BlueJayRacing/bjr_kicad/README.md

# bjr_kicad
jhu blue jay racing daq kicad pcb files

Note: 20xt is mainly for legacy
