BlueJayRacing/bjr_kicad/21xt/02-mainbox/bjr_kicad_aaren_copy/21xt/03-wireless_strain_gauge/wsg1.0/NewBOM.xlsx

Id | Designator | Footprint | Quantity | Designation | JLCPCB Part #
2 | R3,R7,R5,R4,R6 | R_0603_1608Metri | 5 | 47 | C23182
3 | C1 | C_0603_1608Metric | 1 | 47uF | C178330
4 | C2 | C_0603_1608Metric | 1 | 22uF | C59461
5 | C11,C7,C3,C13,C9 | C_0603_1608Metric | 5 | 0.1uF | C14663
6 | LinReg1,LinReg2,LinReg3 | SOT91P240X110-3N | 3 | AP2120N-5.0TRG1 | C460341
7 | U1 | SOP65P640X120-16N | 1 | ADS1120 | C84284
8 | C5,C6 | C_0603_1608Metric | 2 | 5uF | C1691
9 | 806k | R_0805_2012Metric | 1 | 806k | C407436
10 | DAC1 | AD5626 | 1 | AD5626BRMZ | C125832
11 | 80.6k | R_0603_1608Metric | 1 | 80.6k | C23249
12 | D8 | D_0603_1608Metric | 1 | Schottky | C153761
1 | C12,C10,C14,C8,C4 | C_0603_1608Metric | 5 | 100uF | C19702
7 | BConv1 | TPSM83100SIUR | 1 | TPSM83100SIUR | C20346010
