BlueJayRacing/bjr_kicad/21xt/06-magnetometer/Magnetometer3D/BSS138.step

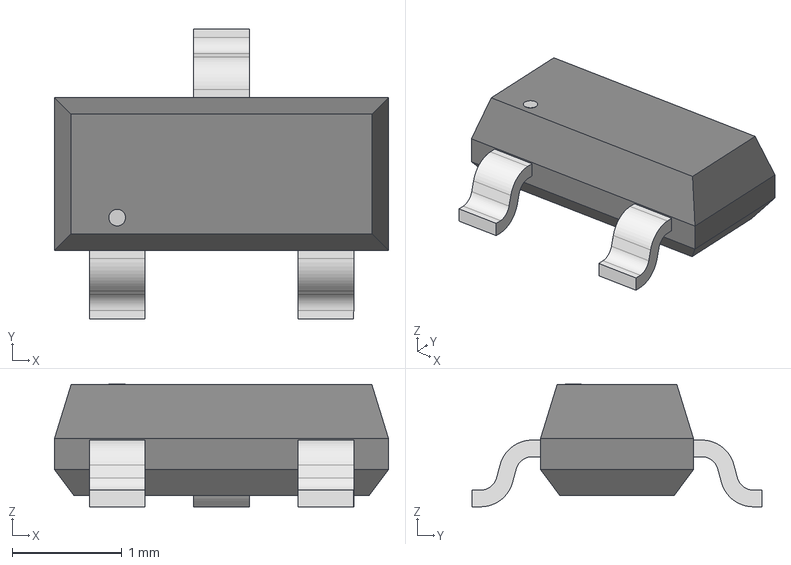
[picture p1: CAD file, 2025-03-05]
21xt/06-magnetometer/Magnetometer3D/BSS138.step
3.05 x 2.64 x 1.12 mm
