BlueJayRacing/bjr_kicad/21xt/00-3dmodels/INA180A1IDBVR.stp

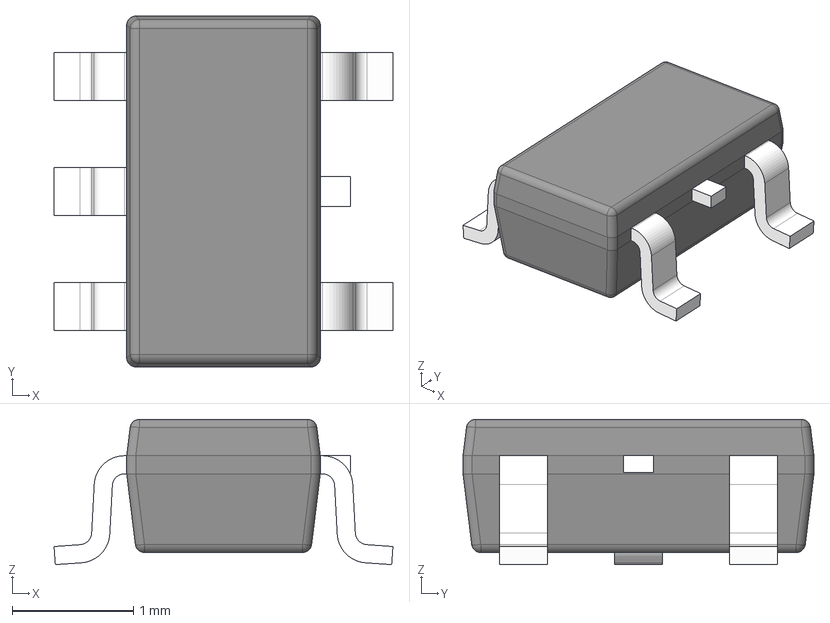
[picture p2: CAD file, 2025-03-05]
21xt/00-3dmodels/INA180A1IDBVR.stp
2.80 x 2.90 x 1.20 mm
BODY-SOT
LEAD-SOT x 5
LEAD-DUMMY
