BlueJayRacing/bjr_kicad/21xt/06-magnetometer/Magnetometer3D/LIS3MDLTR.stp

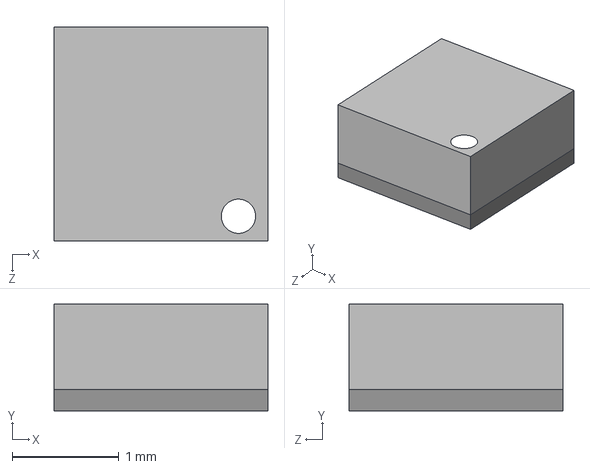
[picture p3: CAD file, 2025-03-05]
21xt/06-magnetometer/Magnetometer3D/LIS3MDLTR.stp
2.00 x 1.00 x 2.00 mm
