BlueJayRacing/bjr_kicad/21xt/00-3dmodels/LTC2959IDDB#TRMPBF.stp

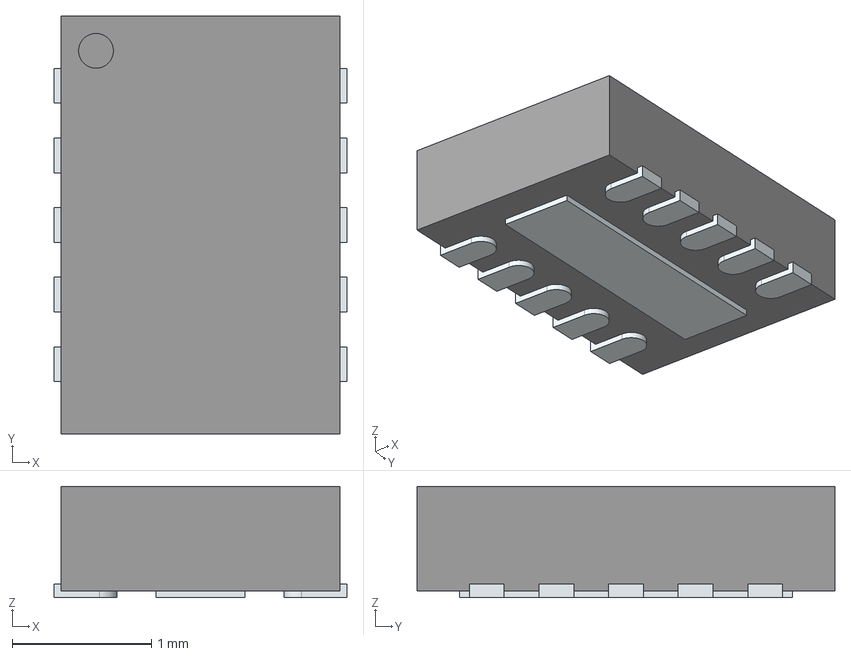
[picture p4: CAD file, 2025-03-05]
21xt/00-3dmodels/LTC2959IDDB#TRMPBF.stp
2.10 x 3.00 x 0.8 mm
ThermalPin
PinsArrayLR
