BlueJayRacing/bjr_kicad/21xt/06-magnetometer/Magnetometer3D/1KSMBSeries_LTF.step

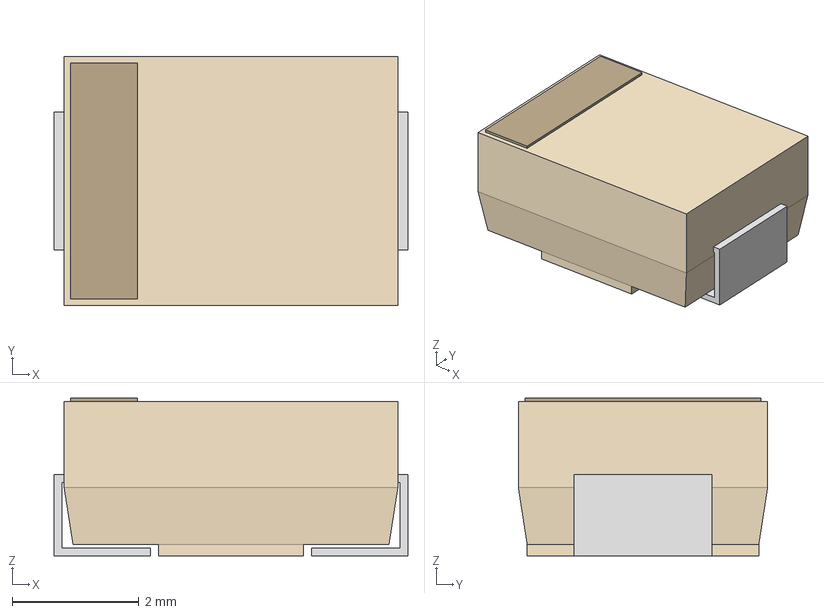
[picture p5: CAD file, 2025-03-05]
21xt/06-magnetometer/Magnetometer3D/1KSMBSeries_LTF.step
5.59 x 3.94 x 2.49 mm
