BlueJayRacing/bjr_kicad/21xt/00-3dmodels/SMBJ33CA.stp

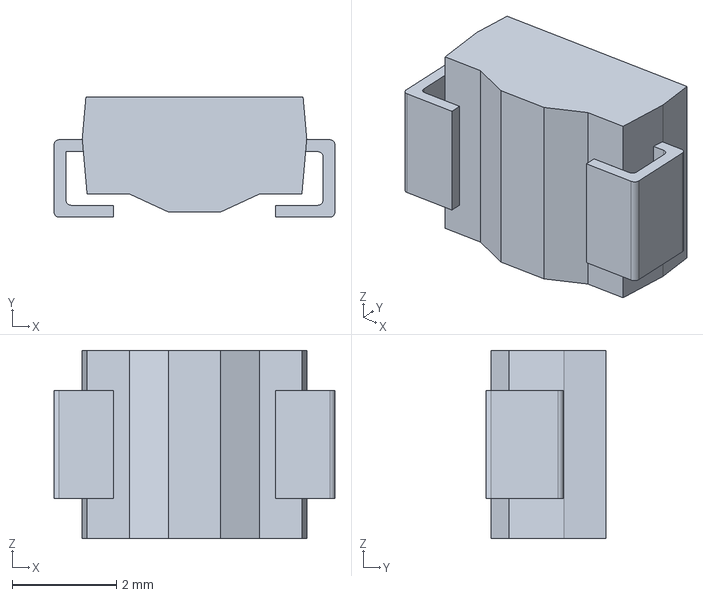
[picture p6: CAD file, 2025-03-05]
21xt/00-3dmodels/SMBJ33CA.stp
5.40 x 2.31 x 3.62 mm
