BlueJayRacing/bjr_kicad/21xt/06-magnetometer/Magnetometer3D/LM3940IMPX-3.3_NOPB.step

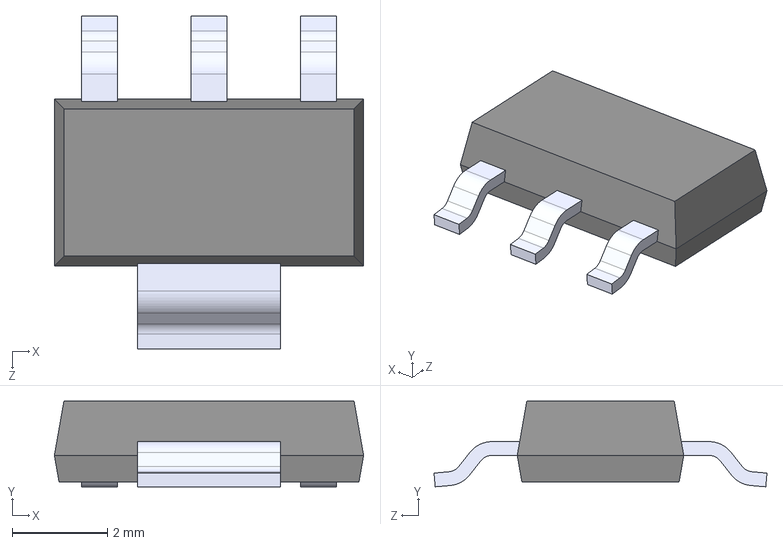
[picture p7: CAD file, 2025-03-05]
21xt/06-magnetometer/Magnetometer3D/LM3940IMPX-3.3_NOPB.step
6.50 x 1.80 x 7.00 mm
