BlueJayRacing/bjr_kicad/21xt/00-3dmodels/NRVB10100MFST1G.stp

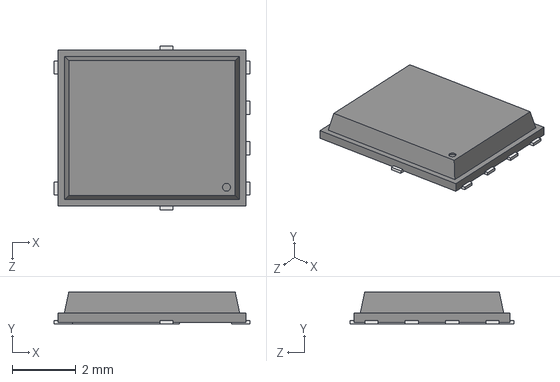
[picture p8: CAD file, 2025-03-05]
21xt/00-3dmodels/NRVB10100MFST1G.stp
6.15 x 1 x 5.15 mm
