BlueJayRacing/bjr_kicad/21xt/00-3dmodels/NVMFWS2D1N08XT1G.stp

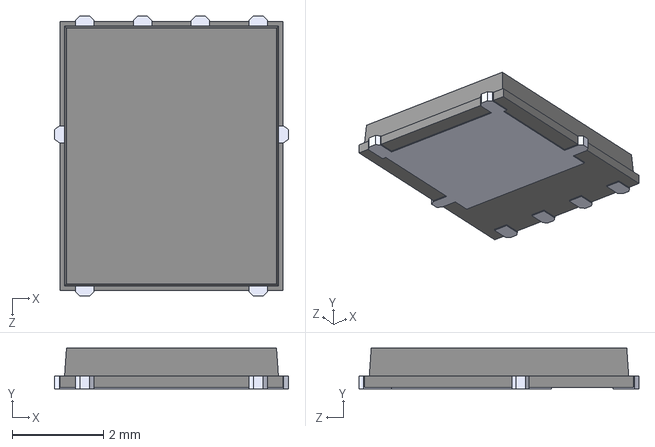
[picture p9: CAD file, 2025-03-05]
21xt/00-3dmodels/NVMFWS2D1N08XT1G.stp
5.15 x 0.9 x 6.15 mm
