BlueJayRacing/bjr_kicad/21xt/00-3dmodels/2103M-003-CKN10790CT-ND_Push_Button.STEP

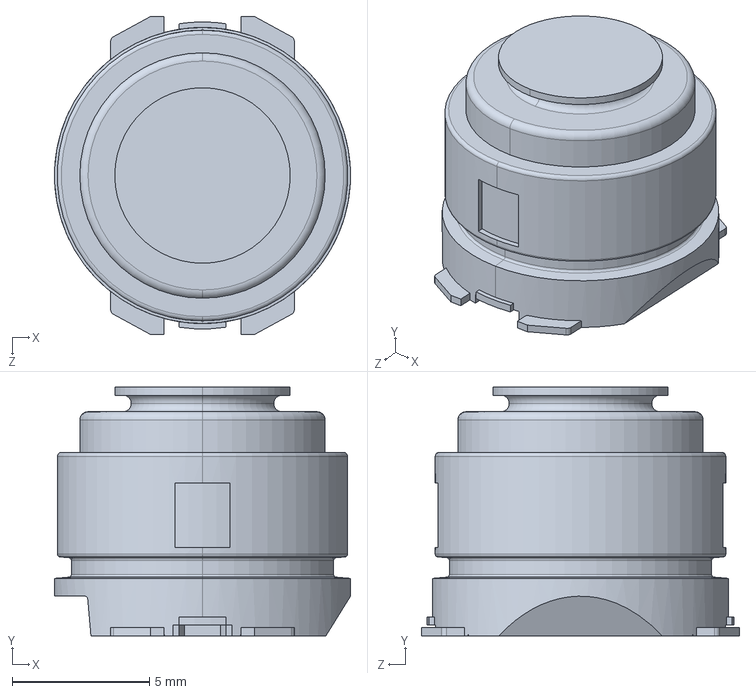
[picture p10: CAD file, 2025-03-05]
21xt/00-3dmodels/2103M-003-CKN10790CT-ND_Push_Button.STEP
10.8 x 9.08 x 11.6 mm
