BlueJayRacing/bjr_kicad/21xt/00-3dmodels/m8 pp bulkhead 09_4912_081_04.stp

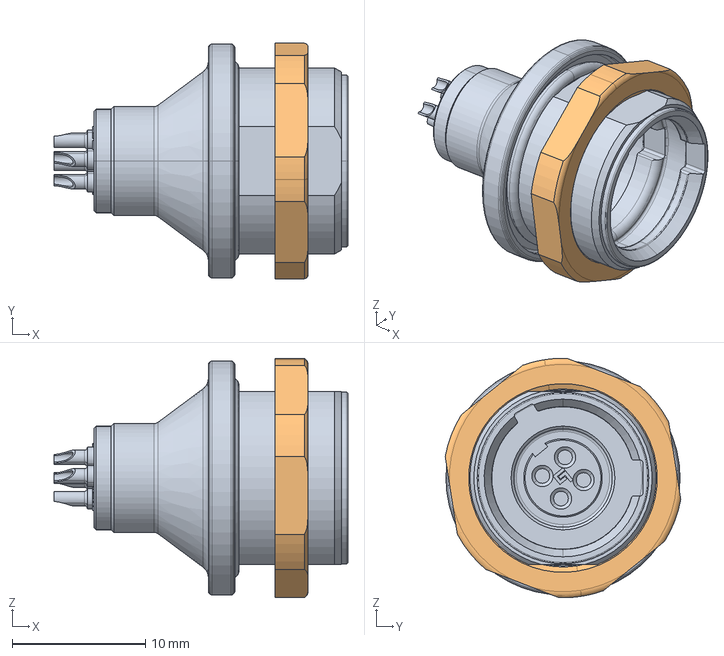
[picture p11: CAD file, 2025-03-05]
21xt/00-3dmodels/m8 pp bulkhead 09_4912_081_04.stp
22.1 x 17.7 x 18.0 mm
