BlueJayRacing/bjr_kicad/21xt/00-3dmodels/m8 pp wire 99-4909-00-04-001_01.stp

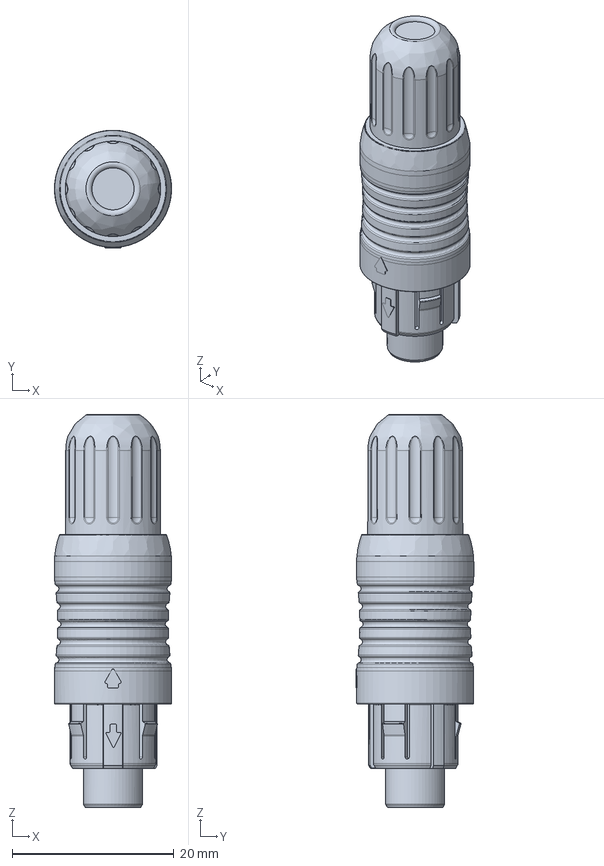
[picture p12: CAD file, 2025-03-05]
21xt/00-3dmodels/m8 pp wire 99-4909-00-04-001_01.stp
14.5 x 14.5 x 48.6 mm
