BlueJayRacing/bjr_kicad/21xt/00-3dmodels/led_strip.STEP

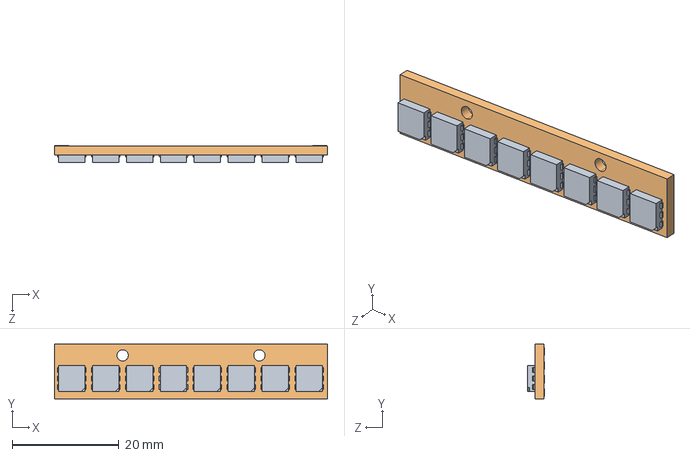
[picture p13: CAD file, 2025-03-05]
21xt/00-3dmodels/led_strip.STEP
51.1 x 10.2 x 3.27 mm
