BlueJayRacing/bjr_kicad/21xt/00-3dmodels/AD5689RBCPZ-RL7.stp

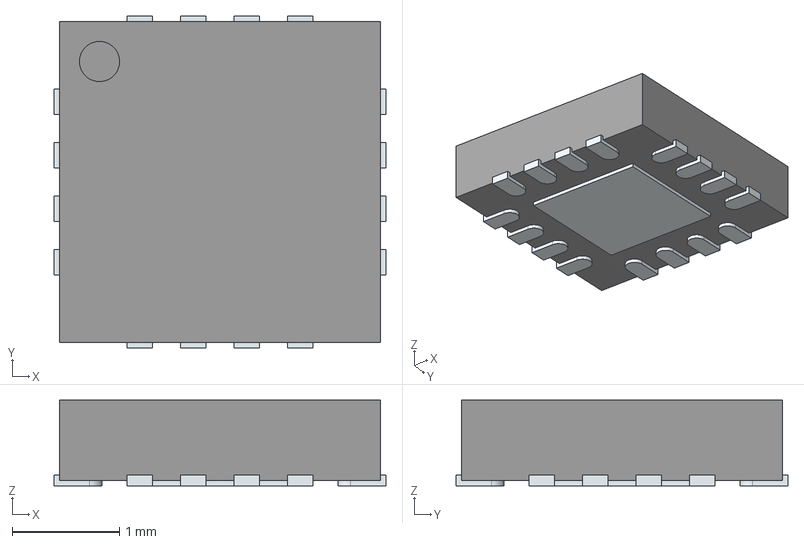
[picture p14: CAD file, 2025-03-05]
21xt/00-3dmodels/AD5689RBCPZ-RL7.stp
3.10 x 3.10 x 0.8 mm
ThermalPin
PinsArrayLR
PinsArrayTB
