BlueJayRacing/bjr_kicad/21xt/00-3dmodels/AP2120N-5.0TRG1.stp

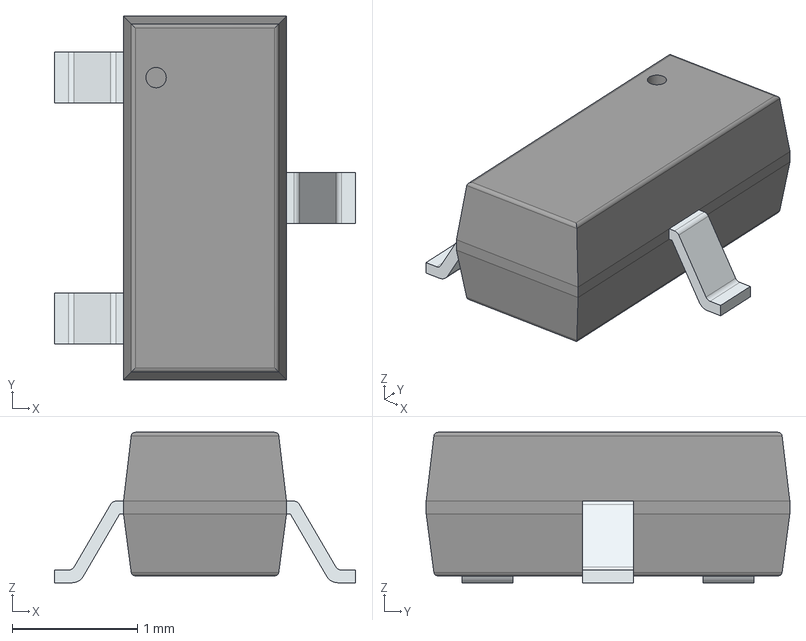
[picture p15: CAD file, 2025-01-16]
21xt/00-3dmodels/AP2120N-5.0TRG1.stp
2.40 x 2.90 x 1.20 mm
PinsArrayL
FilletPinR
