BlueJayRacing/bjr_kicad/21xt/00-3dmodels/AD8237ARMZ.stp

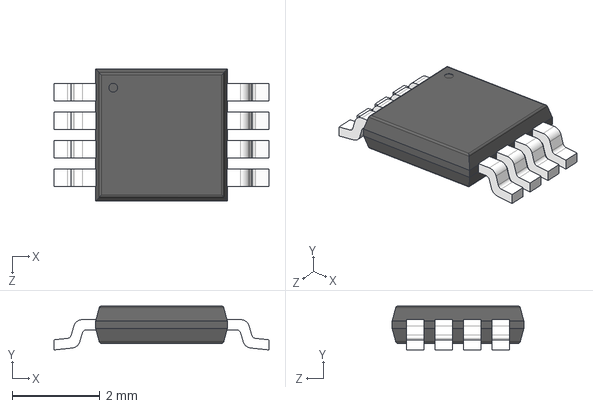
[picture p16: CAD file, 2025-01-16]
21xt/00-3dmodels/AD8237ARMZ.stp
4.90 x 1.00 x 3.00 mm
