BlueJayRacing/bjr_kicad/21xt/00-3dmodels/0906-0-15-20-76-14-11-0.step

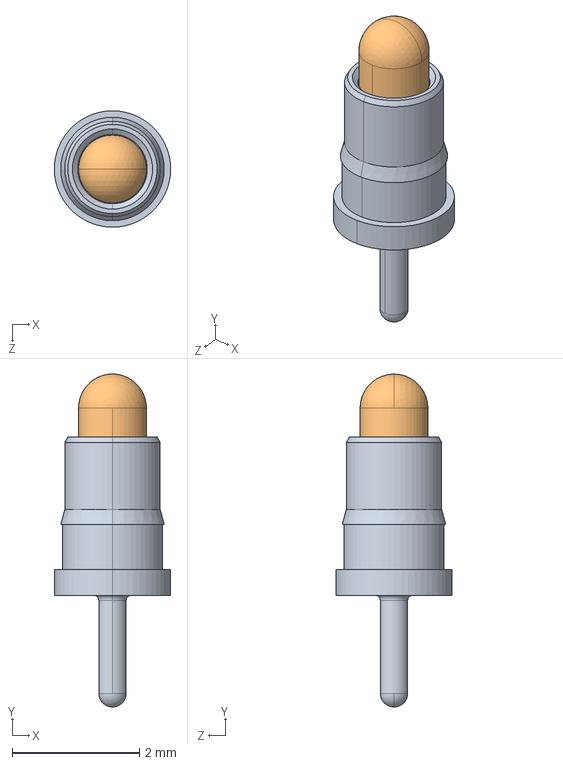
[picture p17: CAD file, 2025-01-16]
21xt/00-3dmodels/0906-0-15-20-76-14-11-0.step
1.83 x 5.23 x 1.83 mm
