BlueJayRacing/bjr_kicad/21xt/00-3dmodels/SOT23-3.stp

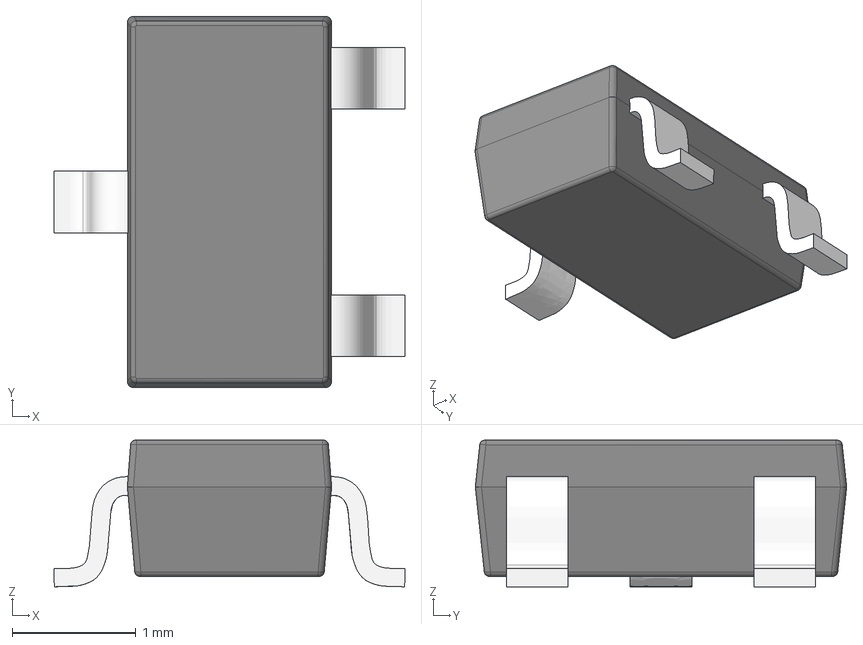
[picture p18: CAD file, 2025-01-15]
21xt/00-3dmodels/SOT23-3.stp
2.84 x 3.00 x 1.18 mm
