BlueJayRacing/bjr_kicad/21xt/00-3dmodels/MDT275M02001.stp

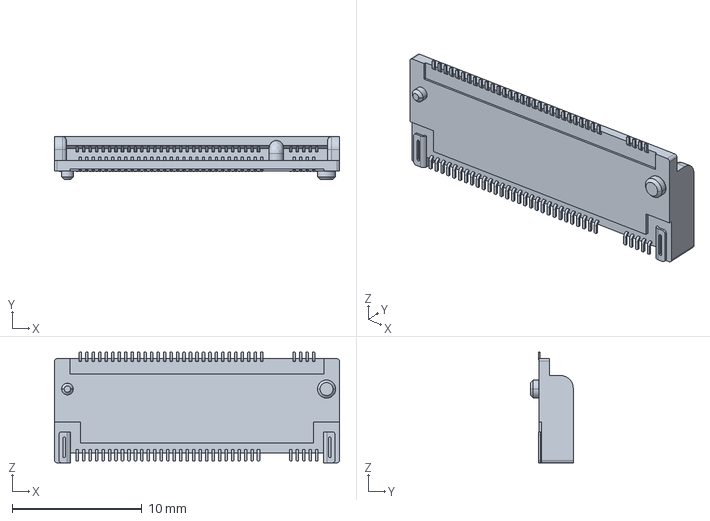
[picture p19: CAD file, 2025-01-15]
21xt/00-3dmodels/MDT275M02001.stp
22.0 x 3.30 x 8.55 mm
