BlueJayRacing/bjr_kicad/21xt/00-3dmodels/AD7175-2BRUZ.stp

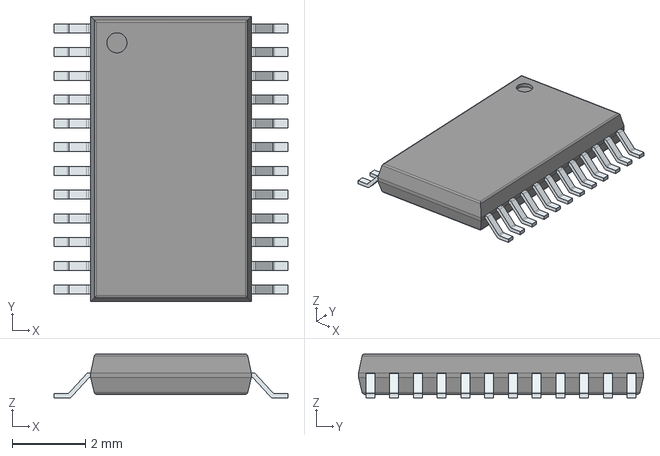
[picture p20: CAD file, 2025-01-15]
21xt/00-3dmodels/AD7175-2BRUZ.stp
6.40 x 7.80 x 1.20 mm
PinsArrayLR
