BlueJayRacing/bjr_kicad/21xt/00-3dmodels/XB9X-DMUS-011.stp

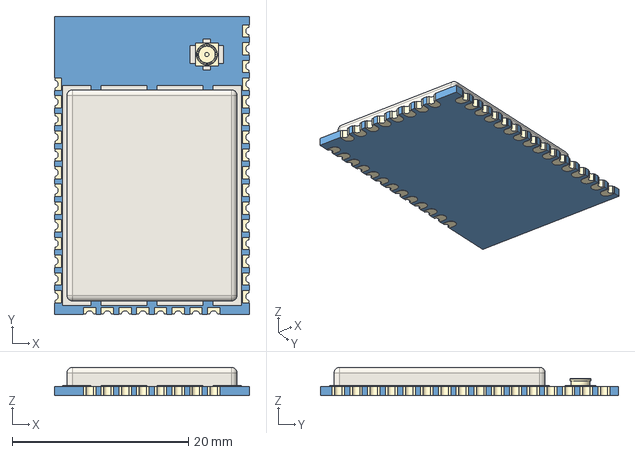
[picture p21: CAD file, 2025-01-15]
21xt/00-3dmodels/XB9X-DMUS-011.stp
22.1 x 33.8 x 3.21 mm
