BlueJayRacing/bjr_kicad/21xt/00-3dmodels/ZF5S-16-01-T-WT.step

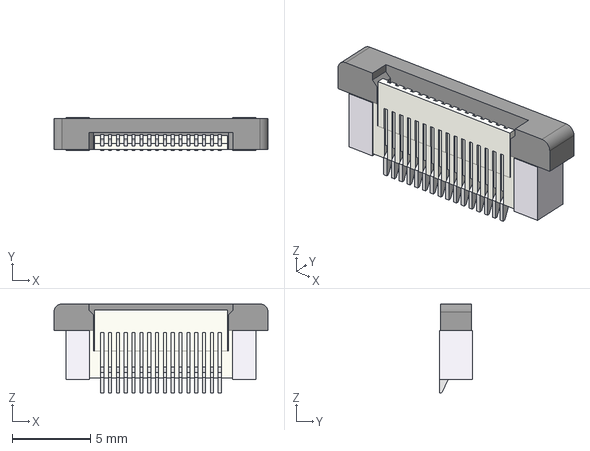
[picture p22: CAD file, 2025-01-15]
21xt/00-3dmodels/ZF5S-16-01-T-WT.step
13.7 x 2.10 x 5.67 mm
ZF5S-16-01-WT_socket
C-297-16-01_pins
