BlueJayRacing/bjr_kicad/21xt/00-3dmodels/B2PS-VH.stp

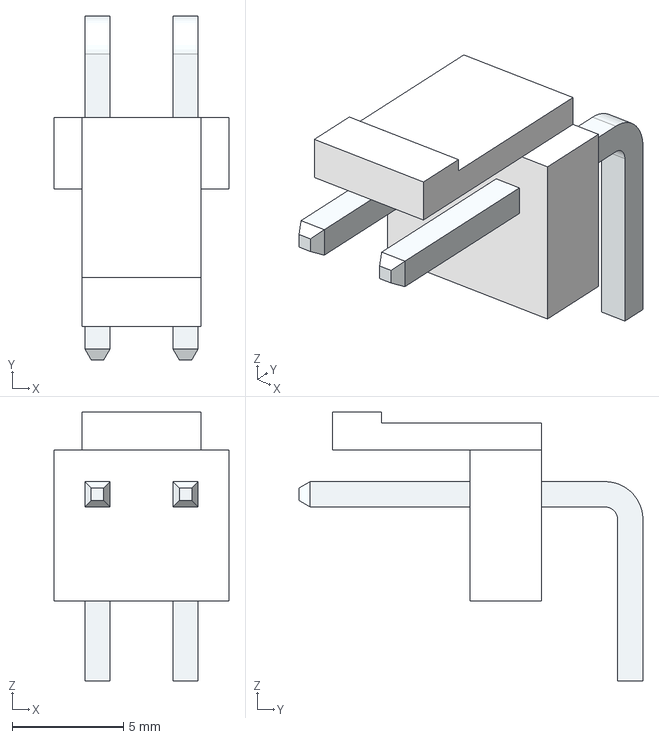
[picture p23: CAD file, 2025-01-15]
21xt/00-3dmodels/B2PS-VH.stp
7.86 x 15.5 x 12.1 mm
