BlueJayRacing/bjr_kicad/21xt/00-3dmodels/R2D-0509.stp

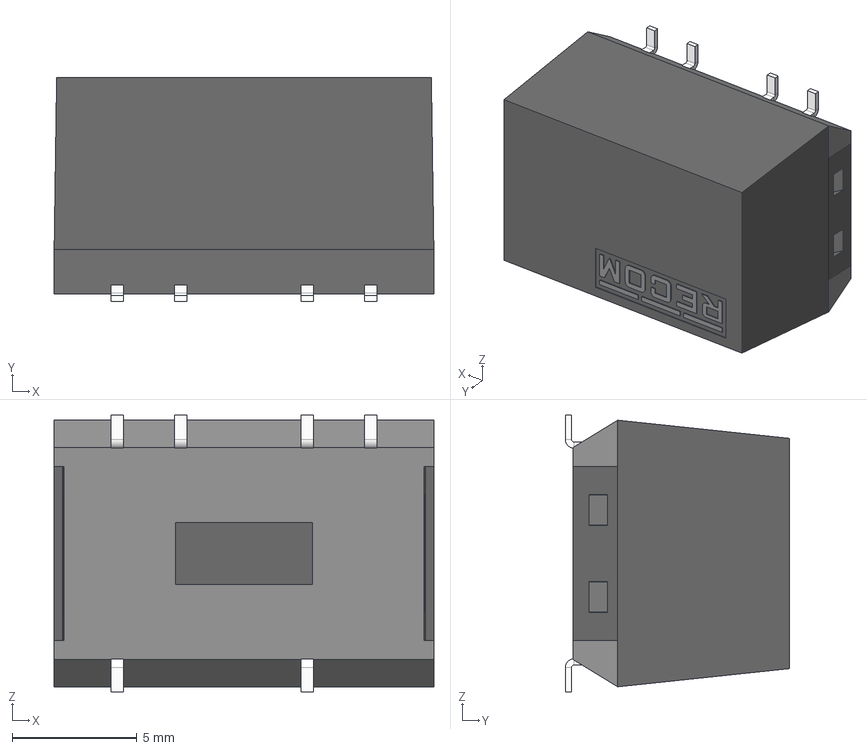
[picture p24: CAD file, 2025-01-15]
21xt/00-3dmodels/R2D-0509.stp
15.2 x 9.00 x 11.1 mm
