BlueJayRacing/bjr_kicad/21xt/00-3dmodels/W25N04KVZEIR.stp

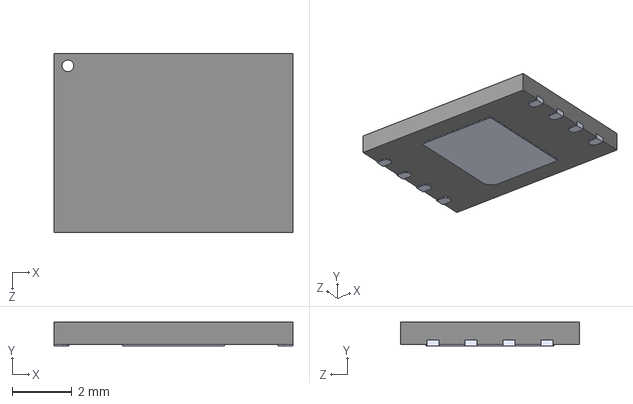
[picture p25: CAD file, 2025-01-07]
21xt/00-3dmodels/W25N04KVZEIR.stp
8.00 x 0.8 x 6.00 mm
