BlueJayRacing/bjr_kicad/21xt/00-3dmodels/TAJD106M035RNJ.stp

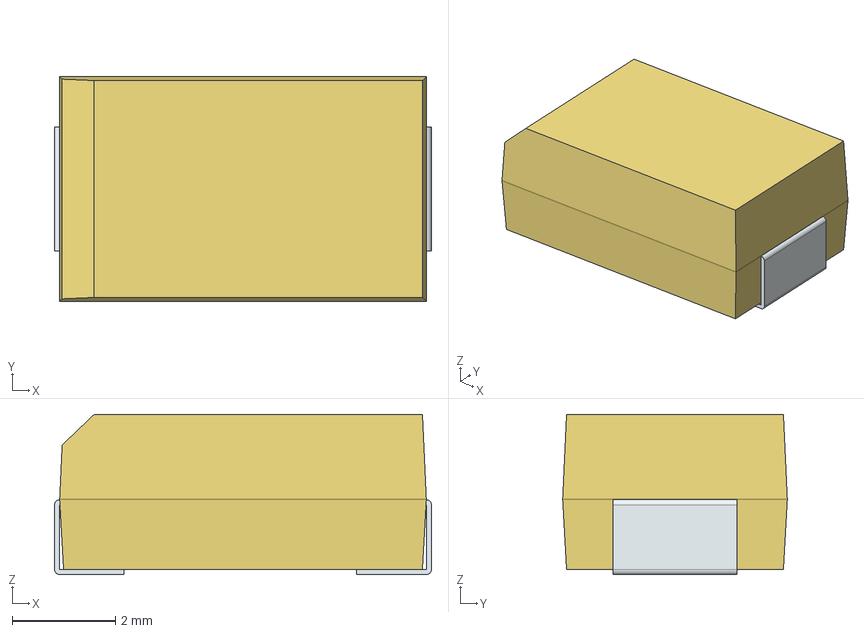
[picture p26: CAD file, 2025-01-07]
21xt/00-3dmodels/TAJD106M035RNJ.stp
7.30 x 4.35 x 3.10 mm
FilletPin1
FilletPin2
