BlueJayRacing/bjr_kicad/21xt/00-3dmodels/INA821IDRGR.stp

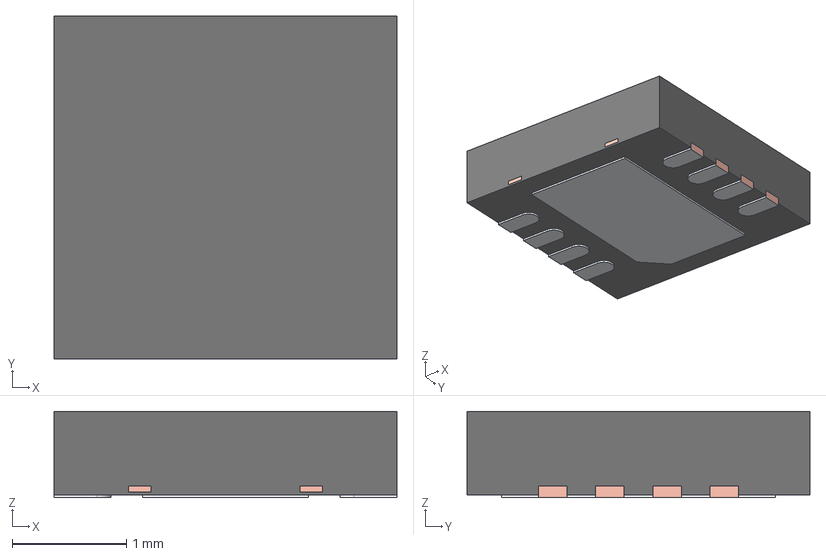
[picture p27: CAD file, 2025-01-07]
21xt/00-3dmodels/INA821IDRGR.stp
3.00 x 3.00 x 0.755 mm
BODY-SON
FRAME-DRG0008B
