BlueJayRacing/bjr_kicad/21xt/00-3dmodels/SJ-3541AS-SMT-TR-67.stp

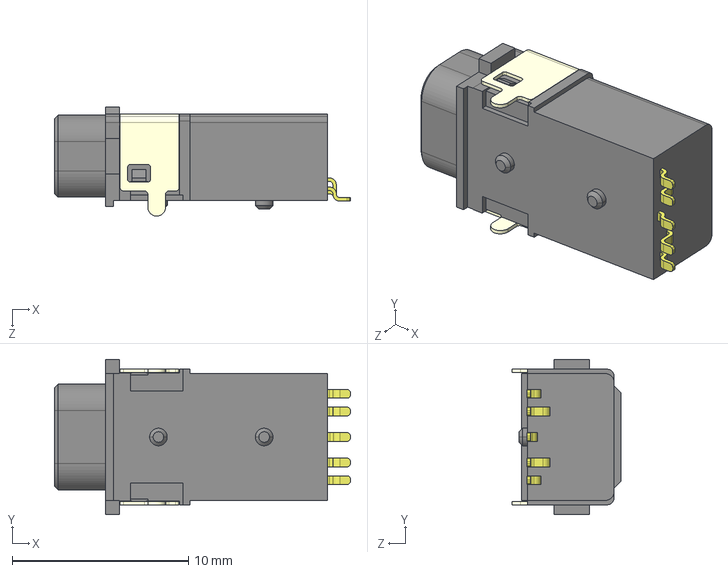
[picture p28: CAD file, 2025-01-07]
21xt/00-3dmodels/SJ-3541AS-SMT-TR-67.stp
16.8 x 8.80 x 6.20 mm
