BlueJayRacing/bjr_kicad/21xt/00-3dmodels/ADS1120IRVAR.stp

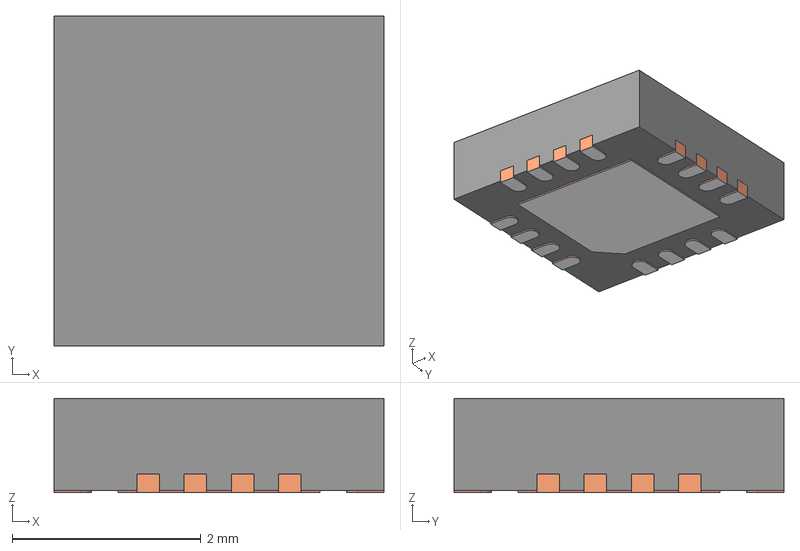
[picture p29: CAD file, 2025-01-07]
21xt/00-3dmodels/ADS1120IRVAR.stp
3.50 x 3.50 x 1.00 mm
BODY-QFN
FRAME-RVA0016A
PIN1-ID
