BlueJayRacing/bjr_kicad/21xt/00-3dmodels/DTF13-4P-G003.stp

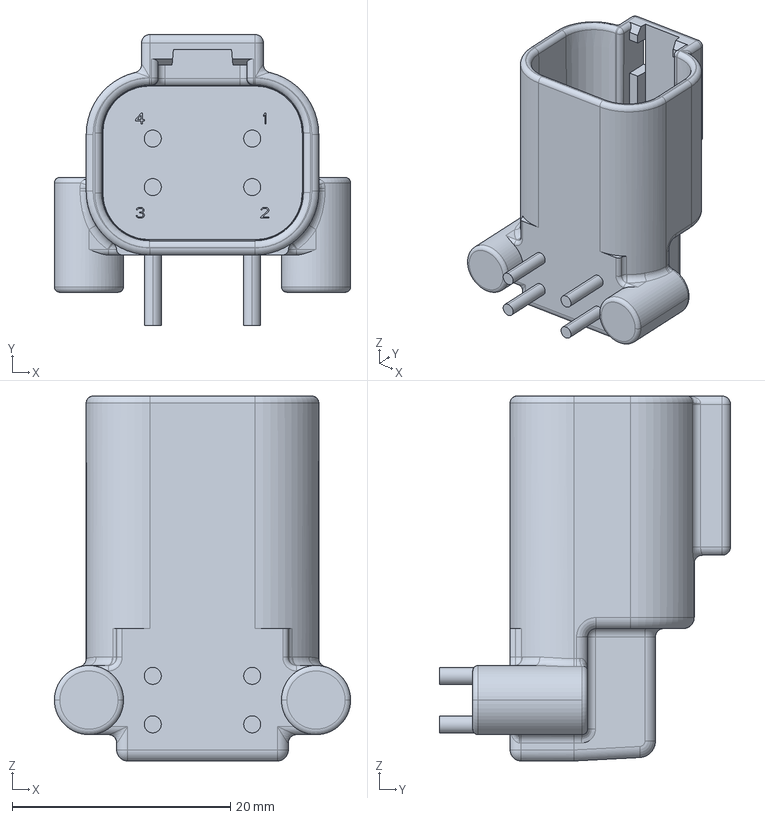
[picture p30: CAD file, 2025-01-07]
21xt/00-3dmodels/DTF13-4P-G003.stp
27.2 x 26.7 x 33.5 mm
