BlueJayRacing/bjr_kicad/21xt/00-3dmodels/MSOP8.STEP

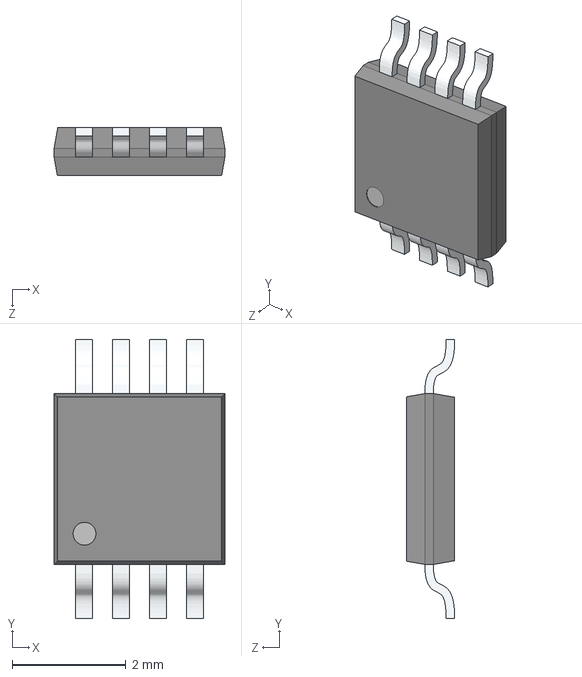
[picture p31: CAD file, 2025-01-07]
21xt/00-3dmodels/MSOP8.STEP
3.00 x 4.90 x 0.85 mm
