BlueJayRacing/bjr_kicad/21xt/00-3dmodels/MCP1502T-50E_CHY.stp

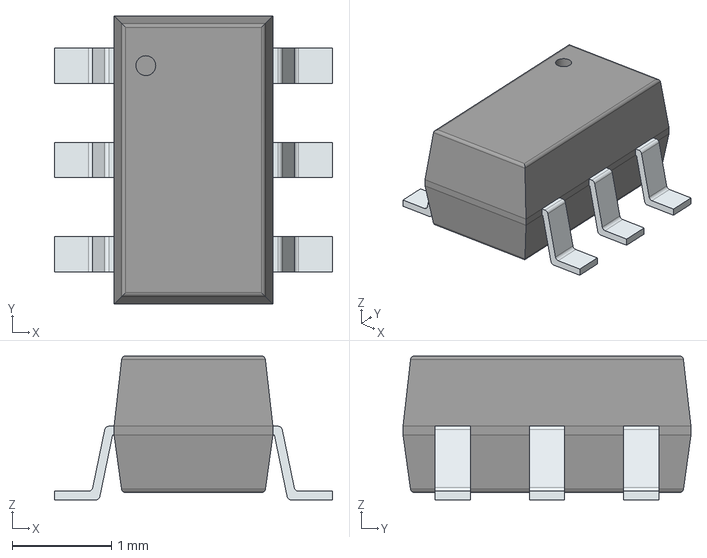
[picture p32: CAD file, 2025-01-07]
21xt/00-3dmodels/MCP1502T-50E_CHY.stp
2.80 x 2.90 x 1.45 mm
PinsArrayLR
