BlueJayRacing/bjr_kicad/21xt/00-3dmodels/R-78B3.3-1.5.stp

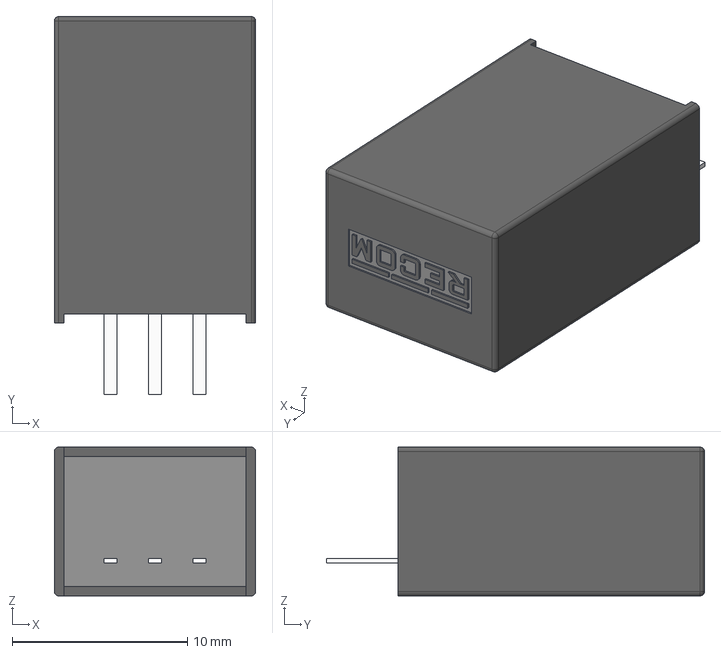
[picture p33: CAD file, 2025-01-07]
21xt/00-3dmodels/R-78B3.3-1.5.stp
11.5 x 21.6 x 8.50 mm
