BlueJayRacing/bjr_kicad/21xt/00-3dmodels/TPSM83100SIUR.stp

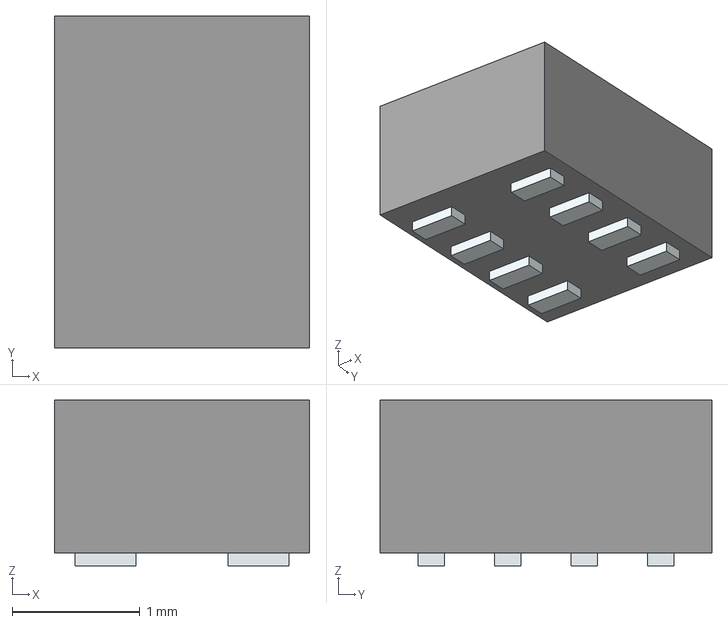
[picture p34: CAD file, 2025-01-07]
21xt/00-3dmodels/TPSM83100SIUR.stp
2.00 x 2.60 x 1.30 mm
Pins
