BlueJayRacing/bjr_kicad/21xt/00-3dmodels/mezzanine.stp

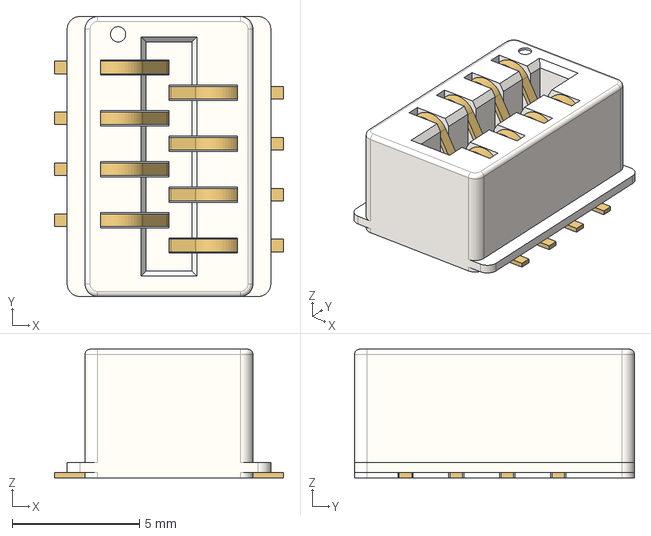
[picture p35: CAD file, 2025-01-04]
21xt/00-3dmodels/mezzanine.stp
9.00 x 11.0 x 5.05 mm
housing
pins
