BlueJayRacing/bjr_kicad/21xt/00-3dmodels/INA827AIDGK.stp

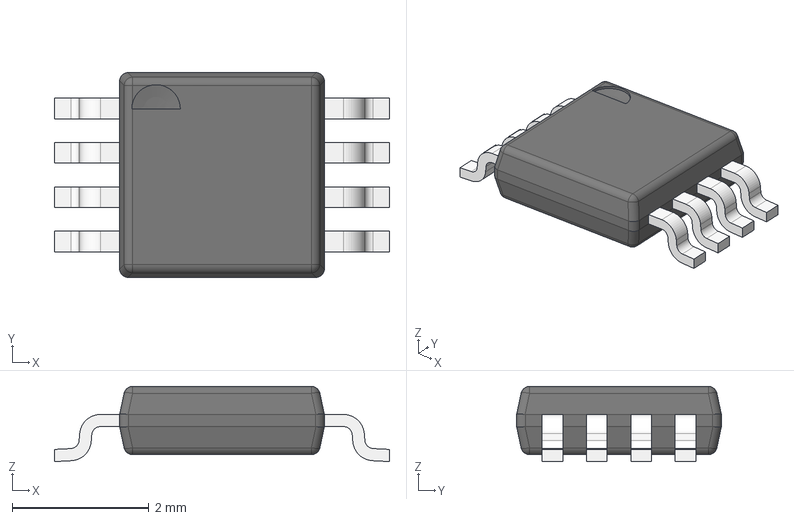
[picture p36: CAD file, 2025-01-04]
21xt/00-3dmodels/INA827AIDGK.stp
4.90 x 3.00 x 1.10 mm
BODY_MUA08A
LEAD_MUA08A x 8
