BlueJayRacing/bjr_kicad/21xt/00-3dmodels/TXB0108PWR.stp

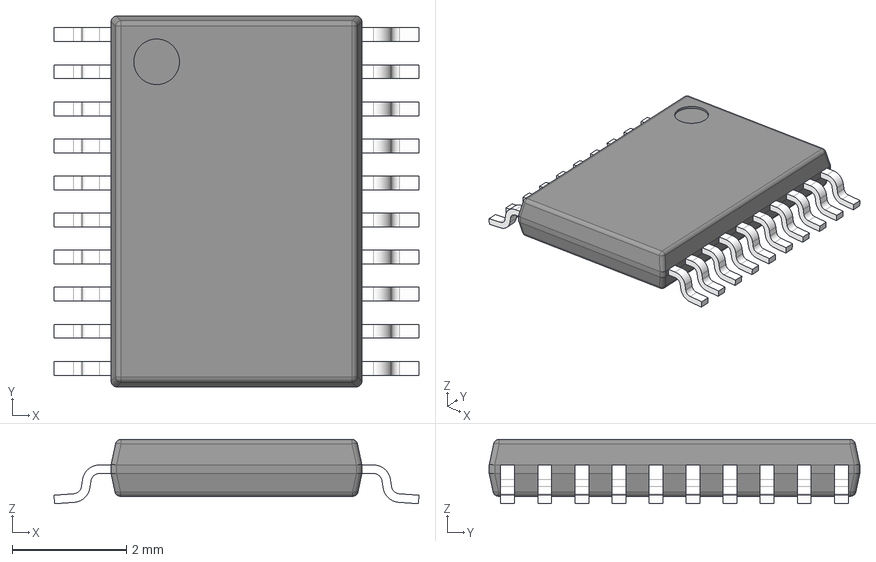
[picture p37: CAD file, 2025-01-04]
21xt/00-3dmodels/TXB0108PWR.stp
6.40 x 6.50 x 1.13 mm
BODY-TSSOP
LEAD-TSSOP x 20
PIN1
