BlueJayRacing/bjr_kicad/21xt/00-3dmodels/AD7175-8BCPZ-RL7.stp

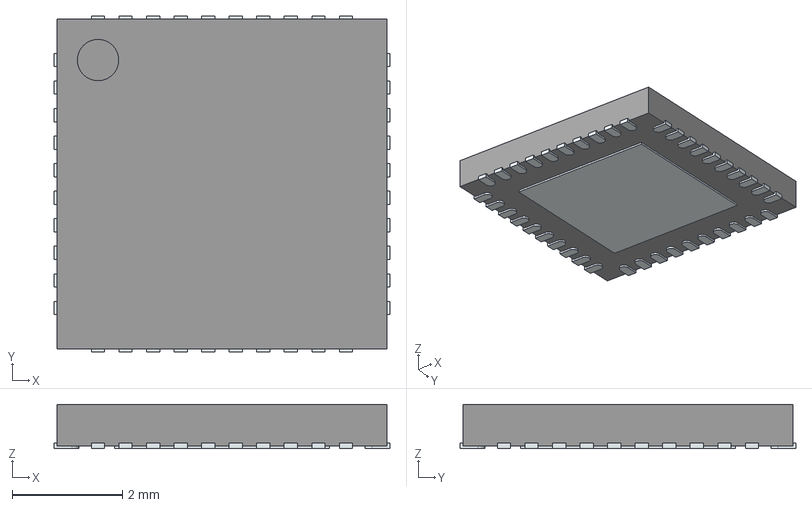
[picture p38: CAD file, 2025-01-04]
21xt/00-3dmodels/AD7175-8BCPZ-RL7.stp
6.10 x 6.10 x 0.8 mm
ThermalPin
PinsArrayLR
PinsArrayTB
