BlueJayRacing/bjr_kicad/21xt/00-3dmodels/781-M44-113R141.STEP

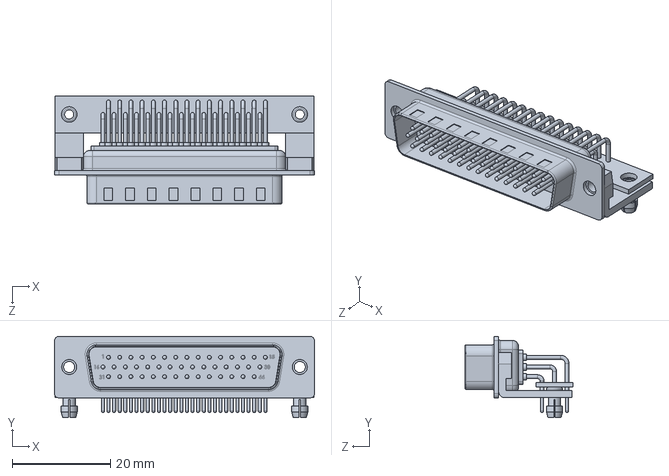
[picture p39: CAD file, 2025-01-04]
21xt/00-3dmodels/781-M44-113R141.STEP
53.0 x 16.6 x 22.1 mm
