BlueJayRacing/bjr_kicad/21xt/00-3dmodels/DB37 Male Right Angle Connector.step

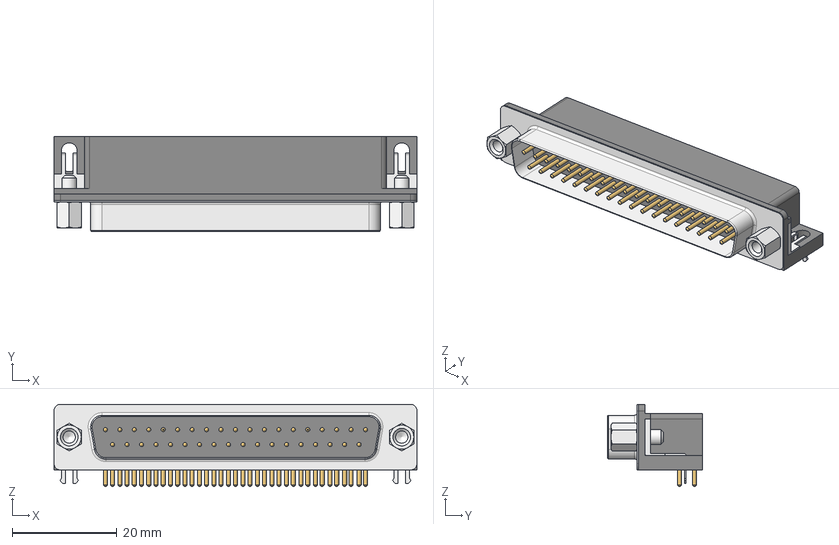
[picture p40: CAD file, 2025-01-04]
21xt/00-3dmodels/DB37 Male Right Angle Connector.step
69.3 x 18.2 x 15.8 mm
Body002 (Mirror #1)
Body003 (Mirror #2)
