BlueJayRacing/bjr_kicad/21xt/00-3dmodels/REF3450IDBVR.stp

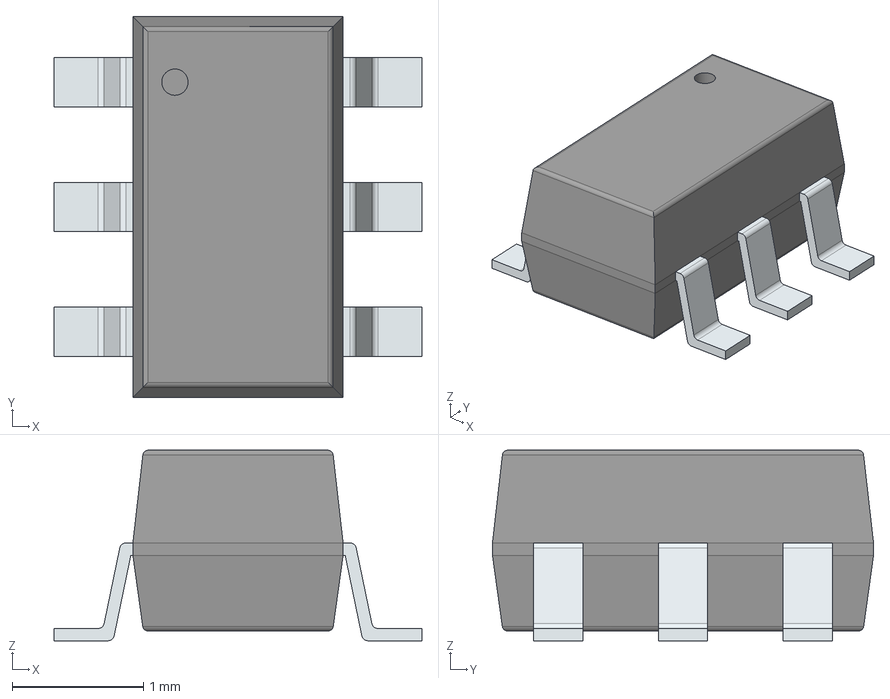
[picture p41: CAD file, 2025-01-04]
21xt/00-3dmodels/REF3450IDBVR.stp
2.80 x 2.90 x 1.45 mm
PinsArrayLR
