BlueJayRacing/bjr_kicad/21xt/00-3dmodels/2894.stp

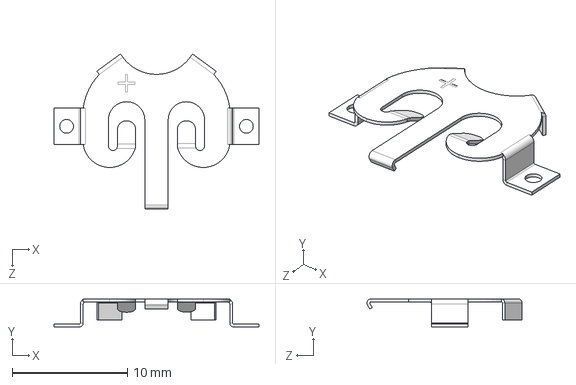
[picture p42: CAD file, 2025-01-04]
21xt/00-3dmodels/2894.stp
17.8 x 2.42 x 13.5 mm
