BlueJayRacing/bjr_kicad/21xt/00-3dmodels/LSM115JE3_TR13.stp

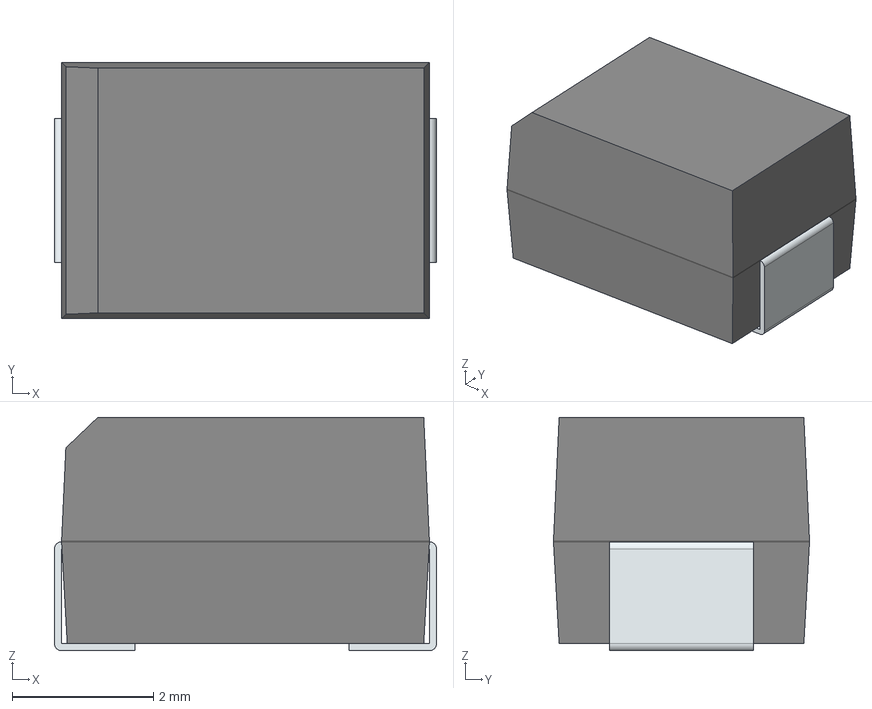
[picture p43: CAD file, 2025-01-04]
21xt/00-3dmodels/LSM115JE3_TR13.stp
5.40 x 3.62 x 3.30 mm
FilletPin1
FilletPin2
