BlueJayRacing/bjr_kicad/21xt/00-3dmodels/LT6658AHMSE-2.5_PBF.step

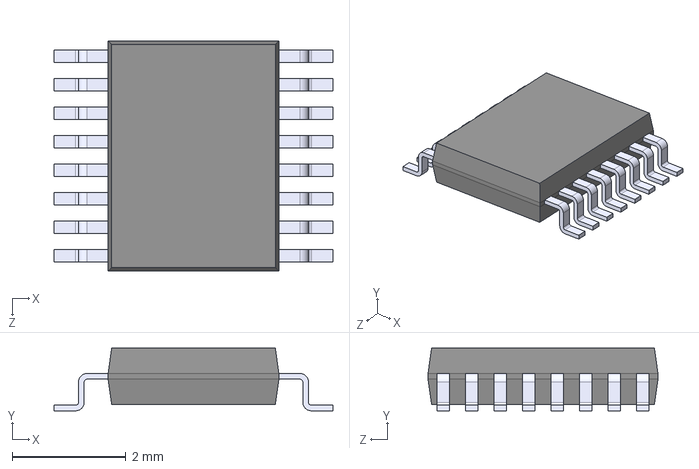
[picture p44: CAD file, 2025-01-04]
21xt/00-3dmodels/LT6658AHMSE-2.5_PBF.step
4.90 x 1.10 x 4.04 mm
