BlueJayRacing/bjr_kicad/21xt/00-3dmodels/INA821IDGKT.stp

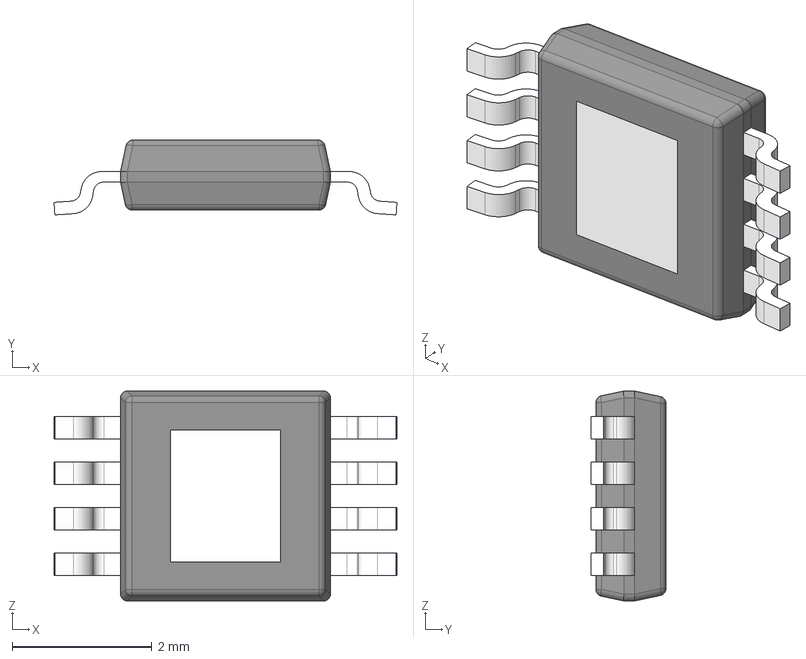
[picture p45: CAD file, 2025-01-04]
21xt/00-3dmodels/INA821IDGKT.stp
4.90 x 1.07 x 3.00 mm
BODY-HVSSOP
LEAD-HVSSOP x 8
PIN1_HVSSOP
DAP_HVSSOP
