BlueJayRacing/bjr_kicad/21xt/00-3dmodels/LM358DT.stp

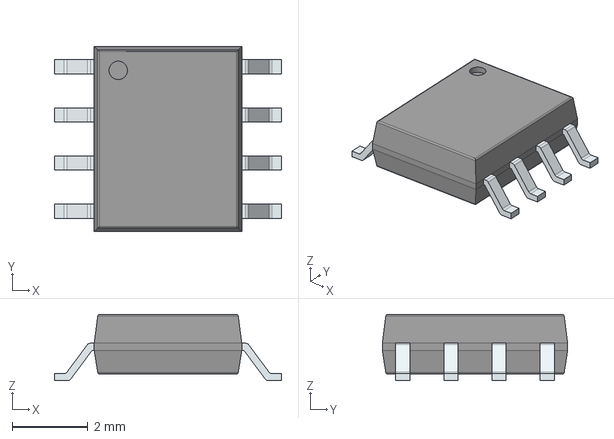
[picture p46: CAD file, 2025-01-04]
21xt/00-3dmodels/LM358DT.stp
6.00 x 4.90 x 1.75 mm
PinsArrayLR
