BlueJayRacing/bjr_kicad/21xt/00-3dmodels/LM324DR.stp

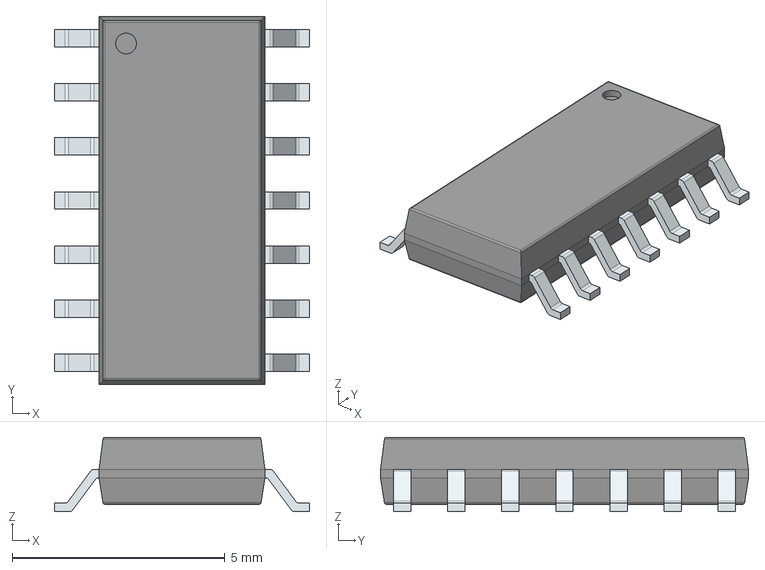
[picture p47: CAD file, 2025-01-04]
21xt/00-3dmodels/LM324DR.stp
6.00 x 8.65 x 1.75 mm
PinsArrayLR
