BlueJayRacing/bjr_kicad/21xt/00-3dmodels/TPS2113ADRBR.stp

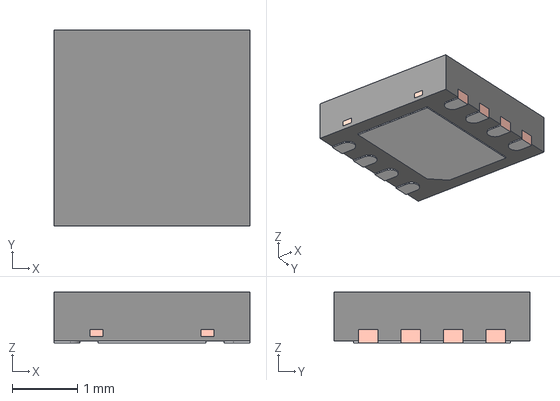
[picture p48: CAD file, 2025-01-04]
21xt/00-3dmodels/TPS2113ADRBR.stp
3.00 x 3.00 x 0.775 mm
BODY-SON
FRAME-DRB0008B
