BlueJayRacing/bjr_kicad/21xt/00-3dmodels/REF5050IDR.stp

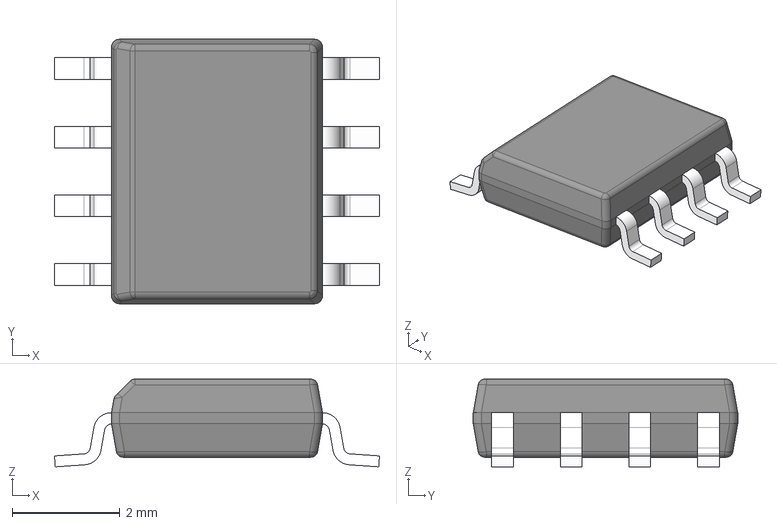
[picture p49: CAD file, 2025-01-04]
21xt/00-3dmodels/REF5050IDR.stp
6.02 x 4.90 x 1.63 mm
BODY-SO
LEAD-D0008A x 8
