BlueJayRacing/bjr_kicad/21xt/00-3dmodels/TRS_2-1211.stp

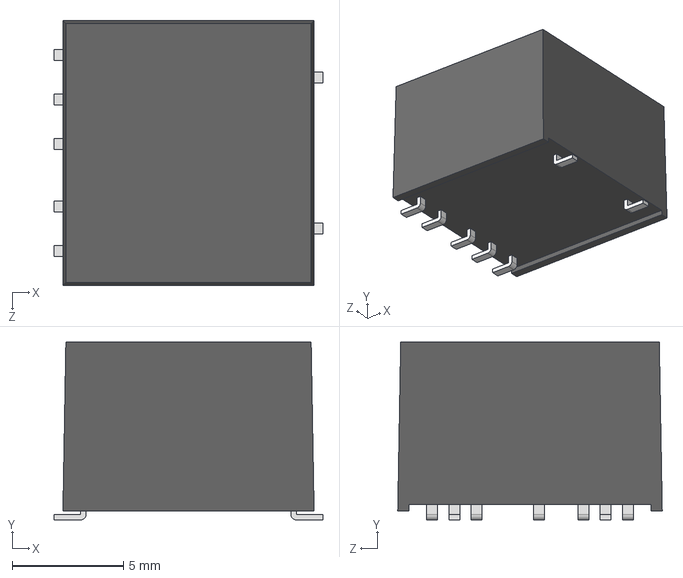
[picture p50: CAD file, 2025-01-04]
21xt/00-3dmodels/TRS_2-1211.stp
12.1 x 8.00 x 11.9 mm
