BlueJayRacing/bjr_kicad/21xt/00-3dmodels/AD5689RARUZ-RL7.stp

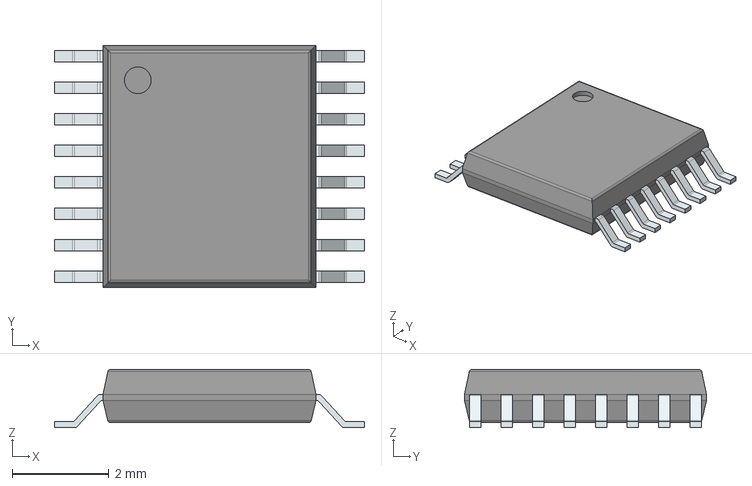
[picture p51: CAD file, 2025-01-04]
21xt/00-3dmodels/AD5689RARUZ-RL7.stp
6.40 x 5.00 x 1.20 mm
PinsArrayLR
