BlueJayRacing/bjr_kicad/21xt/00-3dmodels/mezzanine 10.stp

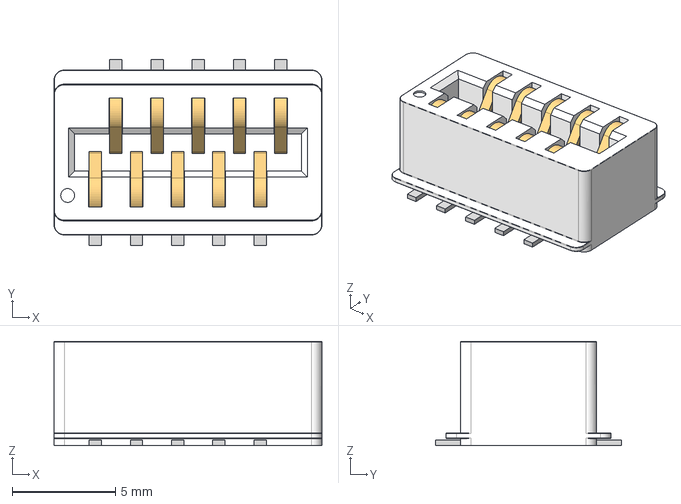
[picture p52: CAD file, 2025-01-04]
21xt/00-3dmodels/mezzanine 10.stp
13.0 x 9.00 x 5.05 mm
