BlueJayRacing/bjr_kicad/(list of files, cad)

Other CAD files:
21xt/00-3dmodels/REF3425IDBVR.stp
21xt/00-3dmodels/2171800001.stp
21xt/00-3dmodels/749013011.stp
21xt/00-3dmodels/90816-0004.stp
21xt/00-3dmodels/90816-0010.stp
21xt/00-3dmodels/90816-0012.stp
21xt/00-3dmodels/LM74700QDBVRQ1.stp
21xt/00-3dmodels/T4041017041-000.stp
21xt/00-3dmodels/TLV76150DCYR.stp
21xt/00-3dmodels/TPS22915BYFPR.step
21xt/00-3dmodels/ZF5S-16-01-T-WT.stp
