BlueJayRacing/bjr_kicad/21xt/03-wireless_strain_gauge/wsg3.0/wsg3.0.kicad_pcb

## KiCad design 21xt/03-wireless_strain_gauge/wsg3.0/wsg3.0.kicad_pcb (2025-03-05)

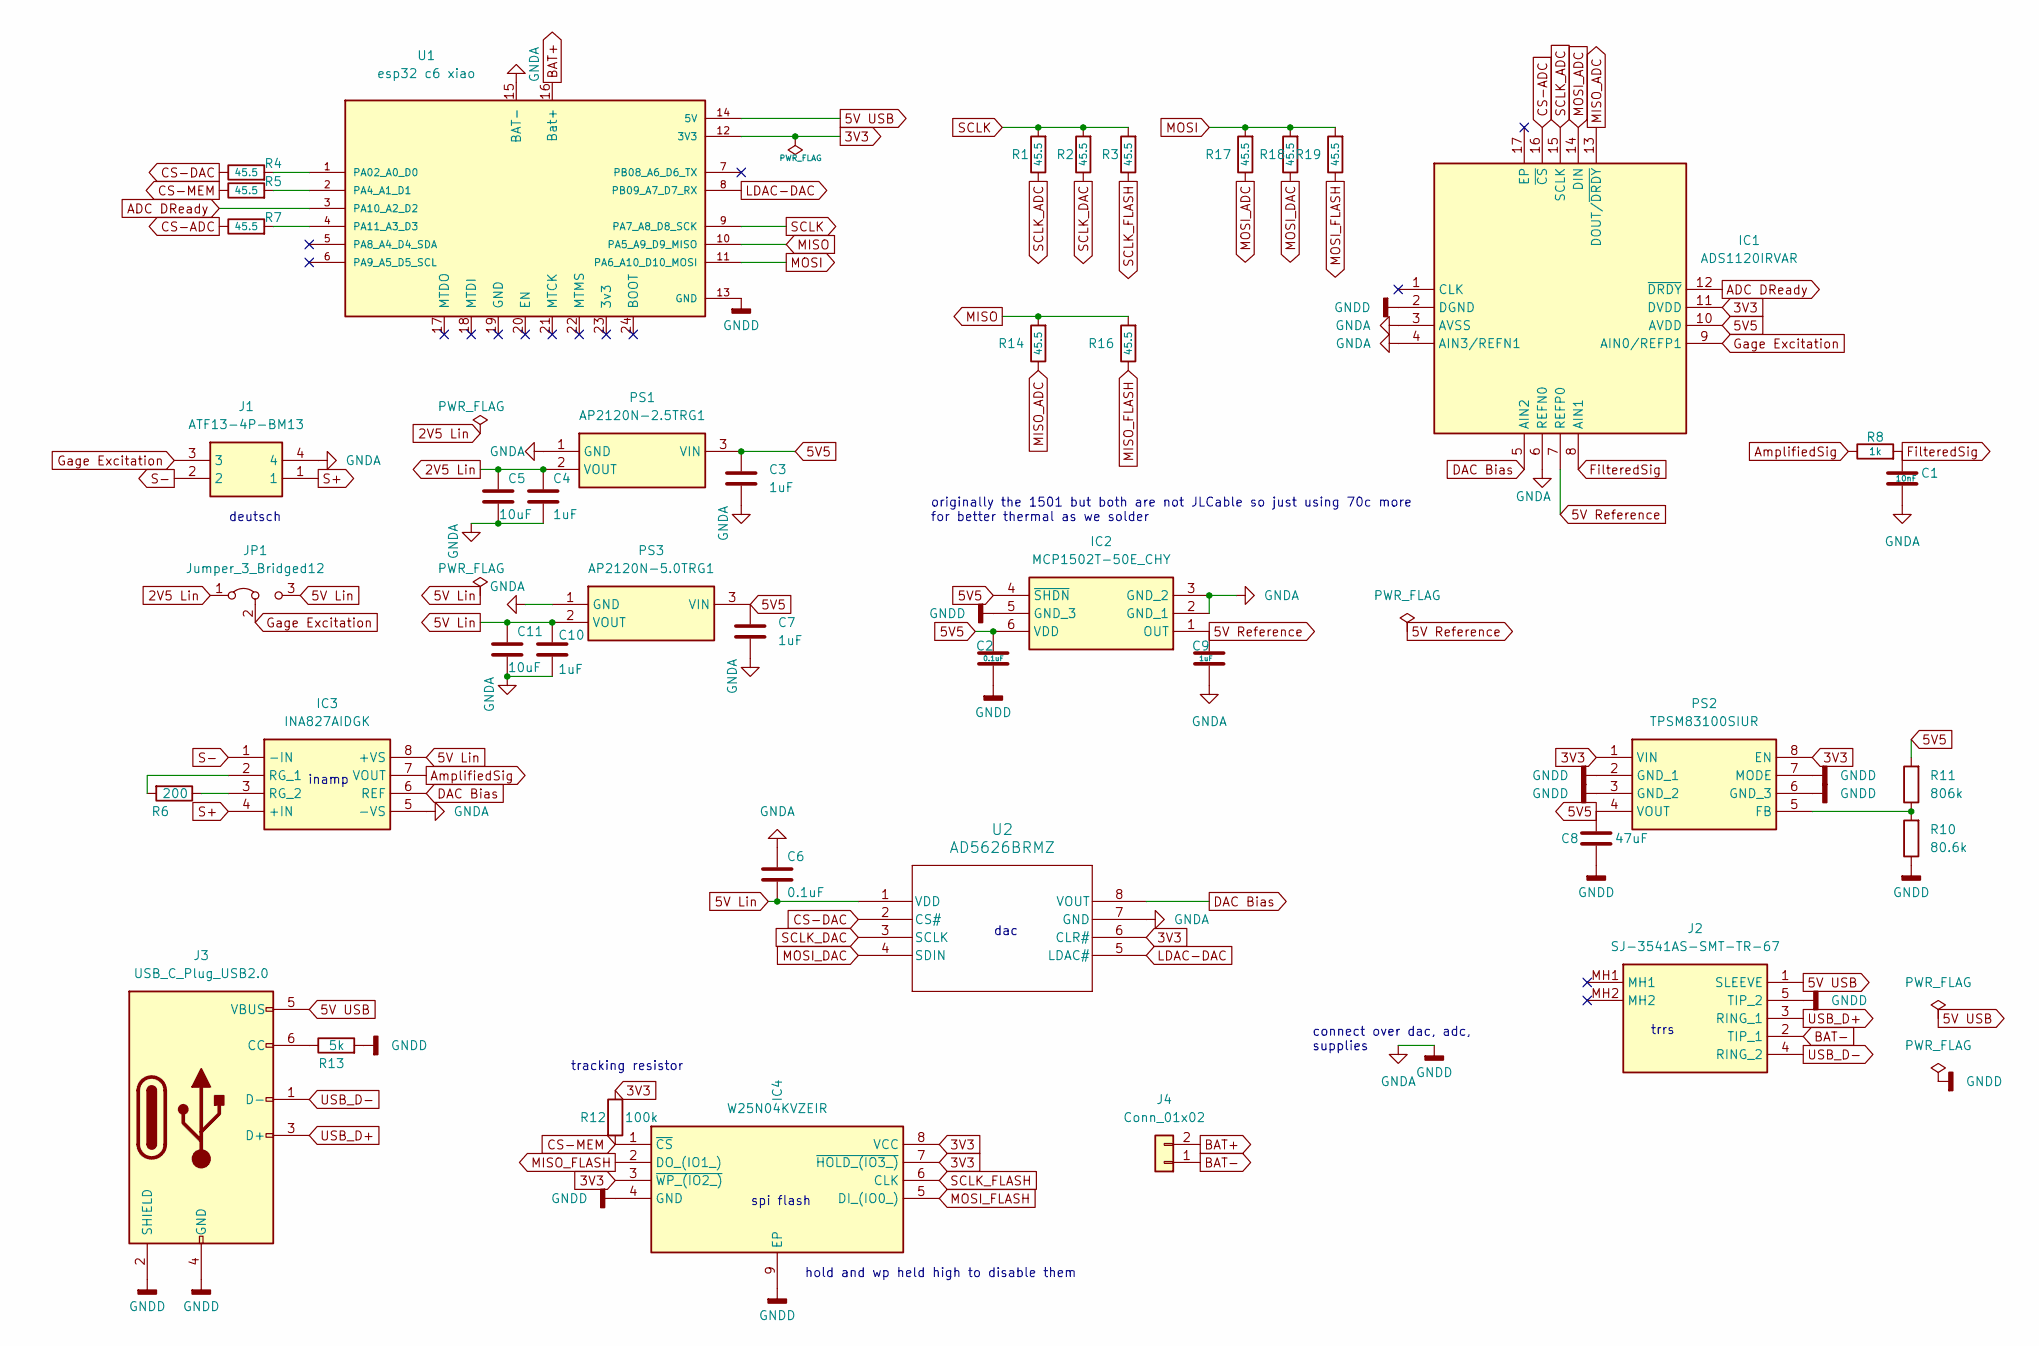
[picture p53: schematic wsg3.0.kicad_sch]

Parts:
C1: 10nF; C_0402_1005Metric
C2, C6: 0.1uF; C_0402_1005Metric
C3, C4, C7, C9, C10: 1uF; C_0402_1005Metric
C5, C11: 10uF; C_0402_1005Metric
C8: 47uF; C_0805_2012Metric
IC1: ADS1120IRVAR; QFN50P350X350X100-17N-D; Mouser Part Number 595-ADS1120IRVAR
IC2: MCP1502T-50E_CHY; SOT95P280X145-6N; Mouser Part Number 579-MCP1501T-50E/CHY
IC3: INA827AIDGK; Mouser Part Number 595-INA827AIDGK
IC4: W25N04KVZEIR; SON127P800X600X80-9N-D; Mouser Part Number 454-W25N04KVZEIR
J1: ATF13-4P-BM13; DTF134PG003; Mouser Part Number 571-DTF13-4P-G003
J2: SJ-3541AS-SMT-TR-67; SJ3541ASSMTTR67; Manufacturer_Part_Number SJ-3541AS-SMT-TR-67
J3: USB_C_Plug_USB2.0; USB_C_PLACE
J4: Conn_01x02; JST_PH_S2B-PH-K_1x02_P2.00mm_Horizontal
JP1: Jumper_3_Bridged12; SolderJumper-3_P2.0mm_Open_TrianglePad1.0x1.5mm
PS1: AP2120N-2.5TRG1; Mouser Part Number 621-AP2120N-5.0TRG1
PS2: TPSM83100SIUR; Mouser Part Number 595-TPSM83100SIUR
PS3: AP2120N-5.0TRG1; Mouser Part Number 621-AP2120N-5.0TRG1
R1, R2, R3, R4, R5, R7, R14, R16, R17, R18, R19: 45.5; R_0402_1005Metric
R6: 200; R_0402_1005Metric
R8: 1k; R_0402_1005Metric
R10: 80.6k; R_0402_1005Metric
R11: 806k; R_0402_1005Metric
R12: 100k; R_0402_1005Metric
R13: 5k; R_0402_1005Metric
U1: esp32 c6 xiao; esp32 c6 smt; PARTREV N/A
U2: AD5626BRMZ; AD5626

Connections:
2V5 Lin: C4.1, C5.1, JP1.1 (A), PS1.2 (VOUT)
3V3: IC1.11 (DVDD), IC4.3 (~WP_(IO2_)), IC4.7 (~HOLD_(IO3_)), IC4.8 (VCC), PS2.1 (VIN), PS2.8 (EN), R12.1, U1.12 (3V3), U2.6 (CLR#)
5V5: C2.1, C3.1, C7.1, C8.1, IC1.10 (AVDD), IC2.4 (~SHDN), IC2.6 (VDD), PS1.3 (VIN), PS2.4 (VOUT), PS3.3 (VIN), R11.2
5V Lin: C6.2, C10.1, C11.1, IC3.8 (+VS), JP1.3 (B), PS3.2 (VOUT), U2.1 (VDD)
5V Reference: C9.1, IC1.7 (REFP0), IC2.1 (OUT)
5V USB: J2.1 (SLEEVE), J3.5 (VBUS), U1.14 (5V)
ADC DReady: IC1.12 (~DRDY), U1.3 (PA10_A2_D2)
AmplifiedSig: IC3.7 (VOUT), R8.1
BAT+: J4.2, U1.16 (Bat+)
BAT-: J2.2 (TIP_1), J4.1
CS-ADC: IC1.16 (~CS), R7.1
CS-DAC: R4.1, U2.2 (CS#)
CS-MEM: IC4.1 (~CS), R5.1, R12.2
DAC Bias: IC1.5 (AIN2), IC3.6 (REF), U2.8 (VOUT)
FilteredSig: C1.1, IC1.8 (AIN1), R8.2
GNDA: C1.2, C2.2, C3.2, C4.2, C5.2, C6.1, C7.2, C8.2, C9.2, C10.2, C11.2, IC1.2 (DGND), IC1.3 (AVSS), IC1.4 (AIN3/REFN1), IC1.6 (REFN0), IC2.2 (GND_1), IC2.3 (GND_2), IC2.5 (GND_3), IC3.5 (-VS), IC4.4 (GND), IC4.9 (EP), J1.4, J2.5 (TIP_2), J3.2 (SHIELD), J3.4 (GND), PS1.1 (GND), PS2.2 (GND_1), PS2.3 (GND_2), PS2.6 (GND_3), PS2.7 (MODE), PS3.1 (GND), R10.1, R13.2, U1.13 (GND), U1.15 (BAT-), U2.7 (GND)
Gage Excitation: IC1.9 (AIN0/REFP1), J1.3, JP1.2 (C)
LDAC-DAC: U1.8 (PB09_A7_D7_RX), U2.5 (LDAC#)
MISO: R14.2, R16.2, U1.10 (PA5_A9_D9_MISO)
MISO_ADC: IC1.13 (DOUT/~DRDY), R14.1
MISO_FLASH: IC4.2 (DO_(IO1_)), R16.1
MOSI: R17.2, R18.2, R19.2, U1.11 (PA6_A10_D10_MOSI)
MOSI_ADC: IC1.14 (DIN), R17.1
MOSI_DAC: R18.1, U2.4 (SDIN)
MOSI_FLASH: IC4.5 (DI_(IO0_)), R19.1
unnamed: IC3.2 (RG_1), R6.2
unnamed: IC3.3 (RG_2), R6.1
unnamed: J3.6 (CC), R13.1
unnamed: PS2.5 (FB), R10.2, R11.1
unnamed: R4.2, U1.1 (PA02_A0_D0)
unnamed: R5.2, U1.2 (PA4_A1_D1)
unnamed: R7.2, U1.4 (PA11_A3_D3)
S+: IC3.4 (+IN), J1.1
S-: IC3.1 (-IN), J1.2
SCLK: R1.2, R2.2, R3.2, U1.9 (PA7_A8_D8_SCK)
SCLK_ADC: IC1.15 (SCLK), R1.1
SCLK_DAC: R2.1, U2.3 (SCLK)
SCLK_FLASH: IC4.6 (CLK), R3.1
USB_D+: J2.3 (RING_1), J3.3 (D+)
USB_D-: J2.4 (RING_2), J3.1 (D-)

Notes on the sheet:
deutsch
connect over dac, adc, supplies
originally the 1501 but both are not JLCable so just using 70c more for better thermal as we solder
trrs
spi flash
hold and wp held high to disable them
dac
inamp
tracking resistor

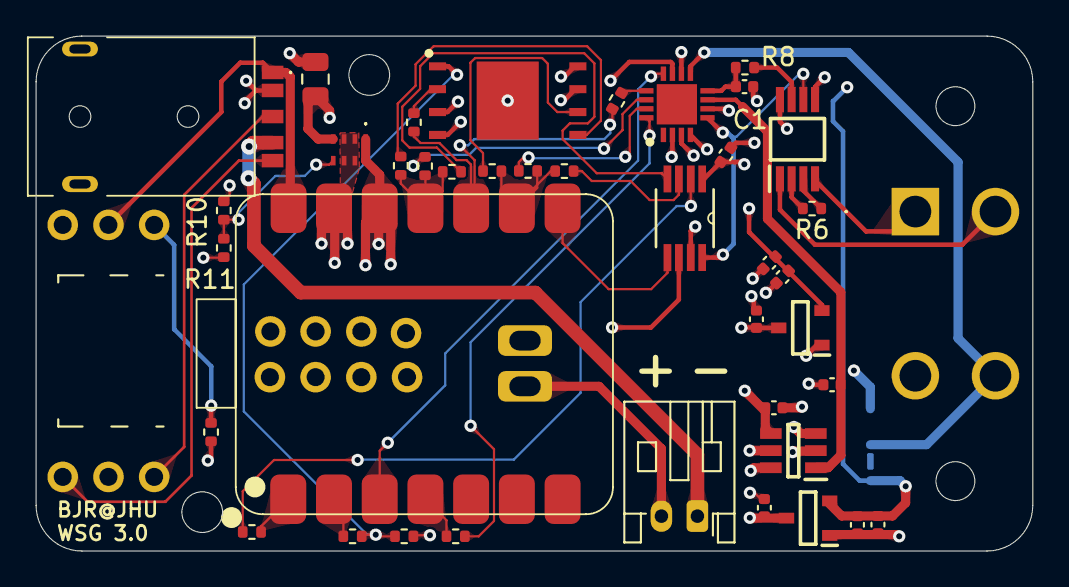
[picture p54: board wsg3.0.kicad_pcb from above]

Board: 4 copper layers, 55.4 x 28.6 mm, 42 parts (1 on the bottom side), 40 nets.
