BlueJayRacing/bjr_kicad/21xt/Power_distribution_board/power_distribution_board.kicad_pcb

## KiCad design 21xt/Power_distribution_board/power_distribution_board.kicad_pcb (2025-03-05)

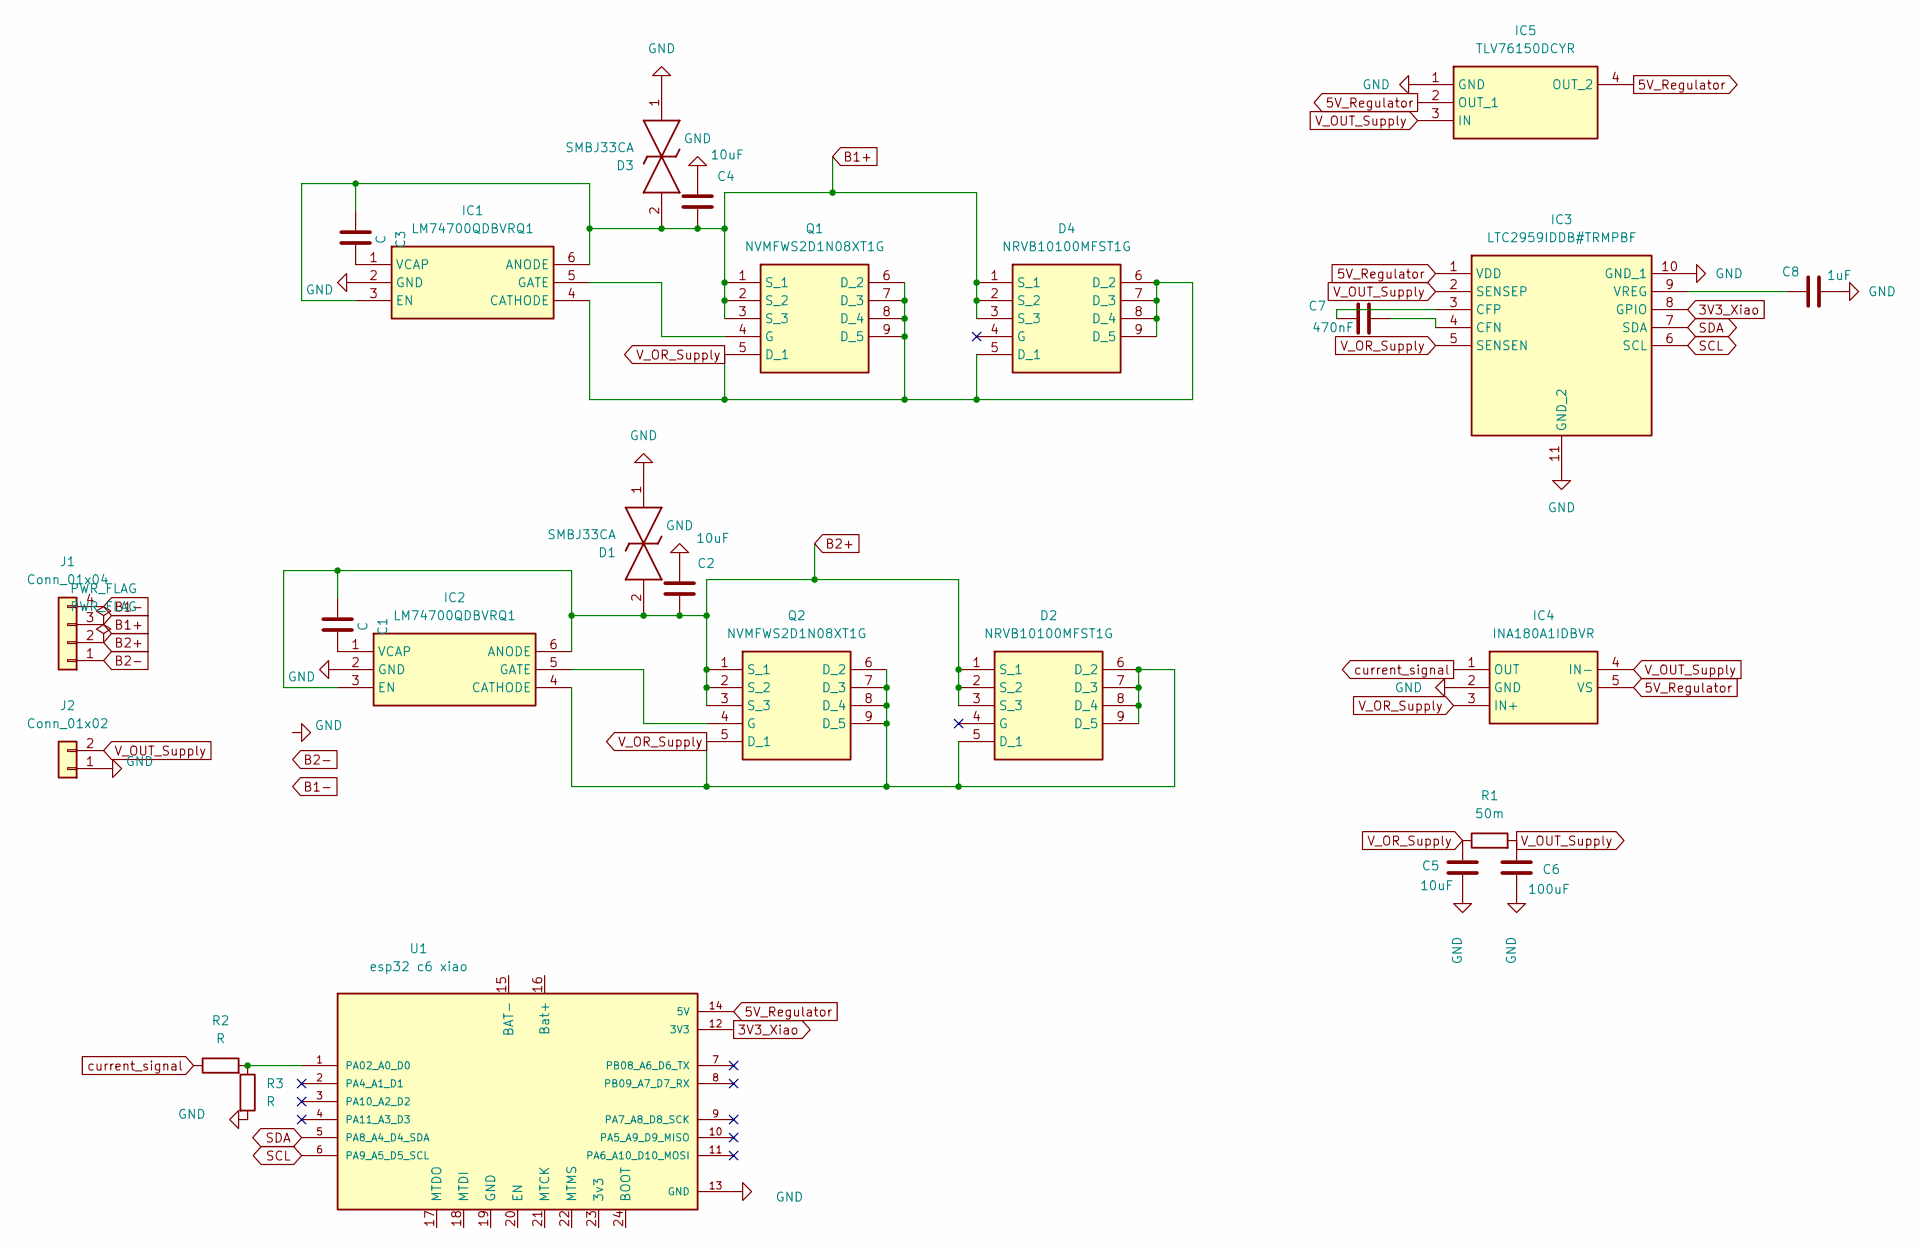
[picture p55: schematic power_distribution_board.kicad_sch]

Parts:
C1, C3: C; C_0402_1005Metric
C2, C4, C5: 10uF; C_0402_1005Metric
C6: 100uF; C_0603_1608Metric
C7: 470nF; C_0402_1005Metric
C8: 1uF; C_0402_1005Metric
D1, D3: SMBJ33CA; Mouser Part Number 652-SMBJ33CA
D2, D4: NRVB10100MFST1G; NRVTS10100EMFST1G; Mouser Part Number 863-NRVB10100MFST1G
IC1, IC2: LM74700QDBVRQ1; Mouser Part Number 595-LM74700QDBVRQ1
IC3: LTC2959IDDB#TRMPBF; Mouser Part Number 584-LTC2959IDDBTRMPB
IC4: INA180A1IDBVR; Mouser Part Number 595-INA180A1IDBVR
IC5: TLV76150DCYR; Mouser Part Number 595-TLV76150DCYR
J1: Conn_01x04; FanPinHeader_1x04_P2.54mm_Vertical
J2: Conn_01x02; PinHeader_1x02_P2.54mm_Vertical
Q1, Q2: NVMFWS2D1N08XT1G; NTMFWS1D5N08XT1G; Mouser Part Number 863-NVMFWS2D1N08XT1G
R1: 50m; R_0805_2012Metric
R2, R3: R; R_0402_1005Metric
U1: esp32 c6 xiao; esp32 c6 smt; PARTREV N/A

Connections:
3V3_Xiao: IC3.8 (GPIO), U1.12 (3V3)
5V_Regulator: IC3.1 (VDD), IC4.5 (VS), IC5.2 (OUT_1), IC5.4 (OUT_2), U1.14 (5V)
B1+: C3.1, C4.2, D3.2, D4.1 (S_1), D4.2 (S_2), D4.3 (S_3), IC1.3 (EN), IC1.6 (ANODE), J1.3, Q1.1 (S_1), Q1.2 (S_2), Q1.3 (S_3)
B1-: J1.4
B2+: C1.1, C2.2, D1.2, D2.1 (S_1), D2.2 (S_2), D2.3 (S_3), IC2.3 (EN), IC2.6 (ANODE), J1.2, Q2.1 (S_1), Q2.2 (S_2), Q2.3 (S_3)
B2-: J1.1
GND: C2.1, C4.1, C5.2, C6.2, C8.2, D1.1, D3.1, IC1.2 (GND), IC2.2 (GND), IC3.10 (GND_1), IC3.11 (GND_2), IC4.2 (GND), IC5.1 (GND), J2.1, R3.2, U1.13 (GND)
unnamed: IC1.5 (GATE), Q1.4 (G)
unnamed: C3.2, IC1.1 (VCAP)
unnamed: IC2.5 (GATE), Q2.4 (G)
unnamed: C1.2, IC2.1 (VCAP)
unnamed: C7.2, IC3.4 (CFN)
unnamed: C7.1, IC3.3 (CFP)
unnamed: C8.1, IC3.9 (VREG)
unnamed: R2.2, R3.1, U1.1 (PA02_A0_D0)
SCL: IC3.6 (SCL), U1.6 (PA9_A5_D5_SCL)
SDA: IC3.7 (SDA), U1.5 (PA8_A4_D4_SDA)
V_OR_Supply: C5.1, D2.5 (D_1), D2.6 (D_2), D2.7 (D_3), D2.8 (D_4), D2.9 (D_5), D4.5 (D_1), D4.6 (D_2), D4.7 (D_3), D4.8 (D_4), D4.9 (D_5), IC1.4 (CATHODE), IC2.4 (CATHODE), IC3.5 (SENSEN), IC4.3 (IN+), Q1.5 (D_1), Q1.6 (D_2), Q1.7 (D_3), Q1.8 (D_4), Q1.9 (D_5), Q2.5 (D_1), Q2.6 (D_2), Q2.7 (D_3), Q2.8 (D_4), Q2.9 (D_5), R1.1
V_OUT_Supply: C6.1, IC3.2 (SENSEP), IC4.4 (IN-), IC5.3 (IN), J2.2, R1.2
current_signal: IC4.1 (OUT), R2.1

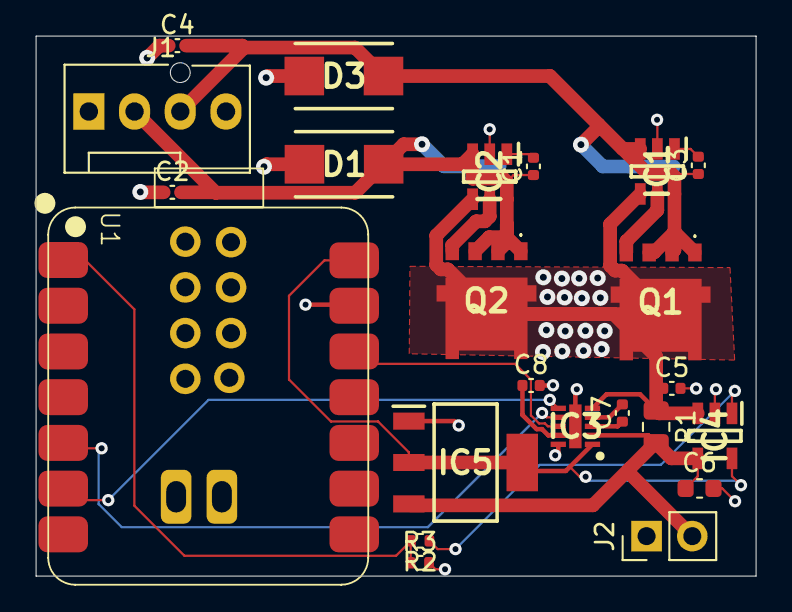
[picture p56: board power_distribution_board.kicad_pcb from above]

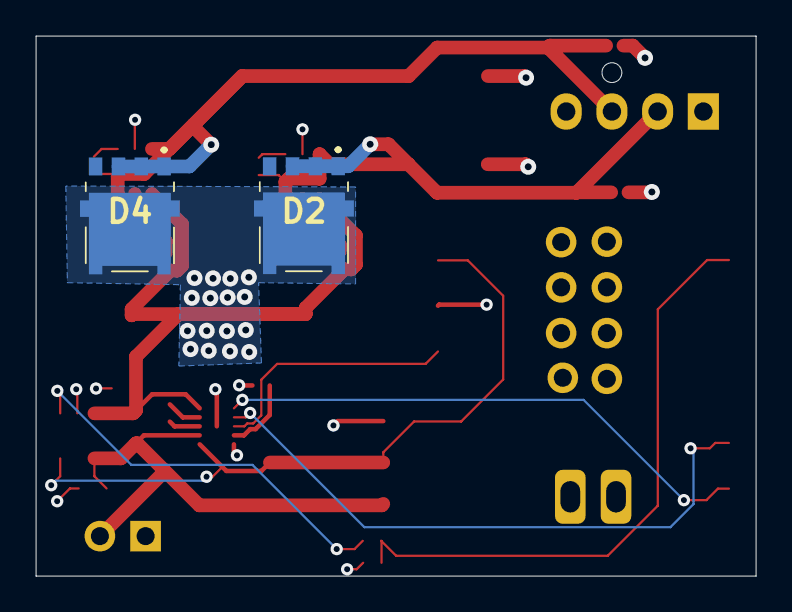
[picture p57: board power_distribution_board.kicad_pcb from below]

Board: 4 copper layers, 40.0 x 30.0 mm, 25 parts (2 on the bottom side), 18 nets.
