BlueJayRacing/bjr_kicad/21xt/06-magnetometer/Magnetometer.kicad_pcb

## KiCad design 21xt/06-magnetometer/Magnetometer.kicad_pcb (2025-03-05)

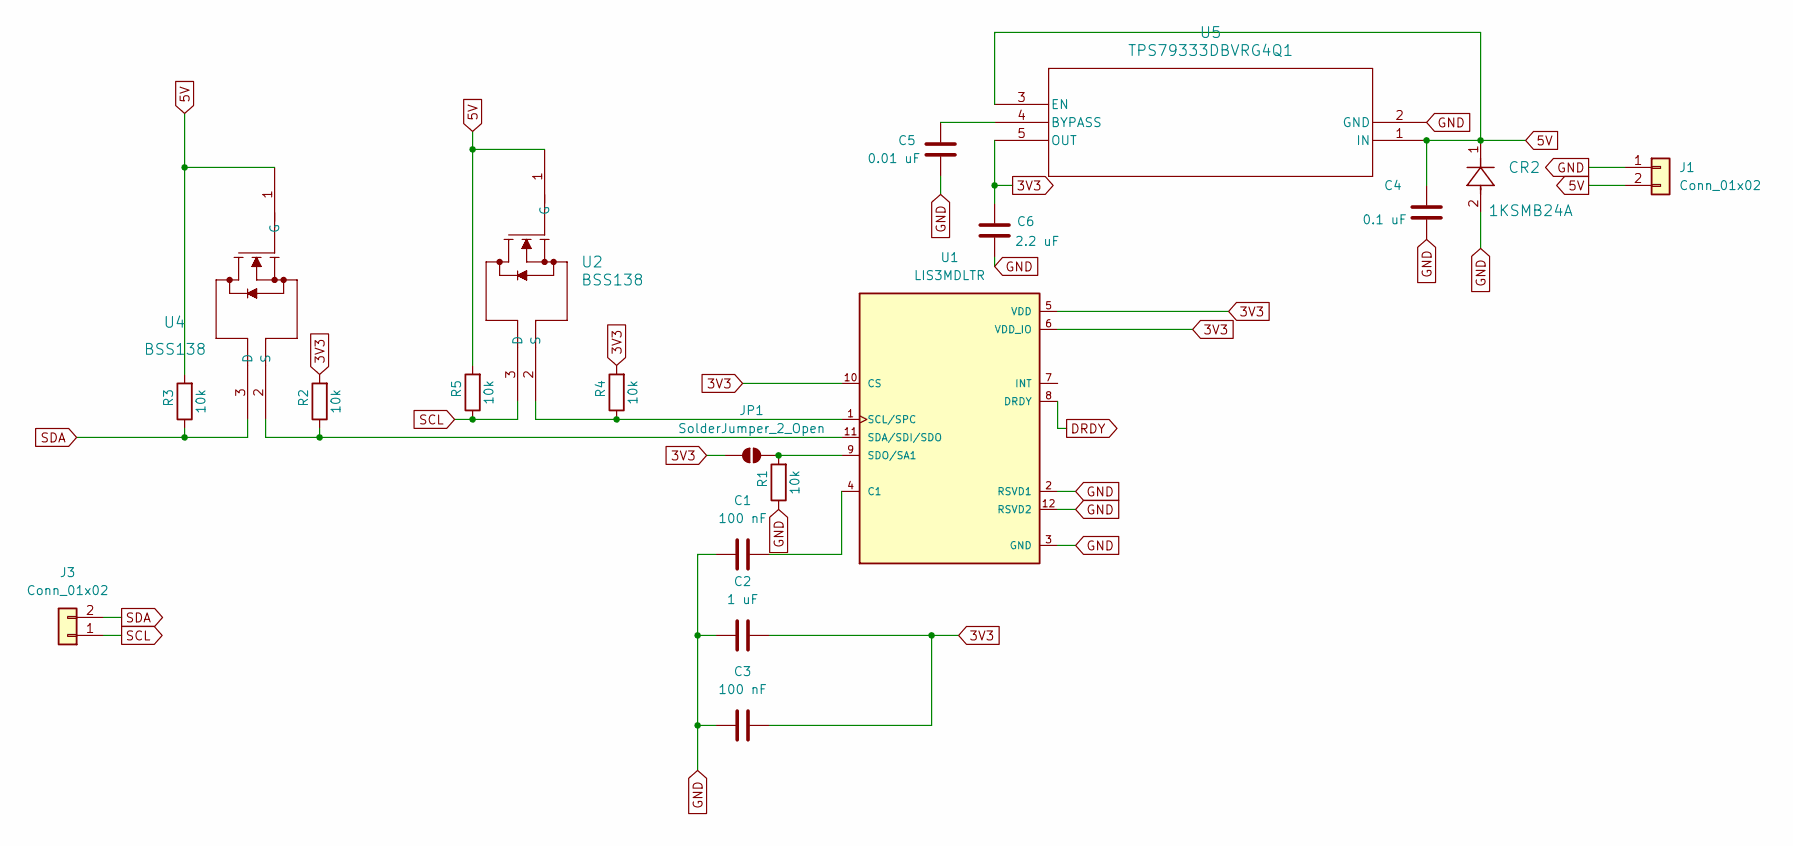
[picture p58: schematic Magnetometer.kicad_sch]

Parts:
C1, C3: 100 nF; C_0402_1005Metric
C2: 1 uF; C_0402_1005Metric
C4: 0.1 uF; C_0402_1005Metric
C5: 0.01 uF; C_0402_1005Metric
C6: 2.2 uF; C_0402_1005Metric
CR2: 1KSMB24A; 1KSMBSeries_LTF
J1, J3: Conn_01x02; Connector
JP1: SolderJumper_2_Open; SolderJumper
R1, R2, R3, R4, R5: 10k; R_0402_1005Metric
U1: LIS3MDLTR; PARTREV 6
U2, U4: BSS138
U5: TPS79333DBVRG4Q1; DBV5_TEX

Connections:
3V3: C2.2, C3.2, C6.1, JP1.1 (A), R2.2, R4.2, U1.5 (VDD), U1.6 (VDD_IO), U1.10 (CS), U5.5 (OUT)
5V: C4.1, CR2.1, J1.2, R3.2, R5.2, U2.1 (G), U4.1 (G), U5.1 (IN), U5.3 (EN)
DRDY: U1.8 (DRDY)
GND: C1.1, C2.1, C3.1, C4.2, C5.2, C6.2, CR2.2, J1.1, R1.1, U1.2 (RSVD1), U1.3 (GND), U1.12 (RSVD2), U5.2 (GND)
unnamed: JP1.2 (B), R1.2, U1.9 (SDO/SA1)
unnamed: C1.2, U1.4 (C1)
unnamed: R4.1, U1.1 (SCL/SPC), U2.2 (S)
unnamed: R2.1, U1.11 (SDA/SDI/SDO), U4.2 (S)
unnamed: C5.1, U5.4 (BYPASS)
SCL: J3.1, R5.1, U2.3 (D)
SDA: J3.2, R3.1, U4.3 (D)

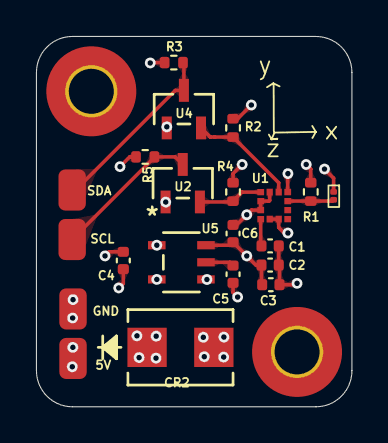
[picture p59: board Magnetometer.kicad_pcb from above]

Board: 4 copper layers, 17.5 x 20.6 mm, 19 parts (0 on the bottom side), 10 nets.
