BlueJayRacing/bjr_kicad/21xt/06-magnetometer/MagnetometerLayout.kicad_pcb

## KiCad design 21xt/06-magnetometer/MagnetometerLayout.kicad_pcb (2025-03-05)

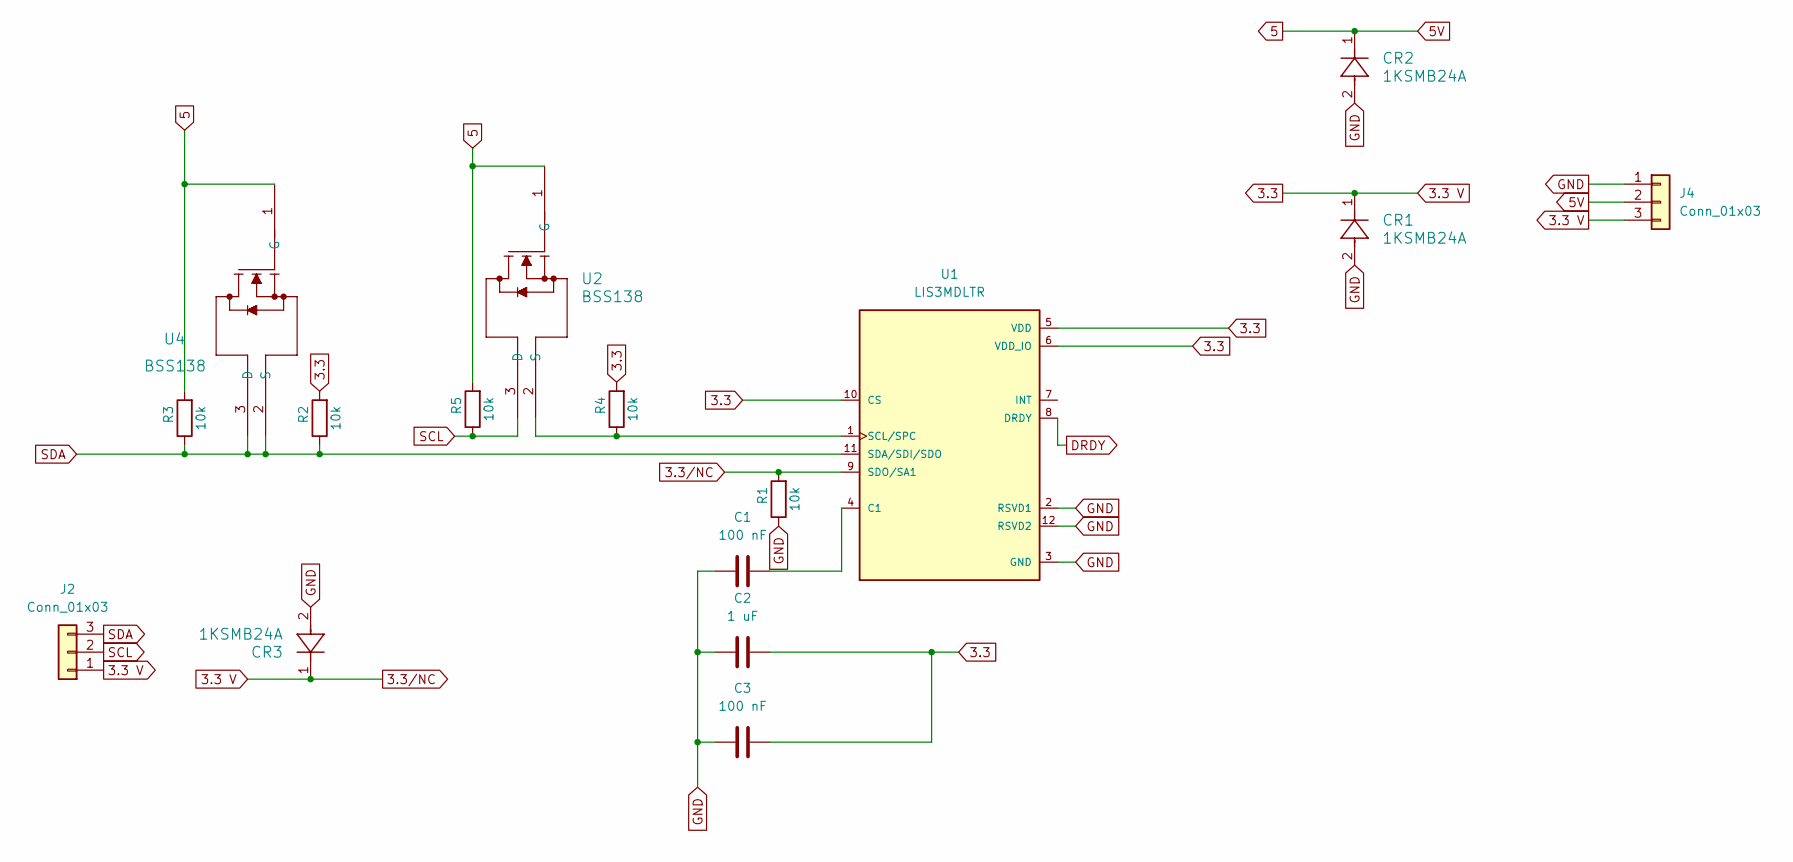
[picture p60: schematic MagnetometerLayout.kicad_sch]

Parts:
C1, C3: 100 nF; CP_Elec_3x5.3
C2: 1 uF; CP_Elec_3x5.3
CR1, CR2, CR3: 1KSMB24A
J2, J4: Conn_01x03; JST_EH_B3B-EH-A_1x03_P2.50mm_Vertical
R1, R2, R3, R4, R5: 10k; R_0201_0603Metric_Pad0.64x0.40mm_HandSolder
U1: LIS3MDLTR; XDCR_LIS3MDLTR; PARTREV 6
U2, U4: BSS138

Connections:
3.3: C2.2, C3.2, CR1.1, CR3.1, J2.1, J4.3, R1.2, R2.2, R4.2, U1.5 (VDD), U1.6 (VDD_IO), U1.9 (SDO/SA1), U1.10 (CS)
5: CR2.1, J4.2, R3.2, R5.2, U2.1 (G), U4.1 (G)
DRDY: U1.8 (DRDY)
GND: C1.1, C2.1, C3.1, CR1.2, CR2.2, CR3.2, J4.1, R1.1, U1.2 (RSVD1), U1.3 (GND), U1.12 (RSVD2)
unnamed: C1.2, U1.4 (C1)
unnamed: R4.1, U1.1 (SCL/SPC), U2.2 (S)
SCL: J2.2, R5.1, U2.3 (D)
SDA: J2.3, R2.1, R3.1, U1.11 (SDA/SDI/SDO), U4.2 (S), U4.3 (D)

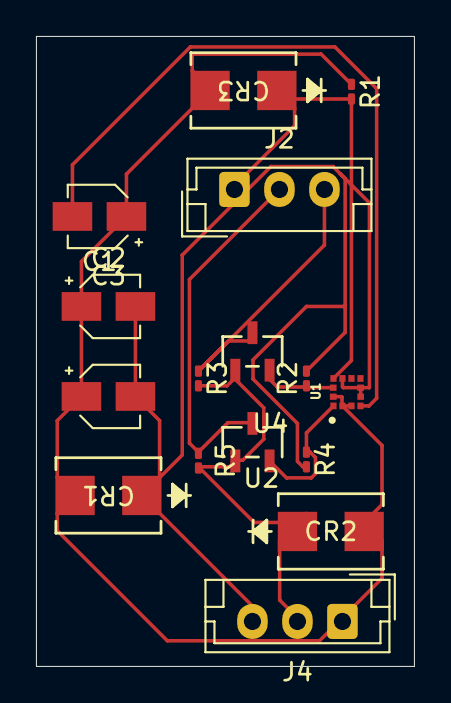
[picture p61: board MagnetometerLayout.kicad_pcb from above]

Board: 2 copper layers, 21.0 x 35.0 mm, 16 parts (0 on the bottom side), 7 nets.
