BlueJayRacing/bjr_kicad/21xt/steering_wheel/steering_wheel.kicad_pcb

## KiCad design 21xt/steering_wheel/steering_wheel.kicad_pcb (2025-03-05)

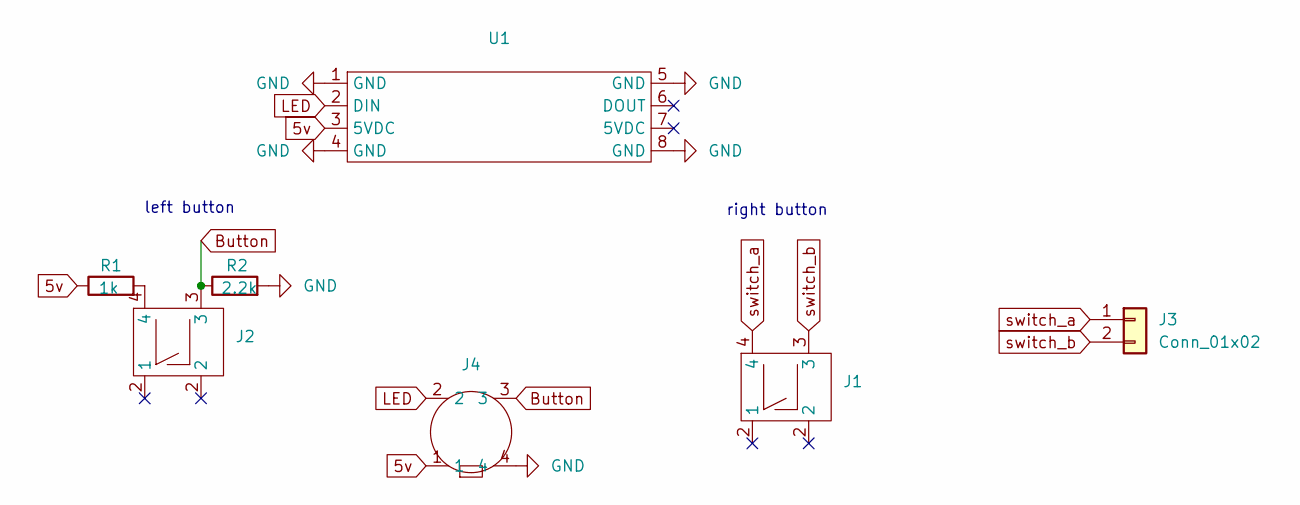
[picture p62: schematic steering_wheel.kicad_sch]

Parts:
J1, J2: K12SD S 1.5 6N O LFTX
J3: Conn_01x02; SolderWire-0.1sqmm_1x02_P3.6mm_D0.4mm_OD1mm
J4: m8 pp bulkhead 09 4912 081 04
R1: 1k; R_0402_1005Metric
R2: 2.2k; R_0402_1005Metric
U1: led_strip

Connections:
5v: J4.1, R1.1, U1.3 (5VDC)
Button: J2.3, J4.3, R2.1
GND: J4.4, R2.2, U1.1 (GND), U1.4 (GND), U1.5 (GND), U1.8 (GND)
LED: J4.2, U1.2 (DIN)
unnamed: J2.4, R1.2
switch_a: J1.4, J3.1
switch_b: J1.3, J3.2

Notes on the sheet:
right button
left button

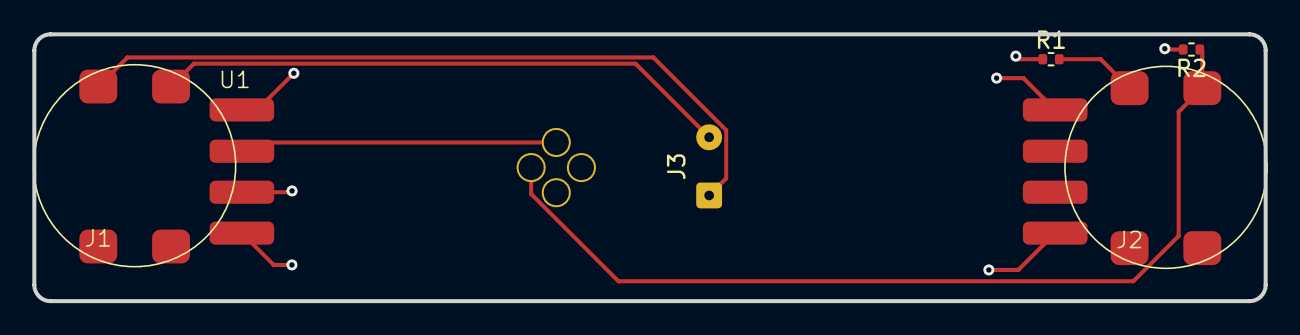
[picture p63: board steering_wheel.kicad_pcb from above]

Board: 4 copper layers, 76.2 x 16.5 mm, 7 parts (1 on the bottom side), 7 nets.
