BlueJayRacing/bjr_kicad/21xt/in-shaft-wsg/in-shaft-wsg-mommy/in-shaft-wsg-mommy.kicad_pcb

## KiCad design 21xt/in-shaft-wsg/in-shaft-wsg-mommy/in-shaft-wsg-mommy.kicad_pcb (2025-03-05)

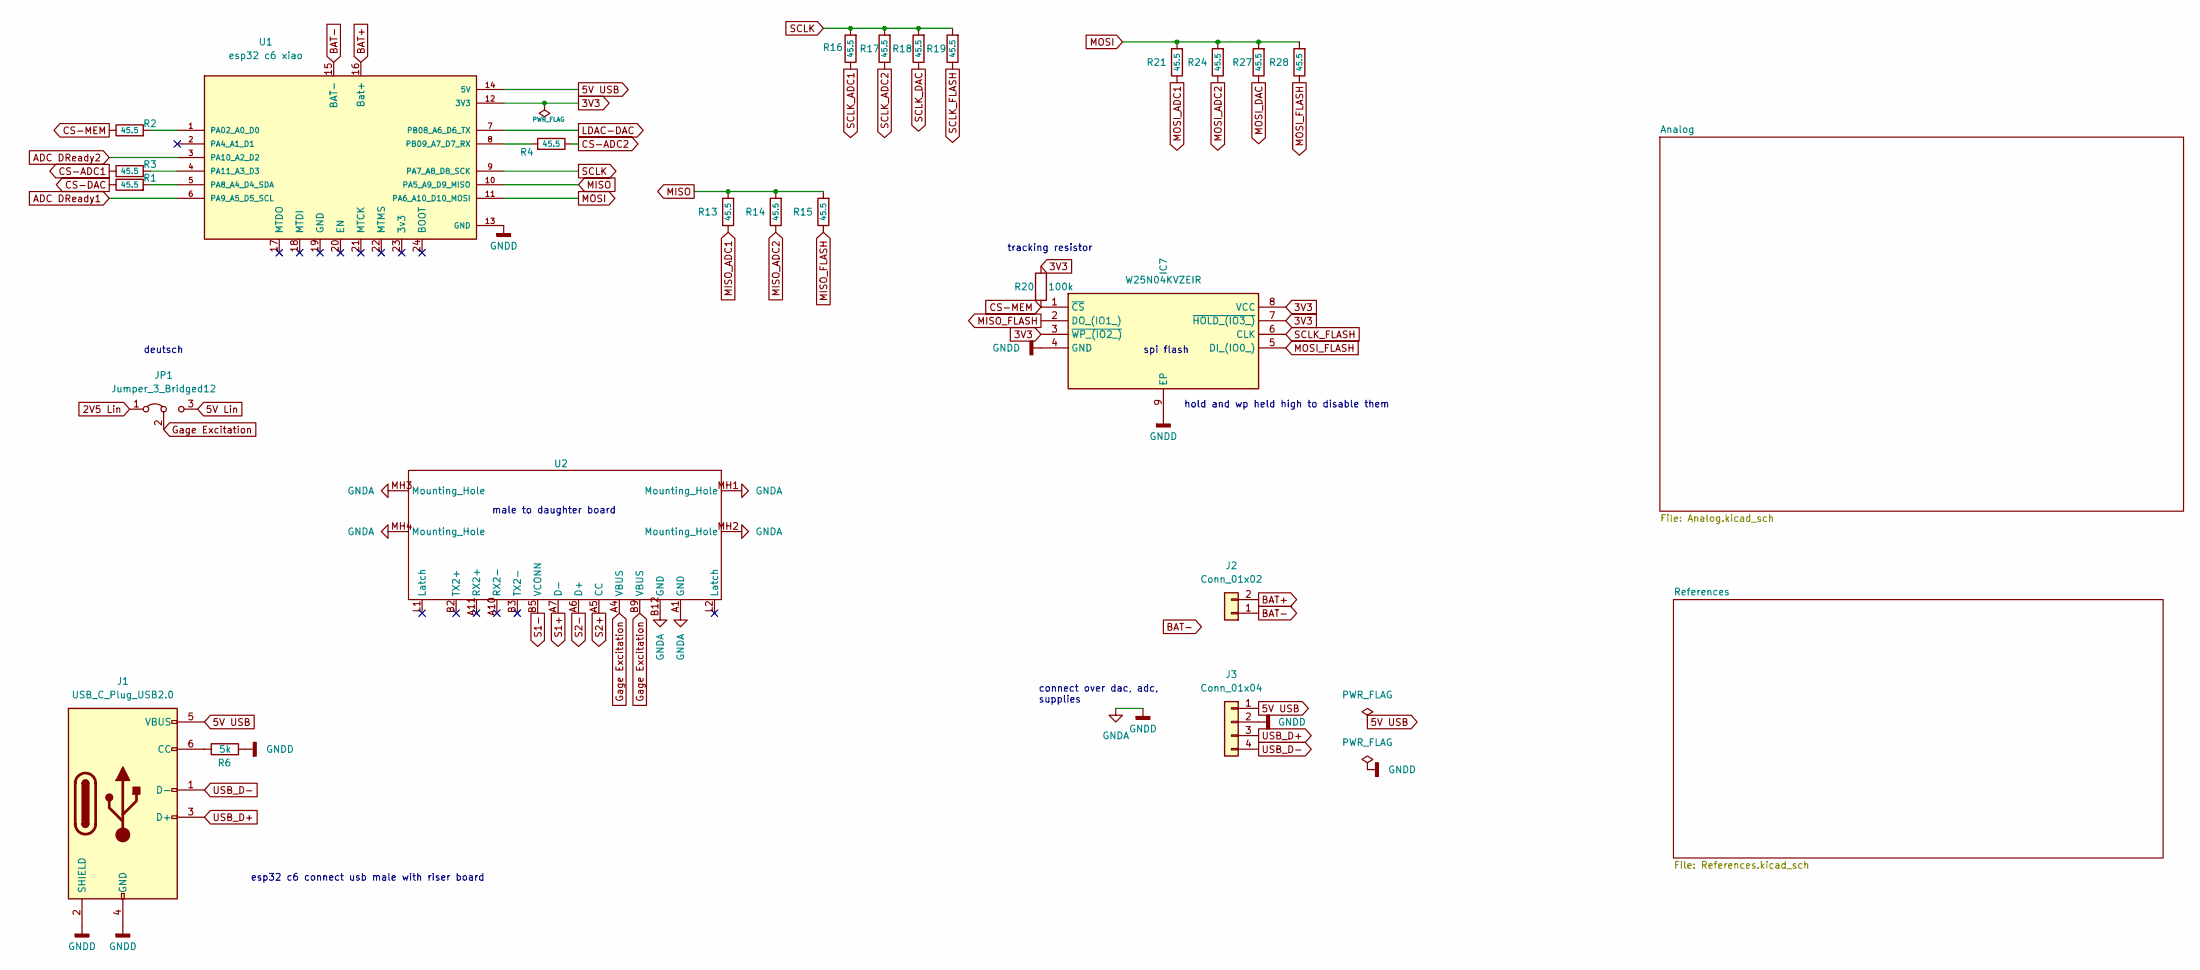
[picture p64: schematic in-shaft-wsg-mommy.kicad_sch]

Parts:
IC7: W25N04KVZEIR; SON127P800X600X80-9N-D; Mouser Part Number 454-W25N04KVZEIR
J1: USB_C_Plug_USB2.0; USB_C_PLACE
J2: Conn_01x02; JST_PH_S2B-PH-K_1x02_P2.00mm_Horizontal
J3: Conn_01x04; PinHeader_1x04_P2.00mm_Vertical
JP1: Jumper_3_Bridged12; SolderJumper-3_P2.0mm_Open_TrianglePad1.0x1.5mm
R1, R2, R3, R4, R13, R14, R15, R16, R17, R18, R19, R21, R24, R27, R28: 45.5; R_0402_1005Metric
R6: 5k; R_0402_1005Metric
R20: 100k; R_0402_1005Metric
U1: esp32 c6 xiao; esp32 c6 smt; PARTREV N/A
U2: USB_C_MOUNT

Connections:
2V5 Lin: JP1.1 (A); also elsewhere on the board
3V3: IC7.3 (~WP_(IO2_)), IC7.7 (~HOLD_(IO3_)), IC7.8 (VCC), R20.1, U1.12 (3V3); also elsewhere on the board
5V Lin: JP1.3 (B); also elsewhere on the board
5V USB: J1.5 (VBUS), J3.1, U1.14 (5V)
ADC DReady1: U1.6 (PA9_A5_D5_SCL); also elsewhere on the board
ADC DReady2: U1.3 (PA10_A2_D2); also elsewhere on the board
BAT+: J2.2, U1.16 (Bat+)
BAT-: J2.1, U1.15 (BAT-)
CS-ADC1: R3.1; also elsewhere on the board
CS-ADC2: R4.1; also elsewhere on the board
CS-DAC: R1.1; also elsewhere on the board
CS-MEM: IC7.1 (~CS), R2.1, R20.2
GNDA: IC7.4 (GND), IC7.9 (EP), J1.2 (SHIELD), J1.4 (GND), J3.2, R6.2, U1.13 (GND), U2.A1 (GND), U2.B12 (GND), U2.MH1 (Mounting_Hole), U2.MH2 (Mounting_Hole), U2.MH3 (Mounting_Hole), U2.MH4 (Mounting_Hole); also elsewhere on the board
Gage Excitation: JP1.2 (C), U2.A4 (VBUS), U2.B9 (VBUS); also elsewhere on the board
LDAC-DAC: U1.7 (PB08_A6_D6_TX); also elsewhere on the board
MISO: R13.2, R14.2, R15.2, U1.10 (PA5_A9_D9_MISO)
MISO_ADC1: R13.1; also elsewhere on the board
MISO_ADC2: R14.1; also elsewhere on the board
MISO_FLASH: IC7.2 (DO_(IO1_)), R15.1
MOSI: R21.2, R24.2, R27.2, R28.2, U1.11 (PA6_A10_D10_MOSI)
MOSI_ADC1: R21.1; also elsewhere on the board
MOSI_ADC2: R24.1; also elsewhere on the board
MOSI_DAC: R27.1; also elsewhere on the board
MOSI_FLASH: IC7.5 (DI_(IO0_)), R28.1
unnamed: J1.6 (CC), R6.1
unnamed: R2.2, U1.1 (PA02_A0_D0)
unnamed: R1.2, U1.5 (PA8_A4_D4_SDA)
unnamed: R3.2, U1.4 (PA11_A3_D3)
unnamed: R4.2, U1.8 (PB09_A7_D7_RX)
S1+: U2.A7 (D-); also elsewhere on the board
S1-: U2.B5 (VCONN); also elsewhere on the board
S2+: U2.A5 (CC); also elsewhere on the board
S2-: U2.A6 (D+); also elsewhere on the board
SCLK: R16.2, R17.2, R18.2, R19.2, U1.9 (PA7_A8_D8_SCK)
SCLK_ADC1: R16.1; also elsewhere on the board
SCLK_ADC2: R17.1; also elsewhere on the board
SCLK_DAC: R18.1; also elsewhere on the board
SCLK_FLASH: IC7.6 (CLK), R19.1
USB_D+: J1.3 (D+), J3.3
USB_D-: J1.1 (D-), J3.4

Notes on the sheet:
connect over dac, adc, supplies
esp32 c6 connect usb male with riser board
spi flash
male to daughter board
deutsch
hold and wp held high to disable them
tracking resistor
