BlueJayRacing/bjr_kicad/21xt/in-shaft-wsg/in-shaft-wsg-mommy/in-shaft-wsg-mommy.kicad_pcb

## KiCad design 21xt/in-shaft-wsg/in-shaft-wsg-mommy/in-shaft-wsg-mommy.kicad_pcb (continued)

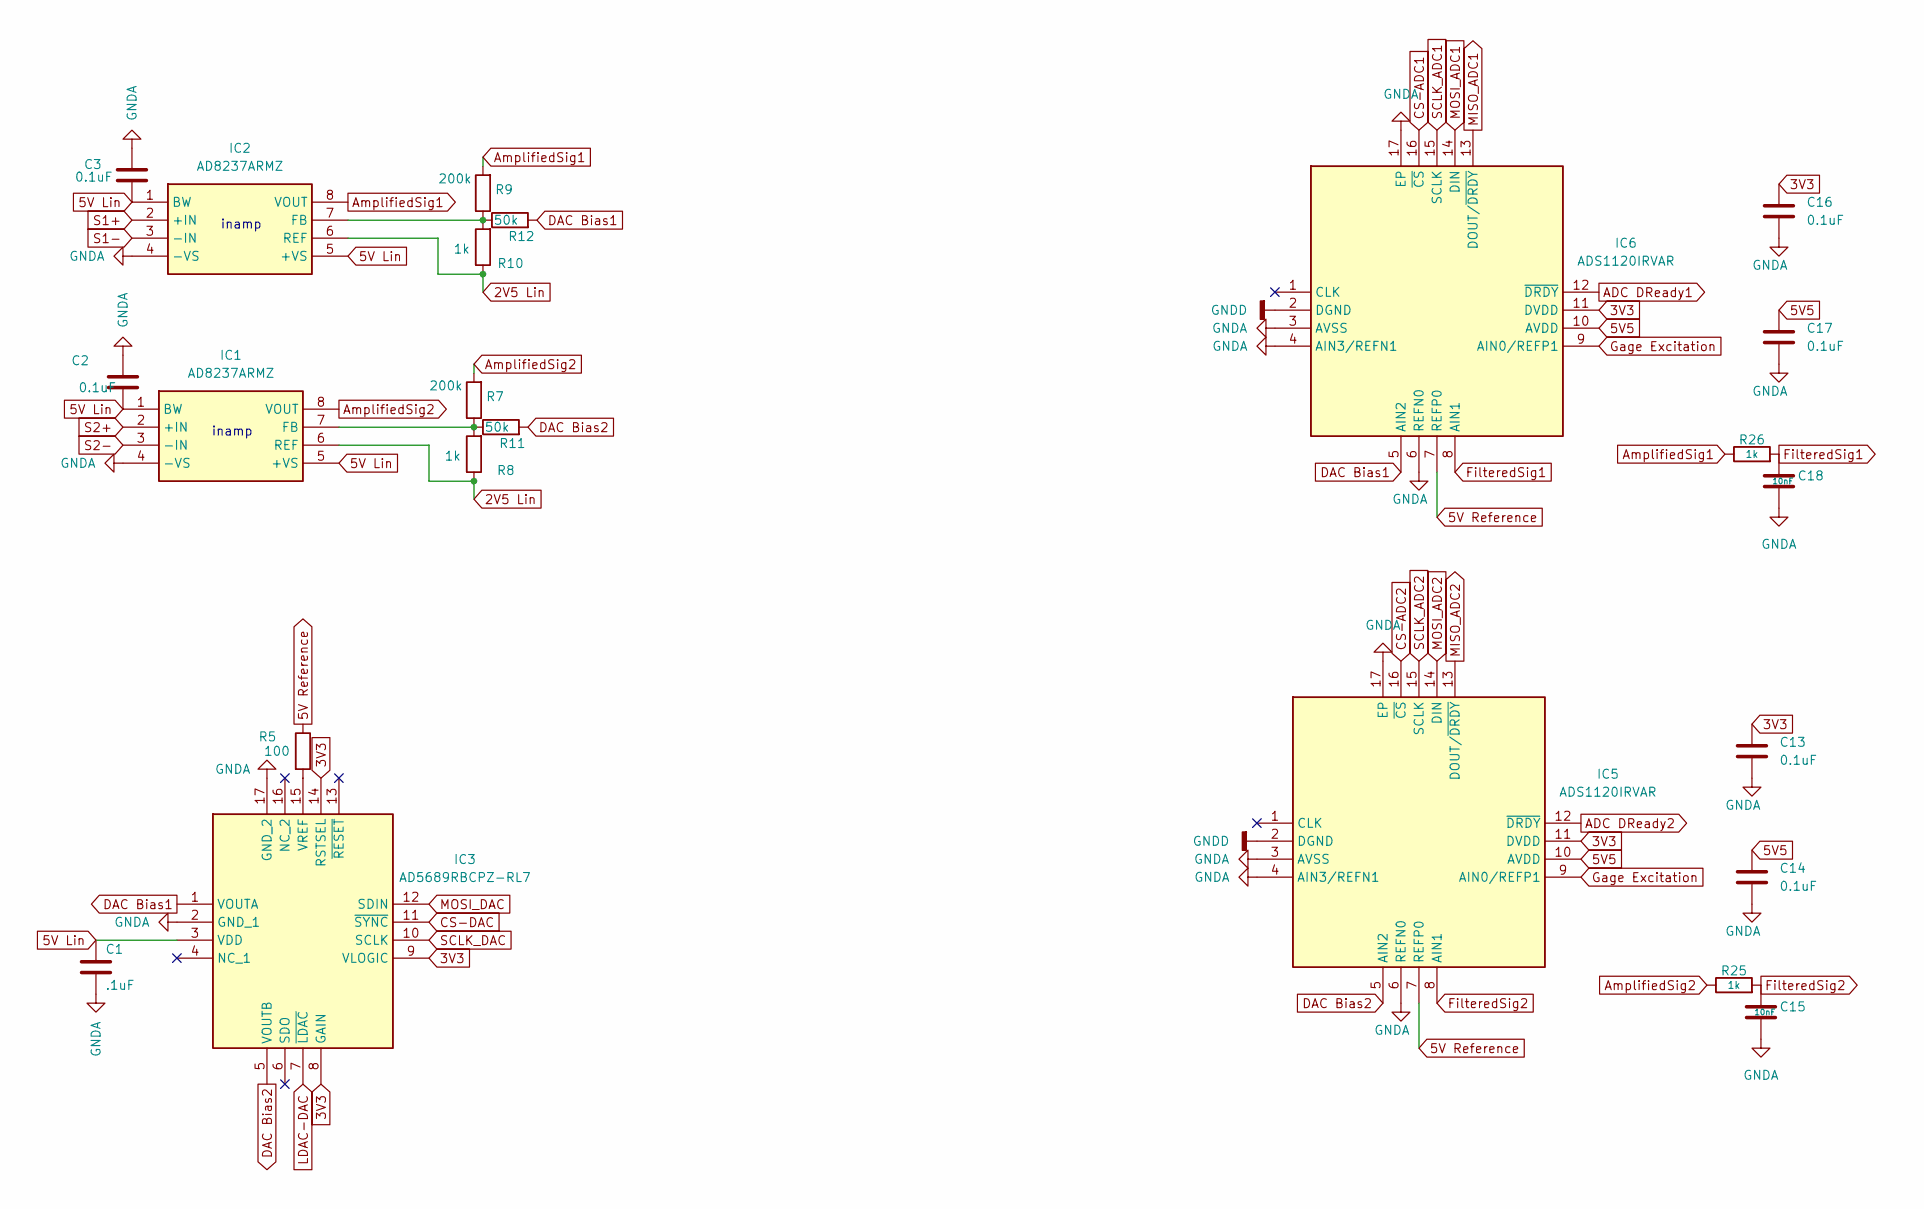
[picture p65: schematic Analog.kicad_sch]

Parts:
C1: .1uF; C_0402_1005Metric
C2, C3, C13, C14, C16, C17: 0.1uF; C_0402_1005Metric
C15, C18: 10nF; C_0402_1005Metric
IC1, IC2: AD8237ARMZ; Mouser Part Number 584-AD8237ARMZ
IC3: AD5689RBCPZ-RL7; Mouser Part Number 584-AD5689RBCPZ-R7
IC5, IC6: ADS1120IRVAR; QFN50P350X350X100-17N-D; Mouser Part Number 595-ADS1120IRVAR
R5: 100; R_0402_1005Metric
R7, R9: 200k; R_0402_1005Metric
R8, R10, R25, R26: 1k; R_0402_1005Metric
R11, R12: 50k; R_0402_1005Metric

Connections:
2V5 Lin: IC1.6 (REF), IC2.6 (REF), R8.1, R10.1; also elsewhere on the board
3V3: C13.1, C16.1, IC3.8 (GAIN), IC3.9 (VLOGIC), IC3.14 (RSTSEL), IC5.11 (DVDD), IC6.11 (DVDD); also elsewhere on the board
5V5: C14.1, C17.1, IC5.10 (AVDD), IC6.10 (AVDD); also elsewhere on the board
5V Lin: C1.1, C2.2, C3.2, IC1.1 (BW), IC1.5 (+VS), IC2.1 (BW), IC2.5 (+VS), IC3.3 (VDD); also elsewhere on the board
5V Reference: IC5.7 (REFP0), IC6.7 (REFP0), R5.1; also elsewhere on the board
ADC DReady1: IC6.12 (~DRDY); also elsewhere on the board
ADC DReady2: IC5.12 (~DRDY); also elsewhere on the board
AmplifiedSig1: IC2.8 (VOUT), R9.2, R26.1
AmplifiedSig2: IC1.8 (VOUT), R7.2, R25.1
CS-ADC1: IC6.16 (~CS); also elsewhere on the board
CS-ADC2: IC5.16 (~CS); also elsewhere on the board
CS-DAC: IC3.11 (~SYNC); also elsewhere on the board
DAC Bias1: IC3.1 (VOUTA), IC6.5 (AIN2), R12.2
DAC Bias2: IC3.5 (VOUTB), IC5.5 (AIN2), R11.2
FilteredSig1: C18.1, IC6.8 (AIN1), R26.2
FilteredSig2: C15.1, IC5.8 (AIN1), R25.2
GNDA: C1.2, C2.1, C3.1, C13.2, C14.2, C15.2, C16.2, C17.2, C18.2, IC1.4 (-VS), IC2.4 (-VS), IC3.2 (GND_1), IC3.17 (GND_2), IC5.2 (DGND), IC5.3 (AVSS), IC5.4 (AIN3/REFN1), IC5.6 (REFN0), IC5.17 (EP), IC6.2 (DGND), IC6.3 (AVSS), IC6.4 (AIN3/REFN1), IC6.6 (REFN0), IC6.17 (EP); also elsewhere on the board
Gage Excitation: IC5.9 (AIN0/REFP1), IC6.9 (AIN0/REFP1); also elsewhere on the board
LDAC-DAC: IC3.7 (~LDAC); also elsewhere on the board
MISO_ADC1: IC6.13 (DOUT/~DRDY); also elsewhere on the board
MISO_ADC2: IC5.13 (DOUT/~DRDY); also elsewhere on the board
MOSI_ADC1: IC6.14 (DIN); also elsewhere on the board
MOSI_ADC2: IC5.14 (DIN); also elsewhere on the board
MOSI_DAC: IC3.12 (SDIN); also elsewhere on the board
unnamed: IC1.7 (FB), R7.1, R8.2, R11.1
unnamed: IC2.7 (FB), R9.1, R10.2, R12.1
unnamed: IC3.15 (VREF), R5.2
S1+: IC2.2 (+IN); also elsewhere on the board
S1-: IC2.3 (-IN); also elsewhere on the board
S2+: IC1.2 (+IN); also elsewhere on the board
S2-: IC1.3 (-IN); also elsewhere on the board
SCLK_ADC1: IC6.15 (SCLK); also elsewhere on the board
SCLK_ADC2: IC5.15 (SCLK); also elsewhere on the board
SCLK_DAC: IC3.10 (SCLK); also elsewhere on the board

Notes on the sheet:
inamp

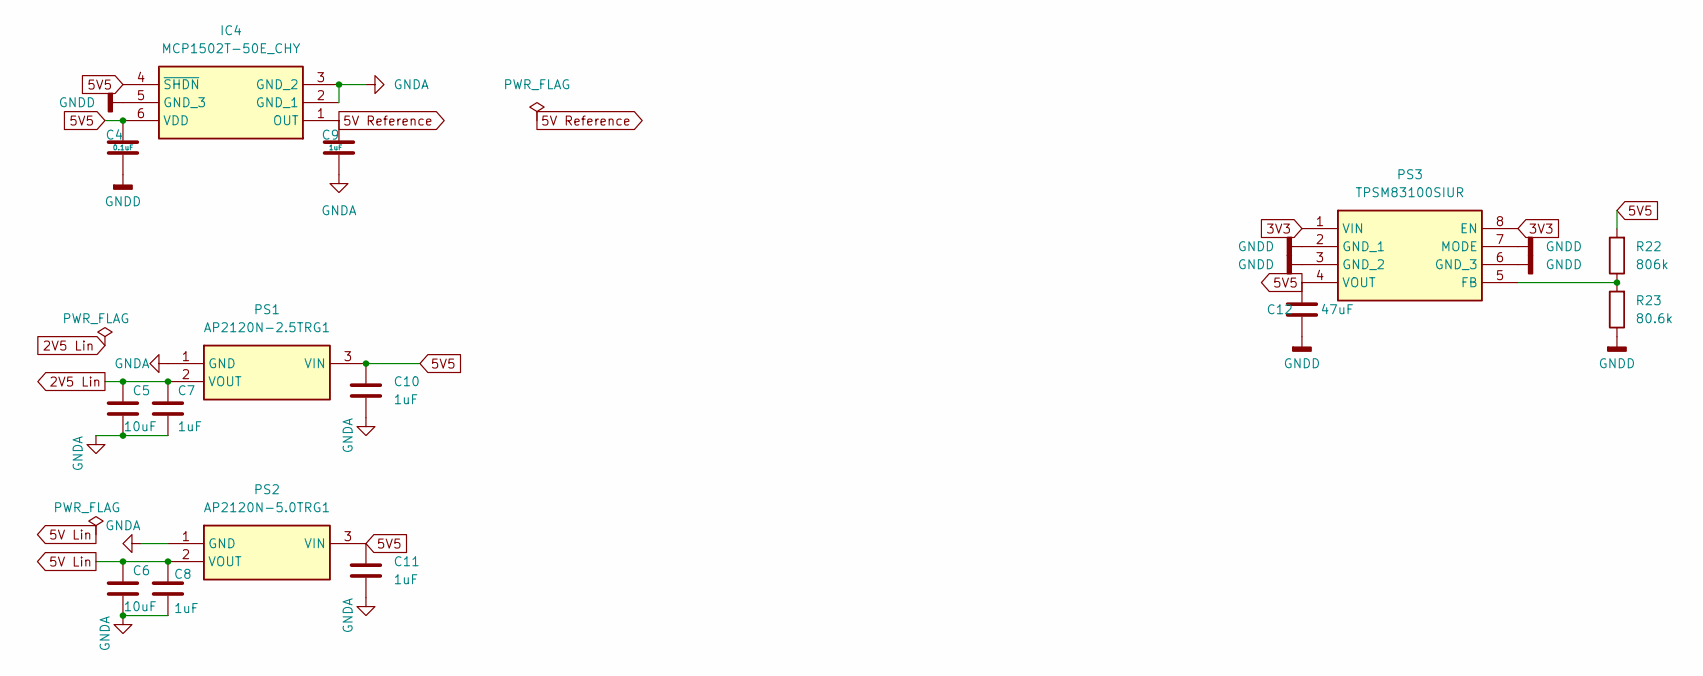
[picture p66: schematic References.kicad_sch]

Parts:
C4: 0.1uF; C_0402_1005Metric
C5, C6: 10uF; C_0402_1005Metric
C7, C8, C9, C10, C11: 1uF; C_0402_1005Metric
C12: 47uF; C_0805_2012Metric
IC4: MCP1502T-50E_CHY; SOT95P280X145-6N; Mouser Part Number 579-MCP1501T-50E/CHY
PS1: AP2120N-2.5TRG1; Mouser Part Number 621-AP2120N-5.0TRG1
PS2: AP2120N-5.0TRG1; Mouser Part Number 621-AP2120N-5.0TRG1
PS3: TPSM83100SIUR; Mouser Part Number 595-TPSM83100SIUR
R22: 806k; R_0402_1005Metric
R23: 80.6k; R_0402_1005Metric

Connections:
2V5 Lin: C5.1, C7.1, PS1.2 (VOUT); also elsewhere on the board
3V3: PS3.1 (VIN), PS3.8 (EN); also elsewhere on the board
5V5: C4.1, C10.1, C11.1, C12.1, IC4.4 (~SHDN), IC4.6 (VDD), PS1.3 (VIN), PS2.3 (VIN), PS3.4 (VOUT), R22.2; also elsewhere on the board
5V Lin: C6.1, C8.1, PS2.2 (VOUT); also elsewhere on the board
5V Reference: C9.1, IC4.1 (OUT); also elsewhere on the board
GNDA: C4.2, C5.2, C6.2, C7.2, C8.2, C9.2, C10.2, C11.2, C12.2, IC4.2 (GND_1), IC4.3 (GND_2), IC4.5 (GND_3), PS1.1 (GND), PS2.1 (GND), PS3.2 (GND_1), PS3.3 (GND_2), PS3.6 (GND_3), PS3.7 (MODE), R23.1; also elsewhere on the board
unnamed: PS3.5 (FB), R22.1, R23.2

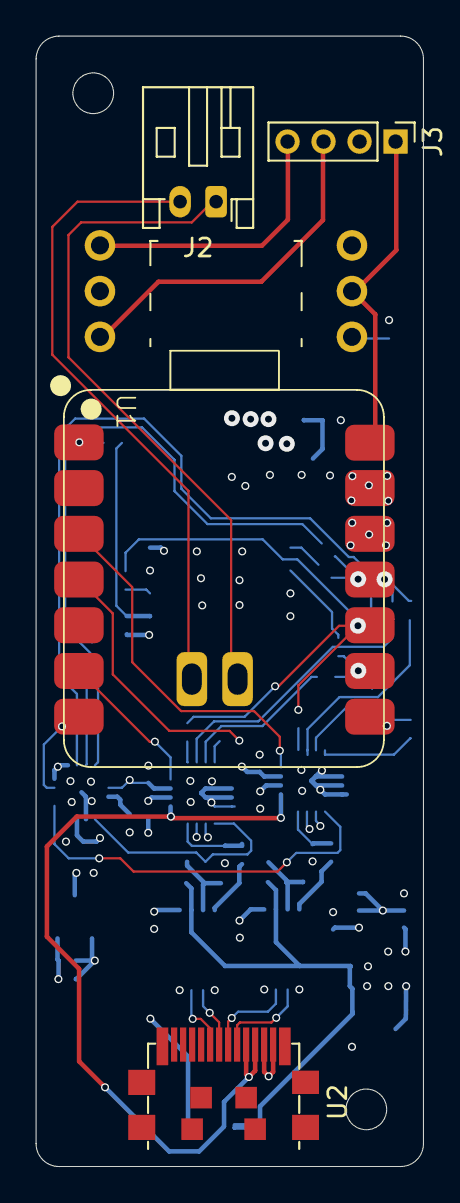
[picture p67: board in-shaft-wsg-mommy.kicad_pcb from above]

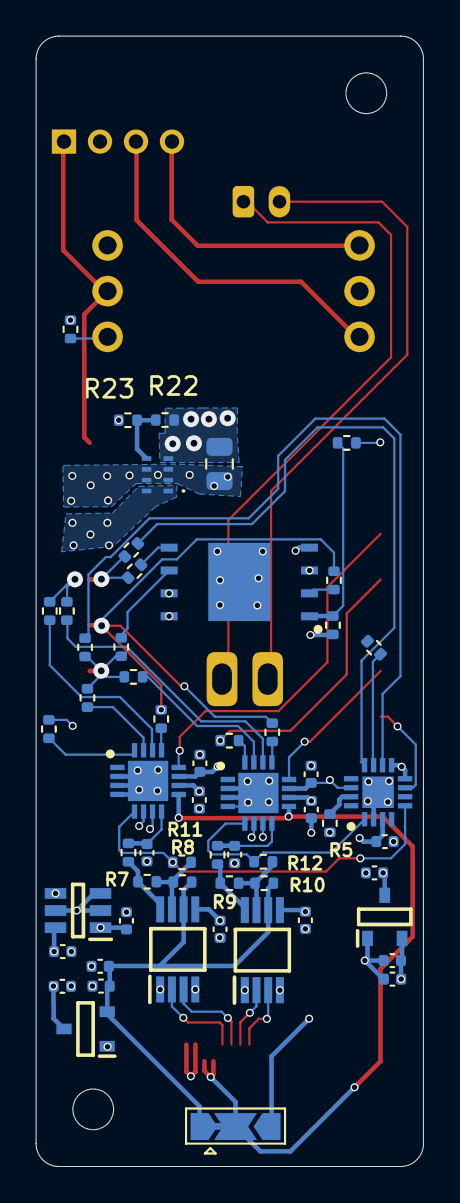
[picture p68: board in-shaft-wsg-mommy.kicad_pcb from below]

Board: 4 copper layers, 21.5 x 62.8 mm, 62 parts (57 on the bottom side), 52 nets.
