BlueJayRacing/bjr_kicad/21xt/in-shaft-wsg/in-shaft-wsg-daughter/in-shaft-wsg-daughter.kicad_pcb

## KiCad design 21xt/in-shaft-wsg/in-shaft-wsg-daughter/in-shaft-wsg-daughter.kicad_pcb (2025-03-05)

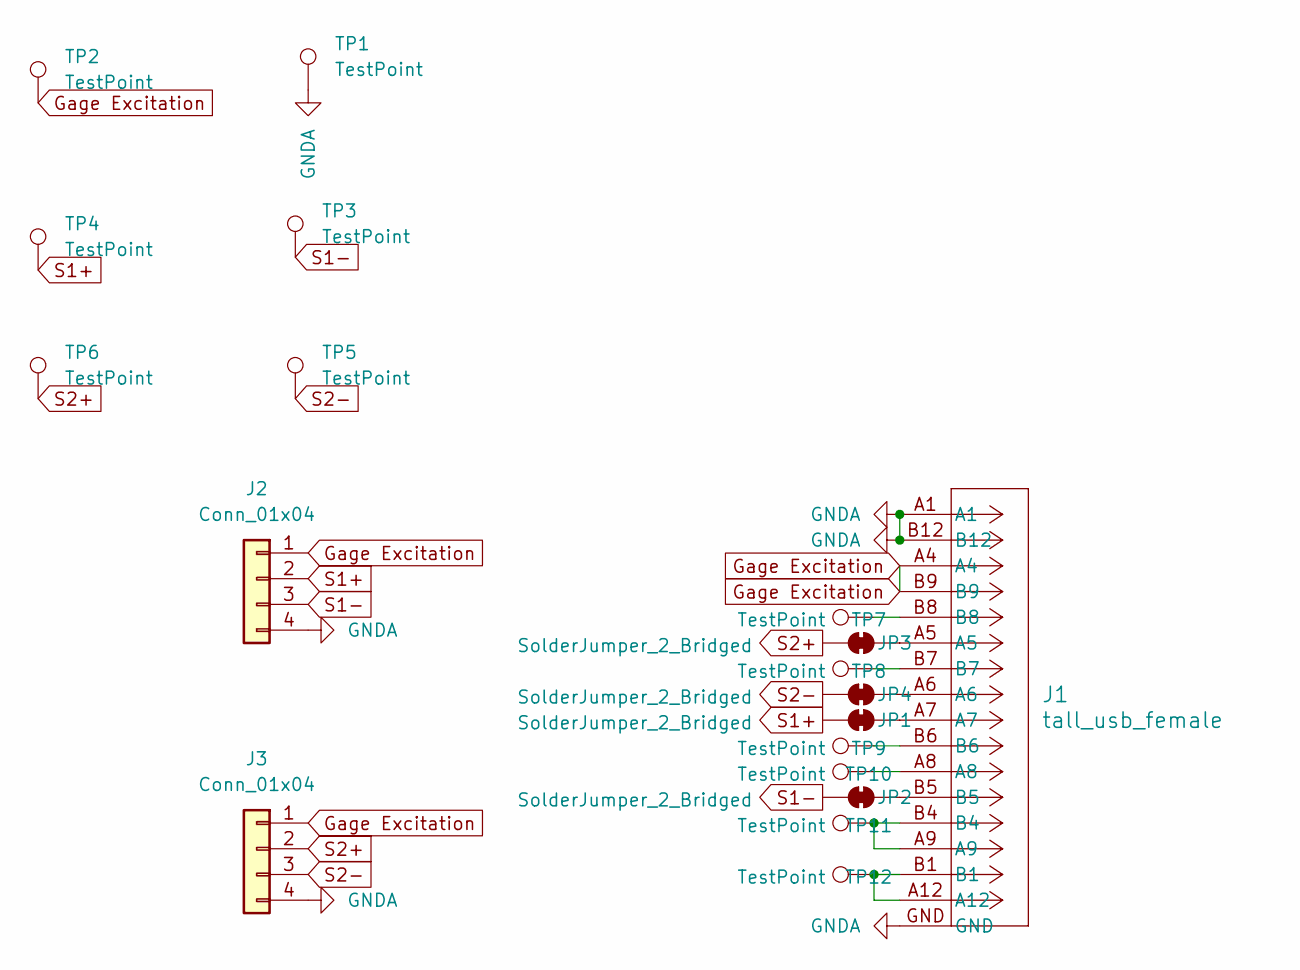
[picture p69: schematic in-shaft-wsg-daughter.kicad_sch]

Parts:
J1: tall_usb_female; tall usb female
J2, J3: Conn_01x04; SolderWire-0.1sqmm_1x04_P3.6mm_D0.4mm_OD1mm
JP1, JP2, JP3, JP4: SolderJumper_2_Bridged; SolderJumper-2_P1.3mm_Bridged_RoundedPad1.0x1.5mm
TP1, TP2, TP3, TP4, TP5, TP6, TP7, TP8, TP9, TP10, TP11, TP12: TestPoint; TestPoint_Pad_1.0x1.0mm

Connections:
GNDA: J1.A1, J1.B12, J1.GND, J2.4, J3.4, TP1.1
Gage Excitation: J1.A4, J1.B9, J2.1, J3.1, TP2.1
unnamed: J1.A8, TP10.1
unnamed: J1.A9, J1.B4, TP11.1
unnamed: J1.A12, J1.B1, TP12.1
unnamed: J1.B6, TP9.1
unnamed: J1.B7, TP8.1
unnamed: J1.B8, TP7.1
unnamed: J1.A7, JP1.1 (A)
unnamed: J1.B5, JP2.1 (A)
unnamed: J1.A5, JP3.1 (A)
unnamed: J1.A6, JP4.1 (A)
S1+: J2.2, JP1.2 (B), TP4.1
S1-: J2.3, JP2.2 (B), TP3.1
S2+: J3.2, JP3.2 (B), TP6.1
S2-: J3.3, JP4.2 (B), TP5.1

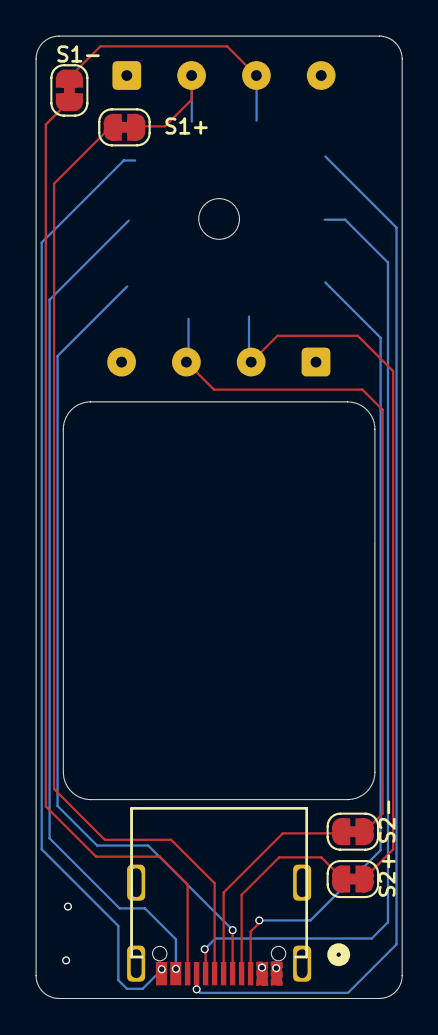
[picture p70: board in-shaft-wsg-daughter.kicad_pcb from above]

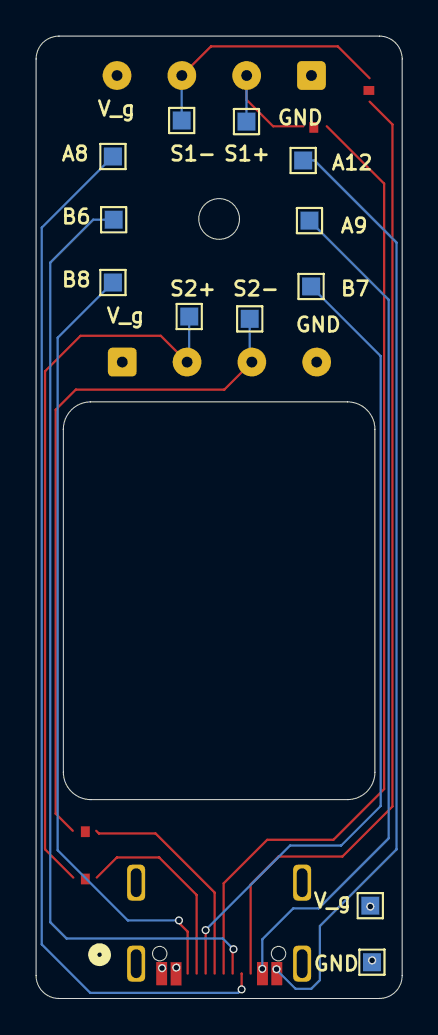
[picture p71: board in-shaft-wsg-daughter.kicad_pcb from below]

Board: 4 copper layers, 20.3 x 53.5 mm, 19 parts (12 on the bottom side), 16 nets.
