BlueJayRacing/bjr_kicad/21xt/serial_bulkhead/serial_bulkhead.kicad_pcb

## KiCad design 21xt/serial_bulkhead/serial_bulkhead.kicad_pcb (2025-01-16)

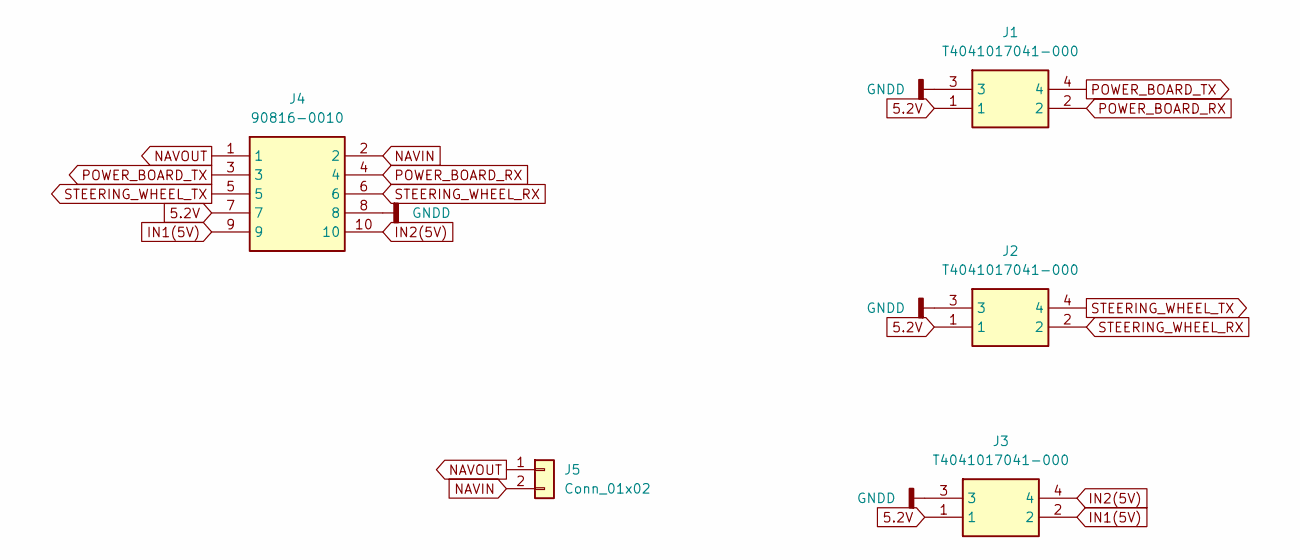
[picture p72: schematic serial_bulkhead.kicad_sch]

Parts:
J1, J2, J3: T4041017041-000; T4041017041000; Mouser Part Number 571-T4041017041-000
J4: 90816-0010; 908160010; Mouser Part Number 538-90816-0010
J5: Conn_01x02; JST_XH_B2B-XH-AM_1x02_P2.50mm_Vertical

Connections:
5.2V: J1.1, J2.1, J3.1, J4.7
GNDD: J1.3, J2.3, J3.3, J4.8
IN1(5V): J3.2, J4.9
IN2(5V): J3.4, J4.10
NAVIN: J4.2, J5.2
NAVOUT: J4.1, J5.1
POWER_BOARD_RX: J1.2, J4.4
POWER_BOARD_TX: J1.4, J4.3
STEERING_WHEEL_RX: J2.2, J4.6
STEERING_WHEEL_TX: J2.4, J4.5

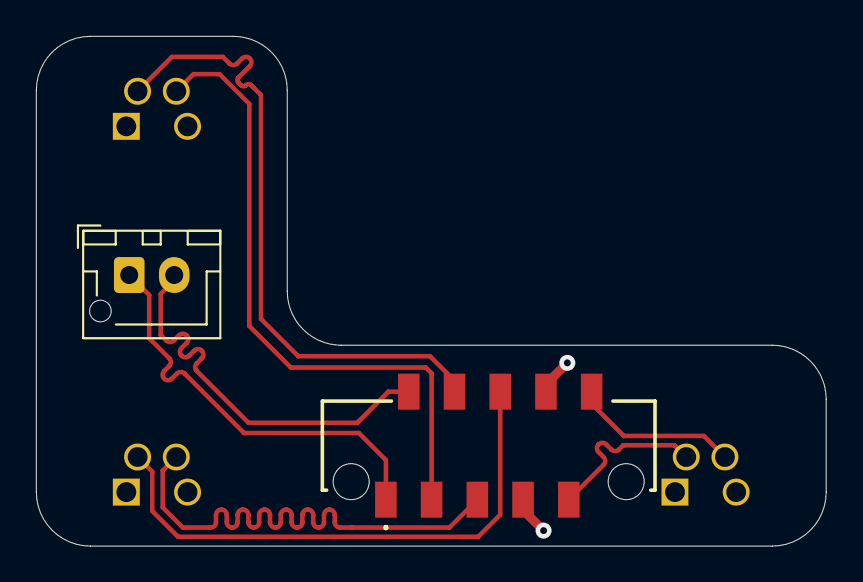
[picture p73: board serial_bulkhead.kicad_pcb from above]

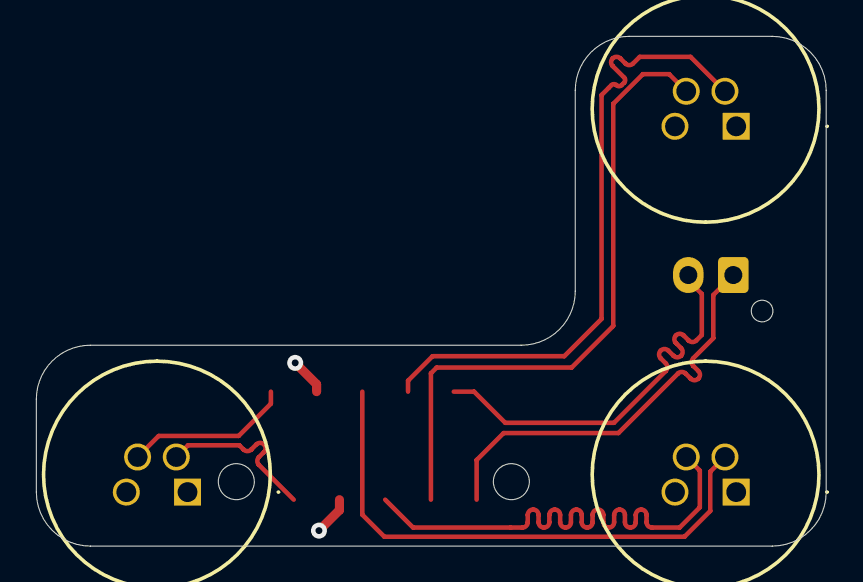
[picture p74: board serial_bulkhead.kicad_pcb from below]

Board: 4 copper layers, 43.9 x 28.3 mm, 5 parts (3 on the bottom side), 10 nets.
