BlueJayRacing/bjr_kicad/21xt/02-mainbox/mainbox2.1/mainbox2.1.kicad_pcb

## KiCad design 21xt/02-mainbox/mainbox2.1/mainbox2.1.kicad_pcb (2025-01-16)

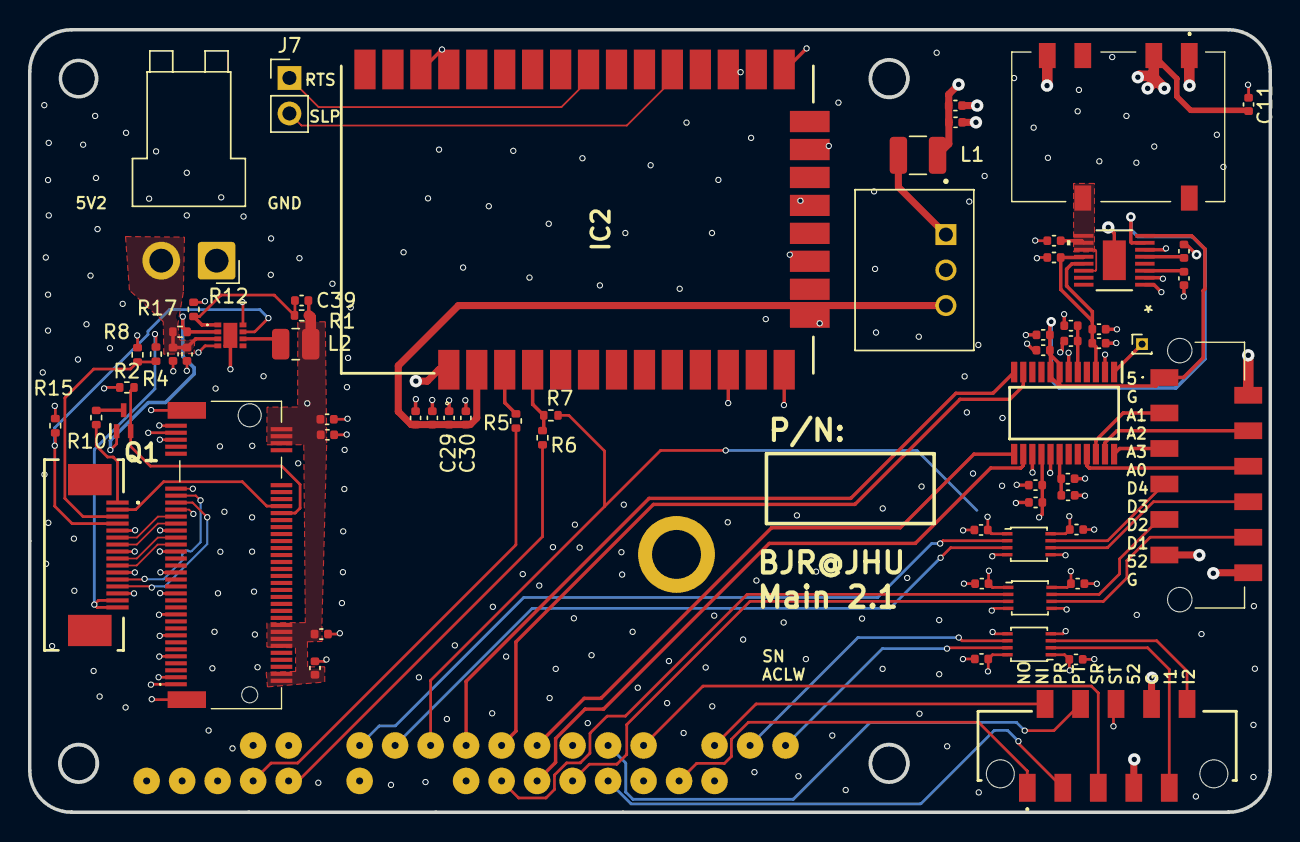
[picture p75: board mainbox2.1.kicad_pcb from above]

Board: 4 copper layers, 88.8 x 56.0 mm, 70 parts (1 on the bottom side), 62 nets.

Parts:
C1, C3, C5, C7, C10, C11, C14, C15, C16, C20, C21, C23, C27, C44, C45, C46: 0.1uF; C_0402_1005Metric
C2, C4, C8, C24: 1uF; C_0402_1005Metric
C6, C9, C25, C28, C36, C37, C40, C41, C42, C43: 10uF; C_0402_1005Metric
C26: 4.7uF; C_0402_1005Metric
C29: 47pF; C_0402_1005Metric
C30: 8.2pF; C_0402_1005Metric
C39: 15pF; C_0402_1005Metric
H1, H2, H3, H4: MountingHole; MountingHole_2.5mm
IC1, IC7, IC8: SN74LVC2T45DCTTG4; VSSOP-8_2.4x2.1mm_P0.5mm
IC2: XBP9X-DMUS-011; RLS397
IC6: AP3441LSHE-7B; AP3441LSHE7B
J1: Conn_01x10; 908160010
J3: Conn_01x16; ZF5S1601TWT
J4: Conn_01x01_Pin; PinHeader_1x01_P1.00mm_Vertical
J5: MDT275M02001
J6: Conn_01x02; JST_VH_B2PS-VH_1x02_P3.96mm_Horizontal
J7: Conn_01x02; PinHeader_1x02_P2.54mm_Vertical
J8: Conn_01x12; 908160012
J10: Conn_02x20_Odd_Even; PinHeader_2x20_P2.54mm_Vertical
L1: 3.9uH; L_1210_3225Metric
L2: 2.2uH; L_1008_2520Metric
PS1: R-78B3.3-1.5L; CONV_R-78B3.3-1.5
PS2: R2D12-0509; R2D120509
Q1: DMG1012T-7; SOT50P160X90-3N
R1, R17: 10k; R_0402_1005Metric
R2: 2.2k; R_0402_1005Metric
R4: 3k6; R_0402_1005Metric
R5, R6: 68; R_0402_1005Metric
R7, R15: 100k; R_0402_1005Metric
R8: 6k8; R_0402_1005Metric
R10: 33; R_0402_1005Metric
R12: 45k; R_0402_1005Metric
U1: AD7175-2BRUZ; SOP65P640X120-24N
U4: LT6658AHMSE-5-PBF; LT6658AHMSE-2.5-PBF
U$1: M.2-B+M-KEY

Connections:
3V3: C5.1, C6.1, C14.2, C16.2, C44.2, IC1.8 (VCCB), IC7.1 (VCCA), IC8.1 (VCCA), J10.17, R7.2, U1.16 (IOVDD)
3V3_PG: IC6.2 (PG), Q1.1 (G), R17.2
3V3_XBEE: C27.2, C28.2, C29.2, C30.2, IC2.2 (VCC), PS1.3 (+VOUT)
5.2V: C11.2, C15.2, C25.1, C26.1, C36.1, C37.1, C45.2, C46.2, IC1.1 (VCCA), IC6.3 (VIN), IC7.8 (VCCB), IC8.8 (VCCB), J1.7, J6.2, J8.11, J10.2, J10.4, L1.1, PS2.2 (+VIN), R17.1
5V PCIE: J3.15, J3.16, R4.1
5VADC/SENSOR: C7.2, C8.2, J8.1, U1.7 (AVDD1), U1.8 (AVDD2), U4.7 (VOUT2_S), U4.8 (VOUT2_F)
5VRef: C9.2, C10.2, C24.2, U1.3 (REF+), U4.12 (VOUT1_F), U4.13 (VOUT1_S)
9V: C23.1, PS2.7 (+VOUT), U4.9 (*OD), U4.10 (VIN2), U4.11 (VIN1), U4.14 (VIN)
ADC_SPI_DIN: J10.19, U1.12 (DIN)
ADC_SPI_DOUT: J10.21, U1.11 (DOUT/*RDY)
AIN0: J8.6, U1.21 (AIN0)
AIN1: J8.3, U1.22 (AIN1)
AIN2: J8.4, U1.23 (AIN2)
AIN3: J8.5, U1.24 (AIN3)
AIN4: J4.1, U1.1 (AIN4)
DIGITAL_INPUT_1: IC8.6 (B2), J8.10
DIGITAL_INPUT_2: IC8.7 (B1), J8.9
DIGITAL_INPUT_3: IC7.6 (B2), J8.8
DIGITAL_INPUT_4: IC7.7 (B1), J8.7
DIGITAL_OUTPUT_1: IC8.3 (A2), J10.26
DIGITAL_OUTPUT_2: IC8.2 (A1), J10.22
DIGITAL_OUTPUT_3: IC7.3 (A2), J10.15
DIGITAL_OUTPUT_4: IC7.2 (A1), J10.13
DINXBee: IC2.4 (DIN/DIO14/~CONFIG), R6.1, R7.1
DOUTXBee: IC2.3 (DIO13/DOUT), R5.2
GNDA: C1.2, C2.2, C3.1, C4.1, C5.2, C6.2, C7.1, C8.1, C9.1, C10.1, C11.1, C14.1, C15.1, C16.1, C20.1, C21.1, C23.2, C24.1, C25.2, C26.2, C27.1, C28.1, C29.1, C30.1, C36.2, C37.2, C40.2, C41.2, C42.2, C43.2, C44.1, C45.1, C46.1, IC1.4 (GND), IC1.5 (DIR), IC2.1 (GND_1), IC2.11 (GND_2), IC2.13 (GND_3), IC2.22 (GND_4), IC2.35 (GND_5), IC6.4 (PGND), IC6.8 (SGND), IC6.9 (EP), IC7.4 (GND), IC7.5 (DIR), IC8.4 (GND), IC8.5 (DIR), J1.8, J3.5, J3.8, J3.11, J3.14, J5.1, J5.3, J5.9, J5.15, J5.21, J5.27, J5.33, J5.39, J5.45, J5.51, J5.57, J5.71, J5.73, J5.75, J5.MP1, J5.MP2, J6.1, J8.2, J8.12, J10.6, J10.9, J10.14, J10.20, J10.25, J10.30, J10.34, PS1.2 (GND), PS2.1 (-VIN), PS2.5 (-VOUT), R2.1, R8.2, R12.1, R15.2, U1.2 (REF-), U1.6 (AVSS), U1.15 (*SYNC/*ERROR), U1.17 (DGND), U4.1 (GND), U4.2 (GND), U4.6 (GND), U4.EPAD
IN1(3.3V): IC1.7 (B1), J10.37
IN1(5V): IC1.2 (A1), J1.9
IN2(3.3V): IC1.6 (B2), J10.35
IN2(5V): IC1.3 (A2), J1.10
NAVIN: J1.2, J10.33
NAVOUT: J1.1, J10.32
unnamed: IC2.29 (DIO6/~RTS), J7.1
unnamed: IC2.26 (DIO9/ON/~SLEEP), J7.2
unnamed: C39.2, IC6.1 (FB), R1.2, R12.2
unnamed: IC6.6 (LX), L2.1
unnamed: J3.1, R10.1
unnamed: J10.8, R5.1
unnamed: J10.10, R6.2
unnamed: L1.2, PS1.1 (+VIN)
unnamed: C1.1, C2.1, U1.5 (REGCAPA)
unnamed: C3.2, C4.2, U1.18 (REGCAPD)
unnamed: C20.2, U4.3 (BYPASS)
unnamed: C21.2, U4.5 (NR)
PCIE0 RX+: J3.9, J5.43
PCIE0 RX-: J3.10, J5.41
PCIE0 TX+: J3.6, J5.49
PCIE0 TX-: J3.7, J5.47
PCIE CLK+: J3.12, J5.55
PCIE CLK-: J3.13, J5.53
PCIE_CLKREQ_N: J3.2, J5.52
PCIE_DET_WAKE: J3.3, R4.2, R8.1
PCIE_PWR_EN: IC6.7 (EN), J3.4, R15.1
PCIE_RST_B: Q1.3 (D), R10.2
PCIE_RST_B_SW: J5.50, Q1.2 (S), R2.2
POWER_BOARD_PORT_RXD: J1.3, J10.28
POWER_BOARD_PORT_TXD: J1.4, J10.27
RPi_SPI_CS: J10.24, U1.14 (*CS)
SCLK: J10.23, U1.13 (SCLK)
STEERING_WHEEL_PORT_RXD: J1.5, J10.29
STEERING_WHEEL_PORT_TXD: J1.6, J10.7
VCC3V3: C39.1, C40.1, C41.1, C42.1, C43.1, J5.2, J5.4, J5.12, J5.14, J5.16, J5.18, J5.70, J5.72, J5.74, L2.2, R1.1
