BlueJayRacing/bjr_kicad/21xt/01-accessory/accessory_v2/accessory_v2.kicad_pcb

## KiCad design 21xt/01-accessory/accessory_v2/accessory_v2.kicad_pcb (2025-01-14, an earlier design)

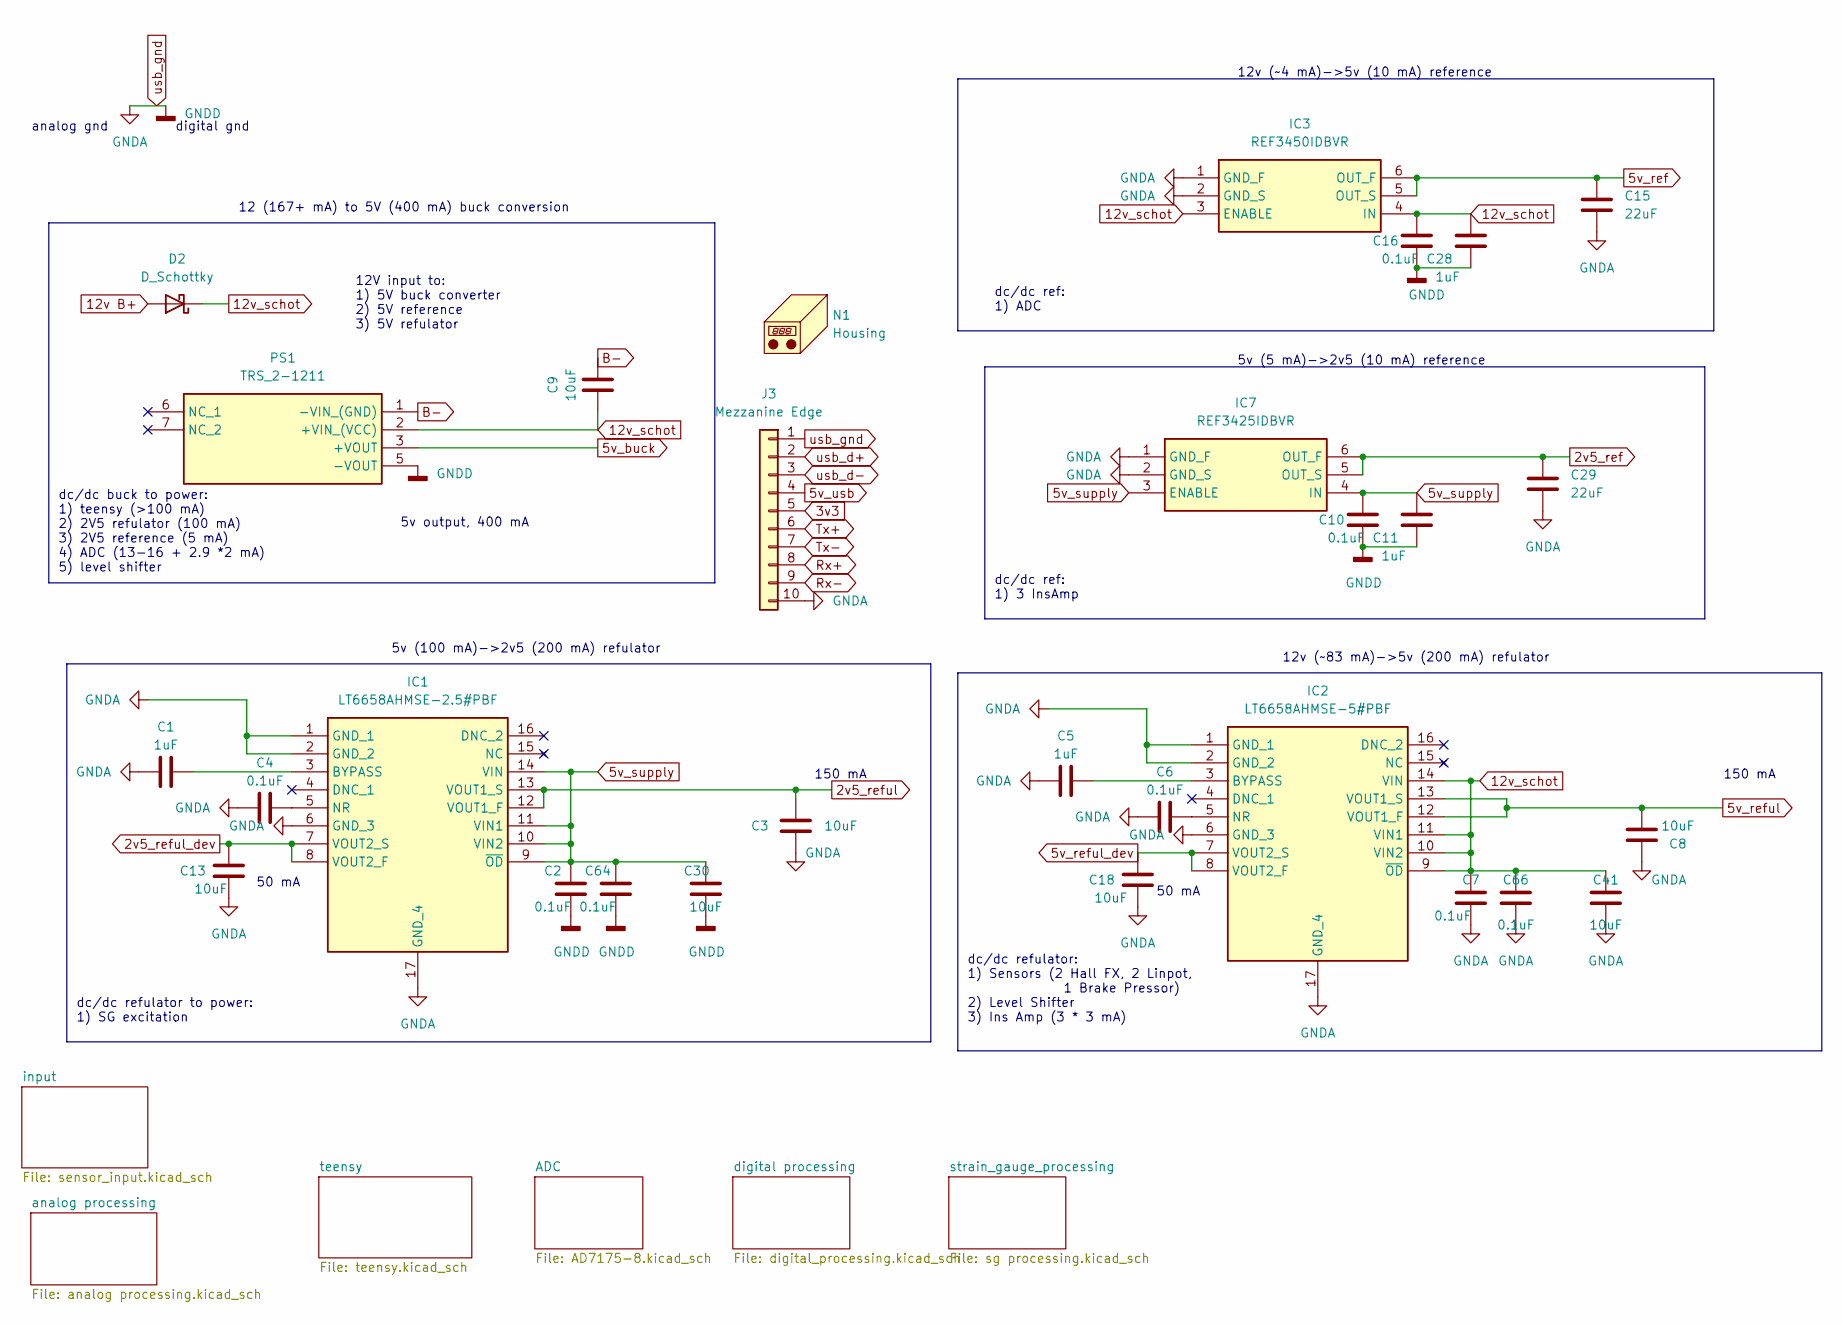
[picture p76: schematic accessory_v2.kicad_sch]

Parts:
C1, C5, C11, C28: 1uF; C_0402_1005Metric
C2, C4, C6, C7, C10, C16, C64, C66: 0.1uF; C_0402_1005Metric
C3, C8, C9, C13, C18, C30, C41: 10uF; C_0603_1608Metric
C15, C29: 22uF; C_0603_1608Metric
D2: D_Schottky; D_1206_3216Metric
IC1: LT6658AHMSE-2.5#PBF; SOP50P490X110-17N; Mouser Part Number 584-LT6658AHMSE5PBF
IC2: LT6658AHMSE-5#PBF; SOP50P490X110-17N; Mouser Part Number 584-LT6658AHMSE5PBF
IC3: REF3450IDBVR; Mouser Part Number 595-REF3450IDBVR
IC7: REF3425IDBVR; Mouser Part Number 595-REF3425IDBVR
J3: Mezzanine Edge; Double Sided Mezzanine Card Edge_Edge Side
N1: Housing
PS1: TRS_2-1211; CONV_TRS_2-2419; Mouser Part Number 495-TRS2-1211

Connections:
2v5_ref: C29.1, IC7.5 (OUT_S), IC7.6 (OUT_F); also elsewhere on the board
2v5_reful: C3.2, IC1.12 (VOUT1_F), IC1.13 (VOUT1_S); also elsewhere on the board
2v5_reful_dev: C13.2, IC1.7 (VOUT2_S), IC1.8 (VOUT2_F)
3v3: J3.5; also elsewhere on the board
5v_buck: PS1.3 (+VOUT); also elsewhere on the board
5v_ref: C15.1, IC3.5 (OUT_S), IC3.6 (OUT_F); also elsewhere on the board
5v_reful: C8.2, IC2.12 (VOUT1_F), IC2.13 (VOUT1_S); also elsewhere on the board
5v_reful_dev: C18.2, IC2.7 (VOUT2_S), IC2.8 (VOUT2_F); also elsewhere on the board
5v_supply: C2.2, C10.1, C11.1, C30.2, C64.2, IC1.9 (~OD), IC1.10 (VIN2), IC1.11 (VIN1), IC1.14 (VIN), IC7.3 (ENABLE), IC7.4 (IN); also elsewhere on the board
5v_usb: J3.4; also elsewhere on the board
12v B+: D2.2 (A); also elsewhere on the board
12v_schot: C7.2, C9.1, C16.1, C28.1, C41.2, C66.2, D2.1 (K), IC2.9 (~OD), IC2.10 (VIN2), IC2.11 (VIN1), IC2.14 (VIN), IC3.3 (ENABLE), IC3.4 (IN), PS1.2 (+VIN_(VCC))
B-: C9.2, PS1.1 (-VIN_(GND)); also elsewhere on the board
unnamed: C1.2, IC1.3 (BYPASS)
unnamed: C4.2, IC1.5 (NR)
unnamed: C5.2, IC2.3 (BYPASS)
unnamed: C6.2, IC2.5 (NR)
Rx+: J3.8; also elsewhere on the board
Rx-: J3.9; also elsewhere on the board
Tx+: J3.6; also elsewhere on the board
Tx-: J3.7; also elsewhere on the board
usb_d+: J3.2; also elsewhere on the board
usb_d-: J3.3; also elsewhere on the board
usb_gnd: C1.1, C2.1, C3.1, C4.1, C5.1, C6.1, C7.1, C8.1, C10.2, C11.2, C13.1, C15.2, C16.2, C18.1, C28.2, C29.2, C30.1, C41.1, C64.1, C66.1, IC1.1 (GND_1), IC1.2 (GND_2), IC1.6 (GND_3), IC1.17 (GND_4), IC2.1 (GND_1), IC2.2 (GND_2), IC2.6 (GND_3), IC2.17 (GND_4), IC3.1 (GND_F), IC3.2 (GND_S), IC7.1 (GND_F), IC7.2 (GND_S), J3.1, J3.10, PS1.5 (-VOUT); also elsewhere on the board

Notes on the sheet:
dc/dc refulator to power: 1) SG excitation
dc/dc ref: 1) 3 InsAmp
150 mA
50 mA
5v (5 mA)->2v5 (10 mA) reference
analog gnd
dc/dc ref: 1) ADC
12 (167+ mA) to 5V (400 mA) buck conversion
12V input to: 1) 5V buck converter 2) 5V reference 3) 5V refulator
5v (100 mA)->2v5 (200 mA) refulator
12v (~83 mA)->5v (200 mA) refulator
digital gnd
dc/dc refulator: 1) Sensors (2 Hall FX, 2 Linpot, 1 Brake Pressor) 2) Level Shifter 3) Ins Amp (3 * 3 mA)
dc/dc buck to power: 1) teensy (>100 mA) 2) 2V5 refulator (100 mA) 3) 2V5 reference (5 mA) 4) ADC (13-16 + 2.9 *2 mA) 5) level shifter
5v output, 400 mA
150 mA
12v (~4 mA)->5v (10 mA) reference
