BlueJayRacing/bjr_kicad/21xt/01-accessory/accessory_v2/accessory_v2.kicad_pcb

## KiCad design 21xt/01-accessory/accessory_v2/accessory_v2.kicad_pcb (continued)

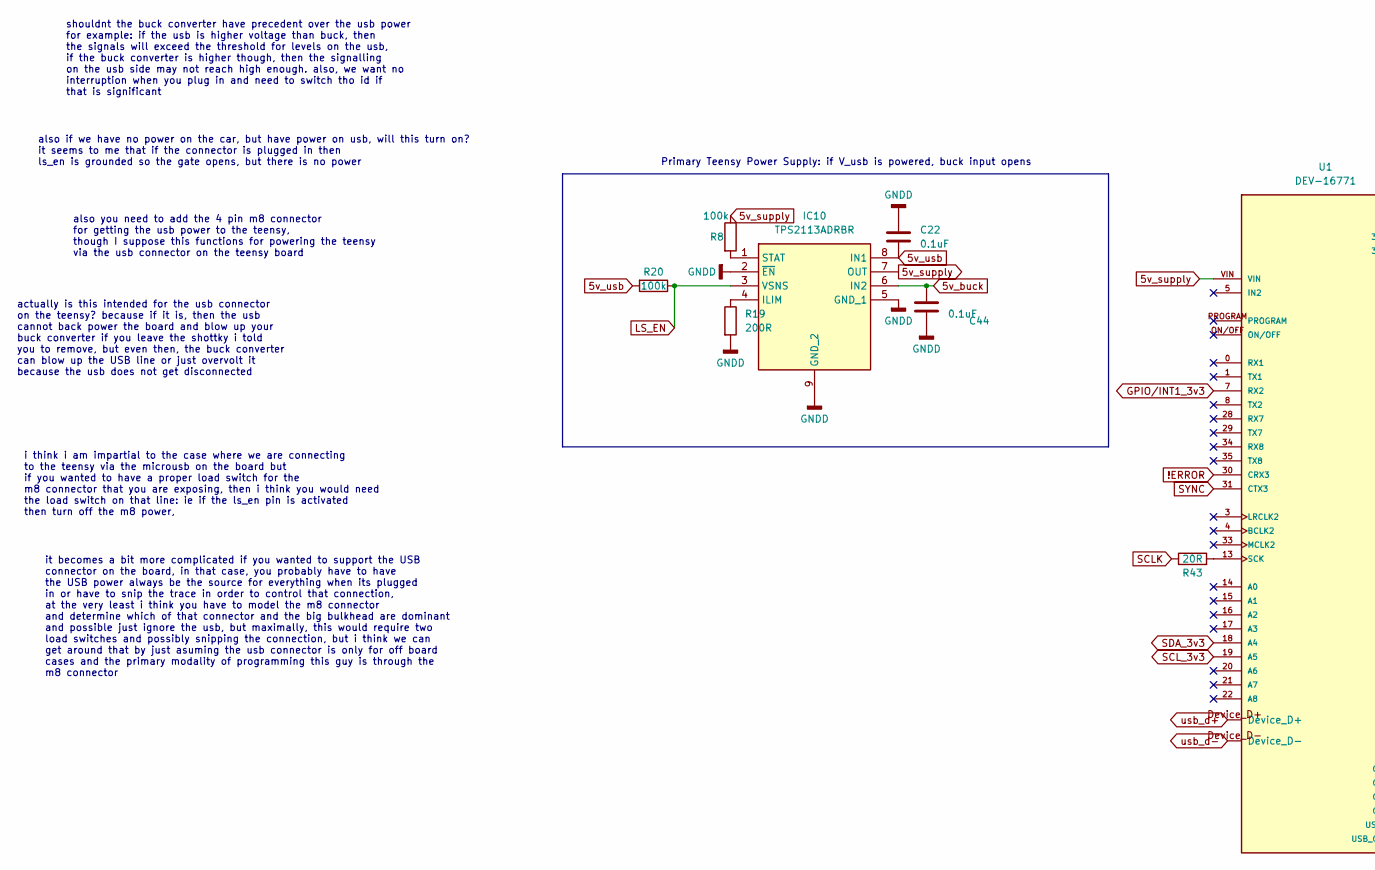
[picture p77: schematic teensy.kicad_sch, part in row 1, column 1]

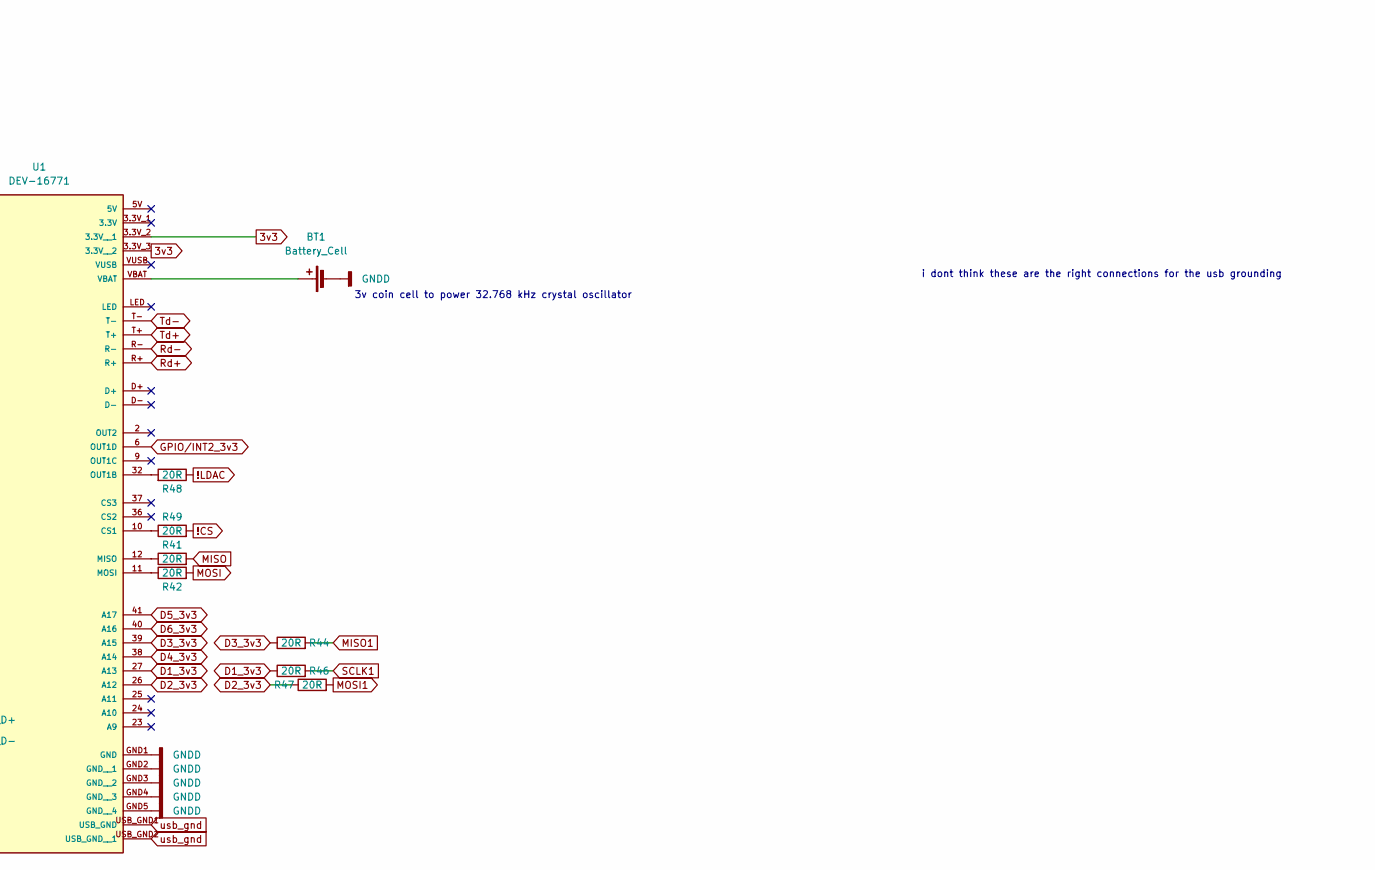
[picture p78: schematic teensy.kicad_sch, part in row 1, column 2]

Parts:
BT1: Battery_Cell; 1220 holder
C22, C44: 0.1uF; C_0402_1005Metric
IC10: TPS2113ADRBR; Mouser Part Number 595-TPS2113ADRBR
R8, R20: 100k; R_0402_1005Metric
R19: 200R; R_0402_1005Metric
R41, R42, R43, R44, R46, R47, R48, R49: 20R; R_0402_1005Metric
U1: DEV-16771; MODULE_DEV-16771; PARTREV 4.1

Connections:
3v3: U1.3.3V_2 (3.3V__1), U1.3.3V_3 (3.3V__2); also elsewhere on the board
5v_buck: C44.1, IC10.6 (IN2); also elsewhere on the board
5v_supply: IC10.7 (OUT), R8.1, U1.VIN; also elsewhere on the board
5v_usb: C22.2, IC10.8 (IN1), R20.2; also elsewhere on the board
!CS: R49.2; also elsewhere on the board
!ERROR: U1.30 (CRX3); also elsewhere on the board
!LDAC: R48.1; also elsewhere on the board
D1_3v3: R46.1, U1.27 (A13); also elsewhere on the board
D2_3v3: R47.1, U1.26 (A12); also elsewhere on the board
D3_3v3: R44.1, U1.39 (A15); also elsewhere on the board
D4_3v3: U1.38 (A14); also elsewhere on the board
D5_3v3: U1.41 (A17); also elsewhere on the board
D6_3v3: U1.40 (A16); also elsewhere on the board
GPIO/INT1_3v3: U1.7 (RX2); also elsewhere on the board
GPIO/INT2_3v3: U1.6 (OUT1D); also elsewhere on the board
LS_EN: IC10.3 (VSNS), R20.1; also elsewhere on the board
MISO: R41.2; also elsewhere on the board
MISO1: R44.2; also elsewhere on the board
MOSI: R42.2; also elsewhere on the board
MOSI1: R47.2; also elsewhere on the board
unnamed: BT1.1 (+), U1.VBAT
unnamed: IC10.4 (ILIM), R19.1
unnamed: IC10.1 (STAT), R8.2
unnamed: R49.1, U1.10 (CS1)
unnamed: R41.1, U1.12 (MISO)
unnamed: R42.1, U1.11 (MOSI)
unnamed: R48.2, U1.32 (OUT1B)
unnamed: R43.2, U1.13 (SCK)
Rd+: U1.R+; also elsewhere on the board
Rd-: U1.R-; also elsewhere on the board
SCLK: R43.1; also elsewhere on the board
SCLK1: R46.2; also elsewhere on the board
SCL_3v3: U1.19 (A5); also elsewhere on the board
SDA_3v3: U1.18 (A4); also elsewhere on the board
SYNC: U1.31 (CTX3); also elsewhere on the board
Td+: U1.T+; also elsewhere on the board
Td-: U1.T-; also elsewhere on the board
usb_d+: U1.Device_D+; also elsewhere on the board
usb_d-: U1.Device_D-; also elsewhere on the board
usb_gnd: BT1.2 (-), C22.1, C44.2, IC10.2 (~EN), IC10.5 (GND_1), IC10.9 (GND_2), R19.2, U1.GND1 (GND), U1.GND2 (GND__1), U1.GND3 (GND__2), U1.GND4 (GND__3), U1.GND5 (GND__4), U1.USB_GND1 (USB_GND), U1.USB_GND2 (USB_GND__1); also elsewhere on the board

Notes on the sheet:
Primary Teensy Power Supply: if V_usb is powered, buck input opens
3v coin cell to power 32.768 kHz crystal oscillator
it becomes a bit more complicated if you wanted to support the USB connector on the board, in that case, you probably have to have the USB power always be the source for everything when its plugged in or have to snip the trace in order to control that connection, at the very least i think you have 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
shouldnt the buck converter have precedent over the usb power for example: if the usb is higher voltage than buck, then the signals will exceed the threshold for levels on the usb, if the buck converter is higher though, then the signalling on the usb side may not reach high enough. also, we want n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
actually is this intended for the usb connector on the teensy? because if it is, then the usb cannot back power the board and blow up your buck converter if you leave the shottky i told you to remove, but even then, the buck converter can blow up the USB line or just overvolt it because the usb doe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
also you need to add the 4 pin m8 connector for getting the usb power to the teensy, though I suppose this functions for powering the teensy via the usb connector on the teensy board
i think i am impartial to the case where we are connecting to the teensy via the microusb on the board but if you wanted to have a proper load switch for the m8 connector that you are exposing, then i think you would need the load switch on that line: ie if the ls_en pin is activated then turn off 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
i dont think these are the right connections for the usb grounding
also if we have no power on the car, but have power on usb, will this turn on? it seems to me that if the connector is plugged in then ls_en is grounded so the gate opens, but there is no power

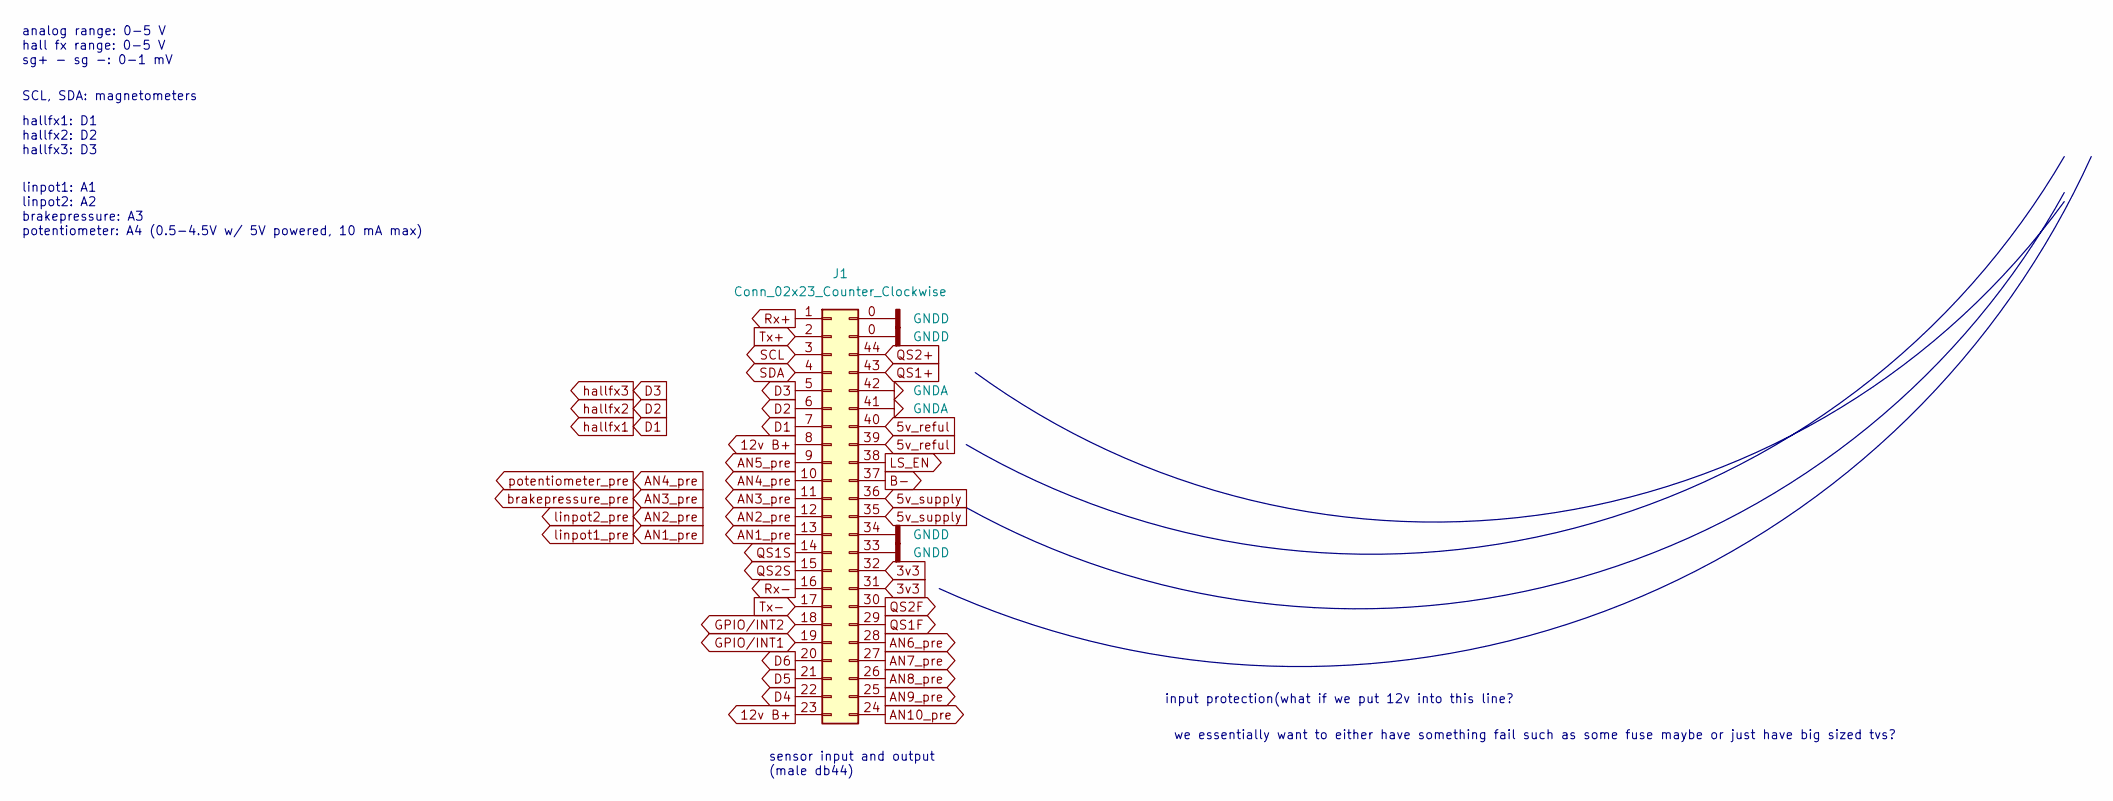
[picture p79: schematic sensor_input.kicad_sch]

Parts:
J1: Conn_02x23_Counter_Clockwise; aaren_mouser_db44_screws

Connections:
2v5_reful: J1.43, J1.44; also elsewhere on the board
3v3: J1.31, J1.32; also elsewhere on the board
5v_reful: J1.39, J1.40; also elsewhere on the board
5v_supply: J1.35, J1.36; also elsewhere on the board
12v B+: J1.8, J1.23; also elsewhere on the board
AN1_pre: J1.13; also elsewhere on the board
AN2_pre: J1.12; also elsewhere on the board
AN3_pre: J1.11; also elsewhere on the board
AN4_pre: J1.10; also elsewhere on the board
AN5_pre: J1.9; also elsewhere on the board
AN6_pre: J1.28; also elsewhere on the board
AN7_pre: J1.27; also elsewhere on the board
AN8_pre: J1.26; also elsewhere on the board
AN9_pre: J1.25; also elsewhere on the board
AN10_pre: J1.24; also elsewhere on the board
B-: J1.37; also elsewhere on the board
D1: J1.7; also elsewhere on the board
D2: J1.6; also elsewhere on the board
D3: J1.5; also elsewhere on the board
D4: J1.22; also elsewhere on the board
D5: J1.21; also elsewhere on the board
D6: J1.20; also elsewhere on the board
GPIO/INT1: J1.19; also elsewhere on the board
GPIO/INT2: J1.18; also elsewhere on the board
LS_EN: J1.38; also elsewhere on the board
QS1F: J1.29; also elsewhere on the board
QS1S: J1.14; also elsewhere on the board
QS2F: J1.30; also elsewhere on the board
QS2S: J1.15; also elsewhere on the board
Rx+: J1.1; also elsewhere on the board
Rx-: J1.16; also elsewhere on the board
SCL: J1.3; also elsewhere on the board
SDA: J1.4; also elsewhere on the board
Tx+: J1.2; also elsewhere on the board
Tx-: J1.17; also elsewhere on the board
usb_gnd: J1.0 (Pin_45), J1.33, J1.34, J1.41, J1.42; also elsewhere on the board

Notes on the sheet:
SCL, SDA: magnetometers
sensor input and output (male db44)
analog range: 0-5 V hall fx range: 0-5 V sg+ - sg -: 0-1 mV
linpot1: A1 linpot2: A2 brakepressure: A3 potentiometer: A4 (0.5-4.5V w/ 5V powered, 10 mA max)
we essentially want to either have something fail such as some fuse maybe or just have big sized tvs?
hallfx1: D1 hallfx2: D2 hallfx3: D3
input protection(what if we put 12v into this line?

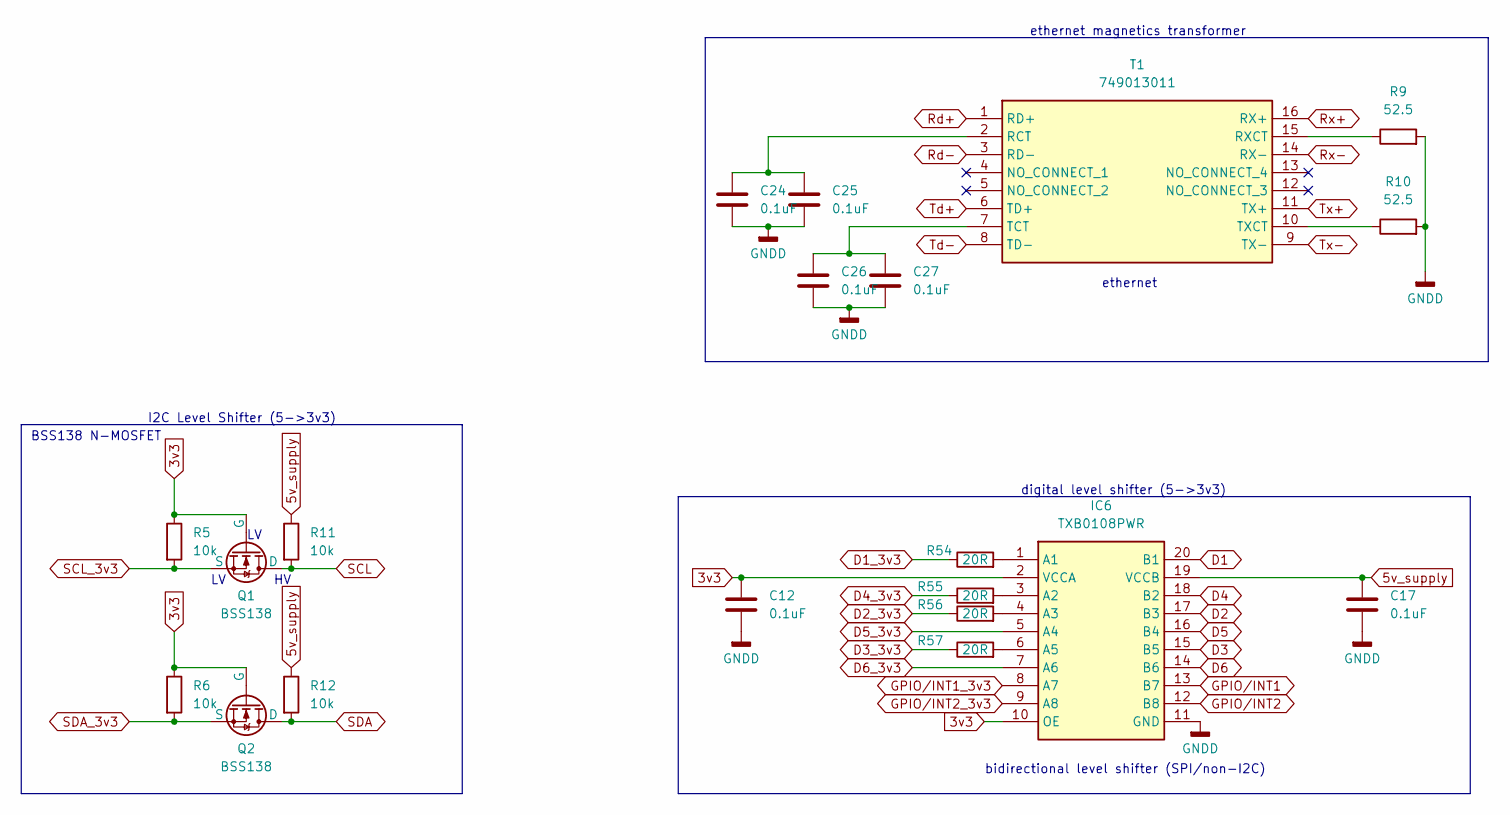
[picture p80: schematic digital_processing.kicad_sch]

Parts:
C12, C17, C24, C25, C26, C27: 0.1uF; C_0402_1005Metric
IC6: TXB0108PWR; SOP65P640X120-20N; Mouser Part Number 595-TXB0108PWR
Q1, Q2: BSS138; SOT-23-3
R5, R6, R11, R12: 10k; R_0402_1005Metric
R9, R10: 52.5; R_0402_1005Metric
R54, R55, R56, R57: 20R; R_0402_1005Metric
T1: 749013011; Mouser Part Number 710-749013011

Connections:
3v3: C12.1, IC6.2 (VCCA), IC6.10 (OE), Q1.2 (G), Q2.2 (G), R5.1, R6.1; also elsewhere on the board
5v_supply: C17.1, IC6.19 (VCCB), R11.1, R12.1; also elsewhere on the board
D1: IC6.20 (B1); also elsewhere on the board
D1_3v3: R54.1; also elsewhere on the board
D2: IC6.17 (B3); also elsewhere on the board
D2_3v3: R56.1; also elsewhere on the board
D3: IC6.15 (B5); also elsewhere on the board
D3_3v3: R57.1; also elsewhere on the board
D4: IC6.18 (B2); also elsewhere on the board
D4_3v3: R55.1; also elsewhere on the board
D5: IC6.16 (B4); also elsewhere on the board
D5_3v3: IC6.5 (A4); also elsewhere on the board
D6: IC6.14 (B6); also elsewhere on the board
D6_3v3: IC6.7 (A6); also elsewhere on the board
GPIO/INT1: IC6.13 (B7); also elsewhere on the board
GPIO/INT1_3v3: IC6.8 (A7); also elsewhere on the board
GPIO/INT2: IC6.12 (B8); also elsewhere on the board
GPIO/INT2_3v3: IC6.9 (A8); also elsewhere on the board
unnamed: IC6.1 (A1), R54.2
unnamed: IC6.3 (A2), R55.2
unnamed: IC6.4 (A3), R56.2
unnamed: IC6.6 (A5), R57.2
unnamed: C24.1, C25.1, T1.2 (RCT)
unnamed: R9.1, T1.15 (RXCT)
unnamed: C26.1, C27.1, T1.7 (TCT)
unnamed: R10.1, T1.10 (TXCT)
Rd+: T1.1 (RD+); also elsewhere on the board
Rd-: T1.3 (RD-); also elsewhere on the board
Rx+: T1.16 (RX+); also elsewhere on the board
Rx-: T1.14 (RX-); also elsewhere on the board
SCL: Q1.1 (D), R11.2; also elsewhere on the board
SCL_3v3: Q1.3 (S), R5.2; also elsewhere on the board
SDA: Q2.1 (D), R12.2; also elsewhere on the board
SDA_3v3: Q2.3 (S), R6.2; also elsewhere on the board
Td+: T1.6 (TD+); also elsewhere on the board
Td-: T1.8 (TD-); also elsewhere on the board
Tx+: T1.11 (TX+); also elsewhere on the board
Tx-: T1.9 (TX-); also elsewhere on the board
usb_gnd: C12.2, C17.2, C24.2, C25.2, C26.2, C27.2, IC6.11 (GND), R9.2, R10.2; also elsewhere on the board

Notes on the sheet:
I2C Level Shifter (5->3v3)
ethernet magnetics transformer
digital level shifter (5->3v3)
bidirectional level shifter (SPI/non-I2C)
BSS138 N-MOSFET
ethernet

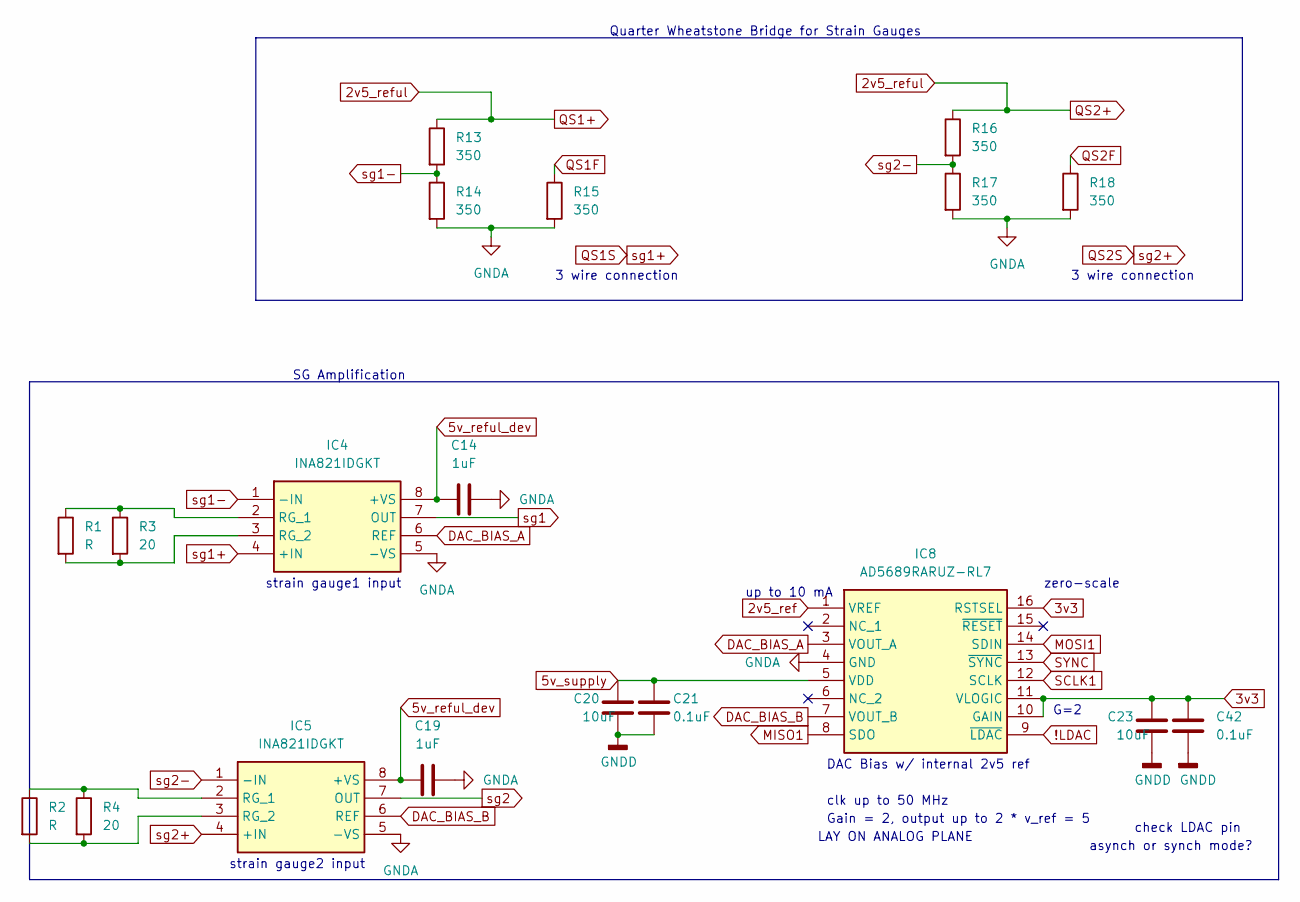
[picture p81: schematic sg processing.kicad_sch]

Parts:
C14, C19: 1uF; C_0402_1005Metric
C20, C23: 10uF; C_0603_1608Metric
C21, C42: 0.1uF; C_0402_1005Metric
IC4, IC5: INA821IDGKT; SOP65P490X110-8N; Mouser Part Number 595-INA821IDGKT
IC8: AD5689RARUZ-RL7; SOP65P640X120-16N; Mouser Part Number 584-AD5689RARUZ-R7
R1, R2: R; R_0402_1005Metric
R3, R4: 20; R_0402_1005Metric
R13, R14, R15, R16, R17, R18: 350; R_0402_1005Metric

Connections:
2v5_ref: IC8.1 (VREF); also elsewhere on the board
2v5_reful: R13.1, R16.1; also elsewhere on the board
3v3: C23.1, C42.1, IC8.10 (GAIN), IC8.11 (VLOGIC), IC8.16 (RSTSEL); also elsewhere on the board
5v_reful_dev: C14.1, C19.1, IC4.8 (+VS), IC5.8 (+VS); also elsewhere on the board
5v_supply: C20.1, C21.1, IC8.5 (VDD); also elsewhere on the board
!LDAC: IC8.9 (~LDAC); also elsewhere on the board
DAC_BIAS_A: IC4.6 (REF), IC8.3 (VOUT_A)
DAC_BIAS_B: IC5.6 (REF), IC8.7 (VOUT_B)
MISO1: IC8.8 (SDO); also elsewhere on the board
MOSI1: IC8.14 (SDIN); also elsewhere on the board
unnamed: IC4.2 (RG_1), R1.1, R3.1
unnamed: IC4.3 (RG_2), R1.2, R3.2
unnamed: IC5.2 (RG_1), R2.1, R4.1
unnamed: IC5.3 (RG_2), R2.2, R4.2
QS1F: R15.1; also elsewhere on the board
QS1S: IC4.4 (+IN); also elsewhere on the board
QS2F: R18.1; also elsewhere on the board
QS2S: IC5.4 (+IN); also elsewhere on the board
SCLK1: IC8.12 (SCLK); also elsewhere on the board
SYNC: IC8.13 (~SYNC); also elsewhere on the board
sg1: IC4.7 (OUT); also elsewhere on the board
sg1-: IC4.1 (-IN), R13.2, R14.1
sg2: IC5.7 (OUT); also elsewhere on the board
sg2-: IC5.1 (-IN), R16.2, R17.1
usb_gnd: C14.2, C19.2, C20.2, C21.2, C23.2, C42.2, IC4.5 (-VS), IC5.5 (-VS), IC8.4 (GND), R14.2, R15.2, R17.2, R18.2; also elsewhere on the board

Notes on the sheet:
clk up to 50 MHz
check LDAC pin
LAY ON ANALOG PLANE
Gain = 2, output up to 2 * v_ref = 5
SG Amplification
strain gauge2 input
zero-scale
asynch or synch mode?
3 wire connection
up to 10 mA
Quarter Wheatstone Bridge for Strain Gauges
DAC Bias w/ internal 2v5 ref
G=2
strain gauge1 input

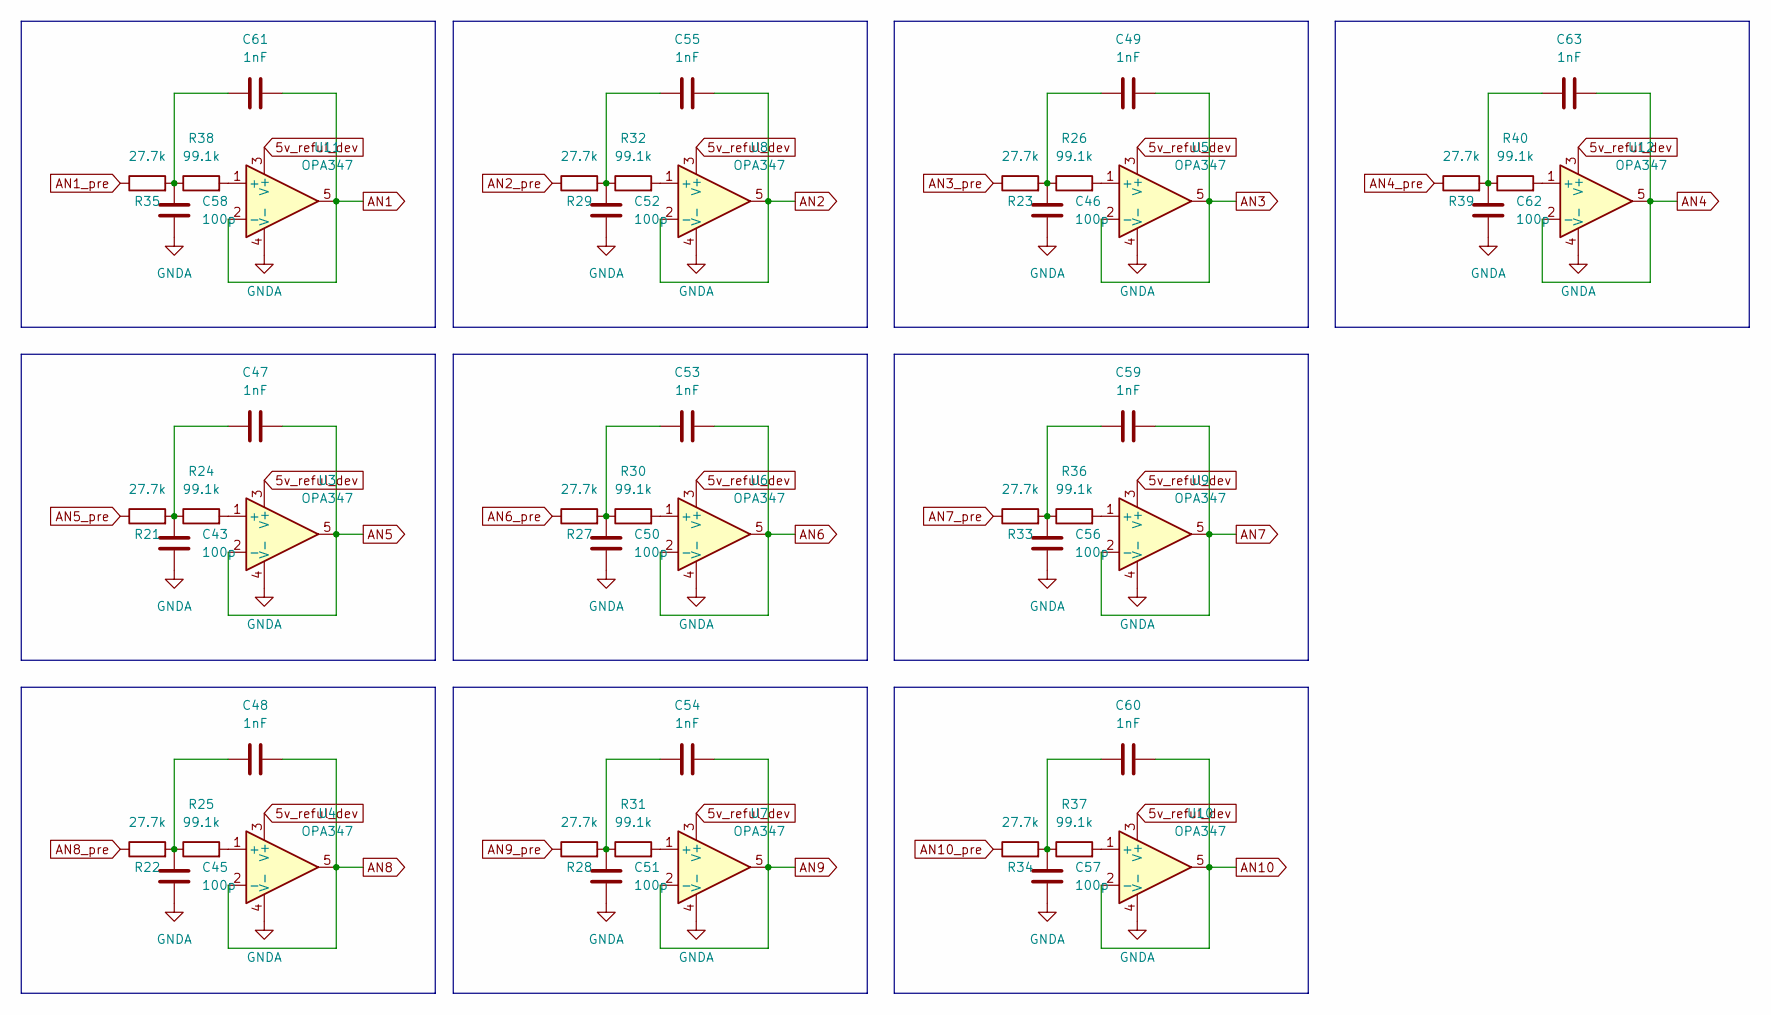
[picture p82: schematic analog processing.kicad_sch]

Parts:
C43, C45, C46, C50, C51, C52, C56, C57, C58, C62: 100p; C_0402_1005Metric
C47, C48, C49, C53, C54, C55, C59, C60, C61, C63: 1nF; C_0402_1005Metric
R21, R22, R23, R27, R28, R29, R33, R34, R35, R39: 27.7k; R_0402_1005Metric
R24, R25, R26, R30, R31, R32, R36, R37, R38, R40: 99.1k; R_0402_1005Metric
U3, U4, U5, U6, U7, U8, U9, U10, U11, U12: OPA347; SOT-23-5

Connections:
5v_reful_dev: U3.3 (V+), U4.3 (V+), U5.3 (V+), U6.3 (V+), U7.3 (V+), U8.3 (V+), U9.3 (V+), U10.3 (V+), U11.3 (V+), U12.3 (V+); also elsewhere on the board
AN1: C61.2, U11.2 (-), U11.5; also elsewhere on the board
AN1_pre: R35.1; also elsewhere on the board
AN2: C55.2, U8.2 (-), U8.5; also elsewhere on the board
AN2_pre: R29.1; also elsewhere on the board
AN3: C49.2, U5.2 (-), U5.5; also elsewhere on the board
AN3_pre: R23.1; also elsewhere on the board
AN4: C63.2, U12.2 (-), U12.5; also elsewhere on the board
AN4_pre: R39.1; also elsewhere on the board
AN5: C47.2, U3.2 (-), U3.5; also elsewhere on the board
AN5_pre: R21.1; also elsewhere on the board
AN6: C53.2, U6.2 (-), U6.5; also elsewhere on the board
AN6_pre: R27.1; also elsewhere on the board
AN7: C59.2, U9.2 (-), U9.5; also elsewhere on the board
AN7_pre: R33.1; also elsewhere on the board
AN8: C48.2, U4.2 (-), U4.5; also elsewhere on the board
AN8_pre: R22.1; also elsewhere on the board
AN9: C54.2, U7.2 (-), U7.5; also elsewhere on the board
AN9_pre: R28.1; also elsewhere on the board
AN10: C60.2, U10.2 (-), U10.5; also elsewhere on the board
AN10_pre: R34.1; also elsewhere on the board
unnamed: C43.1, C47.1, R21.2, R24.1
unnamed: C45.1, C48.1, R22.2, R25.1
unnamed: C46.1, C49.1, R23.2, R26.1
unnamed: C50.1, C53.1, R27.2, R30.1
unnamed: C51.1, C54.1, R28.2, R31.1
unnamed: C52.1, C55.1, R29.2, R32.1
unnamed: C56.1, C59.1, R33.2, R36.1
unnamed: C57.1, C60.1, R34.2, R37.1
unnamed: C58.1, C61.1, R35.2, R38.1
unnamed: C62.1, C63.1, R39.2, R40.1
unnamed: R24.2, U3.1 (+)
unnamed: R25.2, U4.1 (+)
unnamed: R26.2, U5.1 (+)
unnamed: R30.2, U6.1 (+)
unnamed: R31.2, U7.1 (+)
unnamed: R32.2, U8.1 (+)
unnamed: R36.2, U9.1 (+)
unnamed: R37.2, U10.1 (+)
unnamed: R38.2, U11.1 (+)
unnamed: R40.2, U12.1 (+)
usb_gnd: C43.2, C45.2, C46.2, C50.2, C51.2, C52.2, C56.2, C57.2, C58.2, C62.2, U3.4 (V-), U4.4 (V-), U5.4 (V-), U6.4 (V-), U7.4 (V-), U8.4 (V-), U9.4 (V-), U10.4 (V-), U11.4 (V-), U12.4 (V-); also elsewhere on the board

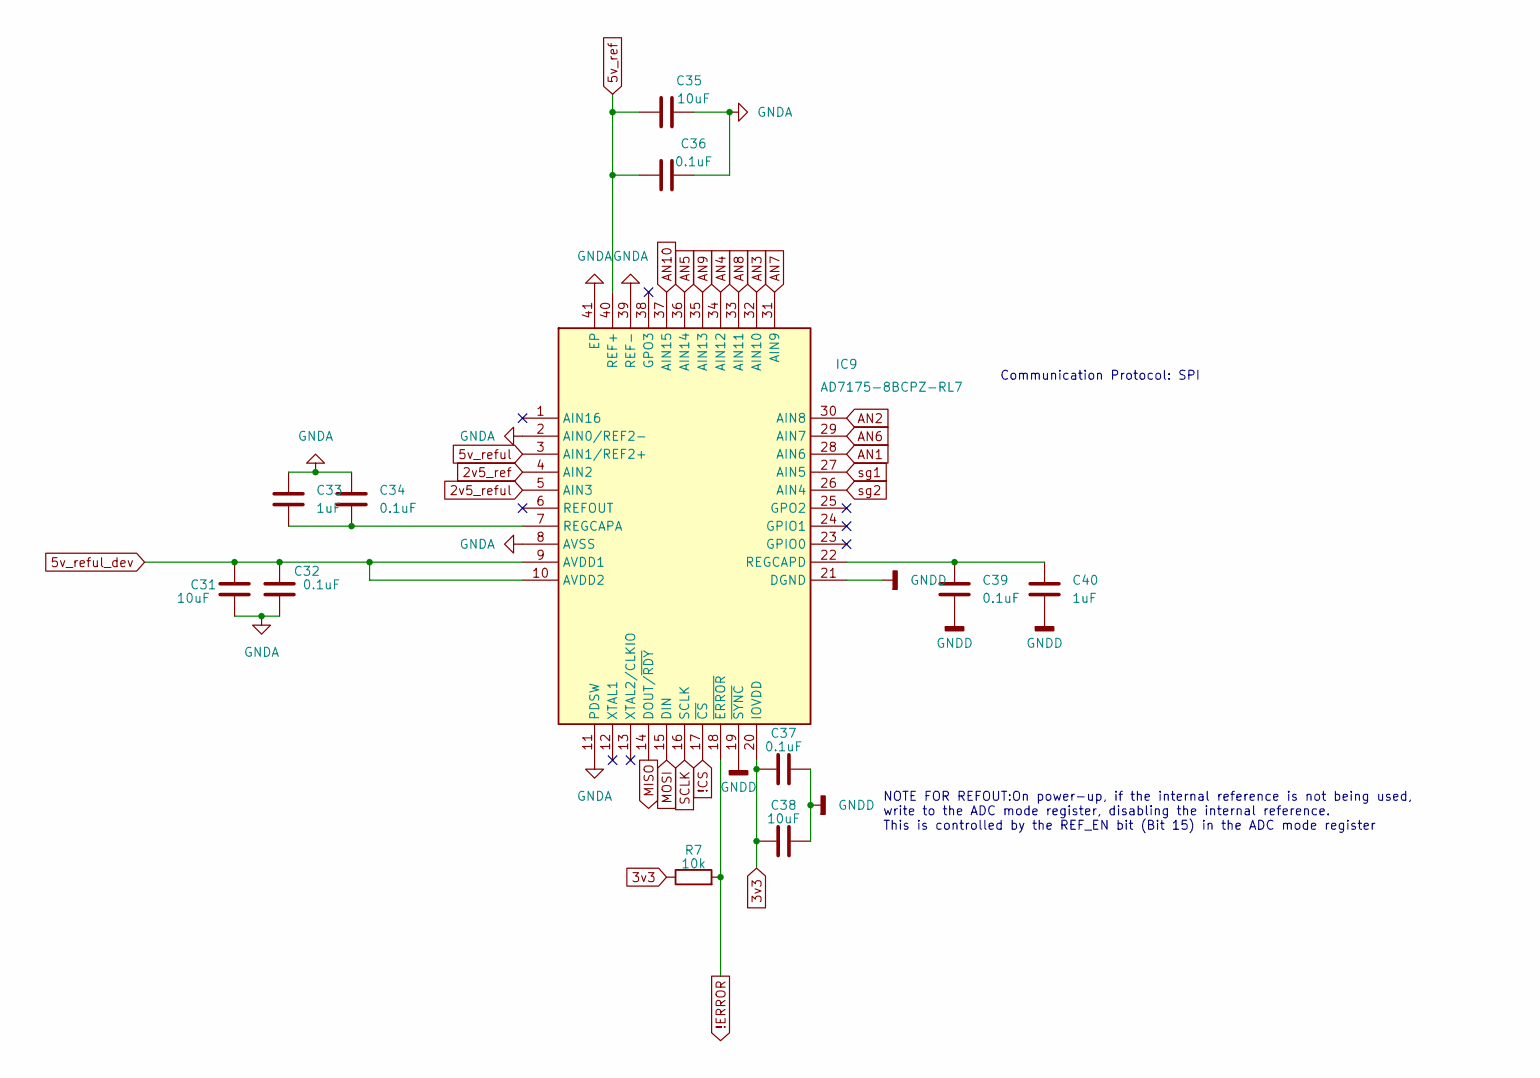
[picture p83: schematic AD7175-8.kicad_sch]

Parts:
C31, C35, C38: 10uF; C_0603_1608Metric
C32, C34, C36, C37, C39: 0.1uF; C_0402_1005Metric
C33, C40: 1uF; C_0402_1005Metric
IC9: AD7175-8BCPZ-RL7; Mouser Part Number 584-AD7175-8BCPZ-RL7
R7: 10k; R_0402_1005Metric

Connections:
2v5_ref: IC9.4 (AIN2); also elsewhere on the board
2v5_reful: IC9.5 (AIN3); also elsewhere on the board
3v3: C37.1, C38.1, IC9.20 (IOVDD), R7.1; also elsewhere on the board
5v_ref: C35.1, C36.1, IC9.40 (REF+); also elsewhere on the board
5v_reful: IC9.3 (AIN1/REF2+); also elsewhere on the board
5v_reful_dev: C31.1, C32.1, IC9.9 (AVDD1), IC9.10 (AVDD2); also elsewhere on the board
!CS: IC9.17 (~CS); also elsewhere on the board
!ERROR: IC9.18 (~ERROR), R7.2; also elsewhere on the board
AN1: IC9.28 (AIN6); also elsewhere on the board
AN2: IC9.30 (AIN8); also elsewhere on the board
AN3: IC9.32 (AIN10); also elsewhere on the board
AN4: IC9.34 (AIN12); also elsewhere on the board
AN5: IC9.36 (AIN14); also elsewhere on the board
AN6: IC9.29 (AIN7); also elsewhere on the board
AN7: IC9.31 (AIN9); also elsewhere on the board
AN8: IC9.33 (AIN11); also elsewhere on the board
AN9: IC9.35 (AIN13); also elsewhere on the board
AN10: IC9.37 (AIN15); also elsewhere on the board
MISO: IC9.14 (DOUT/~RDY); also elsewhere on the board
MOSI: IC9.15 (DIN); also elsewhere on the board
unnamed: C33.2, C34.2, IC9.7 (REGCAPA)
unnamed: C39.1, C40.1, IC9.22 (REGCAPD)
SCLK: IC9.16 (SCLK); also elsewhere on the board
sg1: IC9.27 (AIN5); also elsewhere on the board
sg2: IC9.26 (AIN4); also elsewhere on the board
usb_gnd: C31.2, C32.2, C33.1, C34.1, C35.2, C36.2, C37.2, C38.2, C39.2, C40.2, IC9.2 (AIN0/REF2-), IC9.8 (AVSS), IC9.11 (PDSW), IC9.19 (~SYNC), IC9.21 (DGND), IC9.39 (REF-), IC9.41 (EP); also elsewhere on the board

Notes on the sheet:
NOTE FOR REFOUT:On power-up, if the internal reference is not being used, write to the ADC mode register, disabling the internal reference. This is controlled by the REF_EN bit (Bit 15) in the ADC mode register
Communication Protocol: SPI

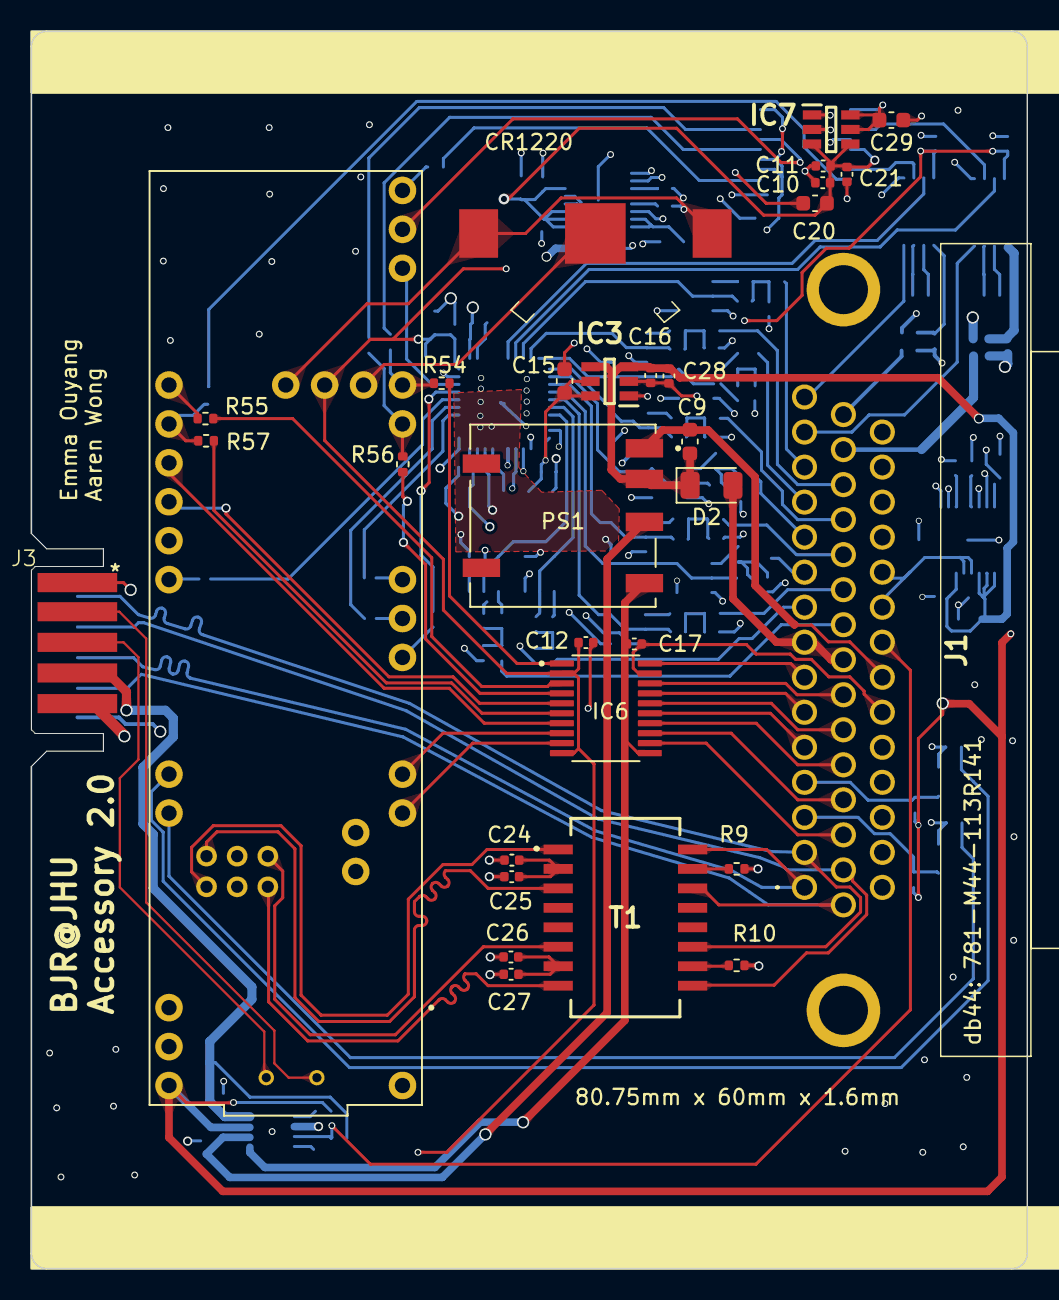
[picture p84: board accessory_v2.kicad_pcb from above]

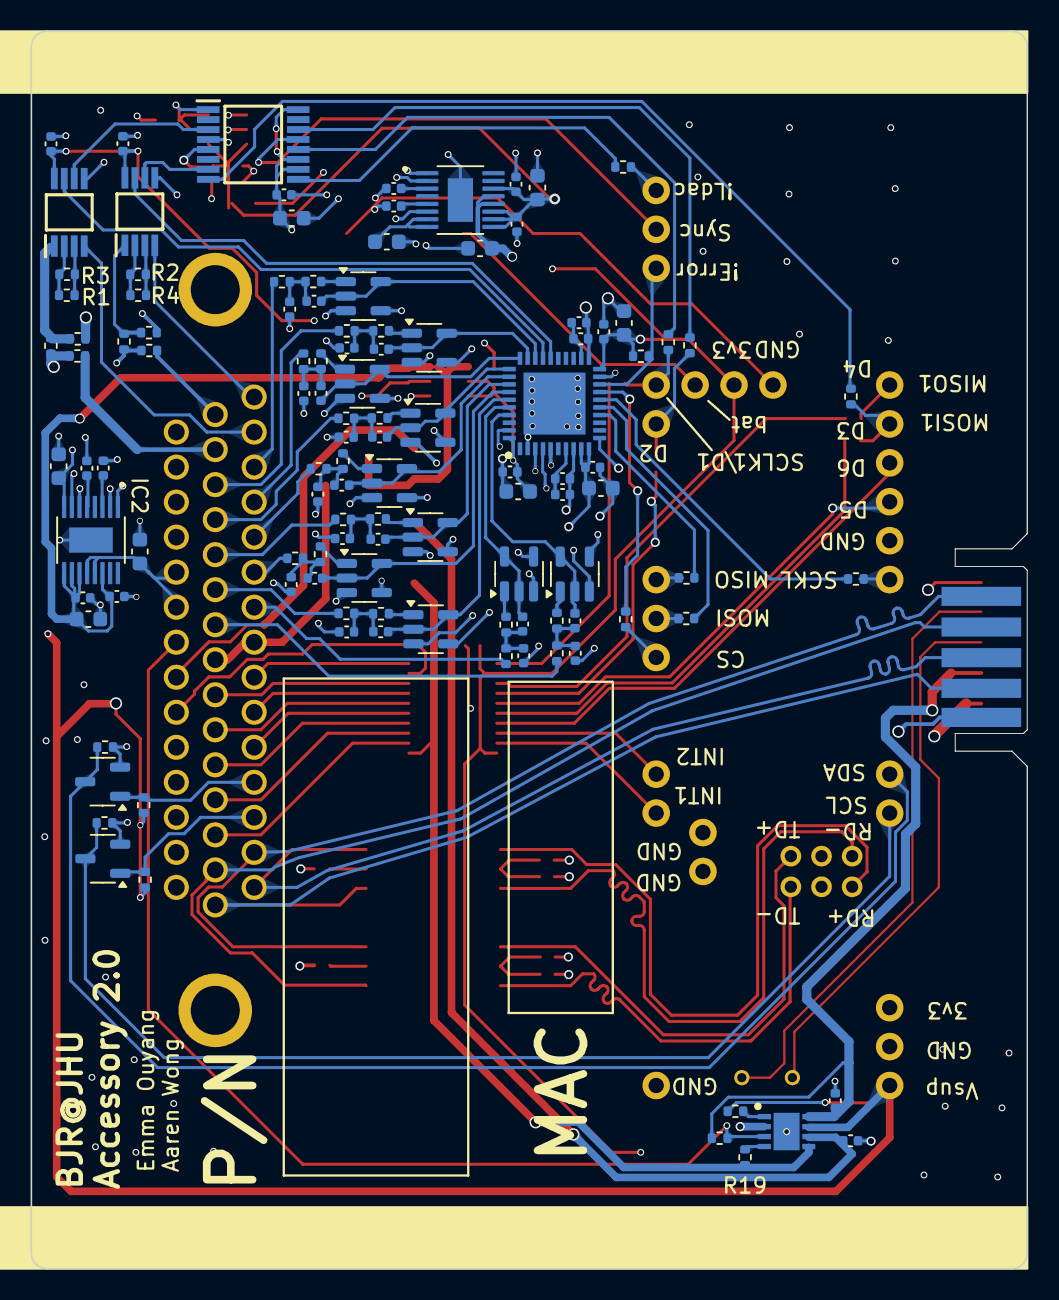
[picture p85: board accessory_v2.kicad_pcb from below]

Board: 4 copper layers, 65.0 x 80.8 mm, 146 parts (115 on the bottom side), 131 nets.
