BlueJayRacing/bjr_kicad/21xt/big_hbridge/big_hbridge.kicad_pcb

## KiCad design 21xt/big_hbridge/big_hbridge.kicad_pcb (2025-01-08)

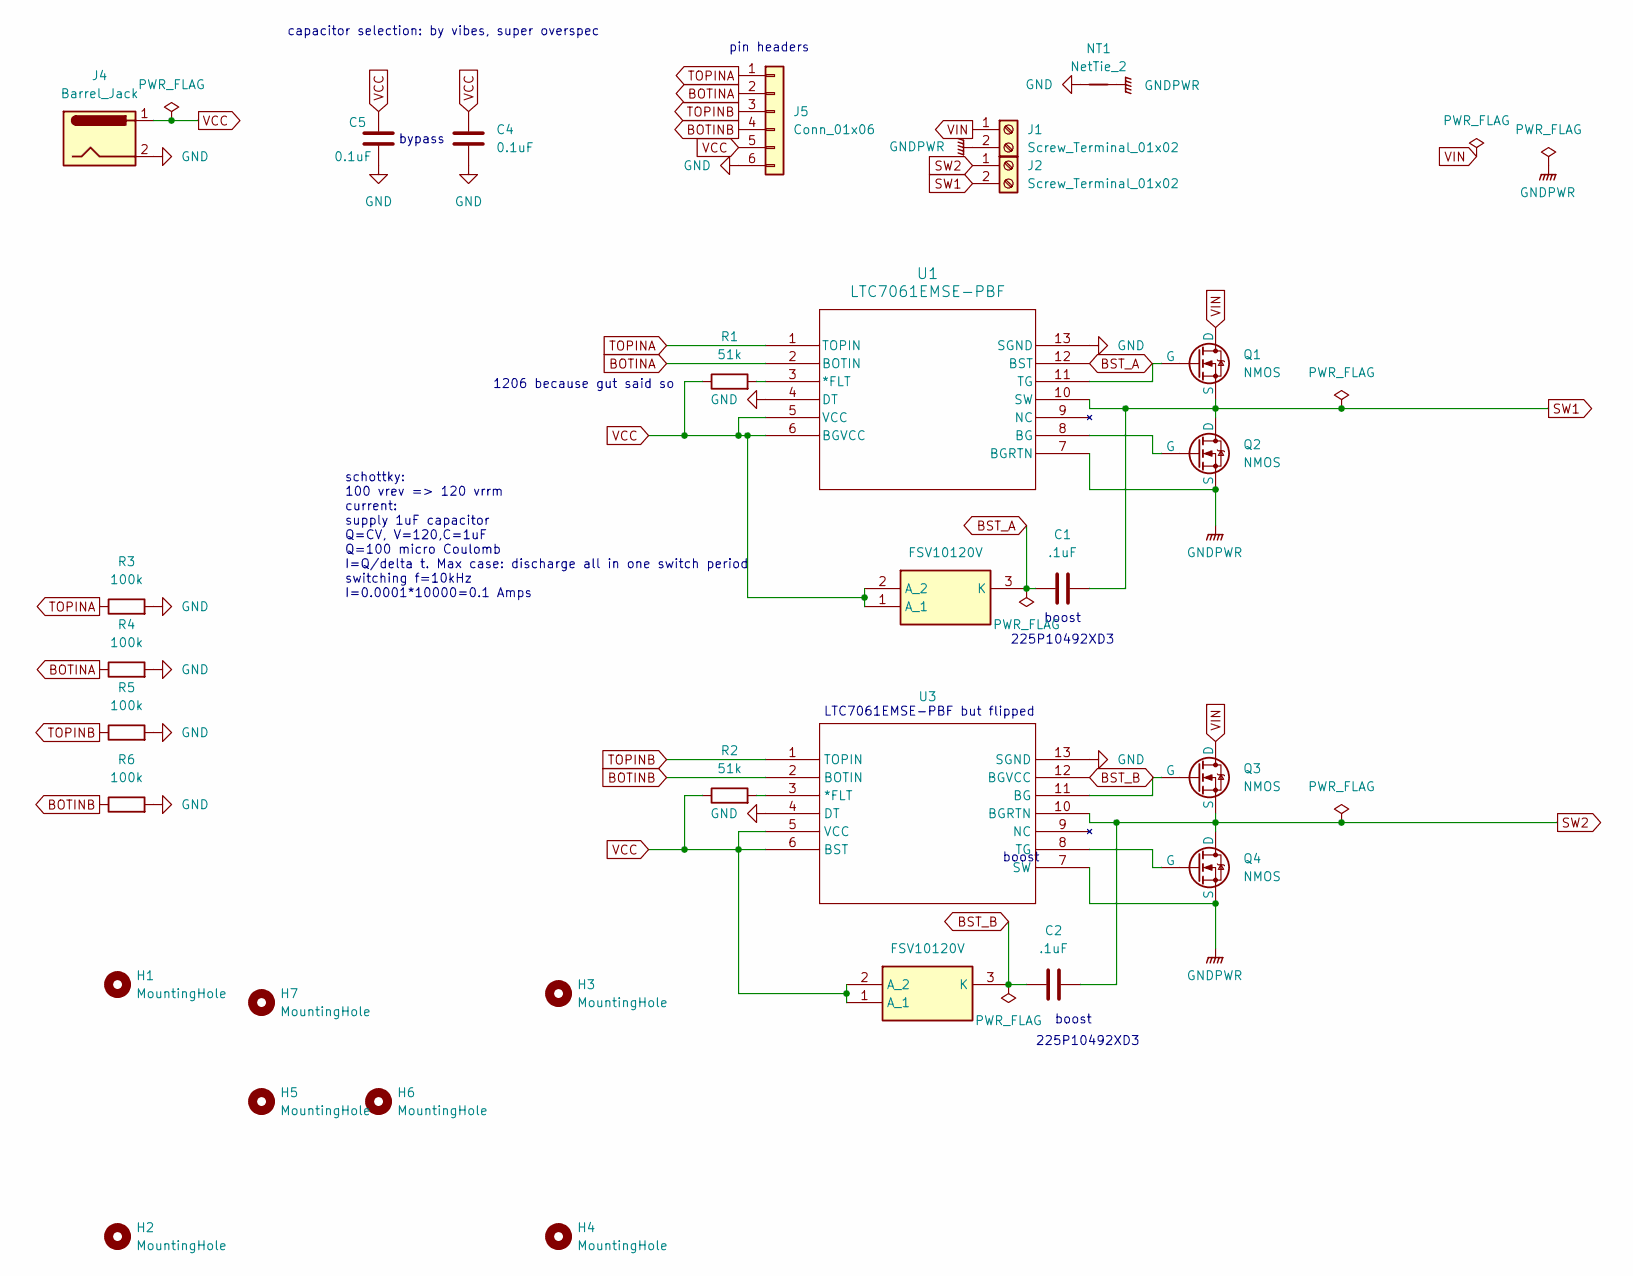
[picture p86: schematic big_hbridge.kicad_sch]

Parts:
C1, C2: .1uF; C_Disc_D7.5mm_W5.0mm_P10.00mm
C4, C5: 0.1uF; C_1206_3216Metric
D1, D3: FSV10120V; Mouser Part Number 512-FSV10120V
H1, H2, H3, H4, H5, H6, H7: MountingHole; MountingHole_3mm_Pad
J1, J2: Screw_Terminal_01x02; CONN_4DB-P108-02_TEC
J4: Barrel_Jack; BarrelJack_Horizontal
J5: Conn_01x06; PinHeader_1x06_P2.54mm_Vertical
NT1: NetTie_2; NetTie-2_THT_Pad1.0mm
Q1, Q2, Q3, Q4: NMOS; TO254P1524X483-3N
R1, R2: 51k; R_1206_3216Metric
R3, R4, R5: 100k; R_0402_1005Metric
R6: 100k; LED_0402_1005Metric
U1: LTC7061EMSE-PBF; MSOP12_MSE_ADI-M
U3: MSOP12_MSE_ADI-M

Connections:
BOTINA: J5.2, R4.1, U1.2 (BOTIN)
BOTINB: J5.4, R6.1, U3.2 (BOTIN)
BST_A: C1.1, D3.3 (K), U1.12 (BST)
BST_B: C2.1, D1.3 (K), U3.12 (BGVCC)
GND: C4.1, C5.1, J4.2, J5.6, NT1.1, R3.2, R4.2, R5.2, R6.2, U1.4 (DT), U1.13 (SGND), U3.4 (DT), U3.13 (SGND)
GNDPWR: J1.2, NT1.2, Q2.3 (S), Q4.3 (S), U1.7 (BGRTN), U3.7 (SW)
unnamed: Q1.2 (G), U1.11 (TG)
unnamed: Q2.2 (G), U1.8 (BG)
unnamed: Q3.2 (G), U3.11 (BG)
unnamed: Q4.2 (G), U3.8 (TG)
unnamed: R1.2, U1.3 (*FLT)
unnamed: R2.2, U3.3 (*FLT)
SW1: C1.2, J2.2, Q1.3 (S), Q2.1 (D), U1.10 (SW)
SW2: C2.2, J2.1, Q3.3 (S), Q4.1 (D), U3.10 (BGRTN)
TOPINA: J5.1, R3.1, U1.1 (TOPIN)
TOPINB: J5.3, R5.1, U3.1 (TOPIN)
VCC: C4.2, C5.2, D1.1 (A_1), D1.2 (A_2), D3.1 (A_1), D3.2 (A_2), J4.1, J5.5, R1.1, R2.1, U1.5 (VCC), U1.6 (BGVCC), U3.5 (VCC), U3.6 (BST)
VIN: J1.1, Q1.1 (D), Q3.1 (D)

Notes on the sheet:
schottky: 100 vrev => 120 vrrm current: supply 1uF capacitor Q=CV, V=120,C=1uF Q=100 micro Coulomb I=Q/delta t. Max case: discharge all in one switch period switching f=10kHz I=0.0001*10000=0.1 Amps
225P10492XD3
boost
1206 because gut said so
pin headers
LTC7061EMSE-PBF but flipped
bypass
capacitor selection: by vibes, super overspec

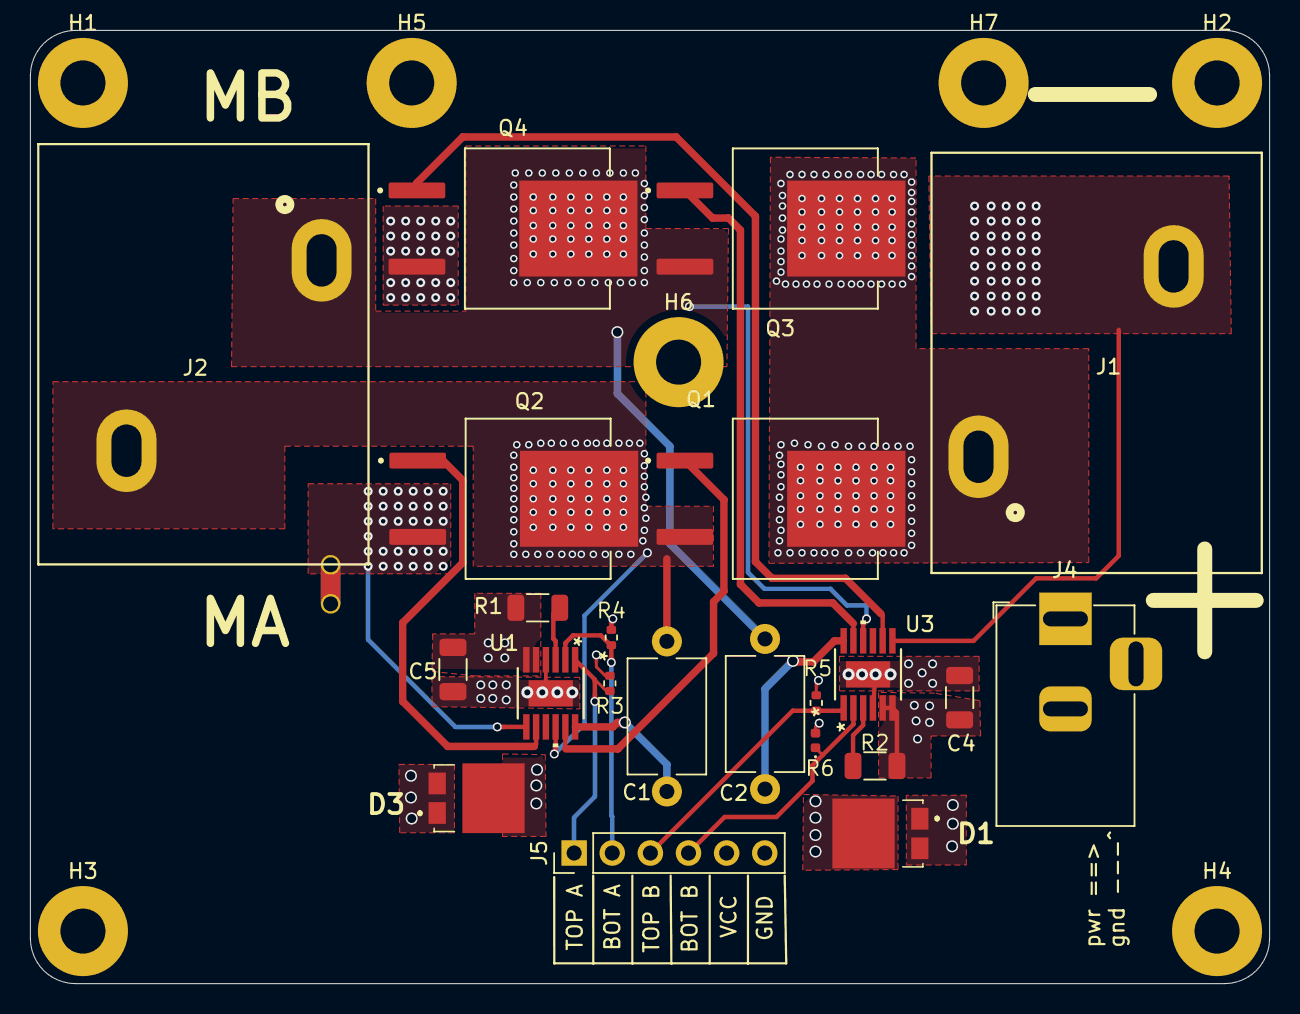
[picture p87: board big_hbridge.kicad_pcb from above]

Board: 4 copper layers, 82.5 x 63.5 mm, 30 parts (0 on the bottom side), 18 nets.
