BlueJayRacing/bjr_kicad/21xt/main_bulkhead/main_bulkhead.kicad_pcb

## KiCad design 21xt/main_bulkhead/main_bulkhead.kicad_pcb (2025-01-08)

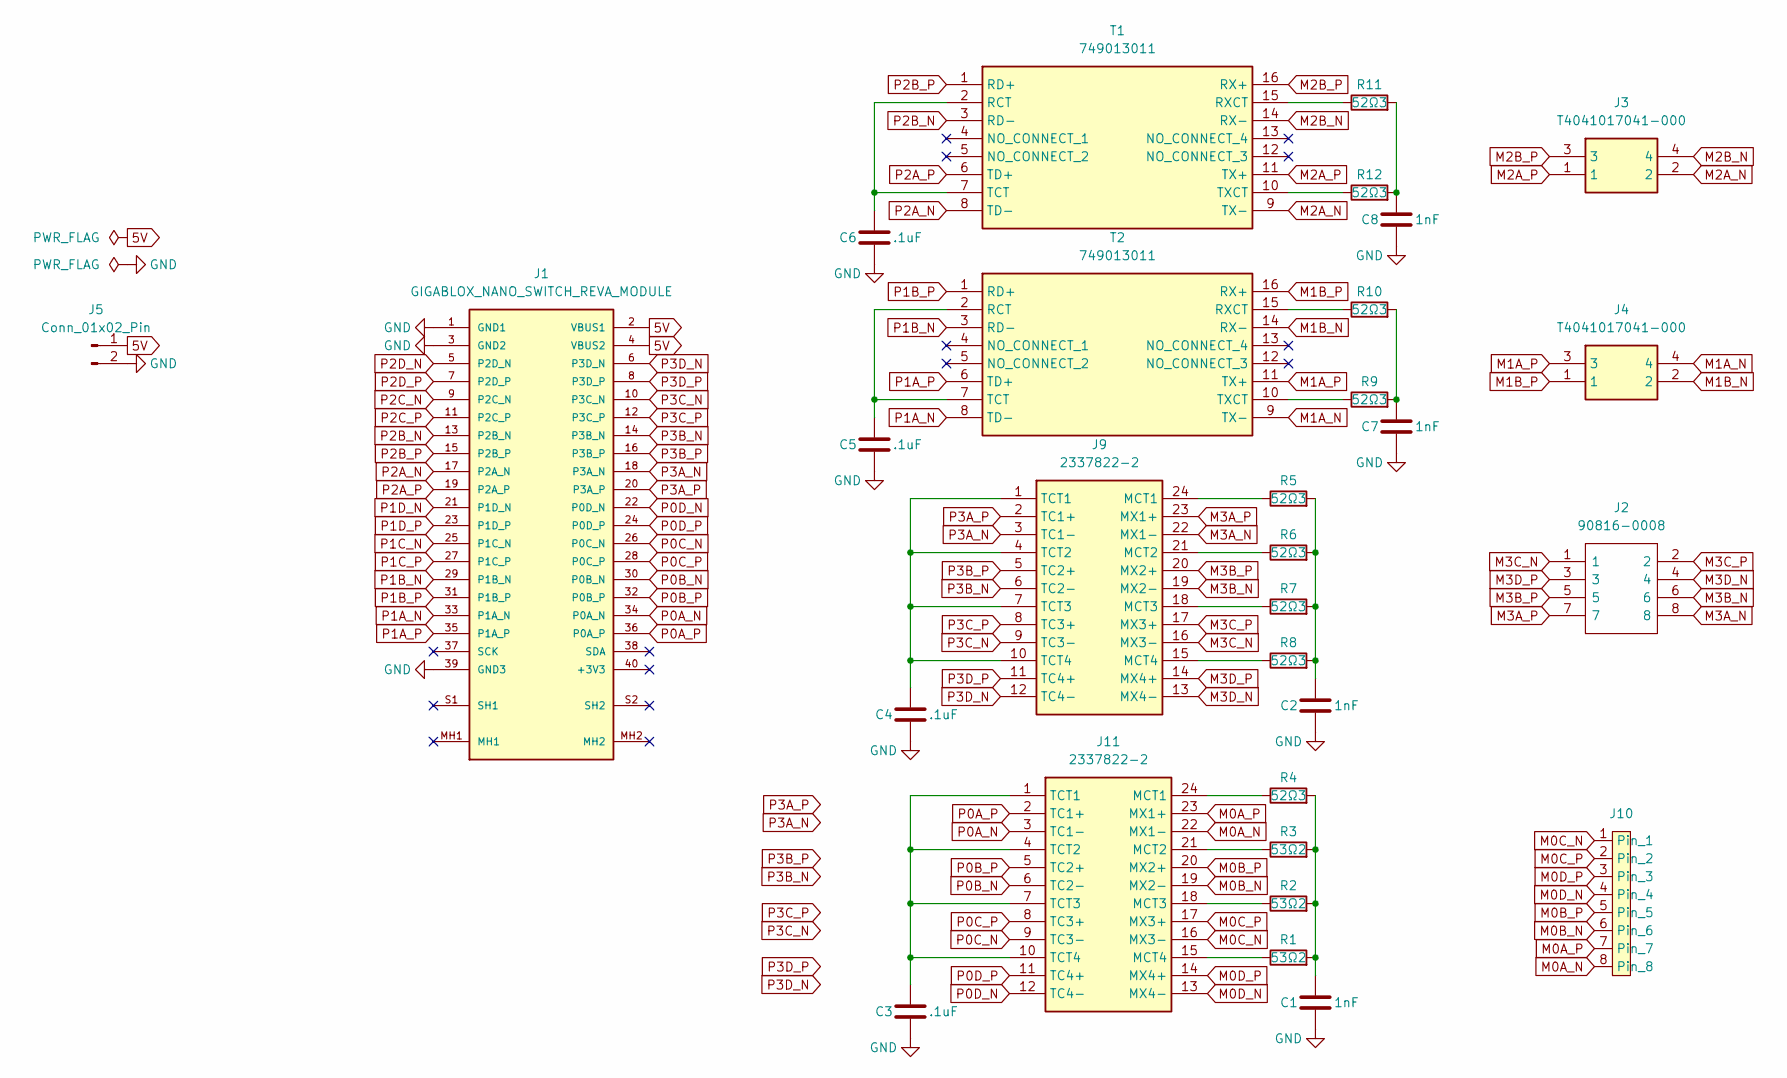
[picture p88: schematic main_bulkhead.kicad_sch]

Parts:
C1, C2, C7, C8: 1nF; C_1206_3216Metric
C3, C4, C5, C6: .1uF; C_0402_1005Metric
J1: GIGABLOX_NANO_SWITCH_REVA_MODULE; LSHM-120-02.5-L-DV-A-S-K-TR
J2: 90816-0008; 908160008; Mouser Part Number 538-90816-0008
J3, J4: T4041017041-000; T4041017041000; Mouser Part Number 571-T4041017041-000
J5: Conn_01x02_Pin; JST_PH_B2B-PH-K_1x02_P2.00mm_Vertical
J9, J11: 2337822-2; 23378222; Mouser Part Number 571-2337822-2
J10: m12 8p
R1, R2, R3: 53Ω2; R_0402_1005Metric
R4, R5, R6, R7, R8, R9, R10, R11, R12: 52Ω3; R_0402_1005Metric
T1, T2: 749013011; Mouser Part Number 710-749013011

Connections:
5V: J1.2 (VBUS1), J1.4 (VBUS2), J5.1
GND: C1.2, C2.2, C3.2, C4.2, C5.2, C6.2, C7.2, C8.2, J1.1 (GND1), J1.3 (GND2), J1.39 (GND3), J5.2
M0A_N: J10.8, J11.22 (MX1-)
M0A_P: J10.7, J11.23 (MX1+)
M0B_N: J10.6, J11.19 (MX2-)
M0B_P: J10.5, J11.20 (MX2+)
M0C_N: J10.1, J11.16 (MX3-)
M0C_P: J10.2, J11.17 (MX3+)
M0D_N: J10.4, J11.13 (MX4-)
M0D_P: J10.3, J11.14 (MX4+)
M1A_N: J4.4, T2.9 (TX-)
M1A_P: J4.3, T2.11 (TX+)
M1B_N: J4.2, T2.14 (RX-)
M1B_P: J4.1, T2.16 (RX+)
M2A_N: J3.2, T1.9 (TX-)
M2A_P: J3.1, T1.11 (TX+)
M2B_N: J3.4, T1.14 (RX-)
M2B_P: J3.3, T1.16 (RX+)
M3A_N: J2.8, J9.22 (MX1-)
M3A_P: J2.7, J9.23 (MX1+)
M3B_N: J2.6, J9.19 (MX2-)
M3B_P: J2.5, J9.20 (MX2+)
M3C_N: J2.1, J9.16 (MX3-)
M3C_P: J2.2, J9.17 (MX3+)
M3D_N: J2.4, J9.13 (MX4-)
M3D_P: J2.3, J9.14 (MX4+)
unnamed: C1.1, R1.2, R2.2, R3.2, R4.2
unnamed: C2.1, R5.2, R6.2, R7.2, R8.2
unnamed: C7.1, R9.2, R10.2
unnamed: C8.1, R11.2, R12.2
unnamed: J9.24 (MCT1), R5.1
unnamed: J9.21 (MCT2), R6.1
unnamed: J9.18 (MCT3), R7.1
unnamed: J9.15 (MCT4), R8.1
unnamed: C4.1, J9.1 (TCT1), J9.4 (TCT2), J9.7 (TCT3), J9.10 (TCT4)
unnamed: J11.24 (MCT1), R4.1
unnamed: J11.21 (MCT2), R3.1
unnamed: J11.18 (MCT3), R2.1
unnamed: J11.15 (MCT4), R1.1
unnamed: C3.1, J11.1 (TCT1), J11.4 (TCT2), J11.7 (TCT3), J11.10 (TCT4)
unnamed: C6.1, T1.2 (RCT), T1.7 (TCT)
unnamed: R11.1, T1.15 (RXCT)
unnamed: R12.1, T1.10 (TXCT)
unnamed: C5.1, T2.2 (RCT), T2.7 (TCT)
unnamed: R10.1, T2.15 (RXCT)
unnamed: R9.1, T2.10 (TXCT)
P0A_N: J1.34 (P0A_N), J11.3 (TC1-)
P0A_P: J1.36 (P0A_P), J11.2 (TC1+)
P0B_N: J1.30 (P0B_N), J11.6 (TC2-)
P0B_P: J1.32 (P0B_P), J11.5 (TC2+)
P0C_N: J1.26 (P0C_N), J11.9 (TC3-)
P0C_P: J1.28 (P0C_P), J11.8 (TC3+)
P0D_N: J1.22 (P0D_N), J11.12 (TC4-)
P0D_P: J1.24 (P0D_P), J11.11 (TC4+)
P1A_N: J1.33 (P1A_N), T2.8 (TD-)
P1A_P: J1.35 (P1A_P), T2.6 (TD+)
P1B_N: J1.29 (P1B_N), T2.3 (RD-)
P1B_P: J1.31 (P1B_P), T2.1 (RD+)
P1C_N: J1.25 (P1C_N)
P1C_P: J1.27 (P1C_P)
P1D_N: J1.21 (P1D_N)
P1D_P: J1.23 (P1D_P)
P2A_N: J1.17 (P2A_N), T1.8 (TD-)
P2A_P: J1.19 (P2A_P), T1.6 (TD+)
P2B_N: J1.13 (P2B_N), T1.3 (RD-)
P2B_P: J1.15 (P2B_P), T1.1 (RD+)
P2C_N: J1.9 (P2C_N)
P2C_P: J1.11 (P2C_P)
P2D_N: J1.5 (P2D_N)
P2D_P: J1.7 (P2D_P)
P3A_N: J1.18 (P3A_N), J9.3 (TC1-)
P3A_P: J1.20 (P3A_P), J9.2 (TC1+)
P3B_N: J1.14 (P3B_N), J9.6 (TC2-)
P3B_P: J1.16 (P3B_P), J9.5 (TC2+)
P3C_N: J1.10 (P3C_N), J9.9 (TC3-)
P3C_P: J1.12 (P3C_P), J9.8 (TC3+)
P3D_N: J1.6 (P3D_N), J9.12 (TC4-)
P3D_P: J1.8 (P3D_P), J9.11 (TC4+)

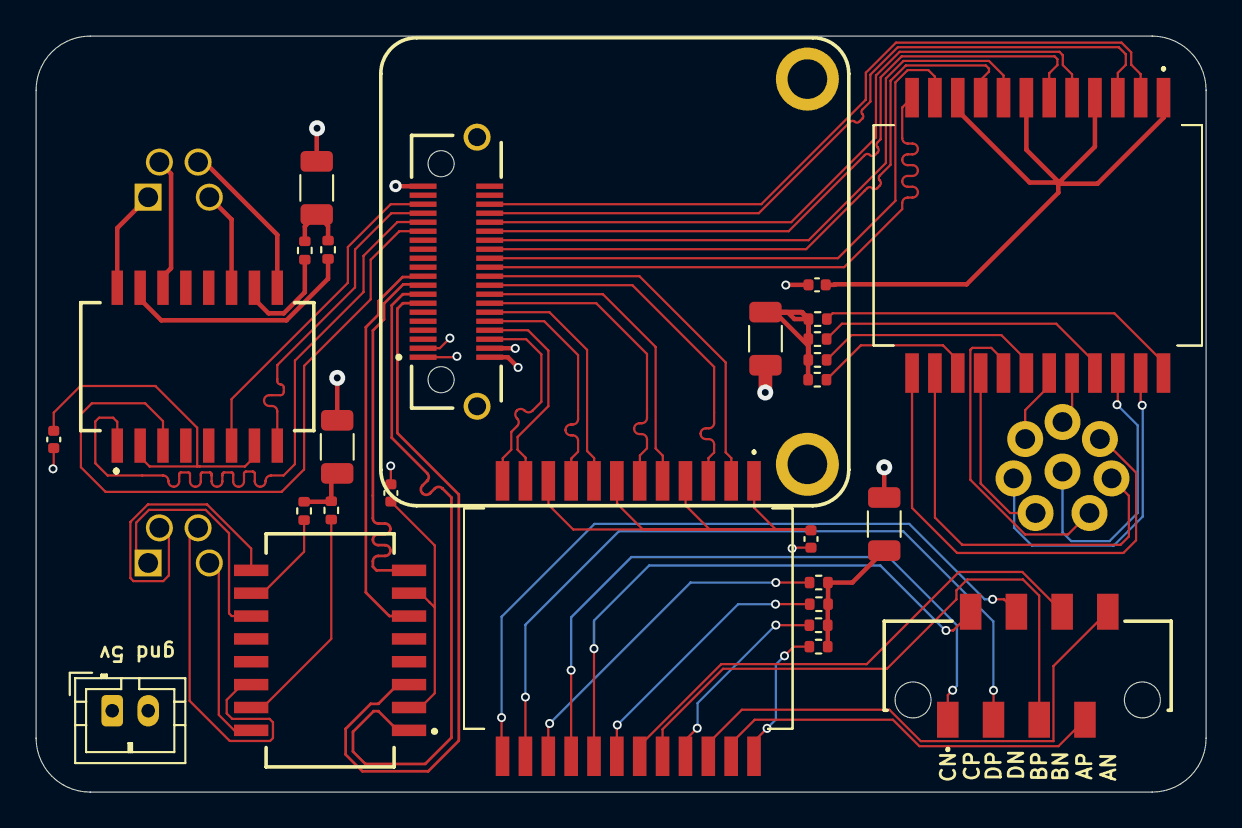
[picture p89: board main_bulkhead.kicad_pcb from above]

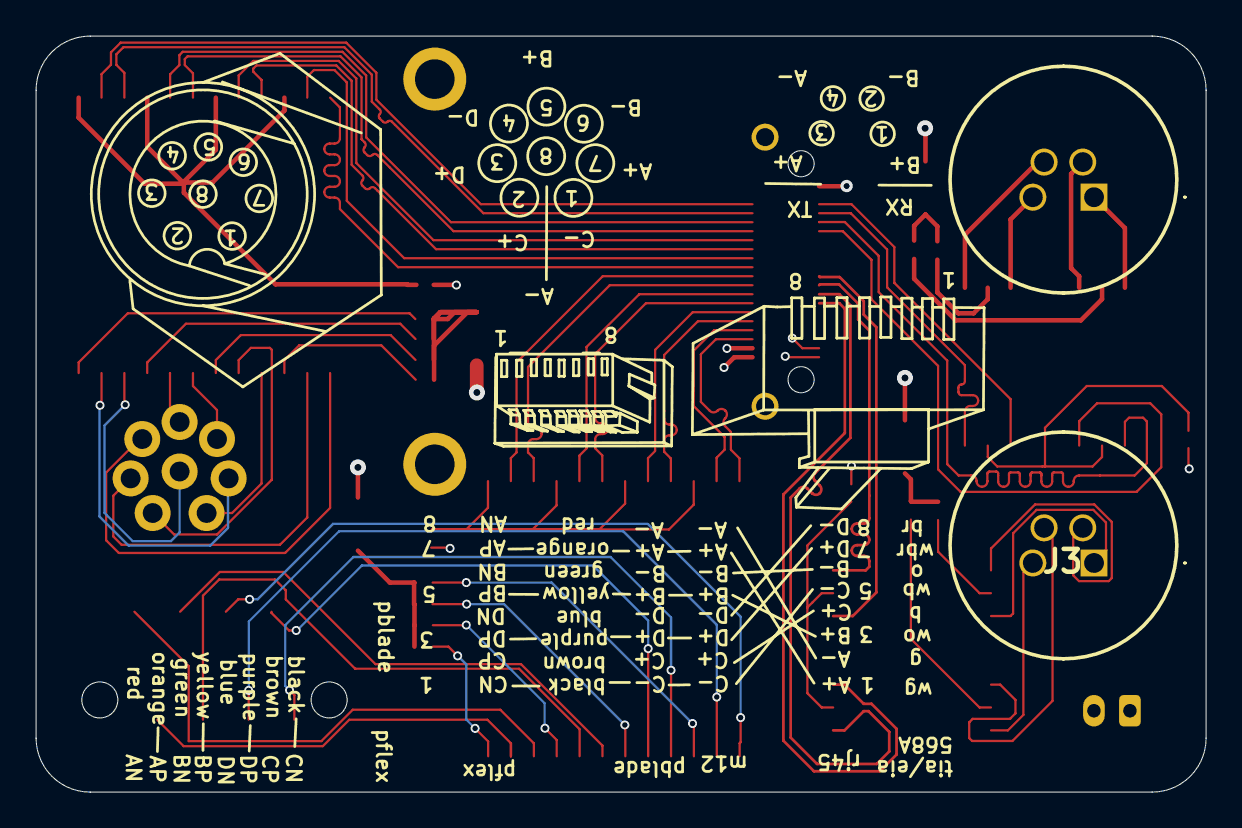
[picture p90: board main_bulkhead.kicad_pcb from below]

Board: 4 copper layers, 65.0 x 42.0 mm, 30 parts (3 on the bottom side), 70 nets.
