BlueJayRacing/bjr_kicad/21xt/02-mainbox/bjr_kicad_aaren_copy/21xt/01-accessory/accessoryidk/accessoryidk.kicad_pcb

## KiCad design 21xt/02-mainbox/bjr_kicad_aaren_copy/21xt/01-accessory/accessoryidk/accessoryidk.kicad_pcb (2024-08-15)

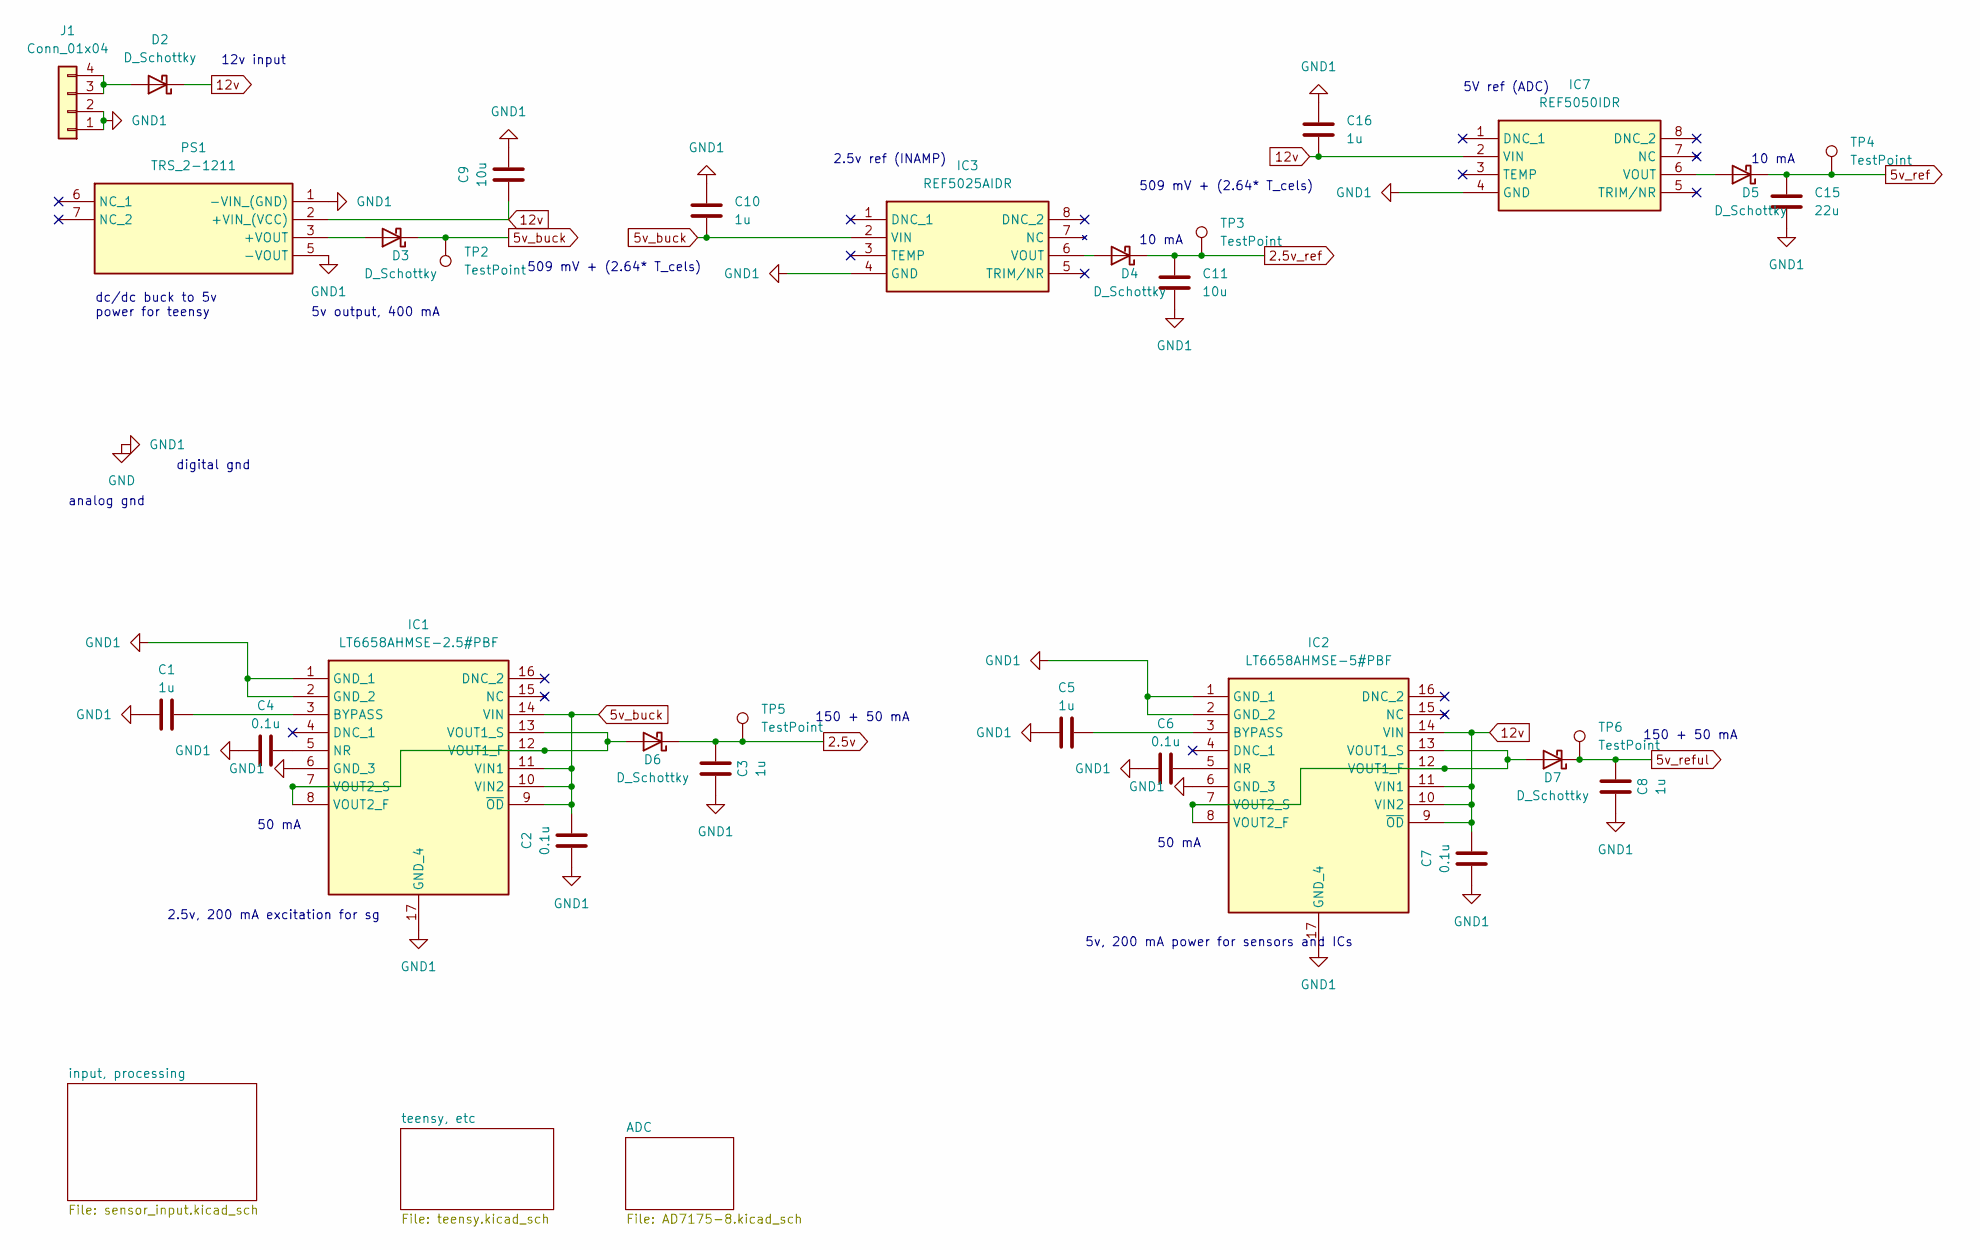
[picture p91: schematic accessoryidk.kicad_sch]

Parts:
C1, C3, C5, C8, C10, C16: 1u; C_0603_1608Metric
C2, C4, C6, C7: 0.1u; C_0603_1608Metric
C9: 10u; C_1206_3216Metric
C11: 10u; C_0603_1608Metric
C15: 22u; C_0603_1608Metric
D2: D_Schottky; D_1206_3216Metric
D3, D4, D5, D6, D7: D_Schottky; D_0603_1608Metric
IC1: LT6658AHMSE-2.5#PBF; SOP50P490X110-17N; Mouser Part Number 584-LT6658AHMSE5PBF
IC2: LT6658AHMSE-5#PBF; SOP50P490X110-17N; Mouser Part Number 584-LT6658AHMSE5PBF
IC3: REF5025AIDR; SOIC127P599X175-8N; Mouser Part Number 595-REF5050IDR
IC7: REF5050IDR; SOIC127P599X175-8N; Mouser Part Number 595-REF5050IDR
J1: Conn_01x04; JST_EH_B4B-EH-A_1x04_P2.50mm_Vertical
PS1: TRS_2-1211; CONV_TRS_2-2419; Mouser Part Number 495-TRS2-1211
TP2, TP3, TP4, TP5, TP6: TestPoint; TestPoint_Pad_2.0x2.0mm

Connections:
2.5v: C3.2, D6.1 (K), TP5.1; also elsewhere on the board
2.5v_ref: C11.1, D4.1 (K), TP3.1; also elsewhere on the board
5v_buck: C2.2, C10.1, D3.1 (K), IC1.9 (~OD), IC1.10 (VIN2), IC1.11 (VIN1), IC1.14 (VIN), IC3.2 (VIN), TP2.1; also elsewhere on the board
5v_ref: C15.1, D5.1 (K), TP4.1; also elsewhere on the board
5v_reful: C8.2, D7.1 (K), TP6.1; also elsewhere on the board
12v: C7.2, C9.1, C16.1, D2.1 (K), IC2.9 (~OD), IC2.10 (VIN2), IC2.11 (VIN1), IC2.14 (VIN), IC7.2 (VIN), PS1.2 (+VIN_(VCC)); also elsewhere on the board
unnamed: D2.2 (A), J1.3, J1.4
unnamed: D3.2 (A), PS1.3 (+VOUT)
unnamed: D4.2 (A), IC3.6 (VOUT)
unnamed: D5.2 (A), IC7.6 (VOUT)
unnamed: D6.2 (A), IC1.7 (VOUT2_S), IC1.8 (VOUT2_F), IC1.12 (VOUT1_F), IC1.13 (VOUT1_S)
unnamed: D7.2 (A), IC2.7 (VOUT2_S), IC2.8 (VOUT2_F), IC2.12 (VOUT1_F), IC2.13 (VOUT1_S)
unnamed: C1.2, IC1.3 (BYPASS)
unnamed: C4.2, IC1.5 (NR)
unnamed: C5.2, IC2.3 (BYPASS)
unnamed: C6.2, IC2.5 (NR)
usb_gnd: C1.1, C2.1, C3.1, C4.1, C5.1, C6.1, C7.1, C8.1, C9.2, C10.2, C11.2, C15.2, C16.2, IC1.1 (GND_1), IC1.2 (GND_2), IC1.6 (GND_3), IC1.17 (GND_4), IC2.1 (GND_1), IC2.2 (GND_2), IC2.6 (GND_3), IC2.17 (GND_4), IC3.4 (GND), IC7.4 (GND), J1.1, J1.2, PS1.1 (-VIN_(GND)), PS1.5 (-VOUT); also elsewhere on the board

Notes on the sheet:
2.5v, 200 mA excitation for sg
150 + 50 mA
50 mA
10 mA
5V ref (ADC)
12v input
5v, 200 mA power for sensors and ICs
2.5v ref (INAMP)
digital gnd
analog gnd
dc/dc buck to 5v power for teensy
5v output, 400 mA
509 mV + (2.64* T_cels)

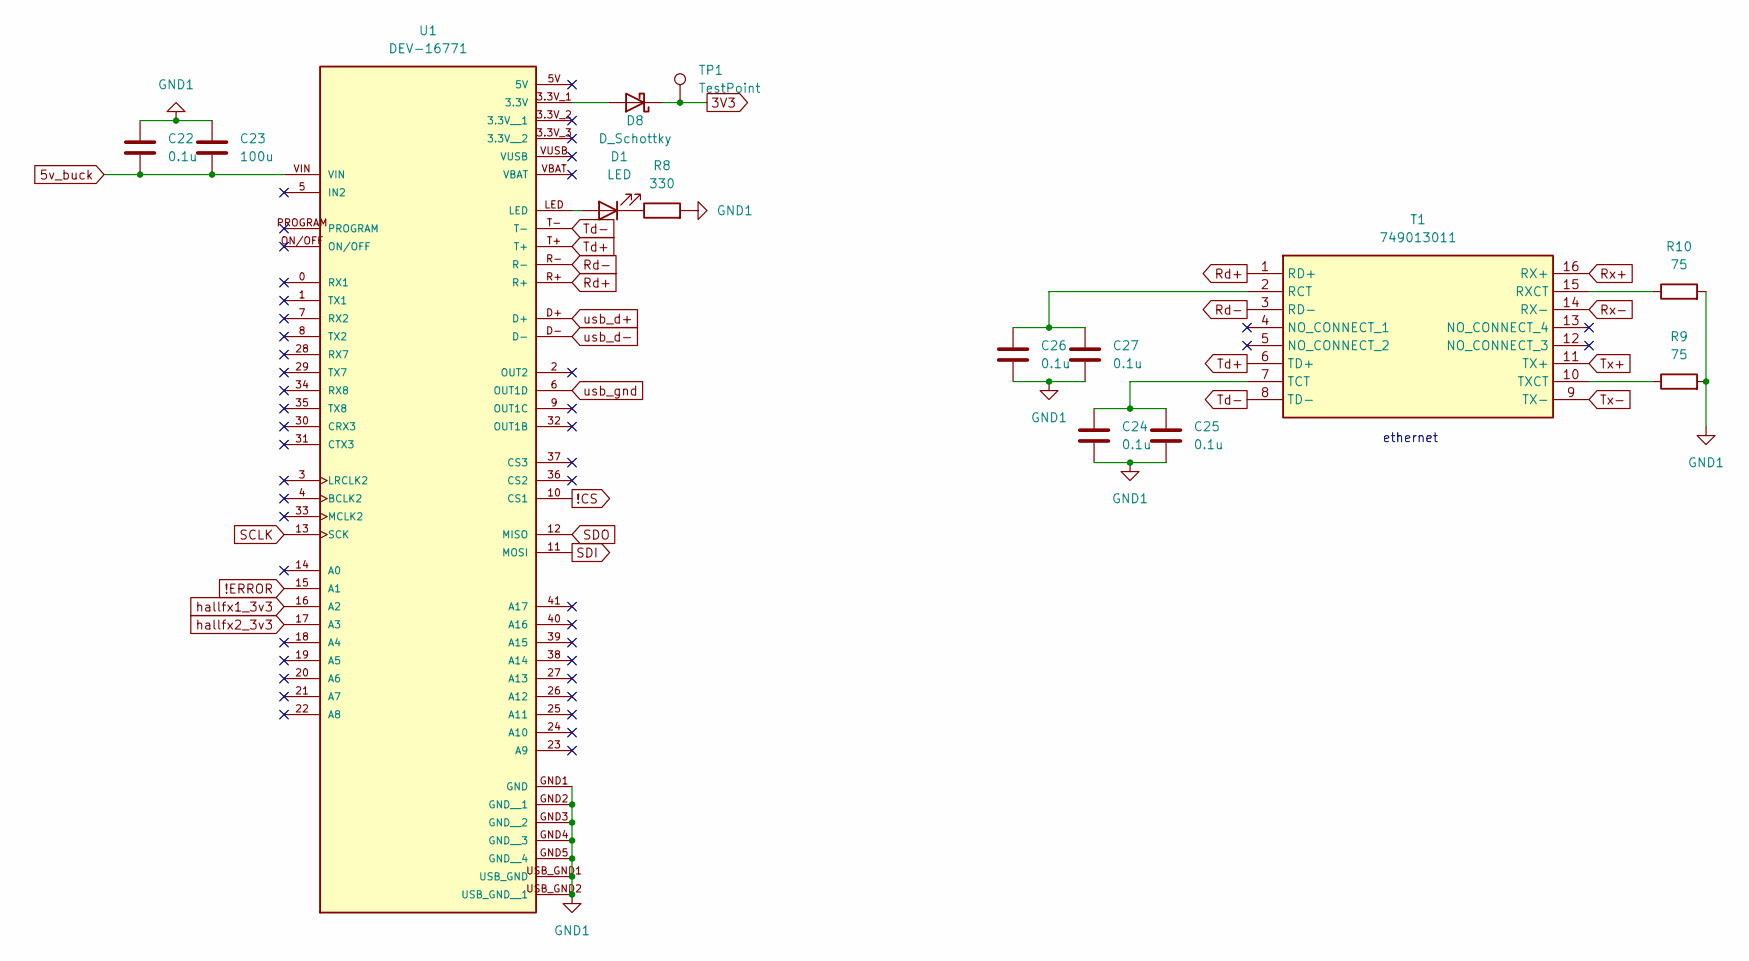
[picture p92: schematic teensy.kicad_sch]

Parts:
C22, C24, C25, C26, C27: 0.1u; C_0603_1608Metric
C23: 100u; C_1206_3216Metric
D1: LED; D_0603_1608Metric
D8: D_Schottky; D_0603_1608Metric
R8: 330; R_0603_1608Metric
R9, R10: 75; R_0603_1608Metric
T1: 749013011; Mouser Part Number 710-749013011
TP1: TestPoint; TestPoint_Pad_2.0x2.0mm
U1: DEV-16771; MODULE_DEV-16771; PARTREV 4.1

Connections:
3V3: D8.1 (K), TP1.1; also elsewhere on the board
5v_buck: C22.2, C23.2, U1.VIN; also elsewhere on the board
!CS: U1.10 (CS1); also elsewhere on the board
!ERROR: U1.15 (A1); also elsewhere on the board
unnamed: D1.2 (A), U1.LED
unnamed: D1.1 (K), R8.1
unnamed: D8.2 (A), U1.3.3V_1 (3.3V)
unnamed: C26.1, C27.1, T1.2 (RCT)
unnamed: R10.1, T1.15 (RXCT)
unnamed: C24.1, C25.1, T1.7 (TCT)
unnamed: R9.1, T1.10 (TXCT)
Rd+: T1.1 (RD+), U1.R+
Rd-: T1.3 (RD-), U1.R-
Rx+: T1.16 (RX+); also elsewhere on the board
Rx-: T1.14 (RX-); also elsewhere on the board
SCLK: U1.13 (SCK); also elsewhere on the board
SDI: U1.11 (MOSI); also elsewhere on the board
SDO: U1.12 (MISO); also elsewhere on the board
Td+: T1.6 (TD+), U1.T+
Td-: T1.8 (TD-), U1.T-
Tx+: T1.11 (TX+); also elsewhere on the board
Tx-: T1.9 (TX-); also elsewhere on the board
hallfx1_3v3: U1.16 (A2); also elsewhere on the board
hallfx2_3v3: U1.17 (A3); also elsewhere on the board
usb_d+: U1.D+; also elsewhere on the board
usb_d-: U1.D-; also elsewhere on the board
usb_gnd: C22.1, C23.1, C24.2, C25.2, C26.2, C27.2, R8.2, R9.2, R10.2, U1.6 (OUT1D), U1.GND1 (GND), U1.GND2 (GND__1), U1.GND3 (GND__2), U1.GND4 (GND__3), U1.GND5 (GND__4), U1.USB_GND1 (USB_GND), U1.USB_GND2 (USB_GND__1); also elsewhere on the board

Notes on the sheet:
ethernet

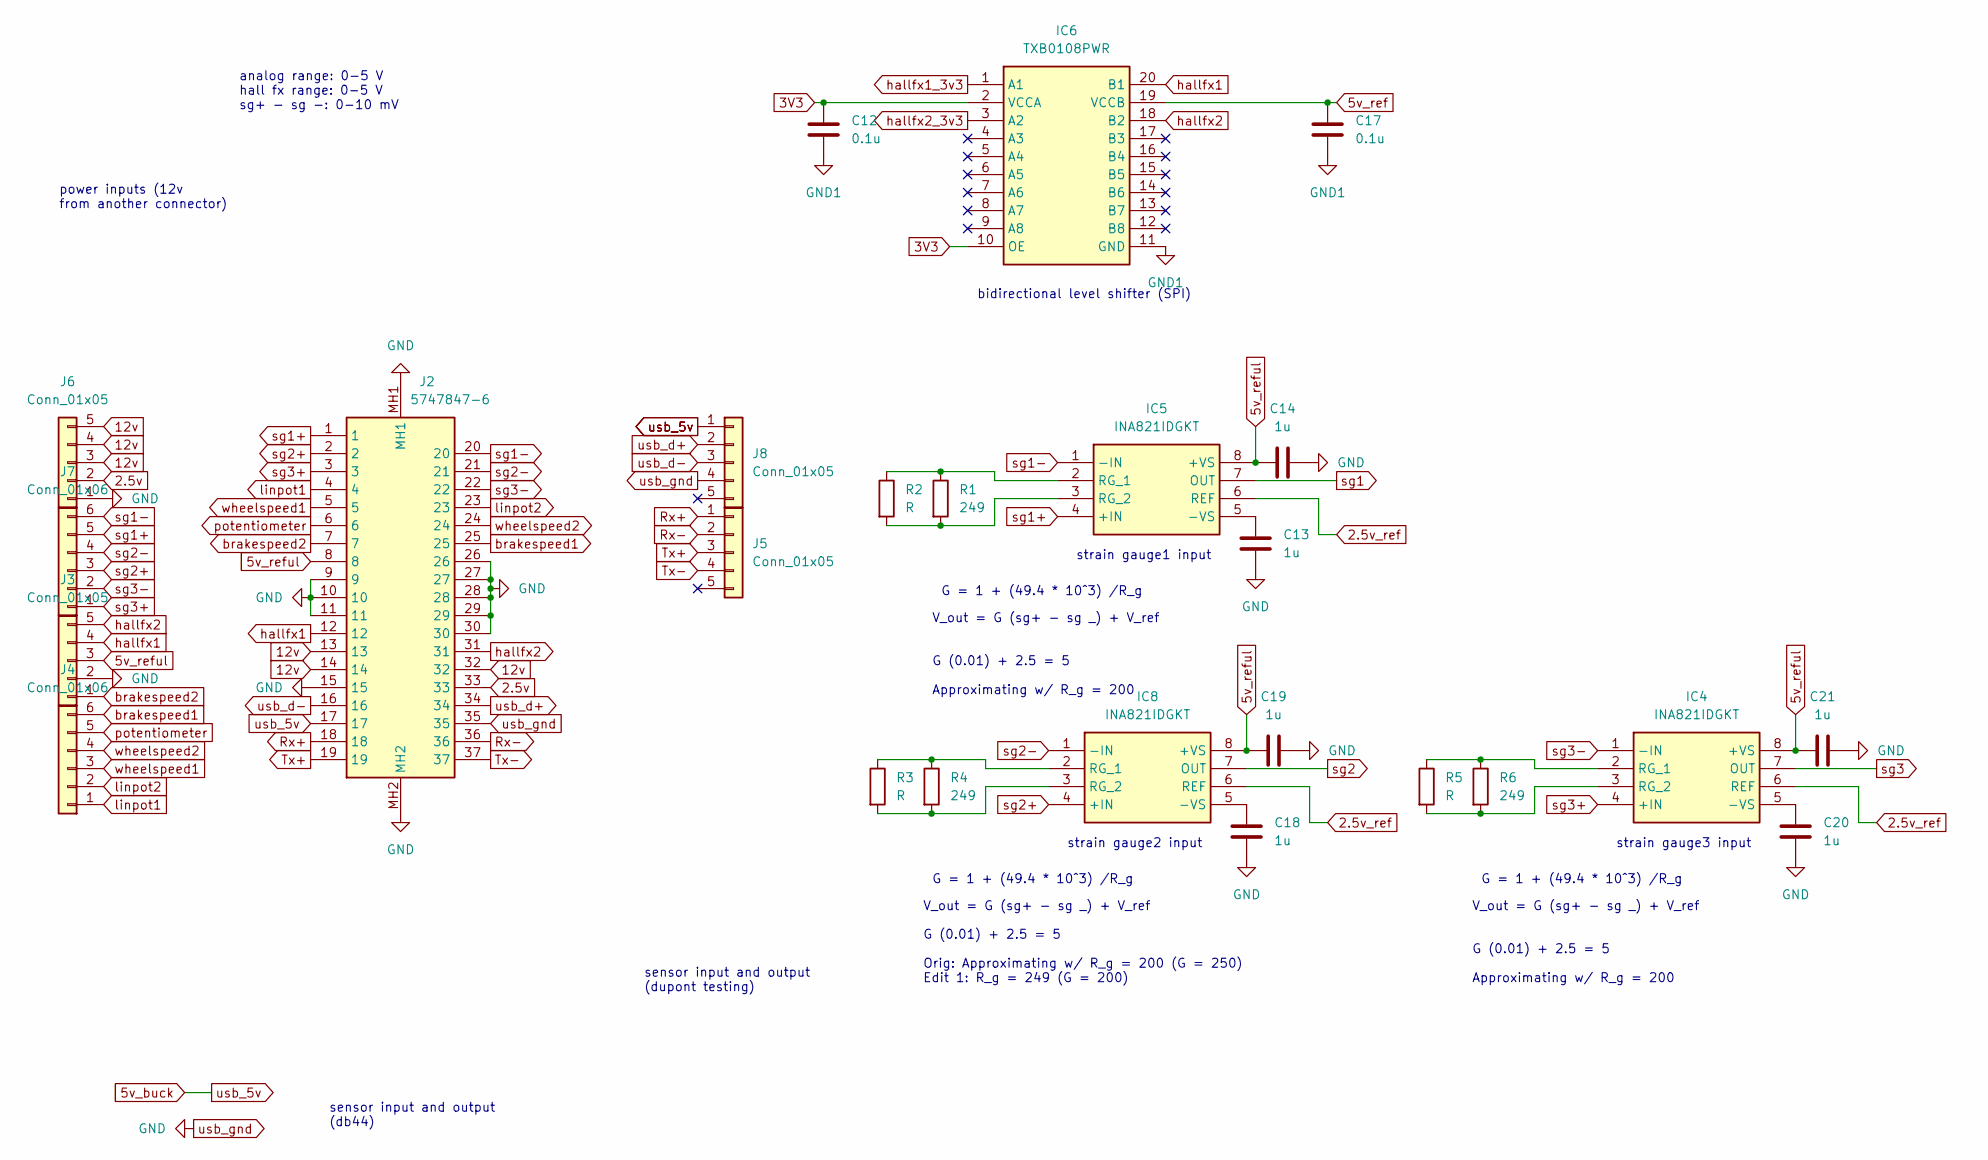
[picture p93: schematic sensor_input.kicad_sch]

Parts:
C12, C17: 0.1u; C_0603_1608Metric
C13, C14, C18, C19, C20, C21: 1u; C_0603_1608Metric
IC4, IC5, IC8: INA821IDGKT; SOP65P490X110-8N; Mouser Part Number 595-INA821IDGKT
IC6: TXB0108PWR; SOP65P640X120-20N; Mouser Part Number 595-TXB0108PWR
J2: 5747847-6; 57478476; Manufacturer_Part_Number 5747847-6; Mouser Part Number 571-5747847-6
J3, J5, J6, J8: Conn_01x05; JST_EH_B5B-EH-A_1x05_P2.50mm_Vertical
J4, J7: Conn_01x06; JST_EH_B6B-EH-A_1x06_P2.50mm_Vertical
R1, R4, R6: 249; R_0603_1608Metric
R2, R3, R5: R; R_0603_1608Metric

Connections:
2.5v: J2.33, J6.2; also elsewhere on the board
2.5v_ref: IC4.6 (REF), IC5.6 (REF), IC8.6 (REF); also elsewhere on the board
3V3: C12.1, IC6.2 (VCCA), IC6.10 (OE); also elsewhere on the board
5v_buck: J2.17, J8.1; also elsewhere on the board
5v_ref: C17.1, IC6.19 (VCCB); also elsewhere on the board
5v_reful: C14.1, C19.1, C21.1, IC4.8 (+VS), IC5.8 (+VS), IC8.8 (+VS), J2.8, J3.3; also elsewhere on the board
12v: J2.13, J2.14, J2.32, J6.3, J6.4, J6.5; also elsewhere on the board
unnamed: C20.1, IC4.5 (-VS)
unnamed: IC4.2 (RG_1), R5.1, R6.1
unnamed: IC4.3 (RG_2), R5.2, R6.2
unnamed: C13.1, IC5.5 (-VS)
unnamed: IC5.2 (RG_1), R1.1, R2.1
unnamed: IC5.3 (RG_2), R1.2, R2.2
unnamed: C18.1, IC8.5 (-VS)
unnamed: IC8.2 (RG_1), R3.1, R4.1
unnamed: IC8.3 (RG_2), R3.2, R4.2
Rx+: J2.18, J5.1; also elsewhere on the board
Rx-: J2.36, J5.2; also elsewhere on the board
Tx+: J2.19, J5.3; also elsewhere on the board
Tx-: J2.37, J5.4; also elsewhere on the board
brakespeed1: J2.25, J4.6; also elsewhere on the board
brakespeed2: J2.7, J3.1; also elsewhere on the board
hallfx1: IC6.20 (B1), J2.12, J3.4
hallfx1_3v3: IC6.1 (A1); also elsewhere on the board
hallfx2: IC6.18 (B2), J2.31, J3.5
hallfx2_3v3: IC6.3 (A2); also elsewhere on the board
linpot1: J2.4, J4.1; also elsewhere on the board
linpot2: J2.23, J4.2; also elsewhere on the board
potentiometer: J2.6, J4.5; also elsewhere on the board
sg1: IC5.7 (OUT); also elsewhere on the board
sg1+: IC5.4 (+IN), J2.1, J7.5
sg1-: IC5.1 (-IN), J2.20, J7.6
sg2: IC8.7 (OUT); also elsewhere on the board
sg2+: IC8.4 (+IN), J2.2, J7.3
sg2-: IC8.1 (-IN), J2.21, J7.4
sg3: IC4.7 (OUT); also elsewhere on the board
sg3+: IC4.4 (+IN), J2.3, J7.1
sg3-: IC4.1 (-IN), J2.22, J7.2
usb_d+: J2.34, J8.2; also elsewhere on the board
usb_d-: J2.16, J8.3; also elsewhere on the board
usb_gnd: C12.2, C13.2, C14.2, C17.2, C18.2, C19.2, C20.2, C21.2, IC6.11 (GND), J2.9, J2.10, J2.11, J2.15, J2.26, J2.27, J2.28, J2.29, J2.30, J2.35, J2.MH1, J2.MH2, J3.2, J6.1, J8.4; also elsewhere on the board
wheelspeed1: J2.5, J4.3; also elsewhere on the board
wheelspeed2: J2.24, J4.4; also elsewhere on the board

Notes on the sheet:
bidirectional level shifter (SPI)
power inputs (12v from another connector)
strain gauge3 input
strain gauge1 input
G = 1 + (49.4 * 10^3) /R_g
sensor input and output (db44)
strain gauge2 input
analog range: 0-5 V hall fx range: 0-5 V sg+ - sg -: 0-10 mV
V_out = G (sg+ - sg _) + V_ref
G (0.01) + 2.5 = 5 Approximating w/ R_g = 200
G (0.01) + 2.5 = 5 Orig: Approximating w/ R_g = 200 (G = 250) Edit 1: R_g = 249 (G = 200)
sensor input and output (dupont testing)
