BlueJayRacing/bjr_kicad/21xt/02-mainbox/bjr_kicad_aaren_copy/21xt/01-accessory/accessoryidk/accessoryidk.kicad_pcb

## KiCad design 21xt/02-mainbox/bjr_kicad_aaren_copy/21xt/01-accessory/accessoryidk/accessoryidk.kicad_pcb (continued)

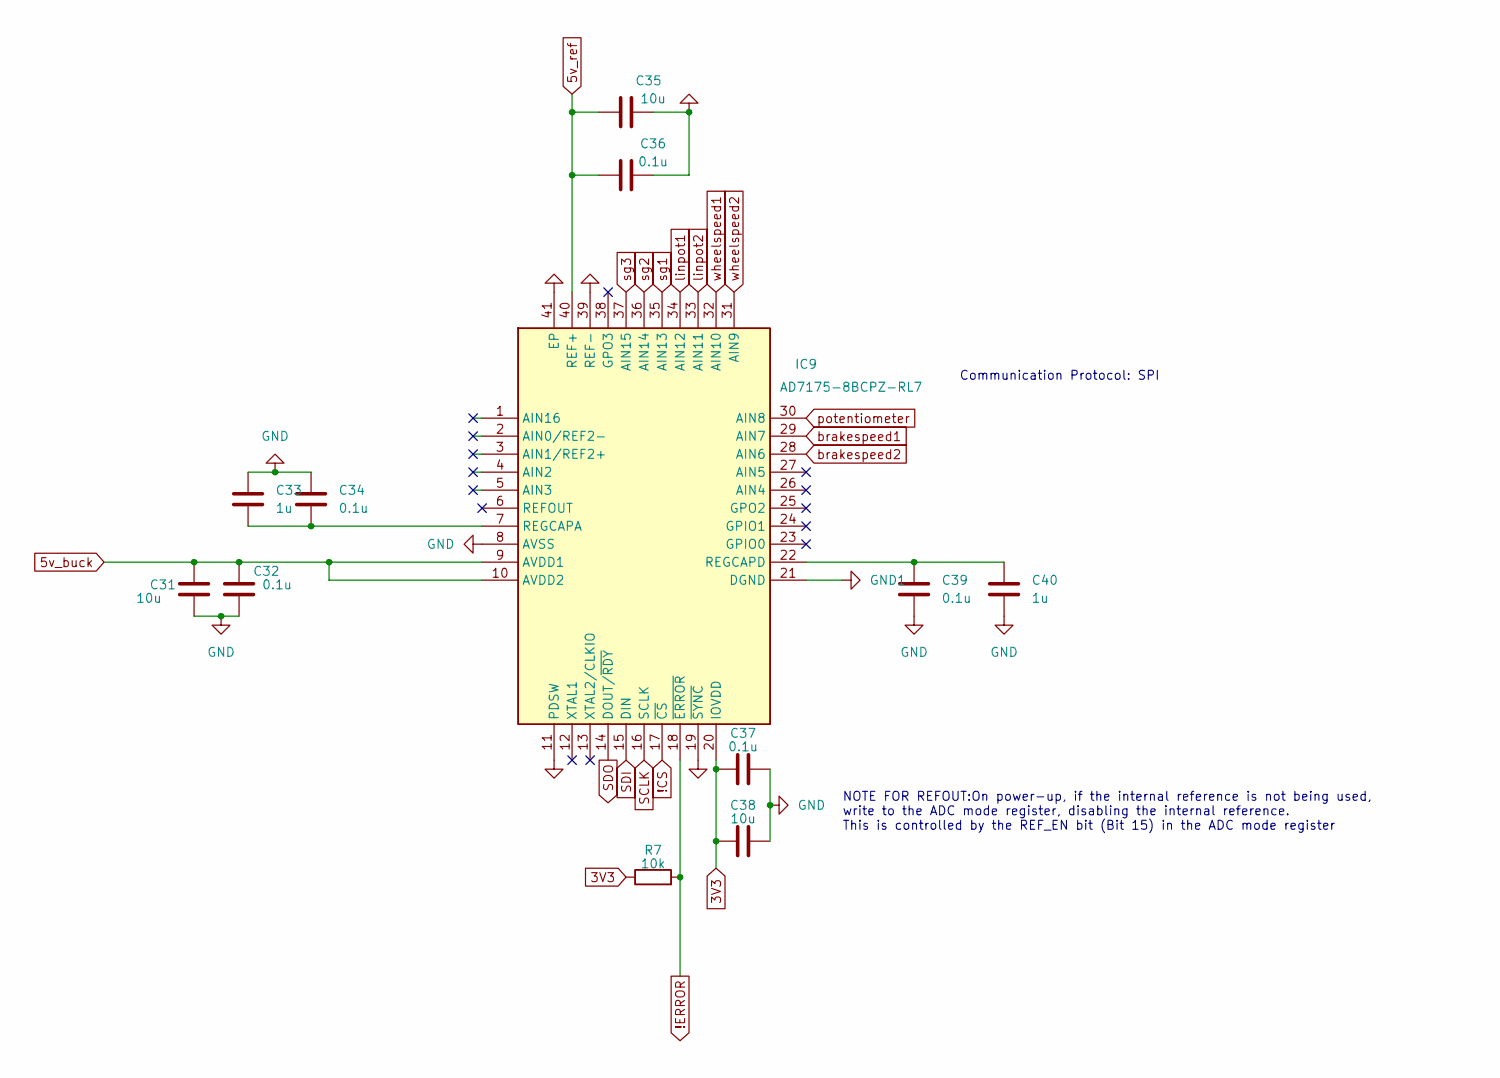
[picture p94: schematic AD7175-8.kicad_sch]

Parts:
C31, C35, C38: 10u; C_0603_1608Metric
C32, C34, C36, C37, C39: 0.1u; C_0603_1608Metric
C33, C40: 1u; C_0603_1608Metric
IC9: AD7175-8BCPZ-RL7; QFN50P600X600X80-41N; Mouser Part Number 584-AD7175-8BCPZ-RL7
R7: 10k; R_0603_1608Metric

Connections:
3V3: C37.1, C38.1, IC9.20 (IOVDD), R7.1; also elsewhere on the board
5v_buck: C31.1, C32.1, IC9.9 (AVDD1), IC9.10 (AVDD2); also elsewhere on the board
5v_ref: C35.1, C36.1, IC9.40 (REF+); also elsewhere on the board
!CS: IC9.17 (~CS); also elsewhere on the board
!ERROR: IC9.18 (~ERROR), R7.2; also elsewhere on the board
unnamed: C33.2, C34.2, IC9.7 (REGCAPA)
unnamed: C39.1, C40.1, IC9.22 (REGCAPD)
SCLK: IC9.16 (SCLK); also elsewhere on the board
SDI: IC9.15 (DIN); also elsewhere on the board
SDO: IC9.14 (DOUT/~RDY); also elsewhere on the board
brakespeed1: IC9.29 (AIN7); also elsewhere on the board
brakespeed2: IC9.28 (AIN6); also elsewhere on the board
linpot1: IC9.34 (AIN12); also elsewhere on the board
linpot2: IC9.33 (AIN11); also elsewhere on the board
potentiometer: IC9.30 (AIN8); also elsewhere on the board
sg1: IC9.35 (AIN13); also elsewhere on the board
sg2: IC9.36 (AIN14); also elsewhere on the board
sg3: IC9.37 (AIN15); also elsewhere on the board
usb_gnd: C31.2, C32.2, C33.1, C34.1, C35.2, C36.2, C37.2, C38.2, C39.2, C40.2, IC9.8 (AVSS), IC9.11 (PDSW), IC9.19 (~SYNC), IC9.21 (DGND), IC9.39 (REF-), IC9.41 (EP); also elsewhere on the board
wheelspeed1: IC9.32 (AIN10); also elsewhere on the board
wheelspeed2: IC9.31 (AIN9); also elsewhere on the board

Notes on the sheet:
NOTE FOR REFOUT:On power-up, if the internal reference is not being used, write to the ADC mode register, disabling the internal reference. This is controlled by the REF_EN bit (Bit 15) in the ADC mode register
Communication Protocol: SPI

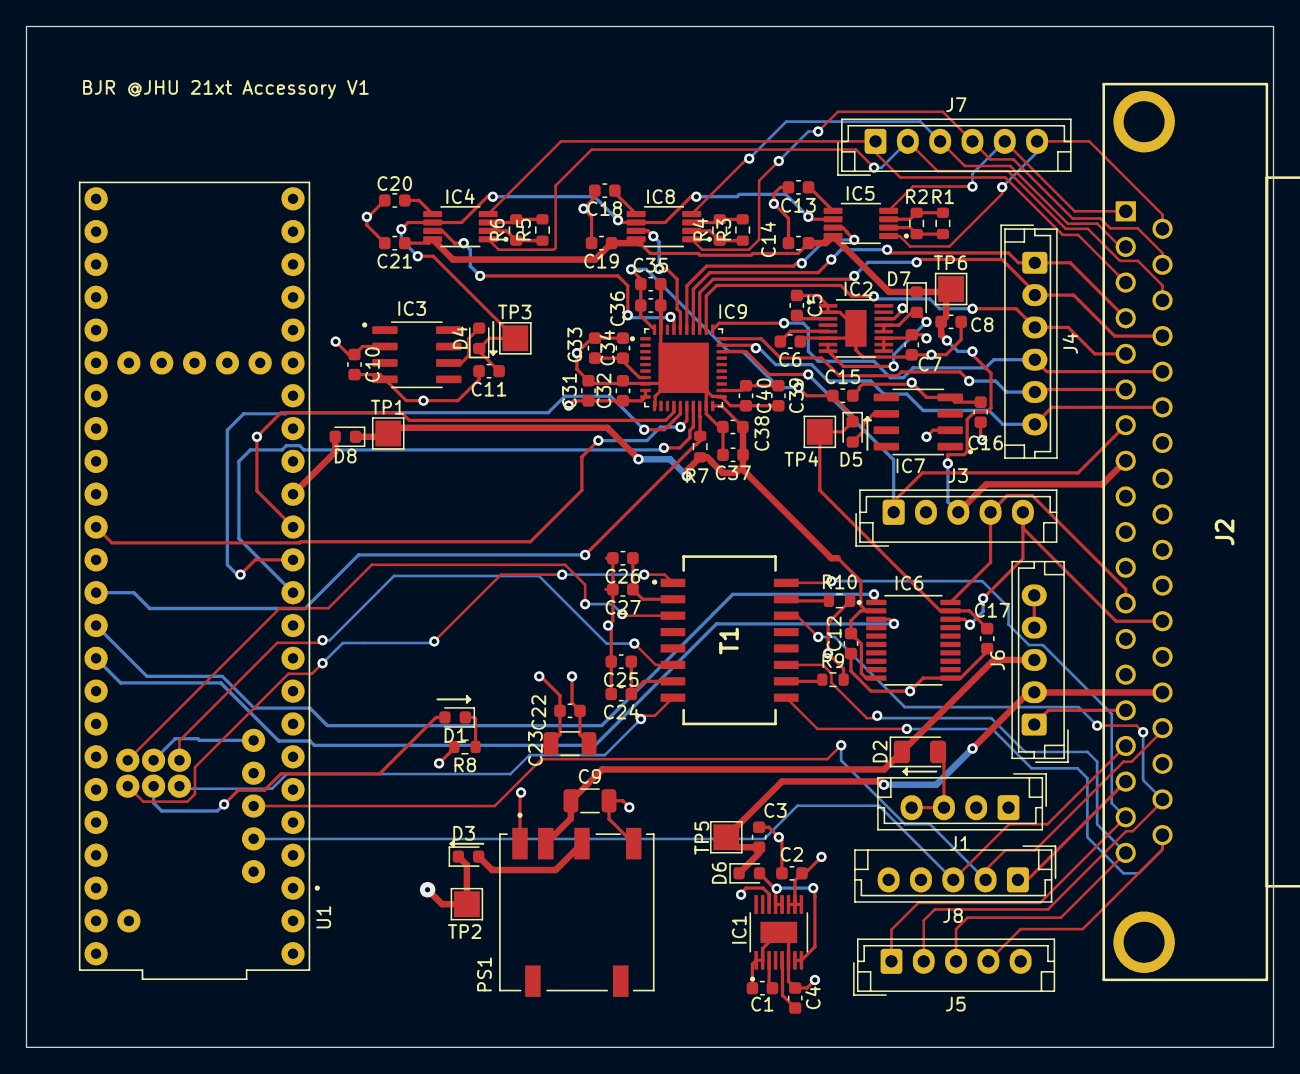
[picture p95: board accessoryidk.kicad_pcb from above]

Board: 4 copper layers, 96.5 x 79.0 mm, 81 parts (0 on the bottom side), 71 nets.
