BlueJayRacing/bjr_kicad/21xt/02-mainbox/bjr_kicad_aaren_copy/21xt/03-wireless_strain_gauge/wsg1.0/wsg1.0.kicad_pcb

## KiCad design 21xt/02-mainbox/bjr_kicad_aaren_copy/21xt/03-wireless_strain_gauge/wsg1.0/wsg1.0.kicad_pcb (2024-08-29)

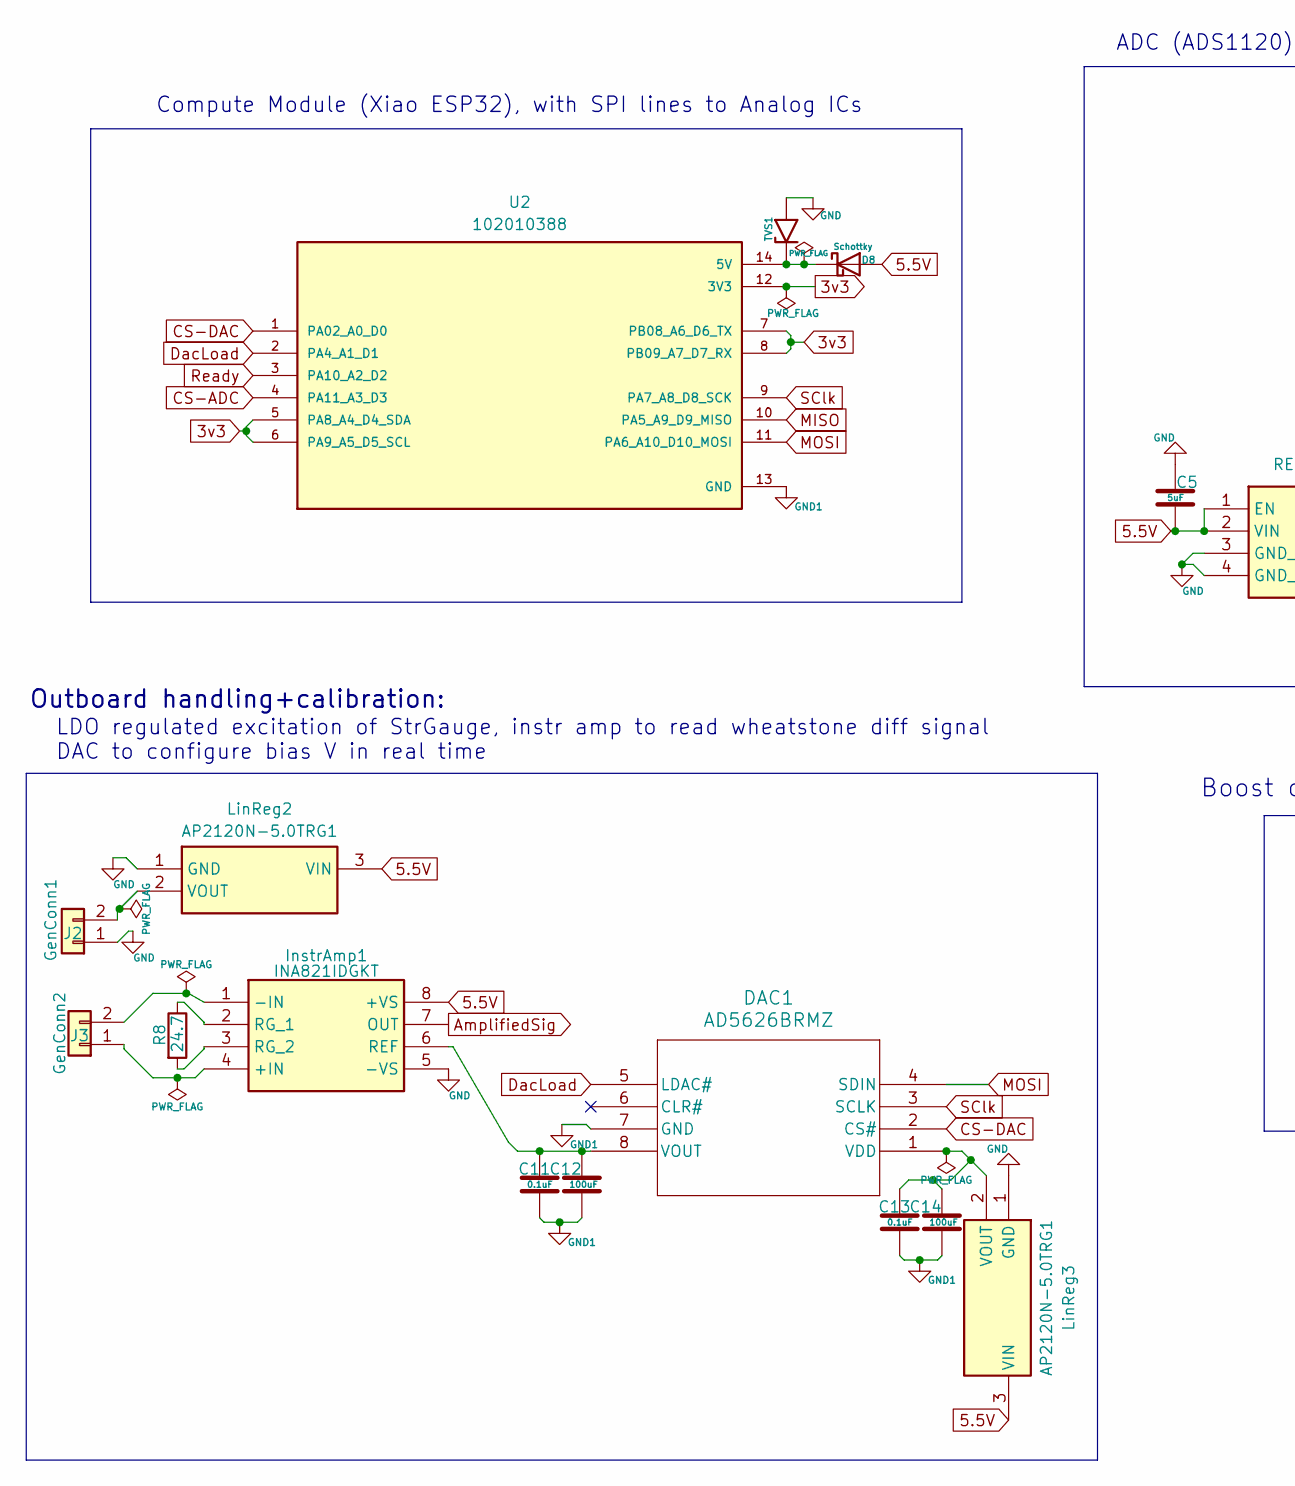
[picture p96: schematic wsg1.0.kicad_sch, part in row 1, column 1]

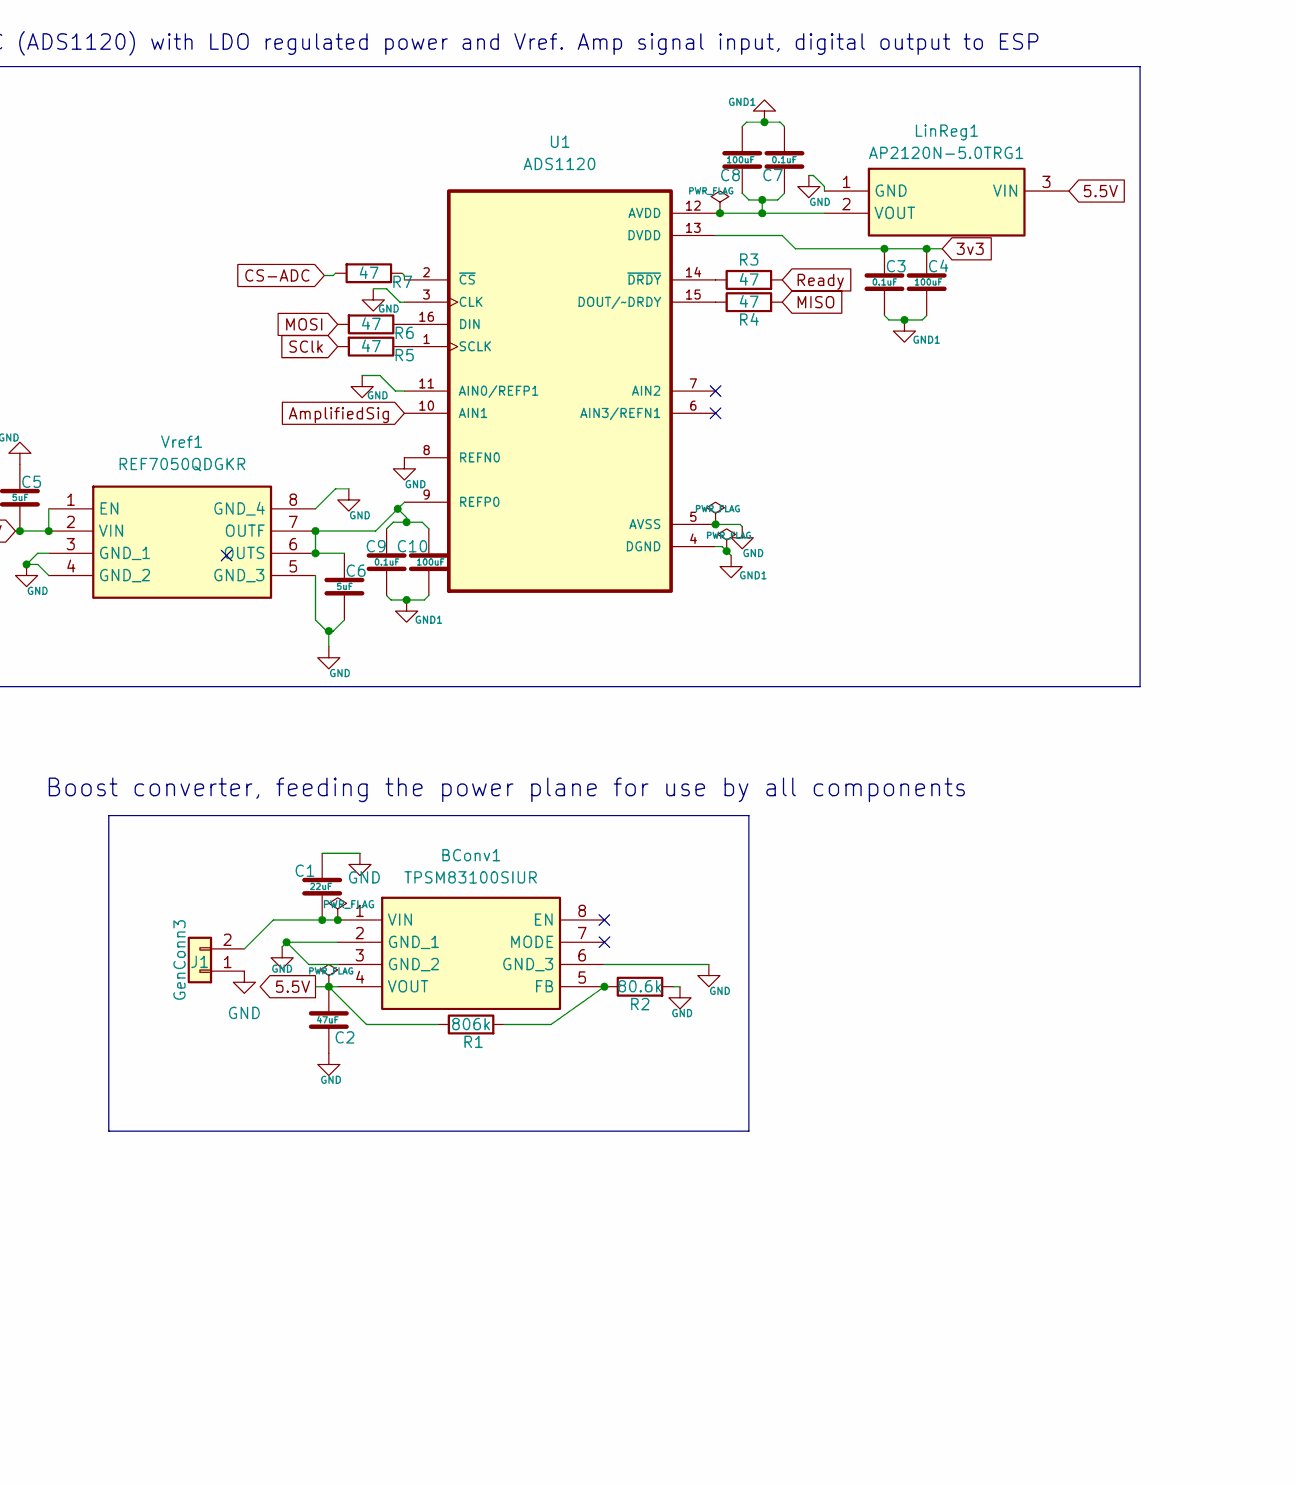
[picture p97: schematic wsg1.0.kicad_sch, part in row 1, column 2]

Parts:
BConv1: TPSM83100SIUR; Mouser Part Number 595-TPSM83100SIUR
C1: 22uF; C_0603_1608Metric
C2: 47uF; C_0603_1608Metric
C3, C7, C9, C11, C13: 0.1uF; C_0603_1608Metric
C4, C8, C10, C12, C14: 100uF; C_0603_1608Metric
C5, C6: 5uF; C_0603_1608Metric
D8: Schottky; D_0603_1608Metric
DAC1: AD5626BRMZ; AD5626
InstrAmp1: INA821IDGKT; INA821; Mouser Part Number 595-INA821IDGKT
J1: GenConn3; MOLEX_2pinSMD
J2: GenConn1; MOLEX_2pinSMD
J3: GenConn2; MOLEX_2pinSMD
LinReg1, LinReg2, LinReg3: AP2120N-5.0TRG1; SOT91P240X110-3N; Mouser Part Number 621-AP2120N-5.0TRG1
R1: 806k; R_0805_2012Metric
R2: 80.6k; R_0603_1608Metric
R3, R4, R5, R6, R7: 47; R_0603_1608Metric
R8: 24.7; R_0603_1608Metric
TVS1: 1.5KExxA; D_0603_1608Metric
U1: ADS1120; SOP65P640X120-16N
U2: 102010388; MODULE_102010388; PARTREV N/A
Vref1: REF7050QDGKR; REF70; Manufacturer_Part_Number REF7050QDGKR

Connections:
3v3: C3.1, C4.1, U1.13 (DVDD), U2.5 (PA8_A4_D4_SDA), U2.6 (PA9_A5_D5_SCL), U2.7 (PB08_A6_D6_TX), U2.8 (PB09_A7_D7_RX), U2.12 (3V3)
5.5V: BConv1.4 (VOUT), C2.1, C5.2, D8.2 (A), InstrAmp1.8 (+VS), LinReg1.3 (VIN), LinReg2.3 (VIN), LinReg3.3 (VIN), R1.1, Vref1.1 (EN), Vref1.2 (VIN)
AmplifiedSig: InstrAmp1.7 (OUT), U1.10 (AIN1)
CS-ADC: R7.2, U2.4 (PA11_A3_D3)
CS-DAC: DAC1.2 (CS#), U2.1 (PA02_A0_D0)
DacLoad: DAC1.5 (LDAC#), U2.2 (PA4_A1_D1)
GND: BConv1.2 (GND_1), BConv1.3 (GND_2), BConv1.6 (GND_3), C1.1, C2.2, C5.1, C6.2, InstrAmp1.5 (-VS), J1.1, J2.1, LinReg1.1 (GND), LinReg2.1 (GND), LinReg3.1 (GND), R2.2, TVS1.2 (A2), U1.3 (CLK), U1.5 (AVSS), U1.8 (REFN0), U1.11 (AIN0/REFP1), Vref1.3 (GND_1), Vref1.4 (GND_2), Vref1.5 (GND_3), Vref1.8 (GND_4)
GND1: C3.2, C4.2, C7.2, C8.2, C9.2, C10.2, C11.2, C12.2, C13.2, C14.2, DAC1.7 (GND), U1.4 (DGND), U2.13 (GND)
MISO: R4.2, U2.10 (PA5_A9_D9_MISO)
MOSI: DAC1.4 (SDIN), R6.2, U2.11 (PA6_A10_D10_MOSI)
unnamed: BConv1.5 (FB), R1.2, R2.1
unnamed: BConv1.1 (VIN), C1.2, J1.2
unnamed: D8.1 (K), TVS1.1 (A1), U2.14 (5V)
unnamed: C13.1, C14.1, DAC1.1 (VDD), LinReg3.2 (VOUT)
unnamed: C11.1, C12.1, DAC1.8 (VOUT), InstrAmp1.6 (REF)
unnamed: InstrAmp1.4 (+IN), J3.1
unnamed: InstrAmp1.1 (-IN), J3.2
unnamed: InstrAmp1.2 (RG_1), R8.1
unnamed: InstrAmp1.3 (RG_2), R8.2
unnamed: J2.2, LinReg2.2 (VOUT)
unnamed: C7.1, C8.1, LinReg1.2 (VOUT), U1.12 (AVDD)
unnamed: R6.1, U1.16 (DIN)
unnamed: R4.1, U1.15 (DOUT/~DRDY)
unnamed: C6.1, C9.1, C10.1, U1.9 (REFP0), Vref1.6 (OUTS), Vref1.7 (OUTF)
unnamed: R5.1, U1.1 (SCLK)
unnamed: R7.1, U1.2 (~CS)
unnamed: R3.1, U1.14 (~DRDY)
Ready: R3.2, U2.3 (PA10_A2_D2)
SClk: DAC1.3 (SCLK), R5.2, U2.9 (PA7_A8_D8_SCK)

Notes on the sheet:
DAC to configure bias V in real time
Compute Module (Xiao ESP32), with SPI lines to Analog ICs
LDO regulated excitation of StrGauge, instr amp to read wheatstone diff signal
Boost converter, feeding the power plane for use by all components
Outboard handling+calibration:
ADC (ADS1120) with LDO regulated power and Vref. Amp signal input, digital output to ESP

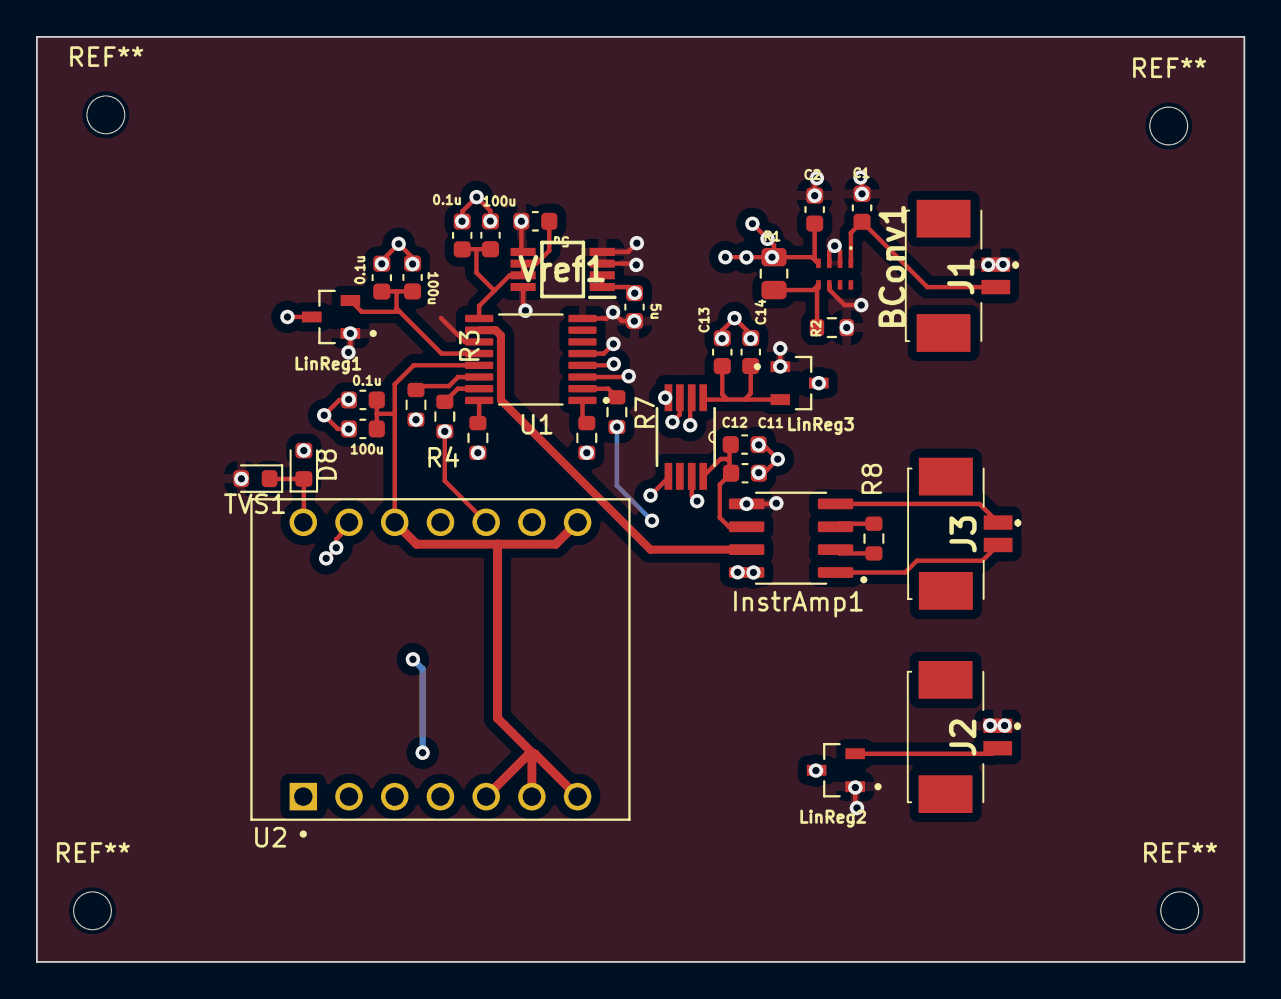
[picture p98: board wsg1.0.kicad_pcb from above]

Board: 4 copper layers, 67.1 x 51.4 mm, 36 parts (0 on the bottom side), 29 nets.
