BlueJayRacing/bjr_kicad/21xt/02-mainbox/mainbox2.0/mainbox2.0.kicad_pcb

## KiCad design 21xt/02-mainbox/mainbox2.0/mainbox2.0.kicad_pcb (2025-01-04)

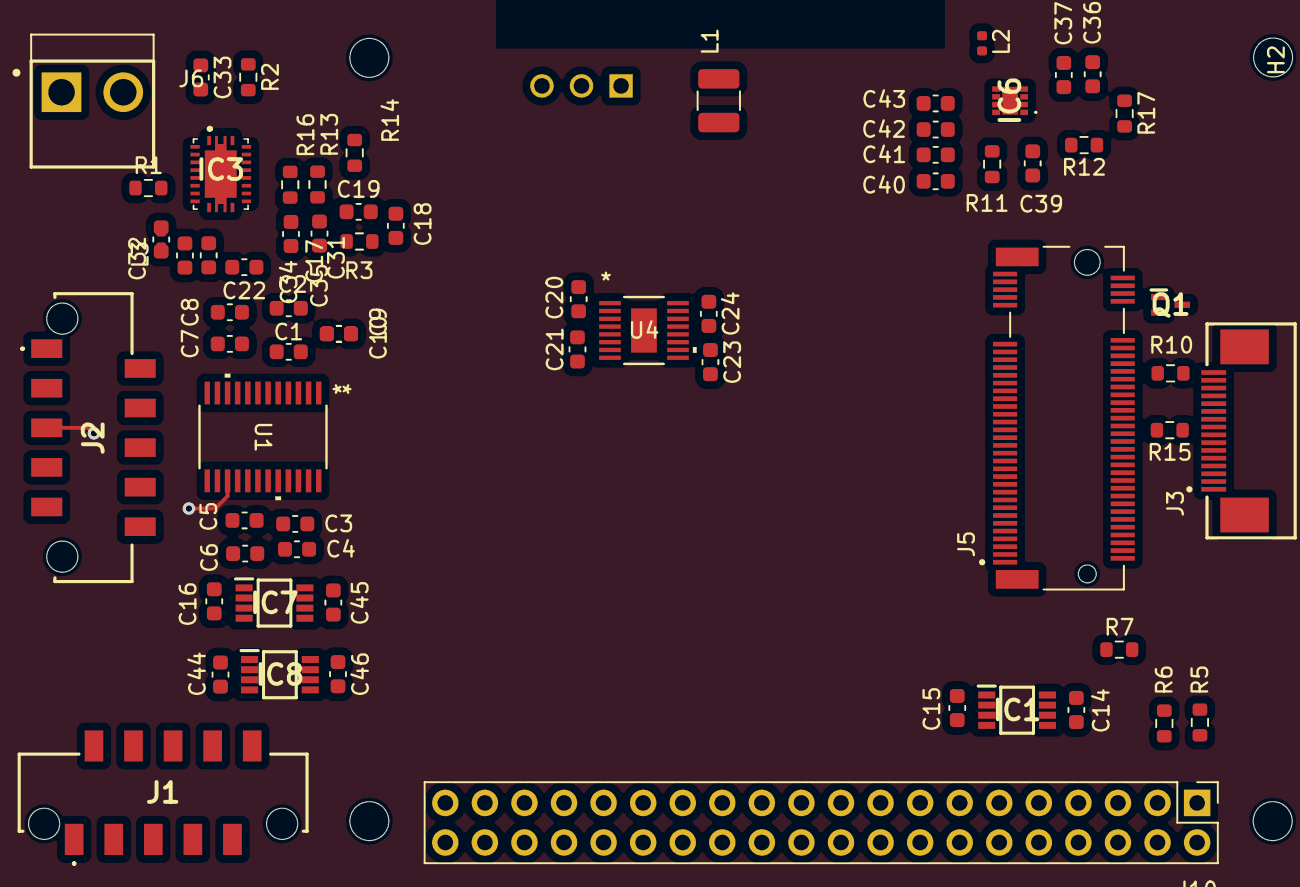
[picture p99: board mainbox2.0.kicad_pcb from above]

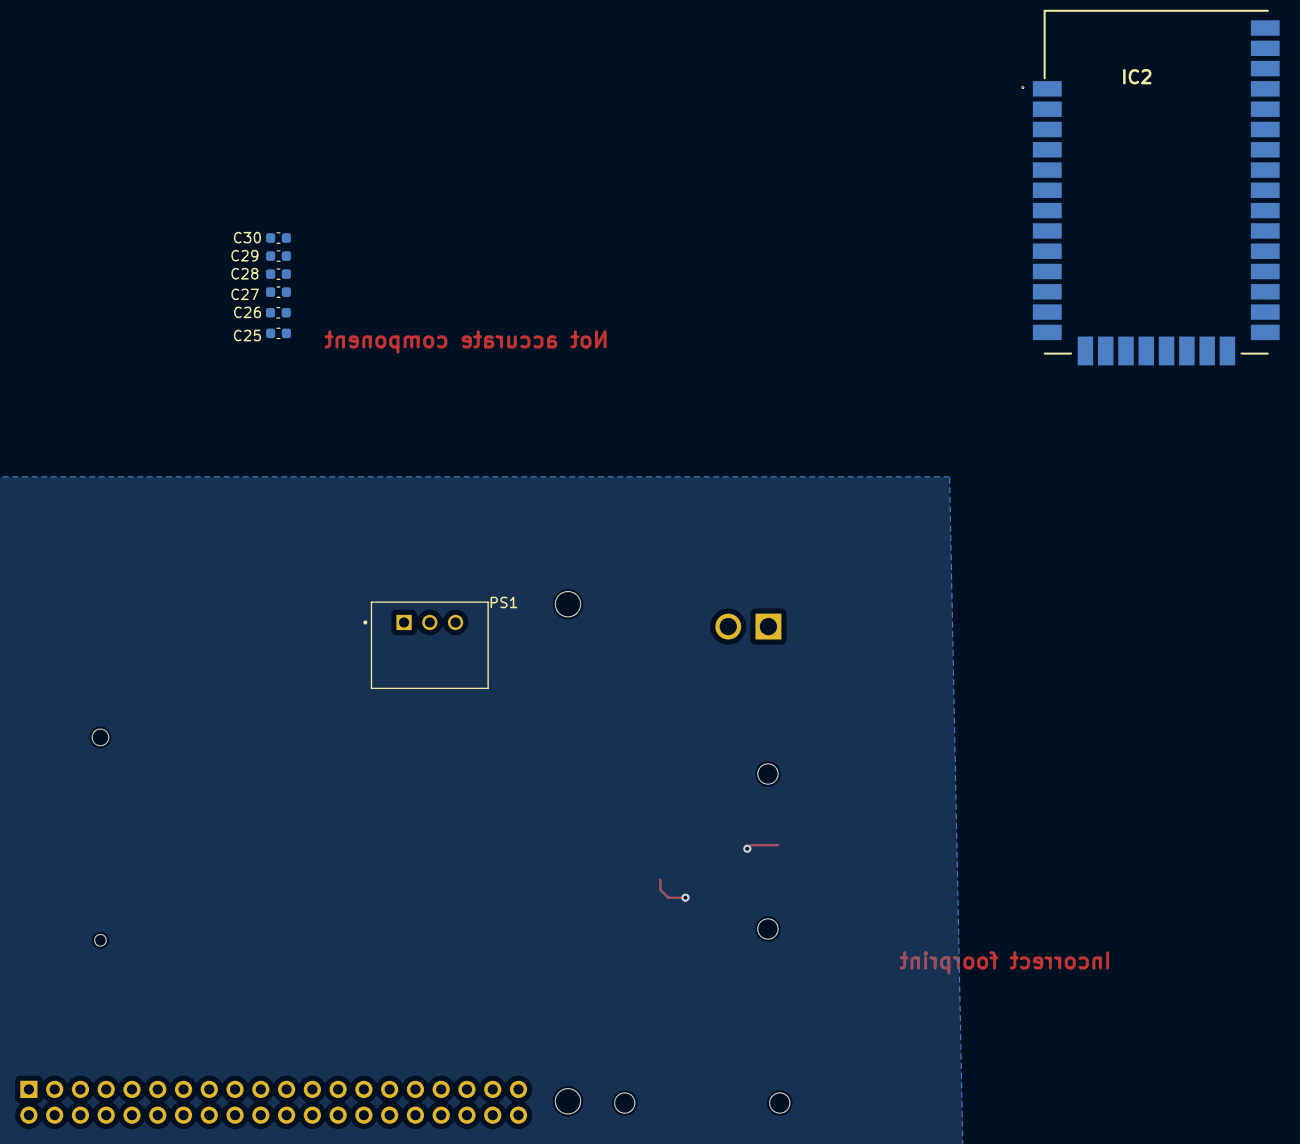
[picture p100: board mainbox2.0.kicad_pcb from below]

Board: 4 copper layers, 79 parts (8 on the bottom side), 57 nets.

Parts:
C1, C3, C5, C7, C10, C14, C15, C16, C17, C20, C21, C23, C27, C31, C32, C44, C45, C46: 0.1uF; C_0603_1608Metric
C2, C4, C8, C24, C34: 1uF; C_0603_1608Metric
C6, C9, C25, C28, C36, C37, C40, C41, C42, C43: 10uF; C_0603_1608Metric
C18: 0.6nF; C_0603_1608Metric
C19: 3.1pF; C_0603_1608Metric
C22: 47nF; C_0603_1608Metric
C26: 4.7uF; C_0603_1608Metric
C29: 47pF; C_0603_1608Metric
C30: 8.2pF; C_0603_1608Metric
C33: 3.3uF; C_0603_1608Metric
C35: 47uF; C_0603_1608Metric
C39: 15pF; C_0603_1608Metric
H1, H2, H3, H4: MountingHole; MountingHole_2.5mm
IC1, IC7, IC8: SN74LVC2T45DCTTG4; SOP65P400X130-8N
IC2: XBP9X-DMUS-011; RLS397
IC3: TPS61088QRHLTQ1; BQ24123RHLT
IC6: AP3441LSHE-7B; AP3441LSHE7B
J1, J2: Conn_01x10; 908160010(picolex-10)
J3: Conn_01x16; SAMTEC_ZF5S-16-01-T-WT
J5: MDT275M02001; AMPHENOL_MDT275M02001
J6: Conn_01x02; JST_B2P-VH_LF__SN_(2 pin)
J10: Conn_02x20_Odd_Even; PinHeader_2x20_P2.54mm_Vertical
L1: 3.9uH; L_1210_3225Metric
L2: 22uH; L_0402_1005Metric
L3: 1.2uH; L_0402_1005Metric
PS1: R-78B3.3-1.5L; CONV_R-78B3.3-1.5
Q1: DMG1012T-7; SOT50P160X90-3N(DIODE)
R1: 225k; R_0603_1608Metric
R2: 49.9k; R_0603_1608Metric
R3: 125k; R_0603_1608Metric
R5, R6: 68; R_0603_1608Metric
R7, R15: 100k; R_0603_1608Metric
R10: 33; R_0603_1608Metric
R11, R17: 10k; R_0603_1608Metric
R12: 22k; R_0603_1608Metric
R13: 290k; R_0603_1608Metric
R14: 56k; R_0603_1608Metric
R16: 60k; R_0603_1608Metric
U1: AD7175-2BRUZ; RU_24_ADI
U4: LT6658AHMSE-5-PBF; LT6658AHMSE-2.5-PBF

Connections:
3V3: C5.1, C6.1, C14.2, C16.2, C44.2, IC1.8 (VCCB), IC7.1 (VCCA), IC8.1 (VCCA), J10.17, U1.16 (IOVDD)
3V3_PG: IC6.2 (PG), Q1.1 (G), R17.2
3V3_XBEE: C27.2, C28.2, C29.2, C30.2, IC2.2 (VCC), PS1.3 (+VOUT)
5.2V: C15.2, C25.1, C26.1, C36.1, C37.1, C45.2, C46.2, IC1.1 (VCCA), IC6.3 (VIN), IC7.8 (VCCB), IC8.8 (VCCB), J1.7, J6.2, J10.2, J10.4, L1.1, R17.1
5VADC/SENSOR: C7.2, C8.2, J2.6, U1.7 (AVDD1), U1.8 (AVDD2), U4.7 (VOUT2_S), U4.8 (VOUT2_F)
5VRef: C9.2, C10.2, C24.2, U1.3 (REF+), U4.12 (VOUT1_F), U4.13 (VOUT1_S)
7.5VBOOST: C23.1, C34.2, C35.2, IC3.14 (VOUT_1), IC3.15 (VOUT_2), IC3.16 (VOUT_3), R13.1, R16.1, U4.9 (*OD), U4.10 (VIN2), U4.11 (VIN1), U4.14 (VIN)
ANI1: J2.1, U1.22 (AIN1)
ANI2: J2.2, U1.23 (AIN2)
ANI3: J2.3, U1.24 (AIN3)
ANI4: J2.4, U1.1 (AIN4)
CS: J10.24, U1.14 (*CS)
DIGITAL_INPUT_1: IC8.7 (B1), J2.7
DIGITAL_INPUT_2: IC8.6 (B2), J2.8
DIGITAL_INPUT_3: IC7.7 (B1), J2.9
DIGITAL_INPUT_4: IC7.6 (B2), J2.10
DIGITAL_OUTPUT_1: IC8.2 (A1), J10.3
DIGITAL_OUTPUT_2: IC8.3 (A2), J10.5
DIN: J10.19, U1.12 (DIN)
DINXBee: IC2.4 (DIN/DIO14/~CONFIG), R6.1, R7.1
DOUT: J10.21, U1.11 (DOUT/*RDY)
DOUTXBee: IC2.3 (DIO13/DOUT), R5.2
GND: C1.2, C2.2, C3.1, C4.1, C5.2, C6.2, C7.1, C8.1, C9.1, C10.1, C14.1, C15.1, C16.1, C17.2, C18.2, C19.2, C20.1, C21.1, C22.2, C23.2, C24.1, C25.2, C26.2, C27.1, C28.1, C29.1, C30.1, C31.2, C33.1, C34.1, C35.1, C36.2, C37.2, C40.2, C41.2, C42.2, C43.2, C44.1, C45.1, C46.1, IC1.4 (GND), IC1.5 (DIR), IC2.1 (GND_1), IC2.11 (GND_2), IC2.13 (GND_3), IC2.22 (GND_4), IC2.35 (GND_5), IC3.11 (NC_1), IC3.12 (NC_2), IC3.20 (AGND), IC3.21 (PGND_1), IC3.22 (PGND_2), IC3.23 (PGND_3), IC3.24 (PGND_4), IC3.25 (PGND_5), IC3.26 (PGND_6), IC3.27 (PGND_7), IC6.4 (PGND), IC6.8 (SGND), IC6.9 (EP), IC7.4 (GND), IC7.5 (DIR), IC8.4 (GND), IC8.5 (DIR), J1.8, J2.5, J3.12, J5.1, J5.3, J5.9, J5.15, J5.21, J5.27, J5.33, J5.39, J5.45, J5.51, J5.57, J5.71, J5.73, J5.75, J6.1, J10.6, J10.9, PS1.2 (GND), R2.1, R12.1, R14.2, R15.2, U1.2 (REF-), U1.6 (AVSS), U1.15 (*SYNC/*ERROR), U1.17 (DGND), U4.1 (GND), U4.2 (GND), U4.6 (GND), U4.EPAD
IN1(3.3V): IC1.7 (B1), J10.11
IN1(5V): IC1.2 (A1), J1.9
IN2(3.3V): IC1.6 (B2), J10.13
IN2(5V): IC1.3 (A2), J1.10
unnamed: C18.1, R3.2
unnamed: C32.1, IC3.8 (BOOT)
unnamed: C19.1, IC3.18 (COMP), R3.1
unnamed: IC3.17 (FB), R13.2, R14.1, R16.2
unnamed: IC3.3 (FSW), R1.2
unnamed: IC3.19 (ILIM), R2.2
unnamed: C22.1, IC3.10 (SS)
unnamed: C32.2, IC3.4 (SW_1), IC3.5 (SW_2), IC3.6 (SW_3), IC3.7 (SW_4), L3.2, R1.1
unnamed: C33.2, IC3.1 (VCC)
unnamed: C39.1, C39.2, IC6.1 (FB), R11.2, R12.2
unnamed: IC6.6 (LX), L2.1
unnamed: J3.16, R10.1
unnamed: J10.8, R5.1
unnamed: J10.10, R6.2
unnamed: L1.2, PS1.1 (+VIN)
unnamed: C1.1, C2.1, U1.5 (REGCAPA)
unnamed: C3.2, C4.2, U1.18 (REGCAPD)
unnamed: C20.2, U4.3 (BYPASS)
unnamed: C21.2, U4.5 (NR)
PCIE0 TX+: J3.10, J5.49
PCIE0 TX-: J3.11, J5.47
PCIE_CLKREQ_N: J3.15, J5.52
PCIE_PWR_EN: IC6.7 (EN), J3.13, R15.1
PCIE_RST_B: Q1.3 (D), R10.2
PCIE_RST_B_SW: J5.50, Q1.2 (S)
SCLK: J10.23, U1.13 (SCLK)
STEERING_WHEEL_RX: J1.6, J10.29
STEERING_WHEEL_TX: J1.5, J10.27
VCC3V3: C40.1, C41.1, C42.1, C43.1, J5.2, J5.4, J5.12, J5.14, J5.16, J5.18, J5.70, J5.72, J5.74, L2.2, R11.1
Vin: C17.1, C31.1, IC3.2 (EN), IC3.9 (VIN), L3.1
