BlueJayRacing/bjr_kicad/21xt/02-mainbox/bjr_kicad_aaren_copy/21xt/03-wireless_strain_gauge/AD5626_Breakout/AD5626_Breakout.kicad_pcb

## KiCad design 21xt/02-mainbox/bjr_kicad_aaren_copy/21xt/03-wireless_strain_gauge/AD5626_Breakout/AD5626_Breakout.kicad_pcb (2024-08-29)

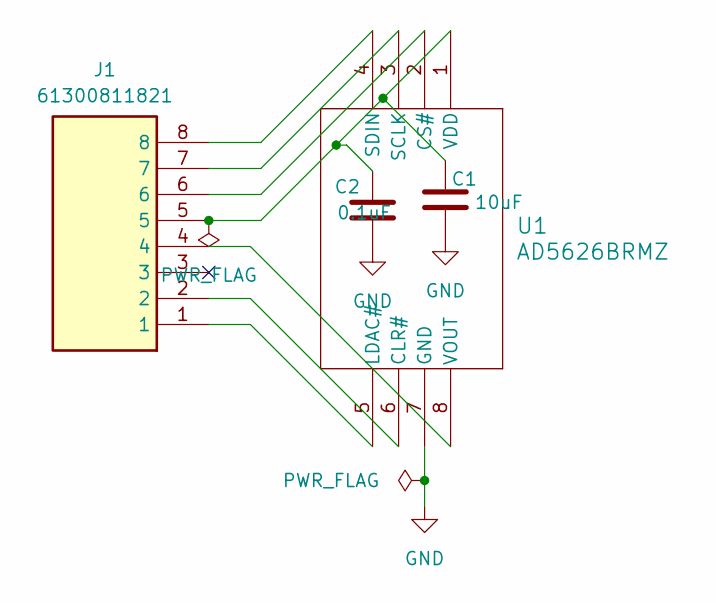
[picture p101: schematic AD5626_Breakout.kicad_sch]

Parts:
C1: 10uF; C_0603_1608Metric_Pad1.08x0.95mm_HandSolder
C2: 0.1uF; C_0603_1608Metric_Pad1.08x0.95mm_HandSolder
J1: 61300811821; RHDR8W60P0X254_1X8_2082X250X850P; Mouser Part Number 710-61300811821
U1: AD5626BRMZ; AD5626

Connections:
GND: C1.2, C2.2, U1.7 (GND)
unnamed: J1.2, U1.6 (CLR#)
unnamed: J1.6, U1.2 (CS#)
unnamed: J1.1, U1.5 (LDAC#)
unnamed: J1.7, U1.3 (SCLK)
unnamed: J1.8, U1.4 (SDIN)
unnamed: C1.1, C2.1, J1.5, U1.1 (VDD)
unnamed: J1.4, U1.8 (VOUT)

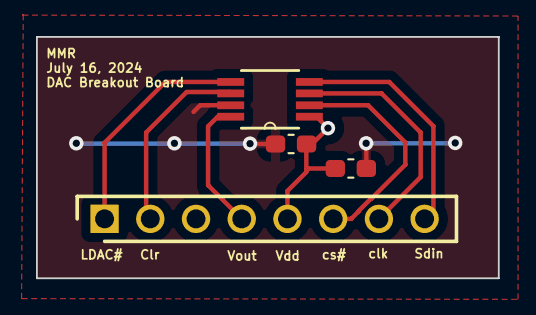
[picture p102: board AD5626_Breakout.kicad_pcb from above]

Board: 2 copper layers, 25.7 x 13.4 mm, 4 parts (0 on the bottom side), 8 nets.
