BlueJayRacing/bjr_kicad/21xt/03-wireless_strain_gauge/PumpDACBreakout/Untitled.kicad_pcb

## KiCad design 21xt/03-wireless_strain_gauge/PumpDACBreakout/Untitled.kicad_pcb (2025-01-04)

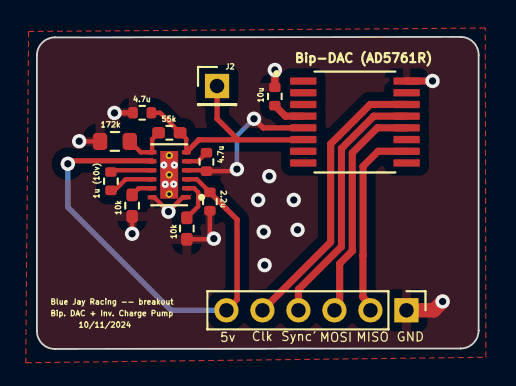
[picture p103: board Untitled.kicad_pcb from above]

Board: 2 copper layers, 24.5 x 17.3 mm, 13 parts (0 on the bottom side), 14 nets.

Parts:
1u (10v): 1u (10V); R_0402_1005Metric
4.7u, 4.7u#2: 4.7u; R_0402_1005Metric
10k: 10k; R_0402_1005Metric_Pad0.72x0.64mm_HandSolder
55k: 55k; R_0402_1005Metric_Pad0.72x0.64mm_HandSolder
Bip-DAC (AD5761R): AD5721RBRUZ; AD5721
C1: 10u; R_0402_1005Metric
C4: 2.2u; R_0402_1005Metric
J1: Conn_01x06; PinHeader_1x06_P2.00mm_Vertical
J2: Conn_01x01; PinHeader_1x01_P2.00mm_Vertical
PS1: LM27762DSSR; LM27762DSST
R2: 10k; R_0402_1005Metric_Pad0.72x0.64mm_HandSolder
R5: 172k; R_0603_1608Metric

Connections:
-5v: 4.7u.1, 55k.1, Bip-DAC (AD5761R).6 (VSS), J2.1, PS1.6 (OUT-)
GND: 4.7u.2, 4.7u#2.2, 10k.2, Bip-DAC (AD5761R).5 (AGND), Bip-DAC (AD5761R).16 (DGND), C1.1, C4.1, J1.1, PS1.1 (PGOOD), PS1.4 (GND), PS1.12 (EN+), PS1.13 (PAD), R2.2, R5.2
MISO: Bip-DAC (AD5761R).10 (SDO), J1.2
MOSI: Bip-DAC (AD5761R).12 (SDI), J1.3
unnamed: Bip-DAC (AD5761R).4 (VREFIN/VREFOUT), C1.2
unnamed: 1u (10v).1, PS1.10 (C1+)
unnamed: 1u (10v).2, PS1.9 (C1-)
unnamed: 4.7u#2.1, PS1.5 (CP)
unnamed: PS1.2 (FB+), R2.1
unnamed: 55k.2, PS1.7 (FB-), R5.1
unnamed: 10k.1, PS1.11 (OUT+)
Sclk: Bip-DAC (AD5761R).14 (SCLK), J1.5
Sync': Bip-DAC (AD5761R).13 (~SYNC), J1.4
Vin: Bip-DAC (AD5761R).8 (VDD), Bip-DAC (AD5761R).15 (DVCC), C4.2, J1.6, PS1.3 (VIN), PS1.8 (EN-)
