BlueJayRacing/bjr_kicad/21xt/03-wireless_strain_gauge/usb_c_daughter/usb_c_daughter.kicad_pcb

## KiCad design 21xt/03-wireless_strain_gauge/usb_c_daughter/usb_c_daughter.kicad_pcb (2025-01-04)

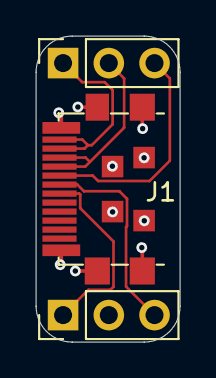
[picture p104: board usb_c_daughter.kicad_pcb from above]

Board: 2 copper layers, 8.0 x 17.0 mm, 3 parts (0 on the bottom side), 6 nets.

Parts:
J1: USB_C_Plug_USB2.0; USB_C_MOUNT
J3: Conn_01x03; PinHeader_1x03_P2.54mm_Vertical
Je: Conn_01x03; PinSocket_1x03_P2.54mm_Vertical

Connections:
CC: J1.A5 (CC), Je.3
D+: J1.A6 (D+), J3.3
D-: J1.A7 (D-), J3.1
GND: J1.A1 (GND), J1.B12 (GND), Je.1
SHIELD: J1.S1 (SHIELD), J3.2
VBUS: J1.A4 (VBUS), J1.B9 (VBUS), Je.2
