BlueJayRacing/bjr_kicad/21xt/03-wireless_strain_gauge/SPIBreakout/SPIBreakout.kicad_pcb

## KiCad design 21xt/03-wireless_strain_gauge/SPIBreakout/SPIBreakout.kicad_pcb (2025-01-04)

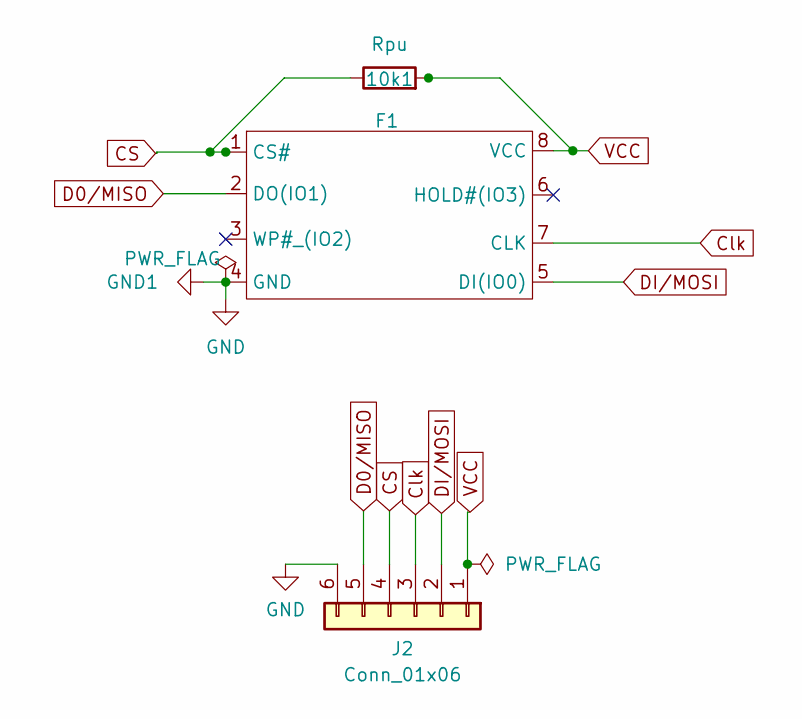
[picture p105: schematic SPIBreakout.kicad_sch]

Parts:
10k1: Rpu; R_0603_1608Metric
F1: SPIFLASH
J2: Conn_01x06; PinHeader_1x06_P2.00mm_Vertical

Connections:
CS: 10k1.1, F1.1 (CS#), J2.4
Clk: F1.7 (CLK), J2.3
D0/MISO: F1.2 (DO(IO1)), J2.5
DI/MOSI: F1.5 (DI(IO0)), J2.2
GND: F1.4 (GND), J2.6
VCC: 10k1.2, F1.8 (VCC), J2.1

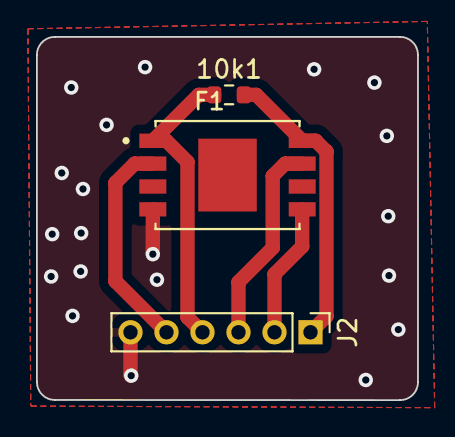
[picture p106: board SPIBreakout.kicad_pcb from above]

Board: 2 copper layers, 21.2 x 20.2 mm, 3 parts (0 on the bottom side), 6 nets.
