BlueJayRacing/bjr_kicad/21xt/01-accessory/accessory_peripheral/accessory_peripheral/accessory_peripheral.kicad_pcb

## KiCad design 21xt/01-accessory/accessory_peripheral/accessory_peripheral/accessory_peripheral.kicad_pcb (2025-01-04)

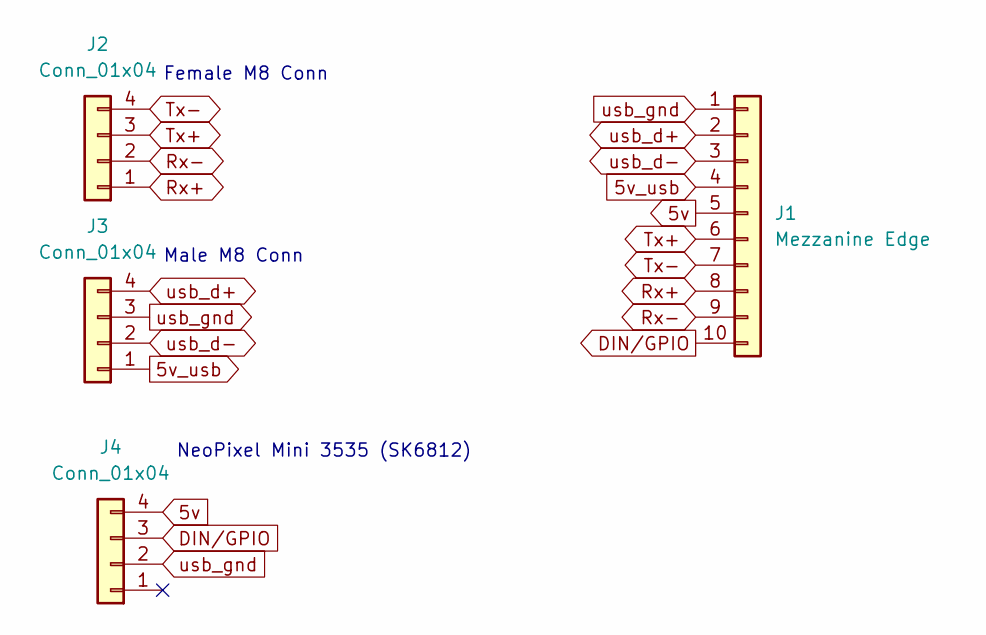
[picture p107: schematic accessory_peripheral.kicad_sch]

Parts:
J1: Mezzanine Edge; Double Sided Mezzanine Card Edge_Connector Side
J2: Conn_01x04; T4041017041000
J3: Conn_01x04; T4040014041000
J4: Conn_01x04; LED_SK6812MINI_PLCC4_3.5x3.5mm_P1.75mm

Connections:
5v: J1.5, J4.4
5v_usb: J1.4, J3.1
DIN/GPIO: J1.10, J4.3
Rx+: J1.8, J2.1
Rx-: J1.9, J2.2
Tx+: J1.6, J2.3
Tx-: J1.7, J2.4
usb_d+: J1.2, J3.4
usb_d-: J1.3, J3.2
usb_gnd: J1.1, J3.3, J4.2

Notes on the sheet:
Female M8 Conn
NeoPixel Mini 3535 (SK6812)
Male M8 Conn

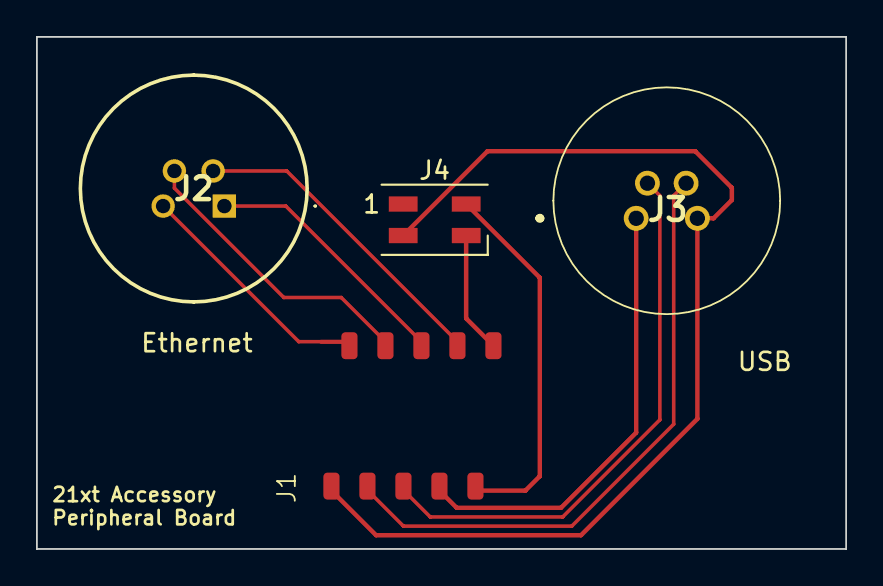
[picture p108: board accessory_peripheral.kicad_pcb from above]

Board: 2 copper layers, 45.0 x 28.4 mm, 4 parts (0 on the bottom side), 10 nets.
