BlueJayRacing/bjr_kicad/21xt/01-accessory/ad5689r/ad5689r.kicad_pcb

## KiCad design 21xt/01-accessory/ad5689r/ad5689r.kicad_pcb (2025-01-04)

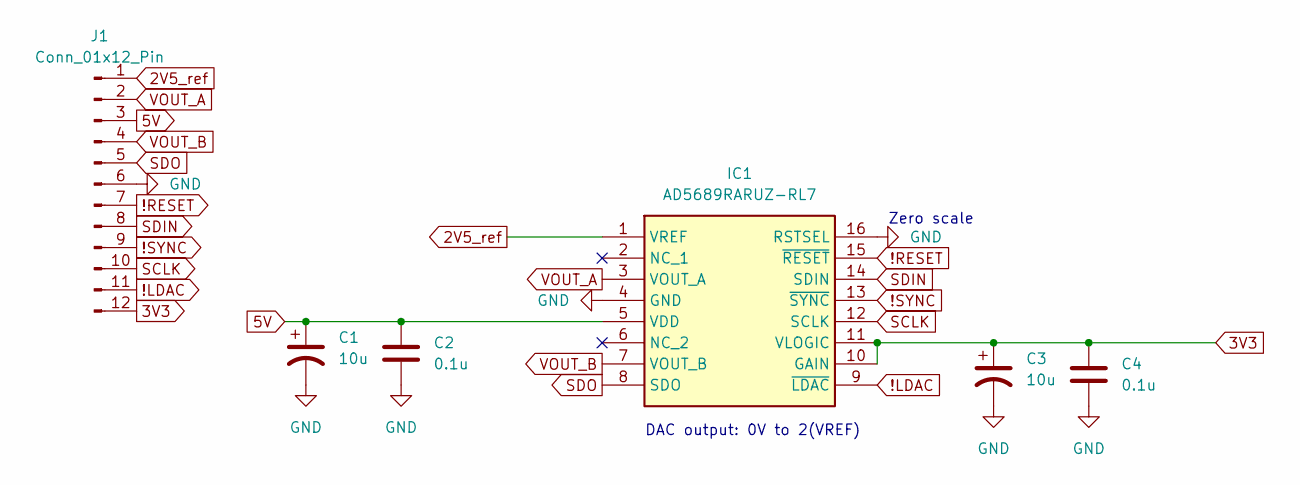
[picture p109: schematic ad5689r.kicad_sch]

Parts:
C1, C3: 10u; CAP_TPS_A_AVX
C2, C4: 0.1u; C_0603_1608Metric
IC1: AD5689RARUZ-RL7; SOP65P640X120-16N; Mouser Part Number 584-AD5689RARUZ-R7
J1: Conn_01x12_Pin; 6pin-6pin breadboard

Connections:
2V5_ref: IC1.1 (VREF), J1.1
3V3: C3.1, C4.1, IC1.10 (GAIN), IC1.11 (VLOGIC), J1.12
5V: C1.1, C2.1, IC1.5 (VDD), J1.3
!LDAC: IC1.9 (~LDAC), J1.11
!RESET: IC1.15 (~RESET), J1.7
!SYNC: IC1.13 (~SYNC), J1.9
GND: C1.2, C2.2, C3.2, C4.2, IC1.4 (GND), IC1.16 (RSTSEL), J1.6
SCLK: IC1.12 (SCLK), J1.10
SDIN: IC1.14 (SDIN), J1.8
SDO: IC1.8 (SDO), J1.5
VOUT_A: IC1.3 (VOUT_A), J1.2
VOUT_B: IC1.7 (VOUT_B), J1.4

Notes on the sheet:
DAC output: 0V to 2(VREF)
Zero scale

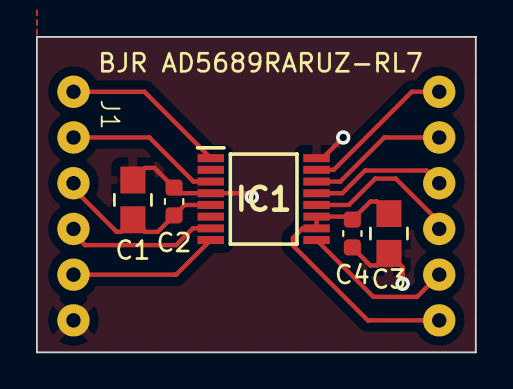
[picture p110: board ad5689r.kicad_pcb from above]

Board: 2 copper layers, 24.4 x 17.5 mm, 6 parts (0 on the bottom side), 12 nets.
