BlueJayRacing/bjr_kicad/21xt/02-mainbox/mainbox1.0/mainbox1.0.kicad_pcb

## KiCad design 21xt/02-mainbox/mainbox1.0/mainbox1.0.kicad_pcb (2025-01-04)

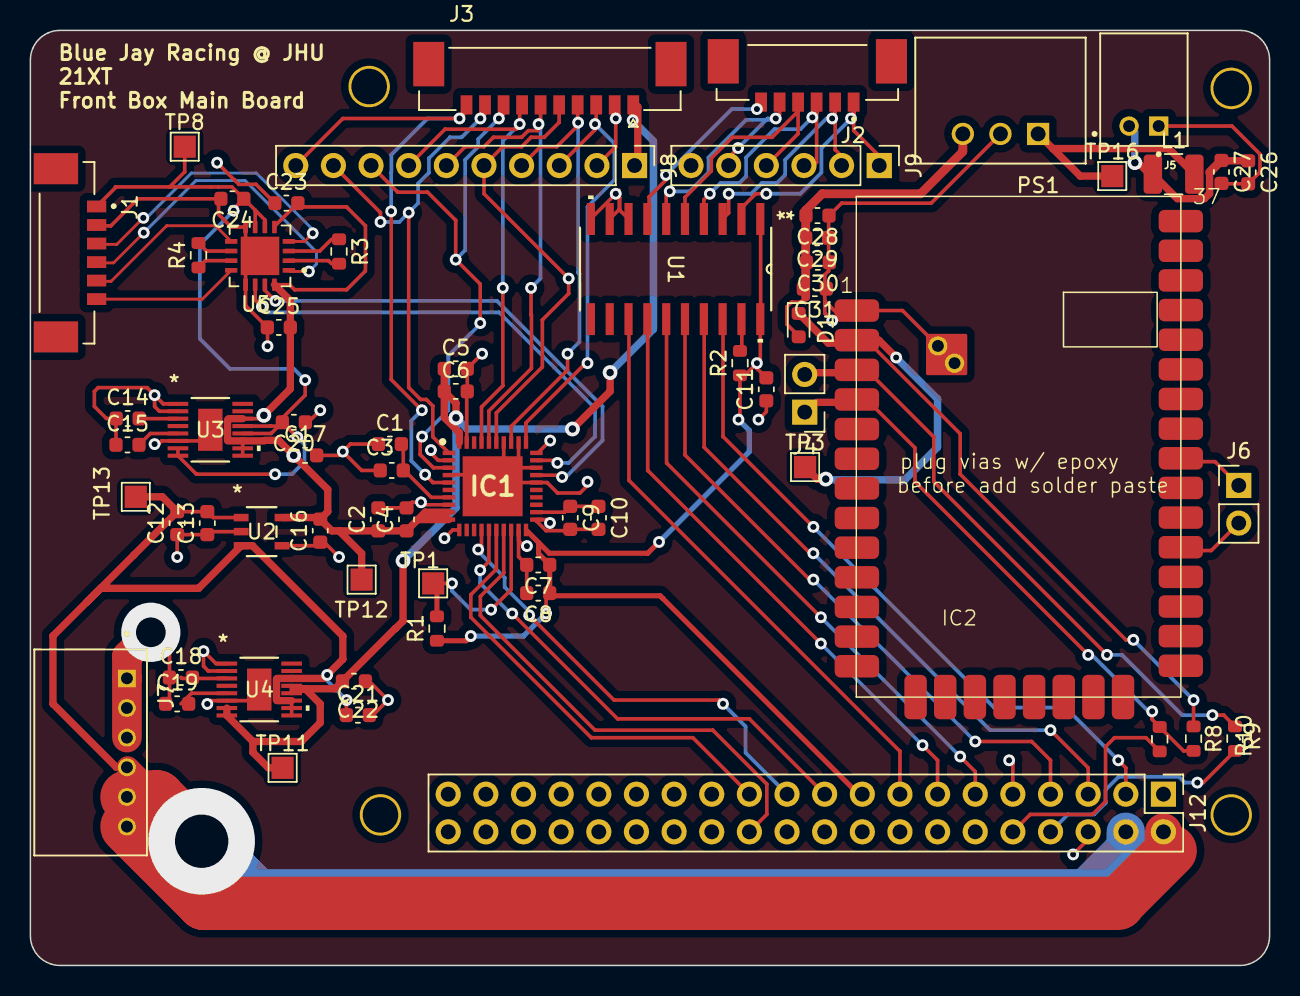
[picture p111: board mainbox1.0.kicad_pcb from above]

Board: 4 copper layers, 83.6 x 63.1 mm, 69 parts (0 on the bottom side), 58 nets.

Parts:
C1, C10, C12, C20, C22: 1uF; C_0603_1608Metric
C2, C5, C8, C26, C29: 10uF; C_0603_1608Metric
C3, C4, C6, C7, C9, C11, C13, C14, C15, C17, C18, C19, C21, C23, C24, C25: 0.1uF; C_0603_1608Metric
C16: 2.2uF; C_0603_1608Metric
C27: 4.7; C_0603_1608Metric
C28: 0.1; C_0603_1608Metric
C30: 47pF; C_0603_1608Metric
C31: 8.2pF; C_0603_1608Metric
D1: D_Schottky; D_0603_1608Metric
H1, H2, H3, H4: MountingHole; 2.35mm_mounting_hole
IC1: AD7175-8BCPZ-RL7; QFN50P600X600X80-41N-D
IC2: XBP9X-DMUS-011; xbee sx 900
J1, J2: Conn_01x06; MOLEX_0533980671 (1x6)
J3: Conn_01x10; MOLEX_533981071 (1x10)
J4, J6: Conn_01x02; PinHeader_1x02_P2.54mm_Vertical
J5: Conn_01x02; JST_S2B-PH-K-S_LF__SN_
J7: Conn_01x06; JST_S6B-PH-K-S_LF__SN_(1x6)
J8: Conn_01x10; PinHeader_1x10_P2.54mm_Vertical
J9: Conn_01x06; PinHeader_1x06_P2.54mm_Vertical
J12: Conn_02x20_Odd_Even; PinHeader_2x20_P2.54mm_Vertical
L1: 3.9uH; L_1210_3225Metric
PS1: R-78B3.3-1.5L; CONV_R-78B3.3-1.5
R1, R2: 10k; R_0603_1608Metric
R3, R4: 200; R_0603_1608Metric
R8, R9: 68; R_0603_1608Metric
R10: 100k; R_0603_1608Metric
TP1, TP3, TP8, TP11, TP12, TP13, TP16: TestPoint; TestPoint_Pad_1.5x1.5mm
U1: SN74LVC245AN
U2: TPS78326DDCT
U3: LT6658AHMSE-2.5-PBF
U4: LT6658AHMSE-5-PBF; LT6658AHMSE-2.5-PBF
U5: AD8222ACPZ-R7

Connections:
2.5V: C20.2, C24.1, J1.1, TP8.1, U3.7 (VOUT2_S), U3.8 (VOUT2_F), U3.12 (VOUT1_F), U3.13 (VOUT1_S), U5.6 (REF1), U5.7 (REF2)
3V3: C7.1, C8.1, C11.2, IC1.20 (IOVDD), J12.17, R1.1, R2.1, U1.1 (DIR), U1.20 (VCC)
5.2V: C12.2, C13.2, C21.1, J7.4, J7.5, J7.6, J12.2, J12.4, TP13.1, U2.1 (IN), U2.3 (EN), U4.9 (*OD), U4.10 (VIN2), U4.11 (VIN1), U4.14 (VIN)
5VADC: C2.1, C4.1, C16.2, C17.1, C23.2, C25.2, IC1.9 (AVDD1), IC1.10 (AVDD2), TP12.1, U2.5 (OUT), U3.9 (*OD), U3.10 (VIN2), U3.11 (VIN1), U3.14 (VIN), U5.5 (+VS), U5.16 (+VS__1)
5VASupply/Ref: C5.1, C6.1, C22.2, IC1.40 (REF+), J3.1, J8.1, TP11.1, U4.7 (VOUT2_S), U4.8 (VOUT2_F), U4.12 (VOUT1_F), U4.13 (VOUT1_S)
5VXbee: C26.1, C27.1, J5.2, L1.1
ANI1: IC1.3 (AIN1/REF2+), J3.8, J8.8
ANI3: IC1.5 (AIN3), J3.10, J8.10
ANI9: IC1.31 (AIN9), J3.3, J8.3
ANI11: IC1.33 (AIN11), J3.4, J8.4
ANI13: IC1.35 (AIN13), J3.5, J8.5
ANI14: IC1.36 (AIN14), J3.6, J8.6
ANI15: IC1.37 (AIN15), J3.7, J8.7
ANI16: IC1.1 (AIN16), J3.9, J8.9
CS: IC1.17 (~CS), J12.24
DIN: IC1.15 (DIN), J12.19
DINXBee: IC2.4 (DIN/DIO14/~CONFIG), J4.1, R9.1, R10.1
DO1: J12.3, U1.18 (B1)
DO2: J12.5, U1.17 (B2)
DO3: J12.7, U1.16 (B3)
DO4: J12.11, U1.15 (B4)
DO5: J12.13, U1.14 (B5)
DO6: J12.15, U1.13 (B6)
DOUT: IC1.14 (DOUT/~RDY), J12.21
DOUTXBee: IC2.3 (DIO13/DOUT), J4.2, R8.2
DS1: J2.1, J9.1, U1.2 (A1)
DS2: J2.2, J9.2, U1.3 (A2)
DS3: J2.3, J9.3, U1.4 (A3)
DS4: J2.4, J9.4, U1.5 (A4)
DS5: J2.5, J9.5, U1.6 (A5)
DS6: J2.6, J9.6, U1.7 (A6)
GND: C1.1, C2.2, C3.1, C4.2, C5.2, C6.2, C7.2, C8.2, C9.2, C10.2, C11.1, C12.1, C13.1, C14.1, C15.1, C16.1, C17.2, C18.1, C19.1, C20.1, C21.2, C22.1, C23.1, C24.2, C25.1, C26.2, C27.2, C28.1, C29.1, C30.1, C31.1, IC1.2 (AIN0/REF2-), IC1.4 (AIN2), IC1.8 (AVSS), IC1.11 (PDSW), IC1.19 (~SYNC), IC1.21 (DGND), IC1.26 (AIN4), IC1.28 (AIN6), IC1.30 (AIN8), IC1.32 (AIN10), IC1.34 (AIN12), IC1.39 (REF-), IC1.41 (EP), IC2.1 (GND_1), IC2.38 (GND_6), J1.2, J3.2, J5.1, J7.1, J7.2, J7.3, J8.2, J12.6, J12.9, PS1.2 (GND), U1.8 (A7), U1.9 (A8), U1.10 (GND), U2.2 (GND), U2.4 (GND), U3.1 (GND), U3.2 (GND), U3.6 (GND), U3.EPAD, U4.1 (GND), U4.2 (GND), U4.6 (GND), U4.EPAD, U5.8 (-VS__1), U5.13 (-VS), U5.17 (EP)
unnamed: C28.2, C29.2, C30.2, C31.2, D1.2 (A), PS1.3 (+VOUT)
unnamed: C1.2, C3.2, IC1.7 (REGCAPA)
unnamed: C9.1, C10.1, IC1.22 (REGCAPD)
unnamed: IC1.18 (~ERROR), R1.2, TP1.1
unnamed: IC2.29 (DIO6/~RTS), J6.1
unnamed: IC2.26 (DIO9/ON/~SLEEP), J6.2
unnamed: J12.8, R8.1
unnamed: J12.10, R9.2
unnamed: L1.2, PS1.1 (+VIN), TP16.1
unnamed: R2.2, U1.19 (*OE)
unnamed: C14.2, U3.3 (BYPASS)
unnamed: C15.2, U3.5 (NR)
unnamed: C18.2, U4.3 (BYPASS)
unnamed: C19.2, U4.5 (NR)
unnamed: R3.2, U5.2 (RG1)
unnamed: R3.1, U5.3 (RG1__1)
unnamed: R4.2, U5.10 (RG2)
unnamed: R4.1, U5.11 (RG2__1)
SCLK: IC1.16 (SCLK), J12.23
SG1: IC1.27 (AIN5), U5.15 (OUT1)
SG1+: J1.3, U5.4 (+IN1)
SG1-: J1.4, U5.1 (-IN1)
SG2: IC1.29 (AIN7), U5.14 (OUT2)
SG2+: J1.5, U5.9 (+IN2)
SG2-: J1.6, U5.12 (-IN2)
VOUT: D1.1 (K), IC2.2 (VCC), R10.2, TP3.1
