BlueJayRacing/bjr_kicad/(commit log)

2024-06-12 initial setup
    [accessoryidk.kicad_pcb, accessoryidk.kicad_sch, mainbox1.0.kicad_pcb, mainbox1.0.kicad_sch, wsg1.0.kicad_pcb, wsg1.0.kicad_sch]
2024-06-14 Ignore files in 20xt
    [5.2_5V.kicad_sch]
2024-06-30 teting testing
    [mainbox1.0.kicad_sch]
2024-06-30 work please
    [mainbox1.0.kicad_sch]
2024-07-06 gitignore fix
    [5.2_5V-B_Cu.gbr, 5.2_5V-B_Mask.gbr, 5.2_5V-B_Paste.gbr, 5.2_5V-B_Silkscreen.gbr, 5.2_5V-Edge_Cuts.gbr, 5.2_5V-F_Cu.gbr, 5.2_5V-F_Mask.gbr, 5.2_5V-F_Paste.gbr]
2024-07-06 gitignore stuff
    [5.2_5V.kicad_sch, adc1.kicad_sch, analogdcdin.kicad_sch, analogin.kicad_sch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]
2024-07-06 gitignore fix please
    [0532610471.step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]
2024-07-16 Created AD7175-8 file
    [AD7175-8.kicad_pcb, AD7175-8.kicad_sch, mainbox1.0.kicad_sch]
2024-07-16 Almost finished schematic
    [AD7175-8.kicad_sch, mainbox1.0.kicad_sch]
2024-07-16 With 16 single analog inputs
    [mainbox1.0.kicad_sch]
2024-07-17 4 diff signals and 9 single analog input + some other pin updates
2024-07-17 Just need reference
    [mainbox1.0.kicad_sch]
2024-07-17 Finished schematic
    [mainbox1.0.kicad_sch]
2024-07-18 Accessory board V1, schematic unfinished. Schematic: Wired connections between new components and connected in previously added high pass filters. Layout: Not started.
    [accessoryidk.kicad_sch]
2024-07-23 Finished power layout
    [accessoryidk.kicad_sch, teensy.kicad_sch, untitled.kicad_sch]
2024-07-23 Accessory V1 test
    [accessoryidk.kicad_sch, untitled.kicad_sch]
2024-07-23 added rp401 symbol, teensy symbol/footprint
2024-07-24 Accessory board V1, schematic unfinished, remaining teensy adc
    [accessoryidk.kicad_sch, untitled.kicad_sch]
2024-07-26 Unfinished V1 accessory schematic, remaining teensy connections
    [AD7175-8.kicad_sch, accessoryidk.kicad_sch, sensor_input.kicad_sch, teensy.kicad_sch]
2024-07-27 Unfinished V1 accessory schematic, adding teensy ADC connections part 1
    [AD7175-8.kicad_sch, sensor_input.kicad_sch, teensy.kicad_sch]
2024-07-30 Finished V1 schematic, adding footprints
    [AD7175-8.kicad_sch, accessoryidk.kicad_sch, sensor_input.kicad_sch, teensy.kicad_sch]
2024-07-30 Accessory V1 unfinished layout
    [AD7175-8.kicad_sch, accessoryidk.kicad_pcb, accessoryidk.kicad_sch, sensor_input.kicad_sch, teensy.kicad_sch]
2024-07-31 Finished Accessory V1 schematic, need DRC checks
    [AD7175-8.kicad_sch, accessoryidk.kicad_pcb, accessoryidk.kicad_sch, sensor_input.kicad_sch, teensy.kicad_sch]
2024-07-31 Revising accessory schematic
    [sensor_input.kicad_sch, teensy.kicad_sch]
2024-08-01 working on layout
    [AD7175-8.kicad_sch, ADC_sch.kicad_sch, Digital_sch.kicad_sch, Pi5.kicad_sch, Power.kicad_sch, StrainGauge_sch.kicad_sch, XBee.kicad_sch, mainbox1.0.kicad_sch]
2024-08-01 Editing V1 accessory layout
    [AD7175-8.kicad_sch, accessoryidk.kicad_pcb, accessoryidk.kicad_sch, sensor_input.kicad_sch, teensy.kicad_sch]
2024-08-01 FINISHED accessory edited v1 layout, need to check silkscreen
    [accessoryidk.kicad_pcb, sensor_input.kicad_sch, teensy.kicad_sch]
2024-08-01 finished layout
    [Pi5.kicad_sch, XBee.kicad_sch, mainbox1.0.kicad_pcb]
2024-08-02 Finished accessory v1 layout and silkscreen
    [accessoryidk.kicad_pcb]
2024-08-02 Edited accesory V1 ref names
    [AD7175-8.kicad_sch, accessoryidk.kicad_pcb, accessoryidk.kicad_sch, sensor_input.kicad_sch, teensy.kicad_sch]
2024-08-03 Everything done
    [ADC_sch.kicad_sch, Digital_sch.kicad_sch, Power.kicad_sch, StrainGauge_sch.kicad_sch, XBee.kicad_sch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]
2024-08-05 Re-oriented teensy and added bom
    [accessoryidk-B_Cu.gbl, accessoryidk-B_Mask.gbs, accessoryidk-B_Paste.gbp, accessoryidk-B_Silkscreen.gbo, accessoryidk-Edge_Cuts.gm1, accessoryidk-F_Cu.gtl, accessoryidk-F_Mask.gts, accessoryidk-F_Paste.gtp]
2024-08-13 Fixed issue
    [mainbox1.0.kicad_pcb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]
2024-08-15 Accessory V1 added drill files
    [accessoryidk-B_Cu.gbl, accessoryidk-B_Mask.gbs, accessoryidk-B_Paste.gbp, accessoryidk-B_Silkscreen.gbo, accessoryidk-Edge_Cuts.gm1, accessoryidk-F_Cu.gtl, accessoryidk-F_Mask.gts, accessoryidk-F_Paste.gtp]
2024-08-29 Summer/03 wireless strain gauge (#7)
    * testing
    * New schematic,footprints, now to organize lyout
    * First layout 'draft'
    * fixed some mistakes in previous layout
    * hi
    * hi
    * hi reid
    * oopsie
    * removed all generated files
    * accessory board backlog
    * final fixes
    * cleaning
    * one last zip
    ---------
    [AD5626_Breakout.kicad_pcb, AD5626_Breakout.kicad_sch, NewBOM.xlsx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]
2025-01-04 Accessory Fall Merge (#8)
    [2894.stp, 749013011.stp, 781-M44-113R141.STEP, 90816-0004.stp, AD5689RARUZ-RL7.stp, AD7175-8.kicad_sch, AD7175-8BCPZ-RL7.stp, DB37 Male Right Angle Connector.step]
2025-01-04 WSG Fall Merge (#9)
    [Memory.kicad_sch, NewBOM.xlsx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]
2025-01-04 Main Fall (#10)
    [AD5626_Breakout.kicad_pcb, AD5626_Breakout.kicad_sch, AD7175-8.kicad_pcb, AD7175-8.kicad_sch, ADC_sch.kicad_sch, Digital_sch.kicad_sch, Fake Bulk.kicad_pcb, Fake Bulk.kicad_sch]
2025-01-04 Winter Main ethernet +serial bulkhead (#11)
    [main_bulkhead.kicad_pcb, main_bulkhead.kicad_sch, main_bulkhead.sch, serial_bulkhead.kicad_pcb, serial_bulkhead.kicad_sch, serial_bulkhead.sch]
2025-01-07 partial library fixes
    [AD7175-8.kicad_sch, ADS1120IRVAR.stp, DTF13-4P-G003.stp, INA821IDRGR.stp, MCP1502T-50E_CHY.stp, MSOP8.STEP, R-78B3.3-1.5.stp, SJ-3541AS-SMT-TR-67.stp]
2025-01-08 Main ethernet bulkhead merge (#12)
    [main_bulkhead.kicad_pcb, serial_bulkhead.kicad_pcb]
2025-01-08 Aaren/hbridge (#13)
    [big_hbridge-B_Cu.gbl, big_hbridge-B_Mask.gbs, big_hbridge-B_Paste.gbp, big_hbridge-B_Silkscreen.gbo, big_hbridge-Edge_Cuts.gm1, big_hbridge-F_Cu.gtl, big_hbridge-F_Mask.gts, big_hbridge-F_Paste.gtp]
2025-01-14 strain gauge noise and ref iso prep
    [accessory_v2.kicad_pcb, wsg1.0.kicad_pcb, wsg1.0.kicad_sch]
2025-01-15 main board to v8, updating 3d models
    [90816-0010.stp, 90816-0012.stp, AD7175-2BRUZ.stp, AP3441LSHE-7B.stp, B2PS-VH.stp, MDT275M02001.stp, R2D-0509.stp, XB9X-DMUS-011.stp]
2025-01-15 fixed wsg library for 8.0
    [SOT23-3.stp, wsg1.0.kicad_pcb]
2025-01-16 wsg 3.0 pre
    [0906-0-15-20-76-14-11-0.step, AD8237ARMZ.stp, AP2120N-5.0TRG1.stp, Memory.kicad_sch, mainbox2.1.kicad_pcb, serial_bulkhead.kicad_pcb, sig_recep.kicad_sch, untitled.kicad_sch]
2025-01-16 fixed battery problems with wsg
    [wsg1.0.kicad_pcb, wsg1.0.kicad_sch]
2025-03-05 In-Shaft-WSG (#16)
    [2171800001.stp, AD5689RBCPZ-RL7.stp, Analog.kicad_sch, References.kicad_sch, in-shaft-wsg-daughter.kicad_pcb, in-shaft-wsg-daughter.kicad_sch, in-shaft-wsg-daughter.sch, in-shaft-wsg-mommy.kicad_pcb]
2025-03-05 minimal bulkhead - move mcu to serial bulkhead (#17)
    [2103M-003-CKN10790CT-ND_Push_Button.STEP, led_strip.STEP, m8 pp bulkhead 09_4912_081_04.stp, m8 pp wire 99-4909-00-04-001_01.stp, steering_wheel.kicad_pcb, steering_wheel.kicad_sch]
2025-03-05 Fall24/magnetometer (#18)
    [1KSMBSeries_LTF.step, BSS138.step, INA180A1IDBVR.stp, LIS3MDLTR.stp, LM3940IMPX-3.3_NOPB.step, LM74700QDBVRQ1.stp, LTC2959IDDB#TRMPBF.stp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]
2025-03-05 Spring/wsg3.0 (#19)
    [INA827AIDGK.stp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]
2025-03-24 10x wsg production run (#20)
    [jlc_cpl.csv, wsg3.0-B_Mask.gbr, wsg3.0-B_Paste.gbr, wsg3.0-B_Silkscreen.gbr, wsg3.0-Back.gbr, wsg3.0-Edge_Cuts.gbr, wsg3.0-F_Mask.gbr, wsg3.0-F_Paste.gbr]
