BlueJayRacing/bjr_kicad/(notices)

Notices in the files:
21xt/00-3dmodels/ZF5S-16-01-T-WT.step:
author */ ('License CC BY-ND 4.0'),
